wentingjie001-cmd/-/cad/README.md

# CAD：参数化模型与出图脚本

所有 3D 模型、工程图、专利附图都由 Python 脚本从同一个参数化模型生成。改参数后重新运行即可，各类图纸保持一致。

## 环境

```bash
pip install cadquery ezdxf matplotlib shapely scipy trimesh pillow
# 中文字体（Ubuntu）：sudo apt-get install fonts-noto-cjk
# 渲染图使用 VTK 离屏渲染（随 cadquery 安装），需要图形环境或 Xvfb
```

## 运行

```bash
cd cad
python3 build.py          # 3D 导出 + 渲染 + 外观视图 + 发明附图 + 工程图（约 2 分钟）
python3 build.py --fast   # 低分辨率渲染
python3 schematics.py     # 原理示意图（对标原理图、附图 6、附图 7）
python3 build_benchmark.py --photos <官网照片目录>  # 对标款 Aarn PM40 逆向近似模型（不带 --photos 则跳过照片对比图）
python3 build_aarn_detail.py                      # 对标款细节模型（含内部结构、五金件、剖切、爆炸图、BOM）
python3 build_patterns.py                         # A1 生产用裁片：DXF、1:1 PDF、排料图、清单（约 10 秒；校验不过会报错退出）
python3 preview_a1.py                             # A1 3D 预览：按裁片装配的渲染图、标注图、转台动画、GLB（约 40 秒）
python3 build_viewer.py                           # 交互网页的模型数据，写出 ../viewer/model.js（约 6 秒）
cd ../viewer-src && npm install && npm run build  # 打包 three.js，写出 ../viewer/app.js
```

## 文件

| 文件 | 内容 |
|---|---|
| `backpack_model.py` | 参数化几何模型。`Params` 中是主要尺寸：包体、背架、联动座、滚轮、织带、肩带、腰带 |
| `drawing.py` | 消隐线投影（OpenCascade HLR）、专利线条图、局部外观实线/虚线、VTK 渲染、尺寸标注工具 |
| `build.py` | 生成全部输出 |
| `schematics.py` | 2D 原理示意图 |
| `benchmark_aarn_pm40.py` | 对标款 Aarn PM40 的逆向近似模型（照片逐行测量，剪影 IoU 侧面 0.82 / 背面 0.92），仅供对标，见 docs/05 |
| `build_benchmark.py` | 生成对标模型的 STEP/STL、渲染、视图、照片对比图，输出到 `out/benchmark_aarn_pm40/` |
| `aarn_hardware.py` | 五金件库：插扣、梯扣、三档扣、胸带滑钩、弹簧绳扣、拉链、Lasso Loc、织带环、打枣 |
| `aarn_pm40_detail.py` | 对标款细节模型：63 种零件，空壳布料件、分层肩带腰带、内部件，每件标注"实测 / 照片可见 / 推断" |
| `build_aarn_detail.py` | 生成细节模型的总装 STEP、渲染、剖切图、爆炸图、五金图集和 BOM，输出到 `out/benchmark_aarn_pm40/detail/`（约 8 分钟） |
| `patterns.py` | A1 生产用裁片定义：装满后的截面、32 种裁片（净线、每条边的缝份和做法、刀口、纱向、定位点）、织带和五金清单、缝边对位校验。与 3D 模型相互独立，见 docs/08 |
| `build_patterns.py` | 生成裁片 DXF、1:1 PDF、排料图、裁片清单、缝边校验表、尺寸表、用料和重量估算，输出到 `out/production/` |
| `preview_a1.py` | A1 3D 预览：读 `patterns.py` 的截面、口袋位置、肩带和腰带外形、锚点，装配成网格模型并渲染；同时输出 3D 路径长度与裁片、织带下料长度的对照表。`build(sway, torso)` 可以按带长不变摆出联动和背长的姿态 |
| `build_viewer.py` | 把预览模型按静止、左右走带极限、背长最高和最低五种姿态导出成 `../viewer/model.js`，供交互网页使用 |

## 输出（`cad/out/`）

| 目录 | 内容 | 用途 |
|---|---|---|
| `step/` | 总装 STEP（带颜色）、联动座总成 STEP、各硬件 STEP | 给结构工程师在 SolidWorks / Creo / Fusion 360 中继续设计、开模 |
| `stl/` | 联动座前壳/后壳、滚轮、扳手、枢转板、背架 1:1；整包 1:4 缩比模型 | 3D 打印功能样件与展示模型（手办）。部分 STL 非严格封闭，切片软件可自动修复 |
| `render/` | 着色渲染图 | 内部评审、方案说明 |
| `design/01_backpack_whole/` | 整包六视图 + 立体图（PNG 300 dpi / PDF / SVG） | 外观设计专利 C |
| `design/02_backpack_partial_back_system/` | 局部外观：背负系统实线，其余虚线 | 外观设计专利 D |
| `design/03_linkage_hub/` | 联动座六视图 + 立体图 | 外观设计专利 E |
| `invention/fig1–fig5` | 带附图标记的说明书附图 | 发明 / 实用新型 A、B |
| `schematics/fig6, fig7` | 联动原理、锁止状态示意 | 发明 / 实用新型 A、B |
| `schematics/benchmark_*` | 对标款背部原理示意 | 调研报告 |
| `benchmark_aarn_pm40/` | 对标款近似模型：STEP、1:4 STL、渲染、七视图、照片与模型对比、与我们改版的对比 | 对标分析，不用于生产和专利申请 |
| `drawings/` | BP40-HUB-001 联动座 A3 工程图（PDF/PNG/SVG/DXF）、BP40-FRM-001 Y 型背架 A3 工程图 | 打样、开模询价 |
| `production/` | A1 裁片：`dxf/pieces/` 每片一个 DXF，`dxf/BP40-A1_marker_*.dxf` 排料图，`pdf/` 1:1 纸格，另有裁片清单、缝边校验、织带和五金清单、尺寸表、用料和重量估算 | 交给版师打首版样包。还没有经过打样验证 |
| `preview_a1/` | A1 预览：`a1_iso_front/rear.png`、`a1_three_views.png`、带标注的 `a1_callouts_*.png`、`a1_turntable.gif`、`BP40-A1_preview.glb`、`consistency.md` | 看整包的样子，检查裁片装配关系。不是布料仿真，也不是生产模型 |
| `../viewer/` | 交互网页：`index.html`、`app.js`、`model.js`。可旋转、点选、开关图层、拆解，并演示联动带走带、背长 5 档和锁止 | 手机或电脑上操作 3D 预览。不依赖网络；源码在 `viewer-src/`，用 esbuild 打包 |

## 建模假设

- 3D 模型里的软质部件（包体、肩带、腰带、网面）是简化曲面，只用于外观表达和缩比模型，不是裁片。裁片在 `patterns.py` 里单独定义。
- 3D 模型是 A0 尺寸（包体 280 × 200 × 640，主仓约 31 L）；裁片是 A1 尺寸（300 × 220 × 640，主仓 36.6 L，新增背板、肩轭和背长调节）。A1 的 3D 预览（`preview_a1.py`）按裁片装配；专利附图、外观视图和背架图纸仍由 A0 模型生成，还没有同步。生产以裁片和 docs/08 为准。
- 硬质部件（联动座、滚轮、凸轮扳手、枢转板、背架）按制造意图建模，尺寸为 A0 概念值，需打样验证后修正。
