wentingjie001-cmd/-/patent/E_design_linkage_hub/brief_description.md

# 外观设计简要说明（初稿）

1. **本外观设计产品的名称：** 背包用联动座。
2. **本外观设计产品的用途：** 安装于背包底部背侧，用于连接背包肩带下端的联动带、背架和腰带。
3. **本外观设计产品的设计要点：** 在于产品的形状，包括主视呈中部低、两端上翘的"微笑"弧形壳体，两端的滚轮槽与斜向出带口，顶部圆柱形插座，后侧窗口、锚柱与扳手，以及贴身侧带圆角的矩形背板与圆形枢转盘。
4. **最能表明设计要点的图片或照片：** 立体图。

视图文件（`cad/out/design/03_linkage_hub/`）：主视图 `front`、后视图 `rear`、左视图 `left`、右视图 `right`、俯视图 `top`、仰视图 `bottom`、立体图 `iso_front`。

> 此件为硬质注塑件，CAD 线条图可以直接作为申请视图。可以先用 P1 打印件拍照核对，再提交。
