wentingjie001-cmd/-/cad/out/production/hardware_list.md

| 编号 | 名称 | 规格 / 参考型号 | 数量 | 位置 |
|---|---|---|---|---|
| H01 | 卷口插扣 20 mm | 侧开插扣，YKK LB20R 或同级（Duraflex、Woojin） | 2 | 卷口两端 |
| H02 | 腰带中扣 25 mm 双调 | 双调侧开插扣，YKK LB25RD 或同级 | 1 | 腰带，前拉式 |
| H03 | 梯扣 20 mm | YKK LK20GV 或同级 | 4 | 肩带下调节 ×2、下区张紧 ×2 |
| H04 | 梯扣 15 mm | 同系列 15 mm | 6 | 上拉带 ×2、侧压缩 ×4 |
| H05 | 凸轮扣 20 mm | YKK LA20CB 或同级 | 2 | 上区张紧带，缝在后幅 z = 255 的锚点上 |
| H06 | 胸带滑轨扣 15 mm（带哨） | 滑轨式胸带扣一套 | 1 | 肩带滑轨 |
| H07 | G 钩 25 mm | 铝或不锈钢 G 钩 | 1 | 背长调节，挂入梯带 |
| H08 | 日字扣 25 mm | YKK LA25S 或同级 | 2 | 腰带收紧带回折 |
| H09 | 5 号尼龙拉链 + 拉头 | YKK 5CN 或同级，净长 150 mm | 2 | 腰带袋 |
| H10 | 绳扣 | 单孔弹簧绳扣 | 1 | V 形压缩绳 |
| H11 | 魔术贴 25 mm | 勾面 + 毛面各 200 mm | 1 | 背板套上口 |
| H12 | 杆端胶帽 | Ø6 硅胶或 TPU 帽 | 2 | Y 型背架上横梁两端，防异响 |
| H13 | 联动座总成 | 见 BP40-HUB-001（前/后壳、滚轮 ×2、凸轮扳手、枢转盘） | 1 | 后幅下部 |
| H14 | Y 型背架 | 见 BP40-FRM-001（7075-T6 Ø6，下立杆 Ø7） | 1 | 背负系统 |
| H15 | 联动座安装螺钉 | M4×12 不锈钢盘头 + 防松螺母 | 4 | 穿过 E01、后幅和 E04 内衬板 |
| H16 | 防雨罩（选配） | 40–50 L 通用防雨罩，外购 | 1 | 放前弹力袋 |
