wentingjie001-cmd/-/docs/06_brand_suspension_survey.md

# 06 主流户外背包品牌背负系统调研

> 这份调研回答两个问题：成熟品牌的 40 L 级徒步背包背负系统是怎么做的；哪些做法我们可以直接采用，哪些受专利或品牌识别保护要避开。
> 结论落实到设计上的部分见 [08 A1 量产资料包](08_production_package_A1.md) 第 2 节。专利方面的新发现已并入 [02 专利检索与规避](02_patent_landscape.md) 第 4 节。

- 调研日期：2026-11-12（桌面调研，资料来自厂商页面、说明书、Google Patents、评测/拆解站点）
- 目的：梳理成熟品牌的背负（suspension / carry）系统做法，判断哪些通用做法可直接采用，哪些可能受专利或品牌识别保护。

## 0. 阅读须知（重要）

1. **"未核实"（not verified）** 表示本次调研没有找到可靠来源或未能打开原始页面，没有用猜测补齐。凡未标注来源链接的数字均不应作为设计输入。
2. **专利状态** 全部取自 Google Patents 页面在 2026-11-12 显示的状态与法律事件（Active / Expired / Lapsed / 年费缴纳记录）。Google 自己声明这不是法律结论；正式结论须由专利代理人/律师在 CNIPA、USPTO、EPO Register 上复核。
3. **本报告不是 FTO（自由实施）检索**。针对我方概念（"左右肩带下端由一根织带经底部刚性枢纽内的滚轮相连 + 可切换锁止 + 腰带绕同一枢纽转动"）只做了有限的关键词/引证链检索；Google Patents 检索接口在调研中多次被限流，中文关键词全文检索不完整。
4. 厂商不同年份/不同地区页面的数据经常不一致（例如面料丹尼数、重量），文中已尽量标明代际。
5. 品牌名、技术名、专利号保留英文。

---

## 1. Mystery Ranch

**代表型号：Coulee 40**（另参考 Bridger 45、Scree 32）

| 项目 | 内容 | 来源 |
|---|---|---|
| 框架 | Coulee 40：两根竖向复合材料（评测称玻纤 fiberglass）支杆 + 上部一根横向复合材料杆，配 HDPE framesheet（上 2 片 + 下 1 片）。支杆不可拆、有弹性，下端插入缝在包体上的腰垫（lumbar pad）。Bridger 45:spring-steel 钢丝框。Scree 32：半长 HDPE framesheet，无支杆。支杆/钢丝的直径、截面尺寸：未核实 | [suburban.com.hk](https://suburban.com.hk/products/mystery-ranch-coulee-40)、[adventuregear.ca](https://www.adventuregear.ca/ProductTab/ProductFullDescriptionTab/6125)、[SectionHiker Coulee 40](https://sectionhiker.com/mystery-ranch-coulee-40-backpack-review/)、[Trailspace](https://www.trailspace.com/gear/mystery-ranch/coulee-40/)、[enwild Bridger 45](https://www.enwild.com/mystery-ranch-mens-bridger-45.html)、[North of Known Scree](https://www.northofknown.com/mystery-ranch-scree-review/) |
| 背板 | 贴背式：泡棉 + spacer mesh，无悬空网；Scree 为薄闭孔泡棉 | [SectionHiker Coulee 40](https://sectionhiker.com/mystery-ranch-coulee-40-backpack-review/)、[North of Known](https://www.northofknown.com/mystery-ranch-scree-review/) |
| 背长调节 | Futura Yoke：肩带轭（yoke）整体用魔术贴（hook-and-loop）贴在背板后方，可上下"伸缩"连续调节，轭内有一块弧形硬塑料片保持形状。Coulee 40（2023）背长：S/M 38–51 cm，L/XL 43–61 cm。Bridger 45:S/M 15–20 in（约 38–51 cm），L/XL 17–24 in（约 43–61 cm） | [MR load carriage 说明](https://www.mysteryranch.com/load-carriage-architecture-of-a-mystery-ranch-pack)、[wildholics（2023 款）](https://wildholics.com/products/mystery-ranch-coulee-40-backpack-2023-new-version)、[SectionHiker Scree 32](https://sectionhiker.com/mystery-ranch-scree-32-backpack-review/)、[enwild](https://www.enwild.com/mystery-ranch-mens-bridger-45.html) |
| 肩带 | S 形肩带，带 daisy chain；load lifter 锚点在支杆顶端以上（2023 款把下锚点降低约 10 cm）。Bridger 用 Endurance Yoke（跑步背心式，双胸带） | [SectionHiker](https://sectionhiker.com/mystery-ranch-coulee-40-backpack-review/)、[Lupo（繁中评测）](https://lupowanderwild.com/portfolio/mystery-ranch-coulee-40-2023/)、[MR Bridger 博文](https://www.mysteryranch.com/blog/post/9-reasons-why-the-bridger-series-should-be-your-next-backpacking-pack) |
| 腰带与传力 | "lumbar wrap" 腰垫缝在包体上，支杆直接落在腰垫里；腰带两翼不缝死在腰垫上、可拆，向前拉收紧（pull-forward）。2023 款腰带分 S/M/L/XL 四码。腰带袋：未核实 | [SectionHiker](https://sectionhiker.com/mystery-ranch-coulee-40-backpack-review/)、[Lupo](https://lupowanderwild.com/portfolio/mystery-ranch-coulee-40-2023/) |
| 面料/辅料 | 旧款 330D Robic；2023 款 100% 再生 210D Robic dobby，底部双层；YKK 拉链（带 DWR）。Bridger:100D Robic 再生 ripstop + 330D Robic，YKK 拉链 + Duraflex 扣具。Scree:YKK、Duraflex、Woojin 五金，越南制造，外 DWR 内 PU | [suburban.com.hk](https://suburban.com.hk/products/mystery-ranch-coulee-40)、[wildholics](https://wildholics.com/products/mystery-ranch-coulee-40-backpack-2023-new-version)、[Outdoor Gear Zine](https://outdoorgearzine.com/review-mystery-ranch-bridger-45-backpack)、[North of Known](https://www.northofknown.com/mystery-ranch-scree-review/) |
| 重量/容积/载重 | Coulee 40:40 L，约 1.7 kg（3.8 lb；评测实测 1628–1764 g）。官方推荐最大载重：未核实；评测意见"不适合 20 kg 以上" | [SectionHiker](https://sectionhiker.com/mystery-ranch-coulee-40-backpack-review/)、[Lupo](https://lupowanderwild.com/portfolio/mystery-ranch-coulee-40-2023/) |

**评测优缺点**

- 优点：背长无级可调且调节范围大；支杆直接落到腰垫，传力路径短（以上见 SectionHiker 评测）；3-ZIP 开口与用料耐用属于该品牌的普遍口碑，本次未逐条摘录出处。
- 缺点：同容积里偏重；拉链不防水；碳/玻纤杆与套管、轭硬片摩擦会吱吱响（[reddit](https://www.reddit.com/r/MysteryRanch/comments/1f1gb0z/fix_squeaky_pack/)）；魔术贴轭有轻微位移的用户反馈（[reddit](https://www.reddit.com/r/MysteryRanch/comments/ct7djg/)）。

**专利**

- 官方专利页列出：US 7,673,777 B2；8,381,956；8,561,866；8,950,644 B2（覆盖 Coulee 25/40、Scree 等）；US 6,626,342 B1；US 8,348,114 B2、8,579,171（Guide Light Frame / Overload）；9,173,473；9,271,559；10,952,523。[mysteryranch.com/patents](https://www.mysteryranch.com/patents)
- [US7673777B2](https://patents.google.com/patent/US7673777B2/en) "Backpack frame system"（优先权 2005-03-18）：Active，调整后到期日 2028-09-11；同族 US/CA/WO，**无 CN**。
- [US8950644B2](https://patents.google.com/patent/US8950644B2/en)（优先权 2005-03-18）：已到期（2025-05-08）。
- [US8579171B2](https://patents.google.com/patent/US8579171B2/en) "Backpack frame and bag system"（Overload 相关，优先权 2005-03-18）：Expired（未缴年费，2025-11-12 生效）；同族无 CN。
- 其余列出的专利号状态、3-ZIP 是否有专利：未核实。

---

## 2. Osprey

**代表型号：Exos 48（轻量）/ Talon 44（贴背）**；另参考 Atmos AG 50、Stratos 36、Kestrel 38

| 项目 | 内容 | 来源 |
|---|---|---|
| 框架 | Exos 48（S22）：4 mm 粉末涂层 LightWire 周边框（perimeter frame）；旧款说明书写 6065 铝合金周边框 + 内部悬空横撑。Atmos AG 50:4 mm 粉末涂层全周边框。Kestrel 38:3.5 mm LightWire 周边框 + Atilon framesheet。Talon 44（现款）：注塑再生 PP framesheet（S17 款为玻纤周边框 + Atilon framesheet）。Manta AG（2016）：3 mm LightWire | [Exos 48](https://www.osprey.com/exos-48-exos48s22-418)、[Exos 旧说明书](https://m.media-amazon.com/images/I/A1b2NFEoOcL.pdf)、[Atmos AG 50](https://www.osprey.com/atmos-ag-50-atmos50s22-369)、[Kestrel 38](https://www.osprey.com/kestrel-38-kestrel38s23-702)、[Talon](https://www.osprey.com/talontm-8)、[Talon S17 说明书](https://www.osprey.com/gb/media/user_manuals/OM_TalonTempest_S17_ENG.pdf)、[SNEWS](https://www.snewsnet.com/press-release/osprey-packs-introduces-award-winning-anti-gravity-technology-into-hydration-and-kids-carriers-for-spring-2016) |
| 背板 | AirSpeed（Exos、Stratos）：周边框张紧的悬空网（trampoline），网后有窄气隙。Anti-Gravity/AG（Atmos）：从背板到腰带连续的无缝悬空网。AirScape（Talon、Kestrel）：带沟槽的模切 EVA 泡棉贴背 + 网布，重心更贴身 | [Osprey suspension 技术页](https://www.osprey.com/pack-design-technology/suspension)、[Outdoorsmagic Exos 48](https://outdoorsmagic.com/article/osprey-exos-48/)、[Stratos](https://www.osprey.com/stratos-3) |
| 背长调节 | Exos 48（S22）：注塑"梯格"（ladder）+ 卡扣式调节，行程 4 in（约 10 cm）；背长 S/M 43–52 cm，L/XL 49–58.9 cm。Atmos AG 50:cam-lock 凸轮锁背长调节 + Fit-on-the-Fly（肩带、腰带长度可调） | [Exos 48](https://www.osprey.com/exos-48-exos48s22-418)、[Exos S22 说明书](https://www.osprey.com/gb/media/user_manuals/OM_Exos_Eja_S22_ENG.pdf)、[Atmos S22 说明书](https://www.osprey.com/gb/media/user_manuals/OM_Atmos_Aura_S22_ENG.pdf) |
| 肩带 | ExoForm：无缝叠层网 + EVA + spacer mesh；15 mm 滑轨式胸带。Talon:BioStretch 肩带 | [Exos 48](https://www.osprey.com/exos-48-exos48s22-418)、[Talon](https://www.osprey.com/talontm-8) |
| 腰带与传力 | Atmos AG：腰带骨架并入周边框，ErgoPull 交叉前拉收紧，Fit-on-the-Fly 用魔术贴延长腰垫。Talon：腰垫到腰带无缝包裹（seamless lumbar-to-hipbelt wrap）。腰带袋：各型号细节本次未逐项核实 | [Atmos AG 50](https://www.osprey.com/atmos-ag-50-atmos50s22-369)、[Talon](https://www.osprey.com/talontm-8) |
| 面料/辅料 | Exos 48：主料与底料为再生 100D 高强尼龙 ripstop，400D 辅料，PFAS-free DWR。Atmos AG 50:210D honeycomb 尼龙主料 + 500D 高强尼龙底。Talon 44:100D 高强尼龙 dobby ripstop + 420D 底。Stratos 36:100D×210D honeycomb ripstop + 420D 底。Kestrel 38:420D 尼龙 + 500D 底。拉链/扣具供应商：未核实 | 同上各产品页 |
| 重量/容积/载重 | Exos 48（S/M）：48 L，1.255 kg（官网）/1.29 kg（说明书），载重 25–30 lb / 11–14 kg。Talon 44（S/M）：1.57 kg，15–35 lb / 6.8–15.9 kg。Stratos 36:1.55 kg，10–30 lb / 4.5–13.6 kg。Atmos AG 50（S/M）：1.959 kg，25–35 lb / 11–16 kg（说明书 kg 换算有笔误，以官网为准）。Kestrel 38:S/M（36 L）4.07 lb（约 1.85 kg），20–35 lb | 同上各产品页 |

**评测优缺点**

- 优点：Exos 48 以约 1.26 kg 做到 11–14 kg 载重区间且背长可调 10 cm（官网数据）；AG/AirSpeed 的通风与包裹感属于普遍口碑，本次未逐条摘录出处。
- 缺点：AG 框架与包体摩擦吱吱响（Osprey 给框架喷涂层处理，[reddit](https://www.reddit.com/r/WildernessBackpacking/comments/60wy6b/)）；Fit-on-the-Fly 魔术贴腰带打滑/失效的用户报告（[Trailspace](https://trailspace.com/gear/osprey/atmos-ag-65/)）；悬空网约 500 km 后撕裂的个案（[Let's Go Play Outside](https://letsgoplayoutside.com/en/blog/equipement/tests/complete-osprey-atmos-ag-65-review)）；旧代腰带内卷产生压点（[Switchback Travel](https://www.switchbacktravel.com/backpacking/osprey-atmos-review)）。另见 [CleverHiker 的 Atmos AG 65 评测](https://www.cleverhiker.com/backpacking/osprey-atmos-ag-65-backpack-review/)（具体条目本次未摘录）。

**专利**

- [US12336619B2](https://patents.google.com/patent/US12336619B2/en)（3D 打印点阵腰垫，优先权 2020-01-31）：Active；**有 CN 同族 CN114980777B**。
- [US11751670B2](https://patents.google.com/patent/US11751670B2/en)（儿童背架/可变框架，优先权 2020-06-19）：Google Patents 显示 CN 同族为 active。
- AG / AirSpeed / LightWire 是否有专门专利及其号码：未核实。

---

## 3. Deuter

**代表型号：Futura Pro 40（悬空网）/ Aircontact Ultra 40+5（贴背轻量）**；另参考 Aircontact Lite 40+10、Trail Pro 36

| 项目 | 内容 | 来源 |
|---|---|---|
| 框架 | Futura Pro 40:Flexi 弹簧钢（spring steel）圆截面框，肩带锚在框上。Aircontact Ultra 40+5:"永久弹性"弹簧钢圆截面框（媒体称锯齿形钢丝）。Aircontact Lite:X 形铝支杆 + 顶部横杆（挂 load lifter）。Aircontact X:Y-frame。Alpine 背负（Guide）：PE 背板内缝弹簧钢框。Trail Pro 36：张紧的 Delrin U 形框（部分零售页写"弹簧钢圆截面框"，两种说法并存，未能定论）。钢丝直径：未核实 | [Futura Pro 40](https://www.deuter.com/int-en/futura-pro-40/4046051185484)、[Aircontact Ultra 40+5](https://www.deuter.com/int-en/aircontact-ultra-40-5/4046051172033)、[Outside first look](https://www.outsideonline.com/outdoor-gear/hiking-gear/first-look-deuter-aircontact-ultra-405-355-sl/)、[SectionHiker Aircontact Lite](https://sectionhiker.com/deuter-aircontact-lite-65-10-backpack-review/)、[Deuter alpine 页面](https://www.deuter.com/int-en/backpacks/alpine-backpacks/)、[shoreshots Trail Pro 36](https://shoreshots.ie/p/deuter-trail-pro-36-paprika-marine/)、[Globetrotter](https://www.globetrotter.de/deuter-tourenrucksack-trail-pro-36-black-shale-1280680/) |
| 背板 | Aircomfort（Futura）：弹簧钢框张紧的悬空网，二手资料称该系统始于 1984 年。Aircontact：开孔泡棉贴背垫 + 中央通风槽 / Air Spacer Mesh，重心贴身 | [Deuter back systems](https://www.deuter.com/us-en/advice/back-systems/)、[1xmatch](https://en.1xmatch.com/ryukzaki-deuter-obzor-modeley-blog-skalnik-blog-skal-nik/)、[packranker](https://packranker.com/backpacks/deuter-aircontact-lite-40-10) |
| 背长调节 | VariQuick：魔术贴穿过梯形织带环；VariSlide：织带 + 扣具无级滑动；VariClick（现款 Futura Pro）：5 档；Clip & Loop（Aircontact Ultra）。范围：Futura Pro 40 与 Aircontact Ultra 40+5 均为 42–62 cm；Aircontact Lite 40+10 为 42–62 cm；上一代 Futura Pro 40 与 Trail Pro 36 为固定背长 44–54 cm | [Deuter trekking advice](https://pimcore.deuter.com/deuter-master/en/advice/trekking-backpack-advice)、[Futura Pro 40](https://www.deuter.com/int-en/futura-pro-40/4046051185484)、[上一代 Futura Pro 40](https://www.deuter.com/ca-en/futura-pro-40/4046051112367) |
| 肩带 | ActiveFit：肩带上端可自由转动以适应肩宽/肩斜；Aircontact X 为 pivoting 肩带 | [Futura Pro 40](https://www.deuter.com/int-en/futura-pro-40/4046051185484)、[Deuter backpacking packs](https://www.deuter.com/us-en/backpacks/backpacking-packs/) |
| 腰带与传力 | VariFlex / VariFlex ECL：腰翼（hip fins）可随骨盆活动；pull-forward 前拉收紧；Aircontact Lite 腰翼为双密度泡棉。腰带袋：未逐项核实 | [上一代 Futura Pro 40](https://www.deuter.com/ca-en/futura-pro-40/4046051112367)、[SectionHiker](https://sectionhiker.com/deuter-aircontact-lite-65-10-backpack-review/) |
| 面料/辅料 | Futura Pro 40（现款）：210D 再生 PA X-Grid，附防雨罩，越南制造（零售商信息）；上一代：210D 再生 PA + 600D PES（厚 PU 涂层）。Aircontact Ultra:175D PA Ripstop Ultra HD（国际站）/ 235D 再生 PA + 500D PA（美国零售商）——两处说法不一致。Aircontact Lite:140D PA ripstop + 600D 再生 PES。Trail Pro:210D PA（双 PU 涂层，1500 mm 水柱）+ 600D PES。拉链/扣具供应商：未核实 | 同上；[eikenshop](https://eikenshop.com/products/deuter-futura-pro-40)、[sportsbasement](https://shop.sportsbasement.com/products/aircontact-ultra-40-5) |
| 重量/容积/载重 | Futura Pro 40:40 L，1620 g，70×32×24 cm，推荐载重 6–10 kg。Aircontact Ultra 40+5:1210 g，71×26×23 cm，推荐 6–10 kg（13–22 lb，美国零售商）；媒体称可到 35 lb（约 16 kg）。Aircontact Lite 40+10:1590 g，12–15 kg | [Futura Pro 40](https://www.deuter.com/int-en/futura-pro-40/4046051185484)、[sportsbasement](https://shop.sportsbasement.com/products/aircontact-ultra-40-5)、[packranker](https://packranker.com/backpacks/deuter-aircontact-lite-40-10) |

**评测优缺点**

- 优点：背长调节范围大（42–62 cm，共 20 cm）；Aircontact X 标称可到 30 kg（[Deuter](https://www.deuter.com/us-en/backpacks/backpacking-packs/)）。Aircomfort 通风好、Aircontact 贴背稳定属于普遍口碑，本次未逐条摘录出处。
- 缺点：同级偏重；VariQuick 没有刻度标记、背垫两侧有压感（[mountainsforeverybody](https://mountainsforeverybody.com/deuter-aircontact-lite-35-10-sl-pack-for-women/)）；Aircontact Lite 软泡棉在约 45 lb（20 kg）以上被压实（[OutdoorGearLab](https://www.outdoorgearlab.com/reviews/camping-and-hiking/backpacks-backpacking/deuter-aircontact-lite-65-plus10)）。

**专利**：Deuter 背负系统（Aircomfort、VariQuick、VariFlex、ActiveFit 等）的专利号与状态——未核实（按申请人检索时被 Google Patents 限流，未取得结果）。

---

## 4. Gregory

**代表型号：Zulu 40**（另参考 Paragon 48、Focal 48、Baltoro 65）

| 项目 | 内容 | 来源 |
|---|---|---|
| 框架 | Zulu 40：周边框，官网材质写 "alloy steel"；2019 代为周边弹簧钢框 + 防鼓包（anti-barreling）横撑。Paragon 48:wishbone 合金框 + 玻纤防鼓包横撑 + HDPE/闭孔泡棉 framesheet。Focal 48：周边铝框 + 玻纤横撑 + HDPE。Baltoro 65：周边合金（钢管）框 + 玻纤横撑。管/丝直径：未核实 | [Zulu 40（EU 官网）](https://eu.gregorypacks.com/uk-en/zulu-40-s-m--halo-blue/145668-0527.html)、[gaynors（2019 代）](https://www.gaynors.co.uk/equipment-c153/rucksacks-c155/mens-rucksacks-c235/gregory-zulu-40-p21654)、[hardloop Paragon 48](https://www.hardloop.co.uk/product/23800-gregory-paragon-48-hiking-backpack-mens)、[mountainsforeverybody Focal 48](https://mountainsforeverybody.com/gregory-focal-48-pack-for-men)、[Baltoro 65](https://eu.gregorypacks.com/uk-en/-baltoro-65-rc-m--terrain-green/157940-9304.html)、[LFTO](https://www.livefortheoutdoors.com/hiking/rucksacks/gregory-baltoro-65-review/) |
| 背板 | Zulu / Focal:FreeFloat 全长张紧悬空网。Paragon:FreeFloat hybrid，3D 打孔泡棉贴背。Baltoro:AirCushion 网 + ComfortGrip 腰垫 | 同上 |
| 背长调节 | Zulu 40：可调 3.5 in（约 8.9 cm）。Baltoro 65：背长可调 >7.6 cm，腰带每侧可调 8.8 cm。Focal 48：固定背长，分 S/M/L（16–18 / 18–20 / 20–22 in） | 同上 |
| 肩带 | Lifespan EVA 打孔肩带；Baltoro 的 FreeFloat A3 为 auto-rotating 自动转角肩带 | [Zulu 40](https://eu.gregorypacks.com/uk-en/zulu-40-s-m--halo-blue/145668-0527.html)、[Gregory JP FreeFloat A3](https://www.gregory.jp/tech/free-float-a3.html) |
| 腰带与传力 | FreeFloat：腰带通过一块可弯曲/位移的柔性面板（dynamic flex panel）连到框架，腰带可随骨盆 pivot 与 flex；3D 预成型腰带。腰带袋：未逐项核实 | [FreeFloat 技术页](https://eu.gregorypacks.com/uk-en/technologies/freefloat/)、[Gear Institute Paragon 48](https://gearinstitute.com/first-look-hitting-the-sweet-spot-with-the-gregory-paragon-48/) |
| 面料/辅料 | Zulu 40（2023–）：40% 再生 400D 涤纶 ripstop 主料，420D 尼龙底，135D 涤纶里布；2019 代：210D Honeycomb Cryptorip HD 尼龙 + 630D/420D 底。Paragon 48:100D + 210D HD 尼龙，底 210D（零售商）/ 420D（Gear Institute），说法不一。Focal 48:100D HD（40% 再生）+ 210D HD 尼龙。拉链/扣具供应商：未核实 | 同上 |
| 重量/容积/载重 | Zulu 40:40 L，S/M 1.52 kg、M/L 1.57 kg，最大载重 18 kg，带防雨罩与 U 形拉链开口。Paragon 48:1.6 kg，最大 18.1 kg。Focal 48（M）：1.18 kg，最大 14 kg / 30 lb。Baltoro 65：最大 27.2 kg | 同上 |

**评测优缺点**

- 优点：FreeFloat 腰带可随骨盆活动（厂商说法）；Baltoro 65 评测称重载舒适且不吱响（[LFTO](https://www.livefortheoutdoors.com/hiking/rucksacks/gregory-baltoro-65-review/)）；Zulu 40 标配防雨罩与 U 形开口。
- 缺点：Paragon 柔性框在 20–30 lb 甜区以上传力打折、腰部偏热（[Gear Institute](https://gearinstitute.com/first-look-hitting-the-sweet-spot-with-the-gregory-paragon-48/)）；Focal 框架有"吱/啾"异响（[reddit](https://www.reddit.com/r/Ultralight/comments/zaa8rw/gregory_focal/)）、胸带打滑（[UKC](https://www.ukclimbing.com/gear/rucksacks/large/gregory_focal_48-15794)）、框架像外架且位置偏高（[ULOG](https://ultralightoutdoorgear.co.uk/blog/gregory-focal-48-rucksack/)）。

**专利**

- [US10806238B2](https://patents.google.com/patent/US10806238B2/en) "Backpack with dynamic flexible hip belt"（Samsonite IP Holdings，优先权 2018-05-15）：Active（预计 2038-06-01 到期）；同族 EP3569100B1；Google Patents 国家列表只有 US、EP，**未见 CN**。
- [US8360289B2](https://patents.google.com/patent/US8360289B2/en)（腰带长度可调，优先权 2010-07-21）：2025-01-29 因未缴年费失效。
- [US20080035686A1](https://patents.google.com/patent/US20080035686A1/en) "Backpack pivot system"（Bianchi International，优先权 2006-04-14；腰带经单一枢轴连到框架支架）：Abandoned，仅 US。
- Response A3 / auto-rotating 肩带的专利号：未核实。

---

## 5. Kailas 凯乐石

**代表型号：Ridge（山脊）III 38+5**；另参考 Wind Tunnel（风洞）48+5、Windrider（风行）45、Foothill（山麓）45。Mystery（秘境）、Fuga 系列的背负细节：未核实（Fuga 主要是越野跑背心包线，非本次重点）。

| 项目 | 内容 | 来源 |
|---|---|---|
| 具名背负系统 | LIFT 分布式减负系统（铝合金支杆 + 宽腰带 + 弧形背板 + 3 档背长）；LIFT-CF（碳板，用于巅峰 Summit PRO III 50+5，约 2.48 kg）；SPACE 空气网/网架透气背负（风洞）；EASE 立体缓冲（远山/空境）。以上命名来自社区汇总（二手来源），官方技术白皮书：未核实 | [什么值得买 avvlrp99](https://post.smzdm.com/p/avvlrp99/)、[a3mx6l35](https://post.smzdm.com/p/a3mx6l35/)、[awwo9d74](https://post.smzdm.com/p/awwo9d74/)、[知乎](https://zhuanlan.zhihu.com/p/566633626) |
| 框架 | Ridge III：超轻铝合金内框杆；Wind Tunnel 48+5:7075 铝合金框；Windrider 45：铝框。早期 Core 65 拆解：两根铝支杆 + 一根铝管（"悍马背负"，被认为近似 Osprey Argon）。尺寸：未核实 | [utopio（Ridge III 38+5）](https://utopio.de/ean/6941459032096.htm)、[kailasgear.com Wind Tunnel](https://kailasgear.com/products/kailas-wind-tunnel-lightweight-trekking-backpack-48-5l)、[gearkr 拆解](http://gearkr.com/?p=796) |
| 背板 | Ridge/Windrider：贴背（LIFT）；Wind Tunnel:SPACE 悬空网 | 同上 |
| 背长调节 | LIFT 三档；Ridge III 38+5 为 41–57 cm；Ridge III 48+5 分码：S 背长 41–47 cm（腰围 69–79 cm），M 46–52 cm（腰围 76–92 cm）。早期 Core 65 为魔术贴调节 | [utopio](https://utopio.de/ean/6941459032096.htm)、[targetcamp](https://targetcamp.ir/product/kailas-ridge-lightweight-trekking-ka300221a/)、[pro-market.kz](https://pro-market.kz/-kailas-ridge-iii-lightweight-trekking-backpack-485l/) |
| 肩带 / 腰带 | 宽腰带；Ridge III 腰带袋在右侧。肩带泡棉、腰带与框架的连接方式：未核实 | [utopio](https://utopio.de/ean/6941459032096.htm) |
| 面料/辅料 | Ridge III 48+5：尼龙 200D + 420D。Wind Tunnel:330D Cordura（社区称分区 100D Cordura 前袋 / 330D 顶包 / 420D 底），防泼水长拉链，带防雨罩。Foothill:Cordura ripstop 尼龙。早期 Core 65:UTX / YKK 辅料、Kevlar 底。现款拉链/扣具供应商：未核实 | [pro-market.kz](https://pro-market.kz/-kailas-ridge-iii-lightweight-trekking-backpack-485l/)、[kailasgear.com](https://kailasgear.com/products/kailas-wind-tunnel-lightweight-trekking-backpack-48-5l)、[ascentstore Foothill](https://ascentstore.com.my/shop/kailas-foothill-trekking-backpack-45l-with-rain-cover/)、[gearkr](http://gearkr.com/?p=796) |
| 重量/容积/载重 | Ridge III 38+5:1.5 kg，67×26×24 cm；载重：未核实（48+5 款 2.0 kg、标称可到 20 kg）。Wind Tunnel 48+5:1.52 kg，68×28×18 cm，12–16 kg。Windrider 45:1.5 kg，最大 15 kg。Foothill 45：约 1.8 kg，12–16 kg | 同上；[cheapman Windrider](https://cheapman.ru/goods/ryukzak-kailas-windrider-lightweight-trekking-backpack-silent-black-102087374745.html)、[新闻稿](http://www.chaoliunews.com/shishang/xiangbao/22631.html) |

**评测优缺点（社区）**：SPACE 通风受好评；缺点是约 25 斤时肩带偏硬磨肩、有线头、承重上限 12–16 kg 偏低（[什么值得买](https://post.smzdm.com/p/a3mx6l35/)）。

**专利（Google Patents，申请人 广州凯乐石）**

- [CN222639968U](https://patents.google.com/patent/CN222639968U/en) "一种具有背包支架的背负系统及登山背包"（优先权 2024-05-29,2025-03-21 授权）：Active，预计 2034-05-29 到期。保护一种带贴背凹槽、上端弧形槽、下端向前弯曲的背包支架（板）。**在中国有效，做碳板/成型背板时需比对。**
- [CN211987001U](https://patents.google.com/patent/CN211987001U/en) "平衡收紧系统和背心式背包"（2020-03-18；旋钮 + 拉绳）：Active（越野跑背心包）。
- WO2023024715A1（背心包胸前调节）、CN122229264A（优先权 2026-03-26）：内容未细读，未核实。
- LIFT / SPACE 是否各有专利：未核实。

---

## 6. 动态 / 随动背负系统（与我方概念最接近的部分）

**我方概念（用于对照）**：左右肩带下端由同一根织带相连，织带绕过包底刚性枢纽（hub）内的滚轮；一侧肩膀抬起时另一侧放带；带可切换的锁止；腰带绕同一枢纽转动。

### 6.1 各品牌产品做法

| 品牌 / 技术 | 机构原理 | 代表产品与数据 | 评测结论 | 来源 |
|---|---|---|---|---|
| **Black Diamond SwingArm** | 左右肩带下端用一根低摩擦钢缆（cable）在包底相连，缆在套管内滑动，一肩上抬另一肩放出 | Infinity 60:3.75 lb（约 1.7 kg） | BPL 对实际收益持中性态度，指出负载会离开后背；SierraDescents 认为有左右晃动/振荡的顾虑；Blister 称负载有被"左右甩"的感觉 | [Splitter Choss](https://www.splitterchoss.com/2010/07/30/black-diamond-launches-new-climbing-packs/)、[Backpacking Light](https://backpackinglight.com/black_diamond_infinity_innova_50_backpack/)、[SierraDescents](https://www.sierradescents.com/reviews/black-diamond/mission.html) |
| **Black Diamond ergoACTIV / reACTIV** | ergoACTIV：腰带经球铰（ball joint）连接包体，三向受限转动；reACTIV：腰带织带穿过包体可左右滑动（pass-through） | 同上系列 | 同上 | [Splitter Choss](https://www.splitterchoss.com/2010/07/30/black-diamond-launches-new-climbing-packs/) |
| **Arc'teryx RotoGlide**（Bora AR） | 腰带装在背板上的竖向滑轨上，可上下滑动并转动 | Bora AR 50:2180 g；Tegris 背板；N420r-AC2 / N420p-HT 面料 | 评测细节未摘录 | [PlanetMountain](https://www.planetmountain.com/en/products/bora-ar-pack-trekking-backpack.html)、[Arc'teryx 专利页](https://arcteryx.com/us/en/patents) |
| **Aarn U-Flow** | 四组"联动"：（1） 肩带下端由低摩擦织带/绳相连并穿过包底的槽滑动（linked bottom tensioners）；（2） 顶部稳定带穿环联动；（3） 腰带两侧由绳穿过 U 形低摩擦管相连；（4） 腰带经弹性连接件向前转动。官网称 "patented U-Flow" | Aarn 各型号（配前置 balance pockets） | 未摘录独立评测 | [Aarn movement 页面](https://www.aarnpacks.com/pages/movement-table) |
| **Bergans SPINE / Spine2 + QuickAdjust PRO** | 双螺旋形弹簧钢框，仅在中心与包体连接，肩、髋可反向扭转；QuickAdjust 为背长快调 | Glittertind 55 L:2.1 kg，尼龙 420D/210D（2012 年 OutDoor Industry Award）。Trollhetta V5 95:2530 g，背长 43–60 cm，载重 30 kg | 未摘录独立评测 | [SNEWS](https://www.snewsnet.com/press-release/bergans-glittertind-backpack-wins-outdoor-industry-award)、[Carryology](https://www.carryology.com/liking/industry/biomechanics-and-backpacks-the-problem/)、[iloveoutdoor](https://iloveoutdoor.com/bergans-glittertind-komfort-och-funktionalitet/)、[Bergans Trollhetta](https://www.bergans.com/en/p/4702-trollhetta-v5-95/3834) |
| **Thule Guidepost TransHub** | 单根宽铝支杆 + 塑料 framesheet，通过转动关节和穿入腰带的弹簧钢丝与腰带相连，腰带可随髋部转动 | Guidepost 65 L：约 6 lb（约 2.7 kg）；背长可调 17–23 in（约 43–58 cm，行程 15 cm） | "overbuilt"（偏重）、通风差 | [Backpacker](https://www.backpacker.com/gear-item/thule-guidepost-65l/)、[GearJunkie](https://gearjunkie.com/packs/thule-backpacks)、[Thule 新闻稿](https://www.thulegroup.com/en/press/thule-improves-suspension-system-and-reduces-weight-thule-guidepost-collection-outdoor) |
| **Mammut Active Spine** | 肩带轭与腰带各有一个转动点，两者用一根张紧的玻纤杆耦合，使肩、髋反向转动 | Trion Spine 50：背长 46–51 cm。Ducan Spine 50–60（2025,Active Spine 3.0）：1680 g，背长 43.5/46/48.5 cm | 评测细节未摘录 | [Blister](https://blisterreview.com/gear-reviews/mammut-trion-spine-50-backpack)、[Peak Mountaineering](https://www.peakmountaineering.com/mammut-trion-spine-rucksack-review/)、[SNEWS](https://www.snewsnet.com/press-release/mammut-debuts-new-proprietary-technology-at-outdoor-retailer)、[Mammut 新闻稿](https://pr.mammut.com/mammut-hiking-collection-summer-2025-ready-for-new-adventures) |
| **Gregory FreeFloat** | 腰带经柔性面板连到框架（见第 4 节） | Zulu 40 | 见第 4 节 | [FreeFloat](https://eu.gregorypacks.com/uk-en/technologies/freefloat/) |
| **Lowe Alpine VT Flex**（Cerro Torre） | 双转动腰翼（pivoting hip fins）+ 稳定/传力杆；另有 AirZone 张紧网、Air Contour | Cerro Torre：标称可到 25 kg | 未摘录 | [Outdoors Magic](https://outdoorsmagic.com/article/lowe-alpines-cerro-torre-trekking-pack-in-depth/)、[bagalio](https://bagalio.eu/guides/lowe-alpine-back-systems) |
| **Exped Lightning / Thunder（T-Rex）** | 单根中央铝支杆 + 顶部横杆（约 22 cm × Ø1 cm），支杆下端锚在腰带上充当转动点；腰垫下方织带无级调背长 | 标称 24 kg；210D Dyneema ripstop 尼龙（PU 涂层）；Flash Pack Pocket 配件 75 g | 用户反映包体左右摆动 | [bbg-mountain](https://bbg-mountain.com/2018/07/28/exped-lightning45/)、[yamahack](https://yamahack.com/5934)、[smalandoutdoor](https://smalandoutdoor.wordpress.com/2018/01/18/exped-lightning-60-review/)、[reddit](https://www.reddit.com/r/CampingGear/comments/1otpm2a/) |
| **Zpacks Arc** | 碳杆被张紧带拉成弓形（建议弓高约 2.5 in / 6 cm），背面张网通风；肩带高度可调 | Arc Haul Ultra 50 L | 碳杆偶有折断 | [Zpacks](https://zpacks.com/products/arc-haul-ultra-50l-backpack)、[packstack](https://www.packstack.io/reviews/pack/zpacks-arc-haul-backpack) |
| **Seek Outside Revolution** | "Patented Articulating Frame"：框架左右两半经转动关节相对扭转；框高 24–28 in 可调，7075 横撑，标称 200+ lb | Revolution / Divide | 未摘录 | [Seek Outside](https://seekoutside.com/revolution-suspension-and-frame/)、[Seek Outside blog](https://seekoutside.com/blog/59/) |
| **Fjällräven Kajka** | 非动态背负：层压桦木框；Perfect Fit Adjustment System（拉带调背长，肩带宽度 3 档）；腰带两点固定、角度可调。品牌史上有 1975 年 Gyro Frame | Kajka 75 等 | 未摘录 | [Fjällräven 新闻稿](https://www.mynewsdesk.com/fjallraven/pressreleases/kajka-fjaellraeven-apply-unique-wooden-frame-to-decrease-carbon-footprint-of-award-winning-backpack-969115)、[Fjällräven AU](https://fjallraven.com.au/blogs/news/10-innovative-things-you-probably-don-t-know-about-kajka) |
| **Osprey** | 本次未找到 Osprey 有"肩带左右联动"类产品；其随动仅体现在 AG 悬空网与 BioStretch 腰带 | — | — | [Osprey suspension](https://www.osprey.com/pack-design-technology/suspension) |
| 其他（二手综述） | Kelty 平行转动腰带、Gregory Denali 独立髋部转轴、Deuter 单转轴 | — | — | [mountainsforeverybody](https://mountainsforeverybody.com/what-is-meant-by-backpack-harness-adjustability/) |

### 6.2 专利清单与状态（Google Patents，2026-11-12 所见）

**A. "左右肩带下端联动"类——与我方核心机构最接近**

| 专利号 | 权利人 / 名称 | 优先权 | 内容要点 | 状态 | CN 同族 |
|---|---|---|---|---|---|
| [US6070776A](https://patents.google.com/patent/US6070776A/en) | Furnary "Backpack load centering system" | 1997-08-08 | 一根连续带子在包底面板下方的低摩擦通道内滑动，连接两肩带 | 2008 年因未缴费失效 | 无（仅 US） |
| [FR2819700A1](https://patents.google.com/patent/FR2819700A1/en) | Salomon | 2001-01-24 | 两肩带下端由一个在包底装置内滑动的插件相连 | 已失效（未缴费） | 无（仅 FR） |
| [CN2659216Y](https://patents.google.com/patent/CN2659216Y/en) | 叶啟明 "一种可平衡重心的背包" | 2003-11-14 | 包底设通道，连接带穿过通道两端接左右肩带；说明书提到可用滑轮、齿轮、通槽实现 | 实用新型，已终止（未缴年费，终止日 2011-11-14） | 本身即 CN，已失效 |
| [US20060131355A1](https://patents.google.com/patent/US20060131355A1/en) / [DE102005055688A1](https://patents.google.com/patent/DE102005055688A1/en) / NZ536593 / AU2005234623B2 | Aarn Tate（Aarn）"Free shoulder movement harness" | 2004-11-17 | 柔性件穿过包底通道连接两肩带 | US 放弃，DE 撤回；AU、NZ 状态未核实 | 未发现 |
| [CN2800884Y](https://patents.google.com/patent/CN2800884Y/en) / [US7946460B2](https://patents.google.com/patent/US7946460B2/en) / EP1902646A1 / JP4783828B2 | 叶啓明（Kaiming Yip）"互动式平衡装置" | 2005-06-30 | 下组件：挡板夹层内装**至少一个滚轮 + 左右固定轮**，滑动带绕轮滑移并接两肩带；**滚轮之间设开关控制键，可锁紧或放开滑动带**；上组件：肩带绕旋转轮滑移 | CN 2012-06-30 因未缴年费终止；US 2015 年失效；EP 撤回；JP 状态未核实 | 本身即 CN，已失效 |
| [US9254030B2](https://patents.google.com/patent/US9254030B2/en) / EP2233036B1 / DE202010004195U1 | Black Diamond "Carrying device dual shoulder strap system"（SwingArm） | 2009-03-24 | 权利要求 1：两肩带下端经耦合件相连，耦合件滑动穿过包内的套管（sleeve），套管通道截面与耦合件相匹配；并含 frame sheet / frame pocket / frame support | **US 有效，调整后到期 2033-01-23**（第 4、8 年年费已缴）；EP 已不在有效状态（DE、FR 于 2025 年失效） | **无** |
| [US8172117B2](https://patents.google.com/patent/US8172117B2/en) | C&P Hiam Associates "Stable backpack"（2023 年转让给个人） | 2009-11-02 | 髋部悬挂：竖向支撑杆两端铰接腰带与框架；肩部悬挂：**滑轮 + 绳索**把肩带接到包上。权利要求 1 以横向弹簧髋杆、横向肩部转动杆和两根竖杆的连杆机构为主 | **US 有效**（2023 年缴第 12 年年费，预计 2030-11-02 到期）；WO/CA/EP 状态未核实 | 无 |
| [US10098440B2](https://patents.google.com/patent/US10098440B2/en) / CN108471864B / EP3397108A1 | The North Face "Load-bearing systems" | 2015-12-31 | 浮动块 + 蛇形（serpentine）张紧绳，用于肩带/腰垫均衡 | US 2022-10-16 失效；**CN108471864B 显示因未缴年费终止**（建议在 CNIPA 复核）；EP 撤回 | 有，已终止 |
| [US12089711B2](https://patents.google.com/patent/US12089711B2/en) | Frenchie Group SAS "Self adjusting strap system" | 2018-04-17 | 一根连续织带穿过两块聚合物板之间的通道连接两肩垫（"起滑轮作用"） | **US 有效**（预计 2039-03-05 到期）；同族 CO、SG、MX、EP、ES、CA、HR、WO，各国状态未核实 | Google Patents 未列出 CN |

**B. 腰带转动 / 框架随动类**

| 专利号 | 权利人 / 名称 | 优先权 | 状态 | CN 同族 |
|---|---|---|---|---|
| [US8714424B2](https://patents.google.com/patent/US8714424B2/en) / EP2233035A1 / DE202010004196U1 | Black Diamond "Carrying device waist belt system"（ergoACTIV 球铰，背侧铰接件三向受限自由度） | 2009-03-24 | US 有效，调整后到期 2032-08-09（第 12 年年费 2025-05-30 已缴） | 无 |
| [US10004320B2](https://patents.google.com/patent/US10004320B2/en) | Amer Sports Canada（Arc'teryx）"Hipbelt suspension system"（RotoGlide） | 2016-05-10 | US 有效，调整后到期 2036-08-08（第 8 年年费 2025-11-20 已缴） | 无（仅 US） |
| [US10806238B2](https://patents.google.com/patent/US10806238B2/en) / EP3569100B1 | Samsonite IP Holdings（Gregory FreeFloat） | 2018-05-15 | US 有效（预计 2038-06-01） | 未见 |
| [DE102017219211B4](https://patents.google.com/patent/DE102017219211B4/en) | Mammut Sports Group "Tragkonstruktion"（Active Spine：肩带与腰带各装在一个转动件上，两转动件反向耦合） | 2017-10-26 | DE 有效（2023-03-30 授权，预计 2037-10-27 到期）；有 US 申请 16/165,104，其公开号与状态未核实 | 无 |
| NO332793B1 / WO2012121604A1 / US20140061263A1 / JP2014511245A / DE112012001093T5 | Bergans（SPINE） | 2011-03-04 | US 2016 年放弃；JP、DE 在 Google Patents 上仍显示审查中（未核实）；NO 状态未核实 | 无 |
| [US10617195B2](https://patents.google.com/patent/US10617195B2/en) | Coleman / Timm（Seek Outside）"Articulating backpack frame" | 2013-07-19（临时申请） | US，2020-04-14 授权，预计 2034-07-07 到期，第 4 年年费 2023 年补缴 | 无（仅 US） |
| [US9060590B2](https://patents.google.com/patent/US9060590B2/en) / [US9848687B2](https://patents.google.com/patent/US9848687B2/en) | Valesko（Zpacks）弓形张紧框 / 肩带高度调节 | 2013-06-14 / 2015-12-31 | 均为 US 有效（调整后到期 2033-12-27 / 2036-03-20） | 无（仅 US） |
| [US9326586B2](https://patents.google.com/patent/US9326586B2/en) | Thule "Locking mechanism of a backpack"（肩带横向位置锁：转动卡件沿导杆滑动/卡入） | 2013（EP 优先权） | US 有效（预计 2034-12-19）；Thule 专利页将其列为 Guidepost 相关且 "In Force"（[thule.com/patents](https://www.thule.com/en-us/patents)） | **同族含 CN**，其号码与状态未核实 |
| [US9591910B2](https://patents.google.com/patent/US9591910B2/en) / CN205180690U | Thule 背长调节 | 2014-07-09 | US 2025-03-14 失效；CN 实用新型已不在有效状态 | 有，已失效 |
| [US10058163B2](https://patents.google.com/patent/US10058163B2/en) | Thule "Adjustable backpack"（拉绳张紧的间隔背板） | 2015-10-09 | US 有效 | 无（仅 US） |
| [US20080035686A1](https://patents.google.com/patent/US20080035686A1/en) | Bianchi International（Gregory）腰带单枢轴 | 2006-04-14 | 放弃 | 无 |
| Aarn:NZ506106A（2000）、NZ523148A（2002，髋部全活动框架）、US20090020580A1（2007）、NZ703775A（2014） | Aarn | — | US20090020580A1 不在有效状态；NZ703775A 显示 NZ 有效；其余未核实 | 未发现 |

- Thule TransHub 转动关节本身的专利号：未核实。Thule US20150173493A1（腰翼）的授权情况未核实，其 CN 同族在 Google Patents 上显示不在有效状态。
- Lowe Alpine（VT Flex / AirZone）专利：未核实。Fjällräven 背负专利：未核实。Osprey AG 专利：未核实。Deuter 专利：未核实。

**C. 在中国仍有效、与"随动/联动背带"沾边的专利（机构与我方不同，但要让代理人看一眼）**

| 专利号 | 权利人 | 内容 | CN 状态 |
|---|---|---|---|
| [CN106923401B](https://patents.google.com/patent/CN106923401B/en)（同族 EP2523570B1） | Coxa Carry | 四根背带在胸口（太阳神经丛位置）的连接体汇合 | 2019-05-28 授权，Active，预计 2031-01-11 到期 |
| [CN104640477B](https://patents.google.com/patent/CN104640477B/en)（同族 US9877570B2,US 已于 2026-01-30 失效） | Coxa Carry | 连接装置的部件可沿背带移动并带限位 | 2018-07-03 授权，Active，预计 2033-07-11 到期 |
| [CN106535705B](https://patents.google.com/patent/CN106535705B/en)（同族 GB2525662、US10849409B2、EP3136903B1） | Moncreiff "Free-flex harness" | 胸带环 + 连杆；腰带支撑杆（strut） | 2018-12-28 授权，Active，预计 2035-04-27 到期 |
| [CN222639968U](https://patents.google.com/patent/CN222639968U/en) | 凯乐石 | 带凹槽的背包支架（成型背板） | Active，预计 2034-05-29 到期 |
| CN114980777B（同族 US12336619B2） | Osprey | 3D 打印点阵腰垫 | Google Patents 显示有效，未在 CNIPA 复核 |

### 6.3 对我方概念的含义（非法律意见）

1. **"左右肩带下端联动、在包底滑动"的基本思路是 1997–2005 年就公开的现有技术**（Furnary、Salomon、叶啟明两件中国实用新型、Aarn），这些在本次查到的范围内都已失效或放弃。
2. **"滚轮 + 固定轮 + 可锁止开关"在已失效的 CN2800884Y（2005）中已有公开**。含义有两面：在中国实施这一基本机构时，本次没有查到仍有效的中国专利挡路；但我方若想就"滚轮 + 锁止"本身申请宽范围专利，新颖性/创造性会受这件现有技术限制。
3. **"腰带绕同一个枢纽转动"与肩带联动集成在一个刚性 hub 上**——本次没有找到直接公开这一组合的文献（最接近的是 Hiam US8172117B2 的"滑轮绳索肩部 + 铰接髋部"，但结构是连杆机构）。这可能是我方可申请保护的差异点，但**检索不完整，未核实**。
4. **本次查到的、与核心机构直接相关且仍有效的专利都在美国（及德国），均未查到 CN 同族**：Black Diamond US9254030B2（到 2033 年）、US8714424B2（到 2032 年）、Hiam US8172117B2（到 2030 年）、Frenchie US12089711B2（到 2039 年）、Arc'teryx US10004320B2（到 2036 年）、Gregory US10806238B2（到 2038 年）在美国有效。中国境内仍有效的是 C 表里机构不同的几件（Coxa Carry、Moncreiff 等）。产品如果销往美国，需要律师逐项比对权利要求（例如我方"滚轮"是否落入 BD 权利要求中"套管/通道"的解释范围，本报告不作判断）。欧洲方面 BD 的 EP 已失效，Frenchie、Hiam 的 EP 状态未核实。
5. **工程教训**：SwingArm 与 Exped T-Rex 的评测都提到负载左右摆动；因此"可锁止"和"限制行程/加阻尼"是有实际价值的设计点，而不只是卖点。

---

## 7. 综合

### （a） 品牌对比表

| 品牌 / 代表型号 | 容积 | 重量 | 标称载重 | 框架 | 背板 | 背长调节（范围） | 腰带与框架连接 | 主/底面料 |
|---|---|---|---|---|---|---|---|---|
| Mystery Ranch Coulee 40 | 40 L | 约 1.7 kg | 官方未核实（评测：不宜 >20 kg） | 2 根复合/玻纤竖杆 + 上横杆 + HDPE 片 | 贴背泡棉 + spacer mesh | Futura Yoke 魔术贴无级（S/M 38–51 cm；L/XL 43–61 cm） | 竖杆插入缝死的腰垫；腰翼可拆 | 210D Robic（2023）/ 双层底 |
| Osprey Exos 48 | 48 L | 1.255 kg | 11–14 kg | 4 mm LightWire 周边框 | AirSpeed 悬空网 | 注塑梯格，行程约 10 cm（S/M 43–52 cm） | 腰带接周边框下端（细节未核实） | 100D 高强尼龙 ripstop / 同 |
| Osprey Talon 44 | 44 L | 1.57 kg | 6.8–15.9 kg | 注塑 PP framesheet | AirScape 沟槽 EVA 贴背 | 未核实 | 腰垫到腰带无缝包裹 | 100D / 420D |
| Osprey Atmos AG 50 | 50 L | 1.959 kg | 11–16 kg | 4 mm 全周边框 | AG 连续悬空网 | cam-lock + Fit-on-the-Fly | 腰带骨架并入框架 | 210D / 500D |
| Deuter Futura Pro 40 | 40 L | 1.62 kg | 6–10 kg | 弹簧钢圆截面框 | Aircomfort 悬空网 | VariClick 5 档（42–62 cm） | VariFlex 活动腰翼，前拉 | 210D 再生 PA X-Grid |
| Deuter Aircontact Ultra 40+5 | 40+5 L | 1.21 kg | 6–10 kg（零售商）；媒体称至约 16 kg | 弹簧钢圆截面框 | Aircontact 贴背 + spacer mesh | Clip & Loop（42–62 cm） | 前拉腰翼 | 175D PA ripstop（国际站） |
| Gregory Zulu 40 | 40 L | 1.52 kg（S/M） | 最大 18 kg | 周边合金钢框（旧款带横撑） | FreeFloat 悬空网 | 可调约 8.9 cm | 柔性面板（FreeFloat）连接腰带与框 | 400D 再生涤纶 ripstop / 420D 尼龙 |
| Gregory Focal 48 | 48 L | 1.18 kg（M） | 最大 14 kg | 周边铝框 + 玻纤横撑 + HDPE | 悬空网 | 固定背长，3 码 | FreeFloat | 100D / 210D HD 尼龙 |
| Kailas Ridge III 38+5 | 38+5 L | 1.5 kg | 未核实（48+5 款至 20 kg） | 铝合金内框杆 | LIFT 贴背 | 3 档（41–57 cm） | 未核实 | 尼龙 200D + 420D（48+5 款） |
| Kailas Wind Tunnel 48+5 | 48+5 L | 1.52 kg | 12–16 kg | 7075 铝合金框 | SPACE 悬空网 | 3 档 | 未核实 | 330D Cordura |
| Arc'teryx Bora AR 50 | 50 L | 2.18 kg | 未核实 | Tegris 背板（其余未核实） | 未核实 | 未核实 | RotoGlide 滑轨 + 转动 | N420r-AC2 / N420p-HT |
| Thule Guidepost 65 | 65 L | 约 2.7 kg | 未核实 | 单宽铝支杆 + 塑料板 | 未核实（评测称通风差） | 约 15 cm（43–58 cm） | TransHub 转动关节 + 弹簧钢丝 | 未核实 |

（来源见第 1–6 节对应条目。）

### （b） 建议新 40 L 背包采用的通用（非专有）设计做法

1. **周边弹簧钢/合金丝框（约 3.5–4 mm）或"双支杆 + HDPE 片"，并加一根防鼓包横撑。** 理由：本次调研的 40 L 级（标称 10–18 kg）产品几乎都用这两种结构之一，横撑防止装满后包体鼓成桶形顶背。使用者：Osprey（LightWire 3–4 mm）、Deuter（弹簧钢）、Gregory（周边框 + 玻纤横撑）、Mystery Ranch（双杆 + 横杆）、Kailas（铝杆）。
2. **框架下端直接落在腰垫/腰带骨架上，中间不留软连接。** 理由：这是把重量送到髋部的关键路径。使用者：Mystery Ranch（杆插入腰垫）、Osprey Atmos（腰带并入框架）、Exped（支杆锚在腰带）。
3. **load lifter 锚在框架顶端或其上方，并有刚性件支撑。** 理由：否则上提带只会把包布拉变形。使用者：Mystery Ranch、Deuter Aircontact Lite（顶部横杆）。
4. **背长可调，行程至少约 9–10 cm（或分两码），并印刻度。** 理由：一个 SKU 覆盖更多身高；无刻度是被评测点名的缺点。使用者：Osprey（约 10 cm）、Gregory（约 8.9 cm）、Deuter（20 cm）、Mystery Ranch（13–18 cm）、Kailas（3 档）。
5. **调节机构选"有机械限位"的方案（梯格卡扣、多档卡位、织带 + 扣具），纯魔术贴要留足剪切面积或加二次锁。** 理由：魔术贴轭/腰带有滑移与失效的用户报告。使用者：Osprey Exos 梯格、Deuter VariClick / VariSlide；反例：Osprey Fit-on-the-Fly、Mystery Ranch 轭轻微位移。
6. **按目标载重选背板：≤14–16 kg 且重通风用悬空网；更重或强调稳定用带通风槽的贴背泡棉。** 理由：悬空网通风好但重心外移、上限较低；贴背更稳。使用者：悬空网——Osprey AirSpeed/AG、Deuter Aircomfort、Gregory FreeFloat、Kailas SPACE；贴背——Osprey AirScape、Deuter Aircontact、Mystery Ranch、Kailas LIFT。
7. **预成型（3D）、双密度泡棉腰带，前拉式（pull-forward）收紧。** 理由：前拉省力、易收紧；双密度兼顾贴合与支撑；太软的泡棉重载会被压实。使用者：Osprey ErgoPull、Deuter、Mystery Ranch、Gregory。
8. **腰翼与框架之间留受控的活动自由度（织物/弹性铰接），而不是整体硬连接。** 理由：骨盆行走时摆动，允许腰带随动可减少摩擦。使用者：Deuter VariFlex、Gregory FreeFloat、Lowe Alpine、Thule。注意只采用"柔性连接"这一通用思路，具体结构避开下文 （c） 所列专利。
9. **S 形肩带，EVA（可打孔）+ spacer mesh，肩带上端允许小角度自转；胸带用滑轨式可上下调。** 理由：适配不同肩宽/肩斜，减少磨颈。使用者：Mystery Ranch、Osprey ExoForm（15 mm 滑轨胸带）、Deuter ActiveFit、Gregory。
10. **面料分区：主体 100–210D 高强尼龙 ripstop，底部 400–500D，PU 内涂 + 无 PFAS 的 DWR。** 理由：重量与耐磨的行业平衡点，且符合欧美 PFAS 趋势。使用者：Osprey、Gregory、Deuter、Mystery Ranch、Kailas。
11. **辅料用通用一线供应商（YKK 拉链；Duraflex / Woojin / UTX 扣具）。** 理由：可靠、易采购、无品牌专有问题。使用者：Mystery Ranch（YKK、Duraflex、Woojin）、Kailas 早期款（UTX、YKK）。
12. **在设计阶段就做防异响：框丝涂层、杆端加套、框与套管之间隔离。** 理由：吱响是多个品牌共同的差评点。出现问题的：Osprey AG、Mystery Ranch、Gregory Focal。
13. **标配：防雨罩、水袋仓、腰带袋、前置弹力袋、侧面或 U 形拉链开口。** 理由：这一价位/容积的事实标准配置。使用者：Gregory Zulu（防雨罩 + U 形开口）、Deuter、Kailas。
14. **公布诚实的载重区间，并按它设计框架刚度。** 理由：成熟品牌在 40 L 级普遍标 10–16 kg（上限 18 kg）；超标称后的抱怨集中在传力不足。使用者：Osprey、Deuter、Gregory、Kailas。
15. **任何随动机构都要"可锁止 / 限行程 / 可维修更换"。** 理由：随动背负的评测共性问题是左右晃动；锁止后应退化成一只普通的好背包。相关：Black Diamond SwingArm、Exped T-Rex 的评测反馈。

### （c） 可能受专利保护或品牌识别度很高、应回避或交中国专利代理人核查的特征

| 特征 | 相关权利 | 本次所见状态 | 建议 |
|---|---|---|---|
| 肩带下端经缆/带在包内套管中滑动联动（SwingArm 式） | Black Diamond US9254030B2 | US 有效至 2033；未查到 CN 同族；EP 失效 | 出口美国前必须比对权利要求；中国部分请代理人确认确无同族 |
| 球铰式腰带连接 | Black Diamond US8714424B2 | US 有效至 2032；无 CN | 我方腰带枢纽避免做成球铰，或请律师比对 |
| 腰带在背板滑轨上滑动 + 转动（RotoGlide 式） | Arc'teryx US10004320B2 | US 有效至 2036；无 CN | 回避滑轨式结构 |
| 腰带经柔性面板"浮动"连接框架（FreeFloat 式） | Samsonite/Gregory US10806238B2、EP3569100B1 | US 有效至 2038；未见 CN | 出口欧美前比对；不要使用 FreeFloat 名称 |
| 肩、髋两个转动件反向耦合（Active Spine 式） | Mammut DE102017219211B4 + US 申请 | DE 有效；US 未核实；无 CN | 回避"肩髋机械反向耦合" |
| 滑轮 + 绳索肩部悬挂配合铰接髋杆 | Hiam US8172117B2 | US 有效至 2030；无 CN | 与我方概念相近，出口美国前比对 |
| 连续织带穿过双板通道连接两肩带 | Frenchie Group US12089711B2 及 EP 同族 | US 有效至 2039；EP 未核实；未见 CN | 出口欧美前比对 |
| 胸前汇合式四带连接体；可沿背带移动的连接件 | Coxa Carry CN106923401B、CN104640477B | **CN 有效** | 在中国必须回避或取得意见 |
| 胸带环 + 连杆、腰带支撑杆 | Moncreiff CN106535705B | **CN 有效** | 同上 |
| 带凹槽的成型背板/背包支架 | 凯乐石 CN222639968U | **CN 有效** | 做成型背板或碳板时比对 |
| 3D 打印点阵腰垫 | Osprey US12336619B2 / CN114980777B | US 有效；CN 显示有效 | 回避 |
| 肩带横向位置的转动卡锁 | Thule US9326586B2（同族含 CN） | US 有效；CN 未核实 | 若做肩宽可调，需核查 CN 同族 |
| 多支杆柔性关节 + 膜片的框架系统（Mystery Ranch 专利页称覆盖 Coulee、Scree 等）；Futura Yoke 被零售商称为 "patented"，其对应专利号未核实 | Mystery Ranch US7673777B2 等 | US7673777B2 有效至 2028；无 CN | "魔术贴调背长"这一通用做法多家在用，但不要照搬其框架结构和名称 |
| 弓形张紧碳杆框；左右分体扭转框 | Zpacks US9060590B2；Seek Outside US10617195B2 | 均仅 US 有效 | 出口美国前比对 |
| 外观与名称：Osprey AG 的连续无缝网外观、Mystery Ranch 3-ZIP 的 Y 形三拉链外观、各家技术名称（AirSpeed、Anti-Gravity、AirScape、Aircomfort、Aircontact、VariQuick、FreeFloat、LIFT、SPACE、SwingArm、RotoGlide、TransHub、Active Spine 等） | 商标 / 外观设计 / 反不正当竞争层面；对应的外观专利本次未检索 | 未核实 | 不使用这些名称；整体外观保持可区分；请代理人补做外观设计与商标检索 |

**需要代理人补做的检索**：（1） CNIPA 中文全文检索"肩带联动 / 滑轮 / 平衡 / 锁止 / 腰带枢轴"类实用新型与发明（本次不完整）；（2） 上表中所有"未核实"的同族状态（Thule CN 同族、Frenchie 与 Hiam 的 EP、Mammut US、Aarn AU/NZ、叶啓明 JP）；（3） Deuter、Lowe Alpine、Fjällräven、Osprey AG 的专利（本次未能取得）。

---

## 8. 未能核实事项汇总

- 各品牌拉链/扣具供应商：只核实了 Mystery Ranch（YKK、Duraflex、Woojin）和 Kailas 早期款（UTX、YKK）；Osprey、Deuter、Gregory 以及 Kailas 现款未核实。
- 框架丝/杆的直径与截面：只有 Osprey（3 / 3.5 / 4 mm）和 Exped 横杆（约 22 cm × Ø1 cm）有来源，其余未核实。
- 各型号腰带袋细节：大多未逐项核实。
- Mystery Ranch Coulee 40 与 Kailas Ridge III 38+5 的官方推荐最大载重：未核实。mysteryranch.com 产品页抓取失败，数据来自零售商与评测。
- Deuter Trail Pro 36 的框架材质（Delrin U 形框 vs 弹簧钢）、Aircontact Ultra 的面料丹尼数、Gregory Paragon 48 的底料丹尼数：来源互相矛盾。
- Kailas 的 LIFT / SPACE / EASE 命名与参数主要来自社区文章和海外零售商，非官方技术文件；Mystery（秘境）、Fuga 系列未核实。
- 专利：Deuter、Lowe Alpine、Fjällräven、Osprey AG、Thule TransHub 关节、Gregory Response A3、Mystery Ranch 3-ZIP 与其专利页上其余专利号的状态均未核实；表中标注"未核实"的同族状态同样如此。
- 本报告的专利部分不构成 FTO 结论。
