wentingjie001-cmd/-/docs/04_filing_strategy_and_checklist.md

# 04 中国专利申请策略与材料清单

## 1. 先澄清：申请中国专利需要什么

| 你以为需要的 | 实际情况 |
|---|---|
| 3D CAD 工程图 | **不是法定要求**。发明/实用新型要的是"说明书附图"（黑白线条图，可以从 3D 模型投影生成）；外观设计要的是"图片或照片"（六面视图 + 立体图）。3D 模型的作用是方便快速、准确地出这些图，并作为后续打样和量产的依据。 |
| 手办 / 实物样品 | **不需要提交**。中国专利申请不收实物模型。实物的作用：① 验证方案可行（发明/实用新型要求"能够实现"）；② 外观设计可以直接拍照片代替画图；③ 以后维权时作为证据。 |
| 工程图纸（带尺寸、公差） | **不需要提交**。专利附图里不能标尺寸线和文字说明，只能用附图标记数字。带尺寸的工程图是给打样厂/模具厂用的。 |

**真正要交的是：**

| 类型 | 必交文件 |
|---|---|
| 发明专利 | 请求书、说明书、权利要求书、说明书附图、说明书摘要（+ 摘要附图）；同时或 3 年内提交实质审查请求 |
| 实用新型 | 请求书、说明书、权利要求书、说明书附图（必须有）、说明书摘要（+ 摘要附图） |
| 外观设计 | 请求书、外观设计图片或照片（各视图）、简要说明 |

本仓库已经准备好了以上除"请求书"之外的全部 **初稿**（请求书是官方表格，由代理机构在 CPC 客户端 / 专利业务办理系统中填写）。

## 2. 建议申请的一套专利（"组合拳"）

| # | 类型 | 名称（暂定） | 保护什么 | 文件位置 |
|---|---|---|---|---|
| A | **发明** | 一种背包随动背负系统及背包 | 滚轮联动 + 可切换锁止 + 回中 + 限位 + Y 型背架 + 双区张紧 + 同轴枢转（多层权利要求） | `patent/A_invention_linkage_harness/` |
| B | **实用新型**（与 A **同日** 申请，"一案两请"） | 同 A | 同 A 的结构权利要求 | 同 A（同一套文本，类型改为实用新型） |
| C | 外观设计 | 背包 | 整体外观 | `patent/C_design_backpack/` + `cad/out/design/01_backpack_whole/` |
| D | 外观设计（局部） | 背包的背负系统 | 背部背负系统部分的外观（实线部分） | `patent/D_design_partial_back_system/` + `cad/out/design/02_backpack_partial_back_system/` |
| E | 外观设计 | 背包用联动座 | 联动座这个配件的外观 | `patent/E_design_linkage_hub/` + `cad/out/design/03_linkage_hub/` |

为什么这样组合：

- **一案两请（A + B）**：同一申请人同日对同样的发明创造既申请发明又申请实用新型，并在请求书中分别声明。实用新型不做实质审查，一般几个月就能授权，先拿到保护；发明授权时放弃实用新型，换成保护期 20 年的发明专利。如果发明最终没授权，实用新型（10 年）还在。
- **外观三件**：整体外观防整包被仿；局部外观（2021 年 6 月 1 日起施行的新专利法允许）专门保护背部造型，即使别人改了包体样式，背部照抄也能管住；联动座是一个独立注塑件，单独申请外观最稳。
- 如果预算有限，优先级：**A+B > E > C > D**。

## 3. 时间线（按依赖顺序，不是日历时间）

1. **冻结方案**：拿到 P1 联动座打印件和 P2 改装验证机，确认机构可行，再对权利要求做最后修改（实用新型/发明申请后不能加入新内容）。
2. **代理师检索**：新颖性 + FTO（见 02 文档检索式）。
3. **定稿外观**：外观以样包或 1:4 手办确认后再出最终视图（外观申请后不能改设计）。
4. **同日递交 A + B**，外观 C/D/E 可同日或之后递交，但都要 **在任何公开之前**。
5. 如需海外保护：自中国申请日起 12 个月内（发明/实用新型）或 6 个月内（外观）以优先权提交 PCT 或海牙申请。
6. 递交后再开始展会、众筹、电商预售、社交媒体宣传。

## 4. 官方费用参考（以 CNIPA 最新收费标准为准）

| 项目 | 官费（元，未减缴） |
|---|---|
| 发明申请费 | 900 |
| 发明实质审查费 | 2500 |
| 实用新型申请费 | 500 |
| 外观设计申请费 | 500 |

- 个人或符合条件的小微企业可以申请 **费用减缴**（减缴后通常只付一小部分官费，具体比例以官方规定为准）。
- 授权后需要按年缴年费。
- 代理费各机构差别大，以报价为准。

## 5. 交给代理机构的材料包（本仓库对应位置）

- [ ] 申请人信息（个人身份证 / 企业营业执照）、发明人名单
- [ ] 发明/实用新型：`patent/A_invention_linkage_harness/` 中的权利要求书、说明书、摘要
- [ ] 说明书附图：`cad/out/invention/fig1–fig5`（PDF 矢量）+ `cad/out/schematics/fig6, fig7`
- [ ] 外观设计视图：`cad/out/design/01–03/`（PNG 300 dpi 或 PDF），以及三份简要说明
- [ ] 竞品与现有技术资料：`docs/01`、`docs/02`（供代理师写背景技术、做检索）
- [ ] 3D 模型（不提交给 CNIPA，供代理师理解结构）：`cad/out/step/*.step`

## 6. 附图格式注意事项（代理师会把关，这里列出我们已经遵守的）

- 发明/实用新型附图：黑色线条、白底、不着色，除必要的附图标记数字外不写文字；同一零件在各图中的标记一致；`fig5` 用虚线表示内部隐藏结构。
- 外观设计视图：各视图比例一致，不画阴影、中心线、尺寸线，不写文字说明（视图名称写在图下方）；局部外观用 **实线 + 虚线** 区分保护和不保护的部分，并在简要说明中写明。
- 软质产品（背包）外观若用 CAD 线条图与实物差别较大，建议改用 **定稿样包的照片**（白色或灰色单色背景，不带其他物品），视图与本仓库视图一致。
