wentingjie001-cmd/-/cad/out/production/webbing_cut_list.md

| 编号 | 名称 | 规格 | 单根长 (mm) | 数量 | 用途 |
|---|---|---|---|---|---|
| W01 | 联动带 | 20 mm UHMWPE 扁织带，表面压光 | 900 | 1 | 穿过联动座，两端接 W02 |
| W02 | 肩带下调节带 | 20 mm 尼龙织带 | 420 | 2 | 联动带端头 → 肩带下端梯扣 |
| W03 | 上拉带（load lifter） | 15 mm 尼龙织带 | 330 | 2 | 肩带顶 → 后幅上拉带锚点 |
| W04 | 胸带 | 15 mm 尼龙织带（含 60 mm 弹力段） | 380 | 1 | 分 260 + 120 两段，配滑轨扣 |
| W05 | 腰带收紧带 | 25 mm 尼龙织带 | 650 | 2 | 前拉式：从中扣回折到腰带翼 |
| W06 | 卷口加强带 | 20 mm 硬挺尼龙织带 | 398 | 2 | 夹在前、后幅卷口折边内 |
| W07 | 卷口侧扣带 | 20 mm 尼龙织带 | 200 | 2 | 侧幅上部，接卷口插扣 |
| W08 | 侧压缩带 | 15 mm 尼龙织带 | 420 | 4 | 每侧两条，侧幅 z = 330 和 480 处 |
| W09 | 上区张紧带 | 20 mm 尼龙织带 | 260 | 2 | 悬浮网下角 → 后幅上的凸轮扣（z = 255） |
| W10 | 下区张紧带 | 20 mm 尼龙织带 | 300 | 2 | 腰垫 → 后幅下锚点 |
| W11 | 背长调节梯带 | 25 mm 尼龙织带 | 330 | 1 | 后幅中线，5 档，档距 25 mm |
| W12 | 提手 | 20 mm 尼龙织带（中段包管） | 260 | 1 | 后幅顶部 |
| W13 | V 形压缩绳 | 3 mm 弹力绳 | 340 | 2 | 前幅 |
| W14 | 回中弹性绳 | 3 mm 弹力绳 | 120 | 2 | 联动座内 |
| W15 | 内缝包边带 | 20 mm 涤纶罗纹包边带 | 4527 | 1 | 包住全部包体内缝 |
| W16 | 外露包边带 | 20 mm 弹力包边带 | 4372 | 1 | 肩带、腰带翼、悬浮网、前袋口 |
| W17 | 侧袋口松紧带 | 10 mm 松紧带 | 159 | 2 | 侧袋口卷边内 |
