wentingjie001-cmd/-/cad/out/production/volume.md

| 部位 | 容积 (L) | 来源 |
|---|---|---|
| 主仓（包底到卷口线，按装满后的圆角截面积分） | 36.6 | 计算 |
| 前弹力袋 | 2.4 | 估算：定位面积 × 平均鼓起 30 mm |
| 侧袋 ×2 | 2.6 | 估算 |
| 腰带袋 ×2 | 0.8 | 估算 |
| 合计（标称容积） | 42.4 |  |
| 卷口少卷时的扩展容积 | +6.8 | 卷口线以上 150 mm |
