wentingjie001-cmd/-/cad/out/production/pdf/BP40-A1_patterns_1to1.pdf

校准条 100 mm（中间刻线 50 mm），打印后先量这一条

A01 后幅（贴背片）

主面料：210D 高强尼龙格子布（Robic 或同级），PU 内涂，无氟防泼水

数量 1，比例 1:1，单位 mm

面朝人体一侧为正面。联动座用 4 颗螺钉穿过 E01 加强片、后幅和 E04 内衬板固定。

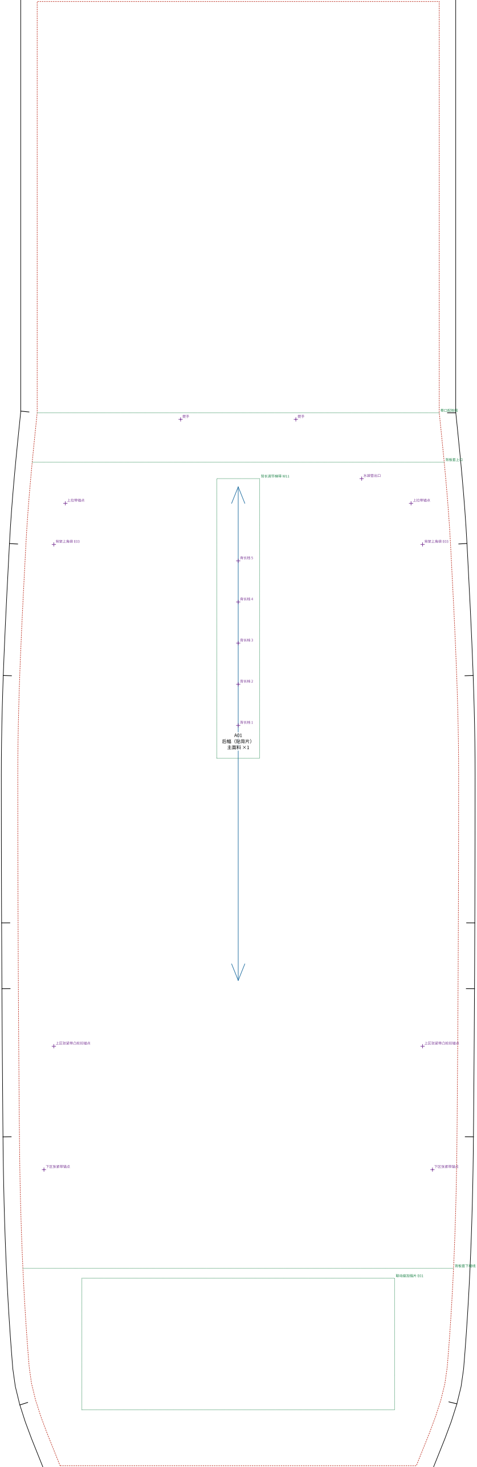
[picture p18: figure]
背长档 1; 背长档 2; 背长档 3; 背长档 4; 背长档 5; 上拉带锚点; 背架上角袋 E03; 下区张紧带锚点; 上区张紧带凸轮扣锚点; 水袋管出口; 卷口起始线; 背板套下缝线; 背板套上口; 联动座加强片 E01; 背长调节梯带 W11; A01 后幅（贴背片） 主面料 ×1
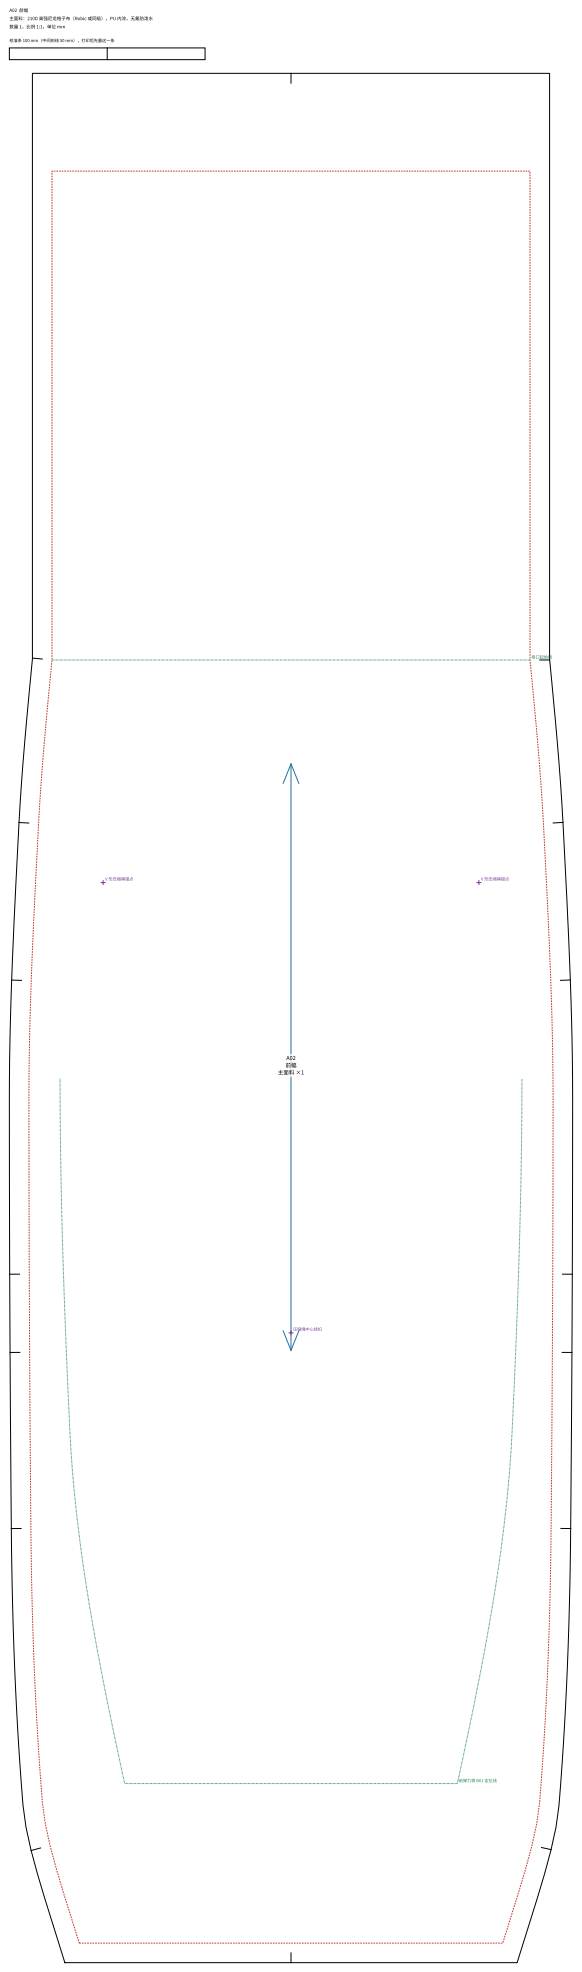
[picture p19: page 2]
V 形压缩绳锚点; 压缩绳中心挂扣; 卷口起始线; 前弹力袋 B01 定位线; A02 前幅 主面料 ×1

主面料：210D 高强尼龙格子布（Robic 或同级），PU 内涂，无氟防泼水

A03-L 侧幅（左右各一，镜像）

主面料：210D 高强尼龙格子布（Robic 或同级），PU 内涂，无氟防泼水

数量 2，比例 1:1，单位 mm

后边与后幅缝合，前边与前幅缝合。侧压缩带在 z = 330 和 480 的刀口处夹入前、后两条缝。

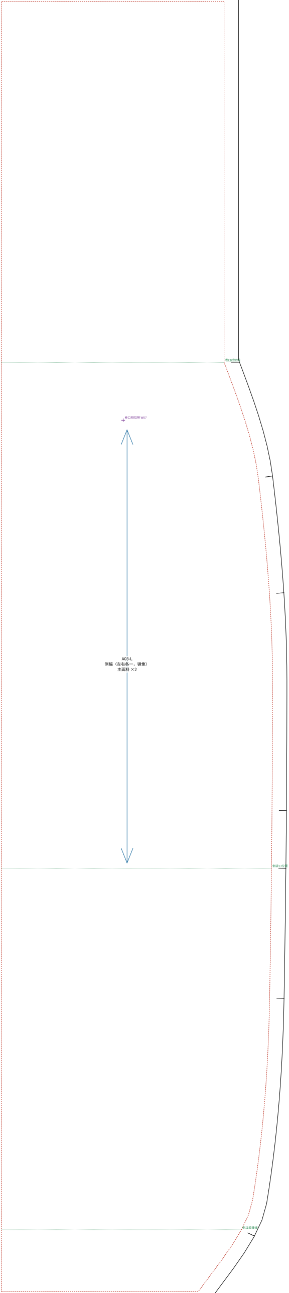
[picture p20: figure]
卷口侧扣带 W07; 卷口起始线; 侧袋口位置; 侧袋底缝线; A03-L 侧幅（左右各一，镜像） 主面料 ×2

A03-R 侧幅（左右各一，镜像）

主面料：210D 高强尼龙格子布（Robic 或同级），PU 内涂，无氟防泼水

数量 2，比例 1:1，单位 mm

后边与后幅缝合，前边与前幅缝合。侧压缩带在 z = 330 和 480 的刀口处夹入前、后两条缝。

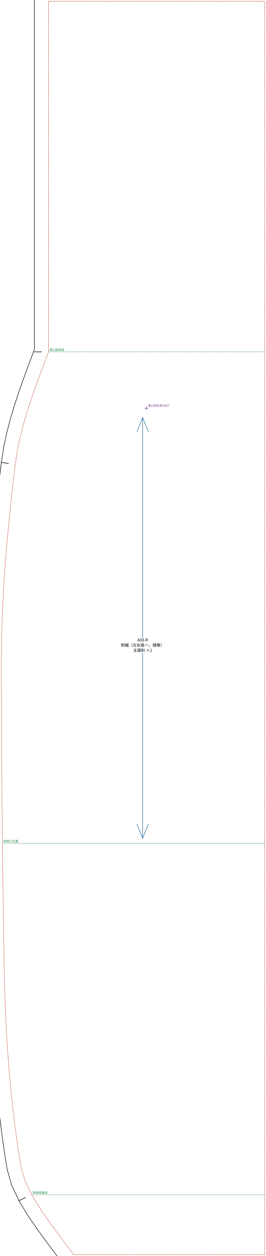
[picture p21: figure]
卷口侧扣带 W07; 卷口起始线; 侧袋口位置; 侧袋底缝线; A03-R 侧幅（左右各一，镜像） 主面料 ×2

A04
包底
底料 ×1

校准条 100 mm（中间刻线 50 mm），打印后先量这一条

A04 包底

底料：420D 高强尼龙，PU 内涂

数量 1，比例 1:1，单位 mm

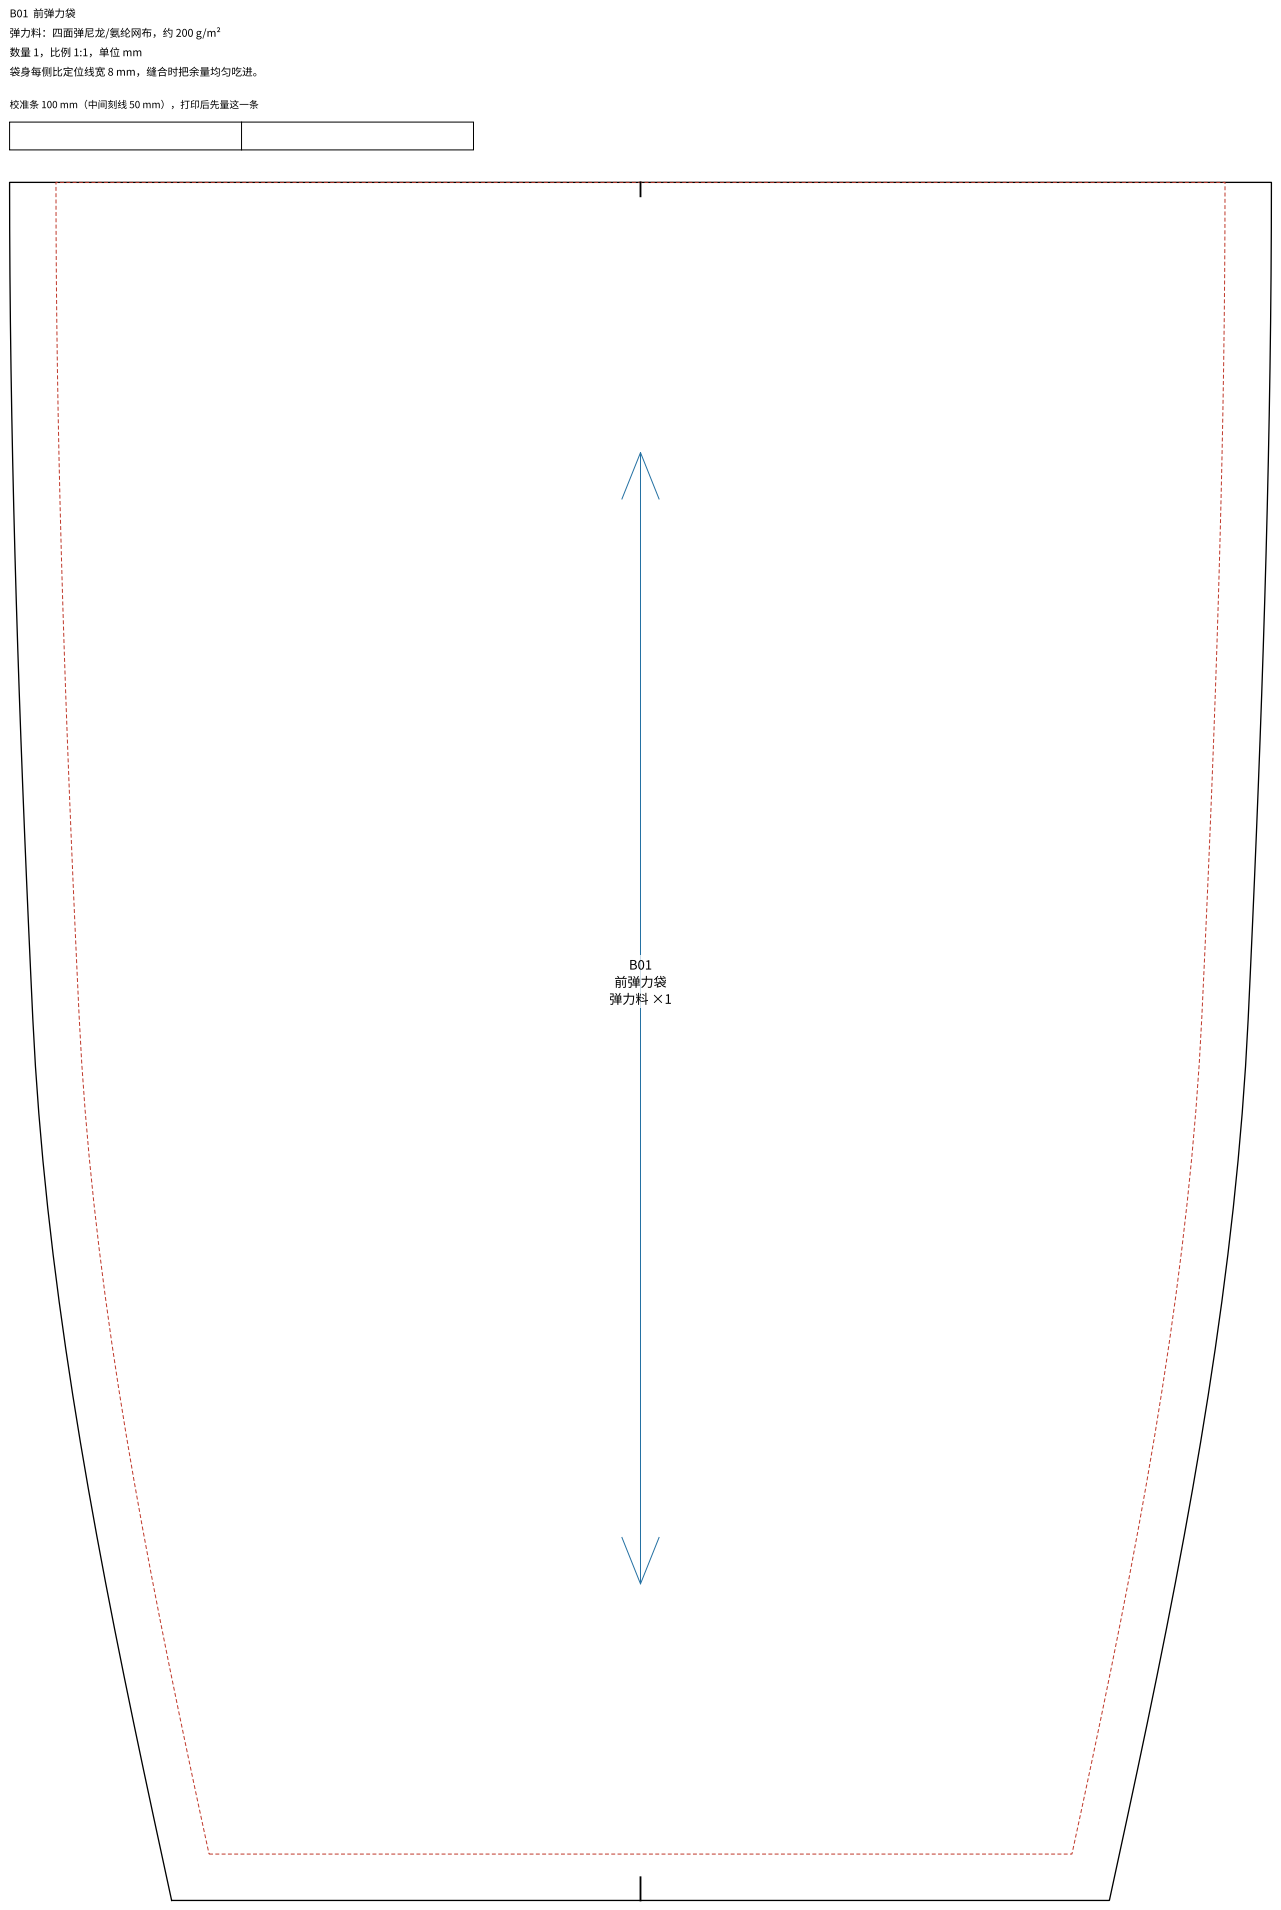
[picture p22: page 6]
B01 前弹力袋 弹力料 ×1; B01 前弹力袋

弹力料：四面弹尼龙/氨纶网布，约 200 g/m²

袋身每侧比定位线宽 8 mm，缝合时把余量均匀吃进。

B02-L 侧袋（左右各一，镜像）

弹力料：四面弹尼龙/氨纶网布，约 200 g/m²

数量 2，比例 1:1，单位 mm

袋口松紧带净长取侧幅该处宽度的 85%。

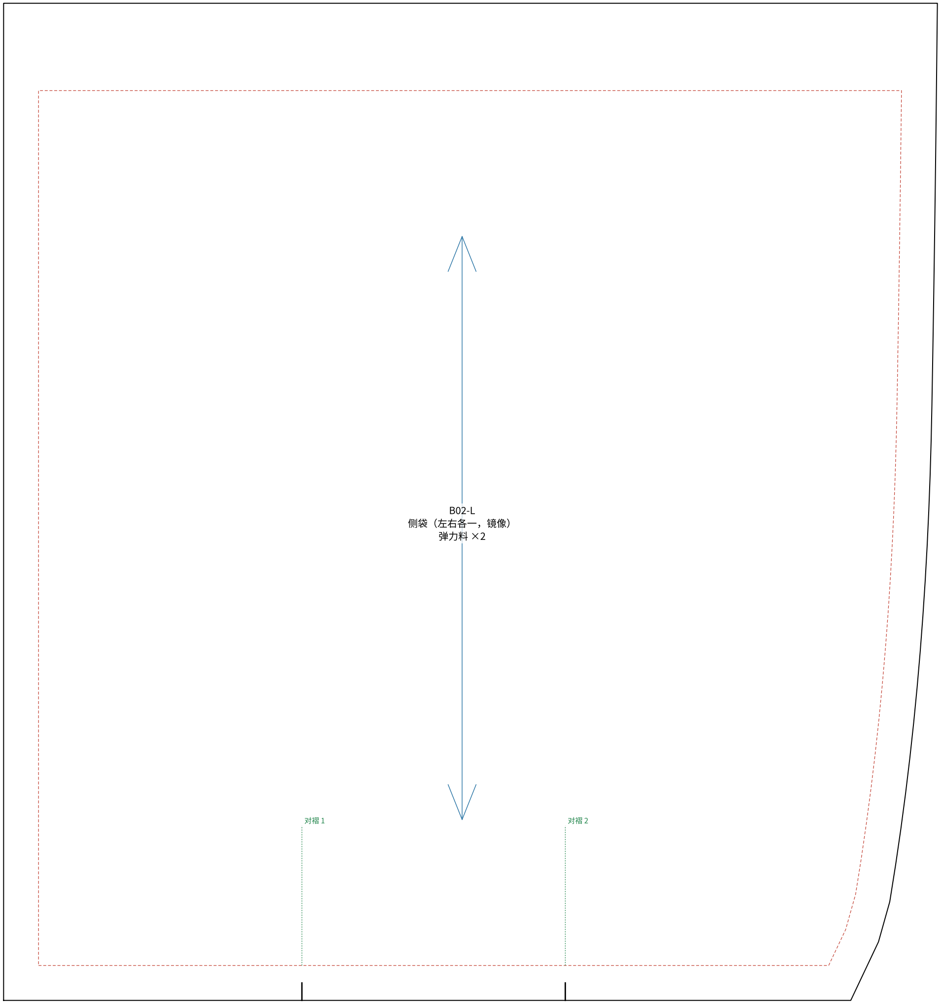
[picture p23: figure]
B02-L 侧袋（左右各一，镜像） 弹力料 ×2

B02-R 侧袋（左右各一，镜像）

弹力料：四面弹尼龙/氨纶网布，约 200 g/m²

数量 2，比例 1:1，单位 mm

袋口松紧带净长取侧幅该处宽度的 85%。

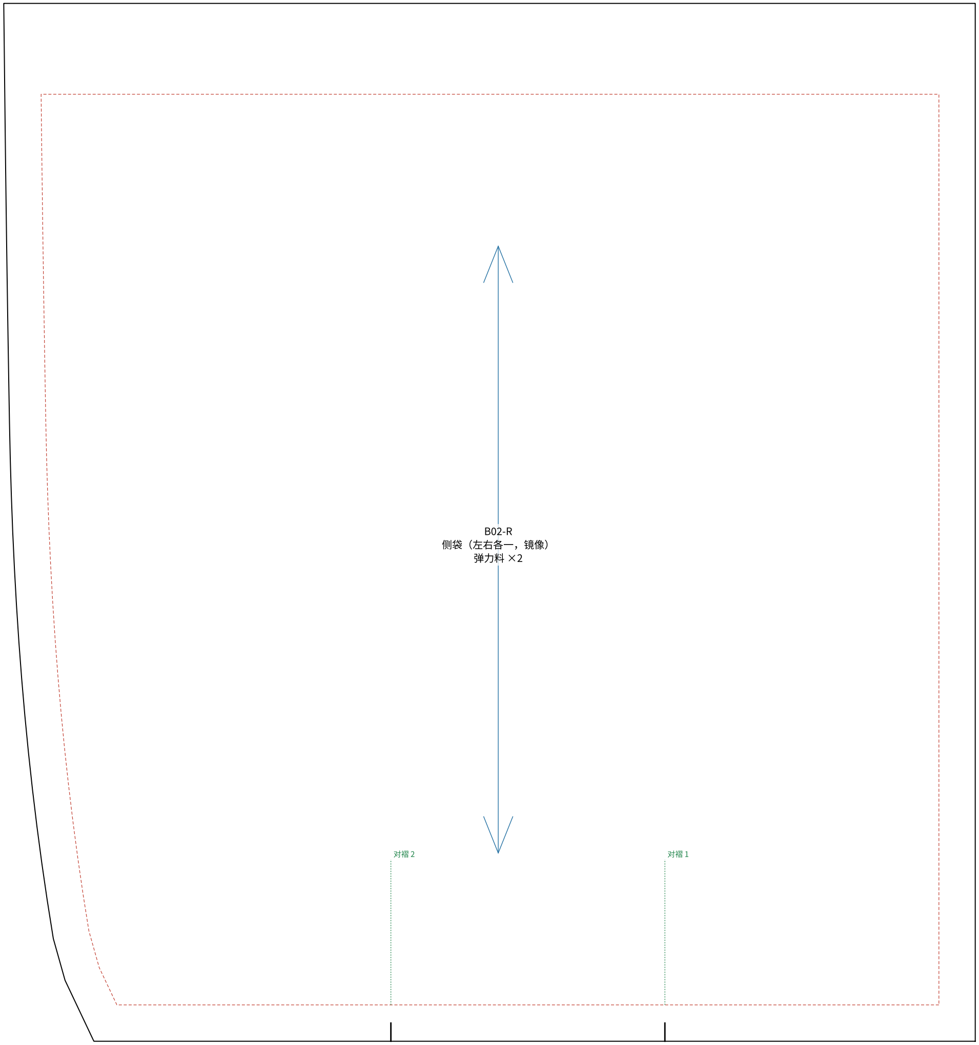
[picture p24: figure]
B02-R 侧袋（左右各一，镜像） 弹力料 ×2

校准条 100 mm（中间刻线 50 mm），打印后先量这一条

B03 腰带袋面片

主面料：210D 高强尼龙格子布（Robic 或同级），PU 内涂，无氟防泼水

数量 2，比例 1:1，单位 mm

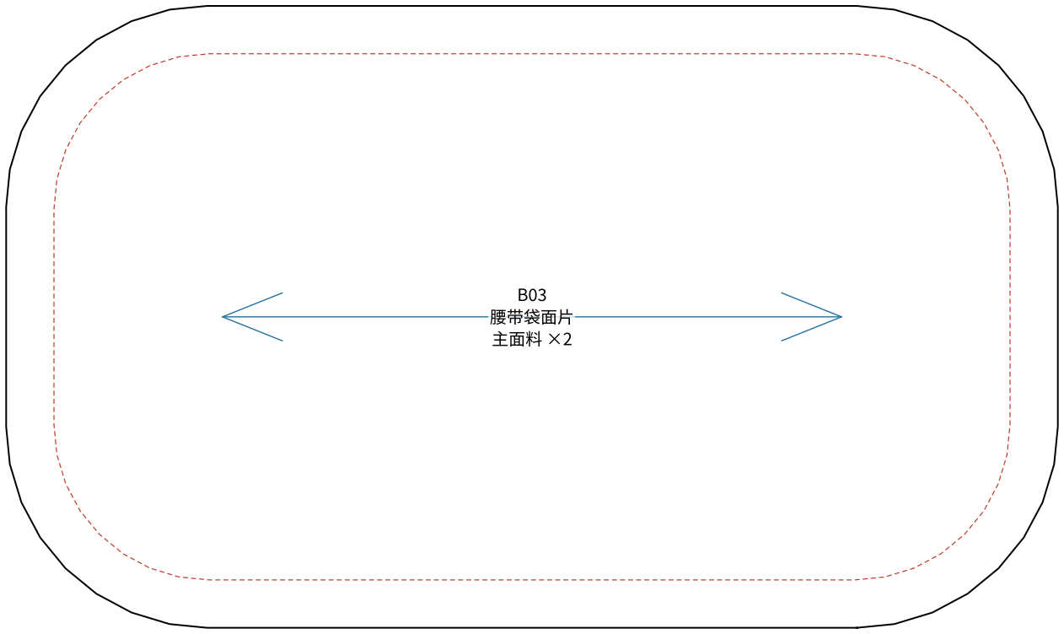
[picture p25: figure]
B03 腰带袋面片 主面料 ×2

B04

### 腰带袋围条 主面料 ×2

校准条 100 mm（中间刻线 50 mm），打印后先量这一条

B04 腰带袋围条

主面料：210D 高强尼龙格子布（Robic 或同级），PU 内涂，无氟防泼水

数量 2，比例 1:1，单位 mm

B05

### 腰带袋拉链贴条 主面料 ×4

校准条 100 mm（中间刻线 50 mm），打印后先量这一条

B05 腰带袋拉链贴条

主面料：210D 高强尼龙格子布（Robic 或同级），PU 内涂，无氟防泼水

数量 4，比例 1:1，单位 mm

两条夹 5 号尼龙拉链，合计净宽 35。

B06

### 水袋仓

里料 ×1

B06 水袋仓

里料：70D 尼龙塔夫，PU 内涂

数量 1，比例 1:1，单位 mm

C01 背板（防鼓包）

背板：HDPE 板 1.5 mm

数量 1，比例 1:1，单位 mm

插入背板套，可抽出。

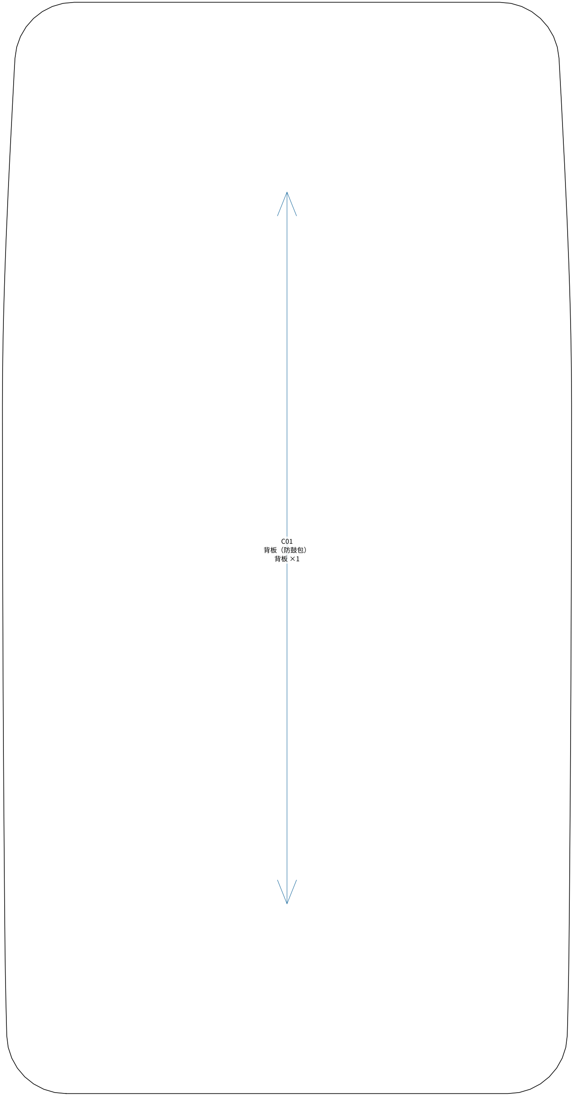
[picture p26: figure]
C01 背板（防鼓包） 背板 ×1

C02 背板套

里料：70D 尼龙塔夫，PU 内涂

数量 1，比例 1:1，单位 mm

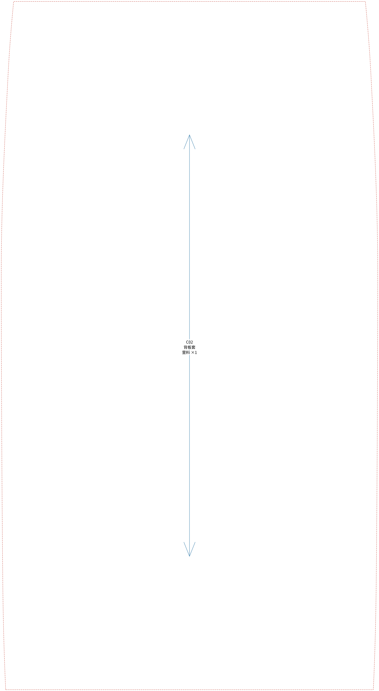
[picture p27: figure]
C02 背板套 里料 ×1

C03 上区悬浮网

间隔网布：3 mm 三明治网布（3D spacer mesh）

数量 1，比例 1:1，单位 mm

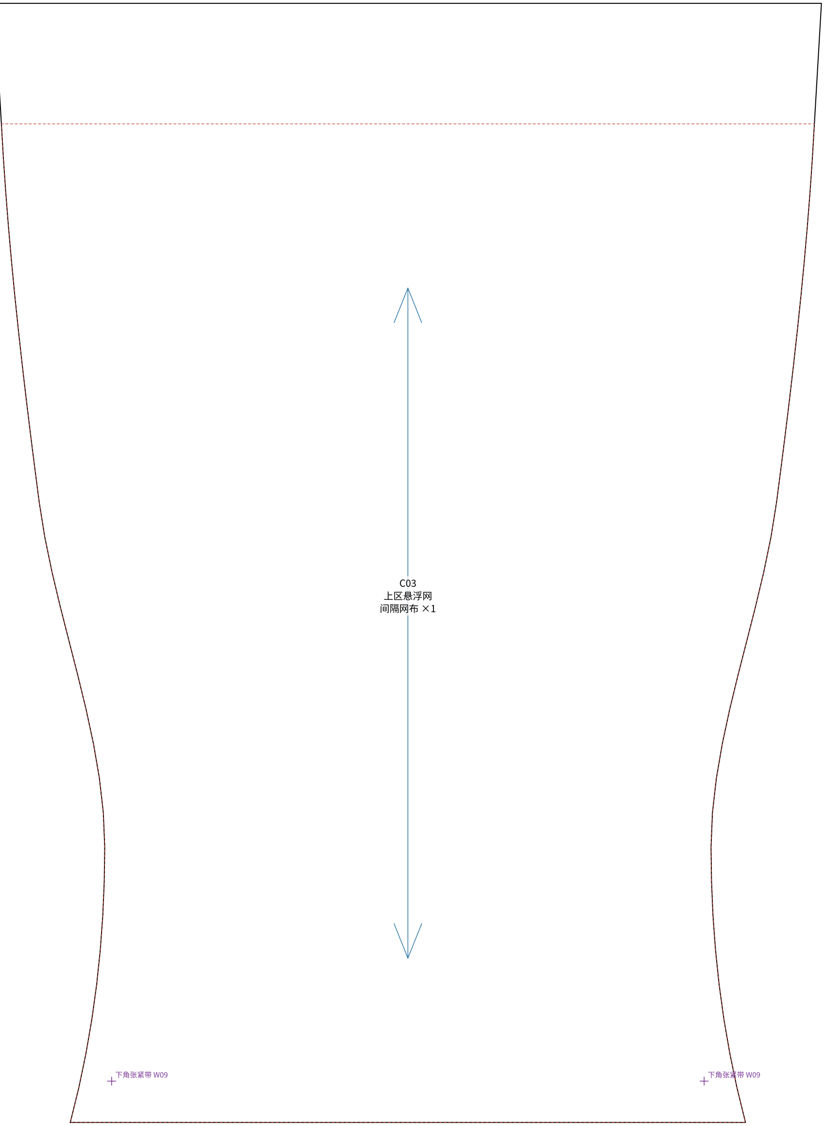
[picture p28: figure]
下角张紧带 W09; C03 上区悬浮网 间隔网布 ×1

校准条 100 mm（中间刻线 50 mm），打印后先量这一条

C04 腰垫面片

间隔网布：3 mm 三明治网布（3D spacer mesh）

数量 2，比例 1:1，单位 mm

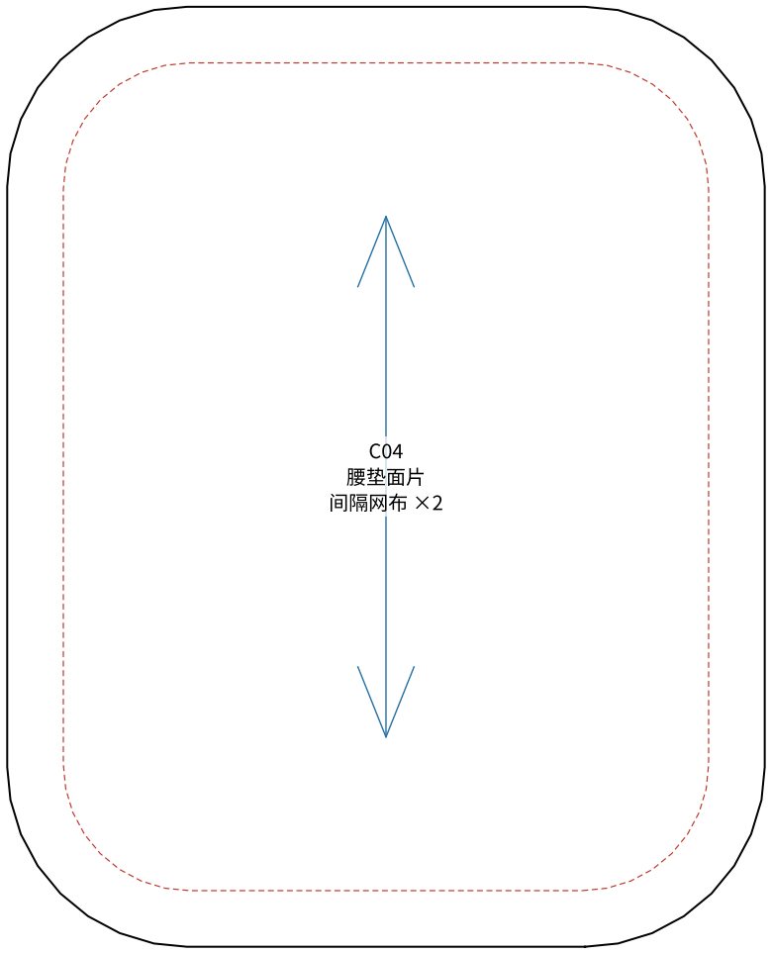
[picture p29: figure]
C04 腰垫面片 间隔网布 ×2

C05

### 腰垫围条 间隔网布 ×2

校准条 100 mm（中间刻线 50 mm），打印后先量这一条

C05 腰垫围条

间隔网布：3 mm 三明治网布（3D spacer mesh）

数量 2，比例 1:1，单位 mm

校准条 100 mm（中间刻线 50 mm），打印后先量这一条

C06 腰垫底片

主面料：210D 高强尼龙格子布（Robic 或同级），PU 内涂，无氟防泼水

数量 2，比例 1:1，单位 mm

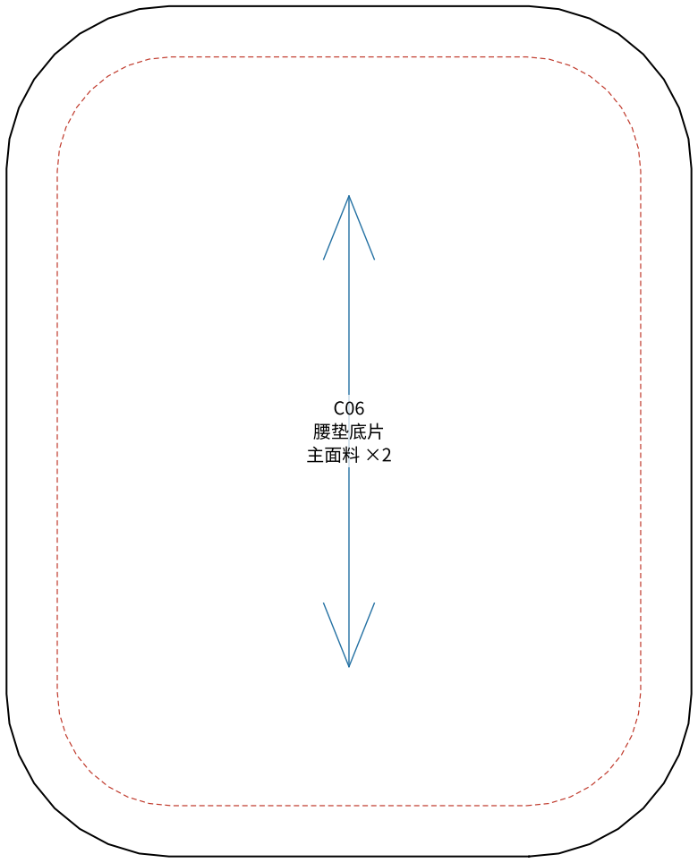
[picture p30: figure]
C06 腰垫底片 主面料 ×2

校准条 100 mm（中间刻线 50 mm），打印后先量这一条

C07 腰垫泡棉芯

腰垫泡棉：EVA 22 mm（10 + 12 贴合）

数量 2，比例 1:1，单位 mm

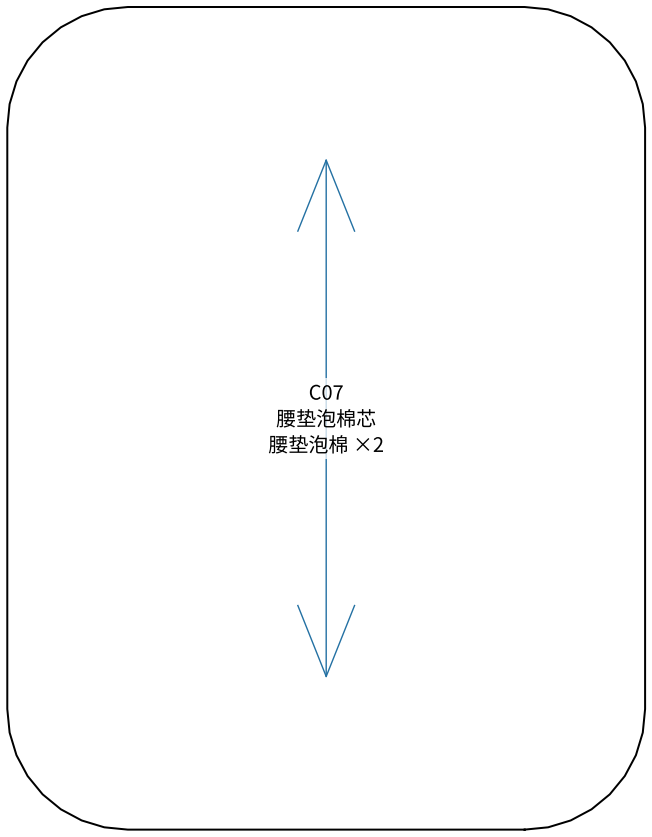
[picture p31: figure]
C07 腰垫泡棉芯 腰垫泡棉 ×2

校准条 100 mm（中间刻线 50 mm），打印后先量这一条

C08 肩轭（内外两层）

主面料：210D 高强尼龙格子布（Robic 或同级），PU 内涂，无氟防泼水

数量 2，比例 1:1，单位 mm

两层夹 C09 加强板。背面中线缝一条带 G 钩的 25 mm 织带，挂入后幅梯带调背长。

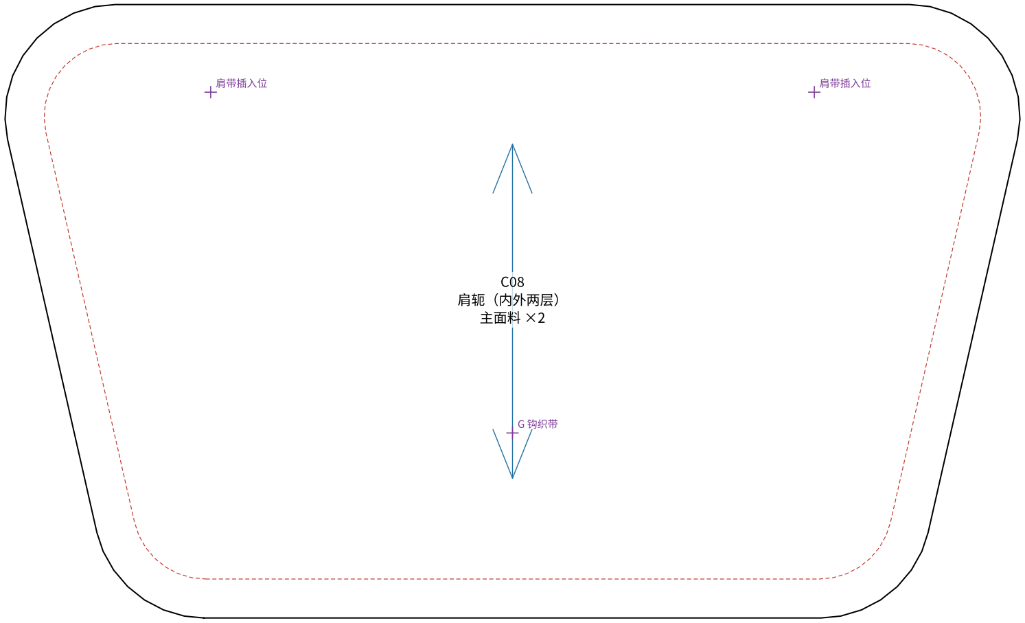
[picture p32: figure]
G 钩织带; 肩带插入位; C08 肩轭（内外两层） 主面料 ×2

校准条 100 mm（中间刻线 50 mm），打印后先量这一条

C09 肩轭加强板

加强板：HDPE 板 1.0 mm

数量 1，比例 1:1，单位 mm

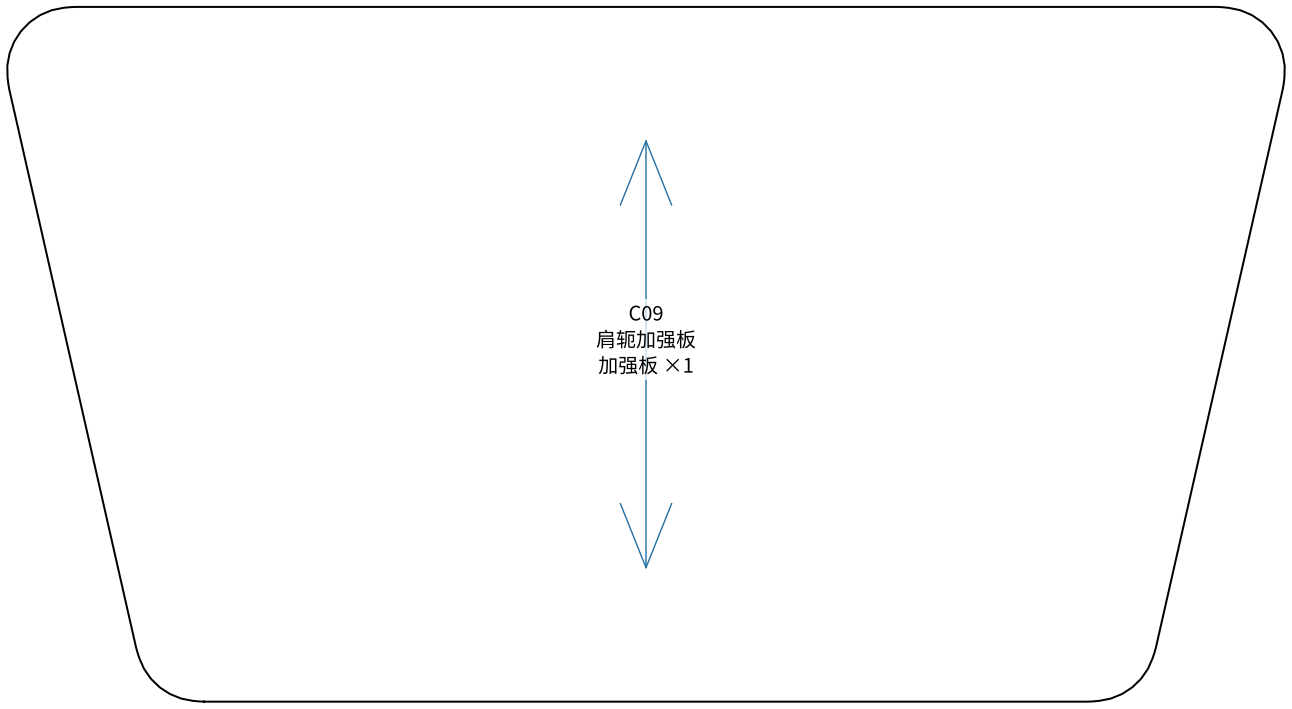
[picture p33: figure]
C09 肩轭加强板 加强板 ×1
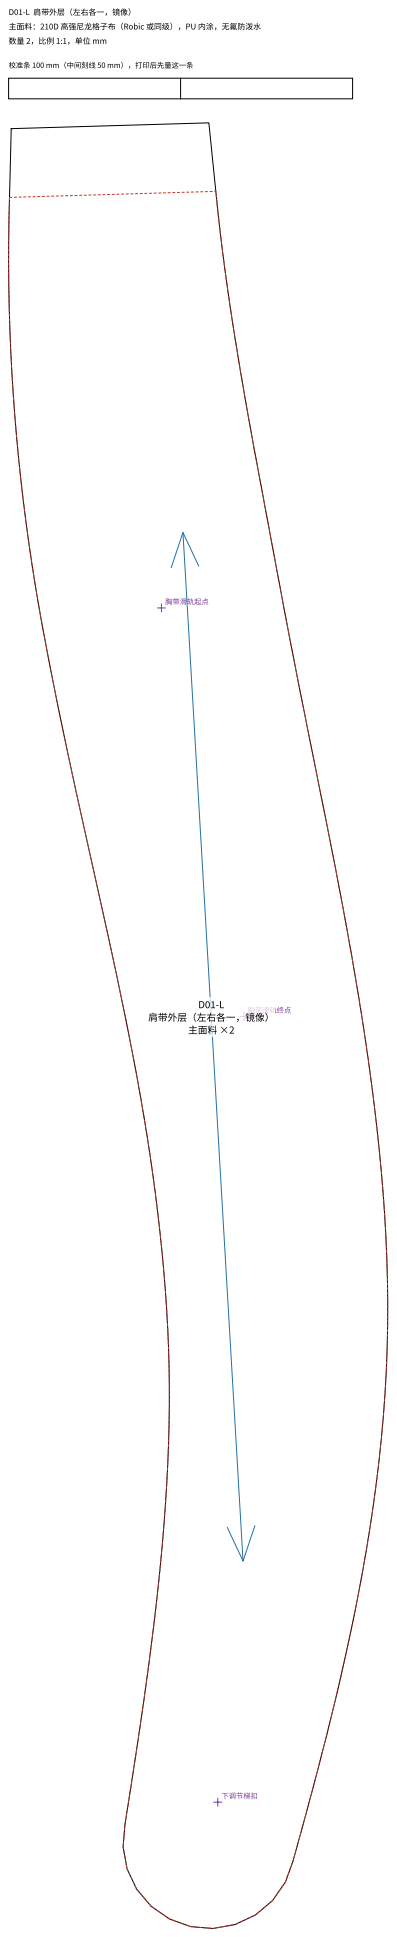
[picture p34: page 22]
胸带滑轨起点; 胸带滑轨终点; 下调节梯扣; 主面料 ×2

D01-L 肩带外层（左右各一，镜像）

主面料：210D 高强尼龙格子布（Robic 或同级），PU 内涂，无氟防泼水

肩带外层（左右各一，镜像）

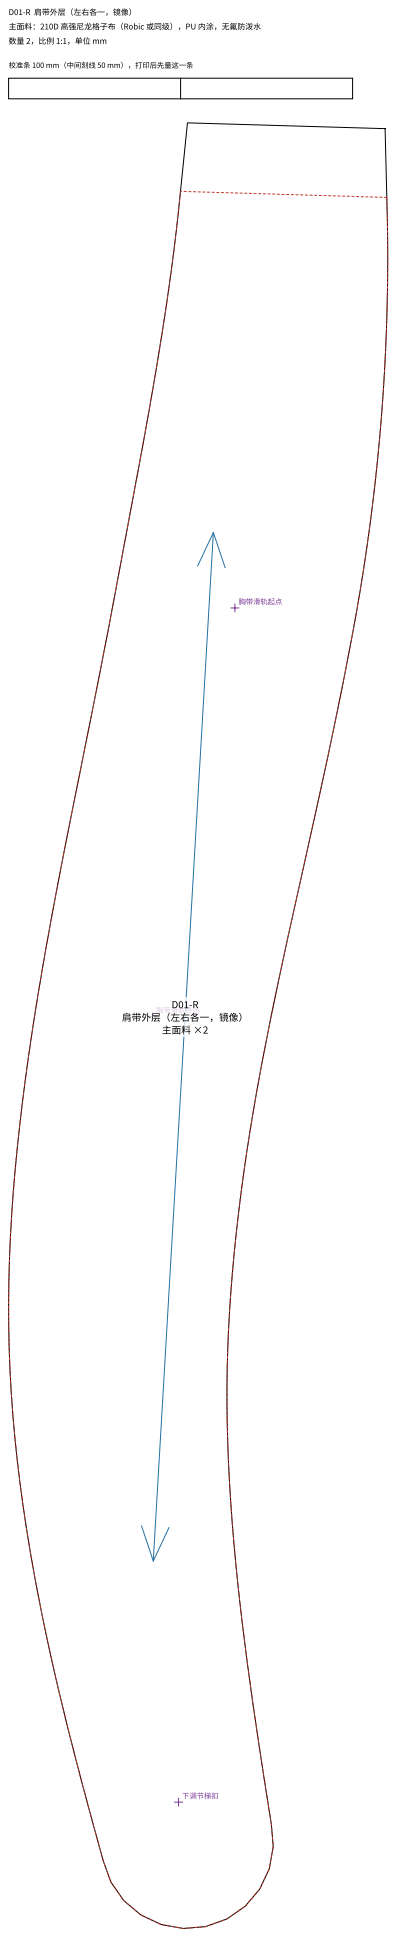
[picture p35: page 23]
胸带滑轨起点; 胸带滑轨终点; 下调节梯扣; 主面料 ×2

D01-R 肩带外层（左右各一，镜像）

主面料：210D 高强尼龙格子布（Robic 或同级），PU 内涂，无氟防泼水

肩带外层（左右各一，镜像）

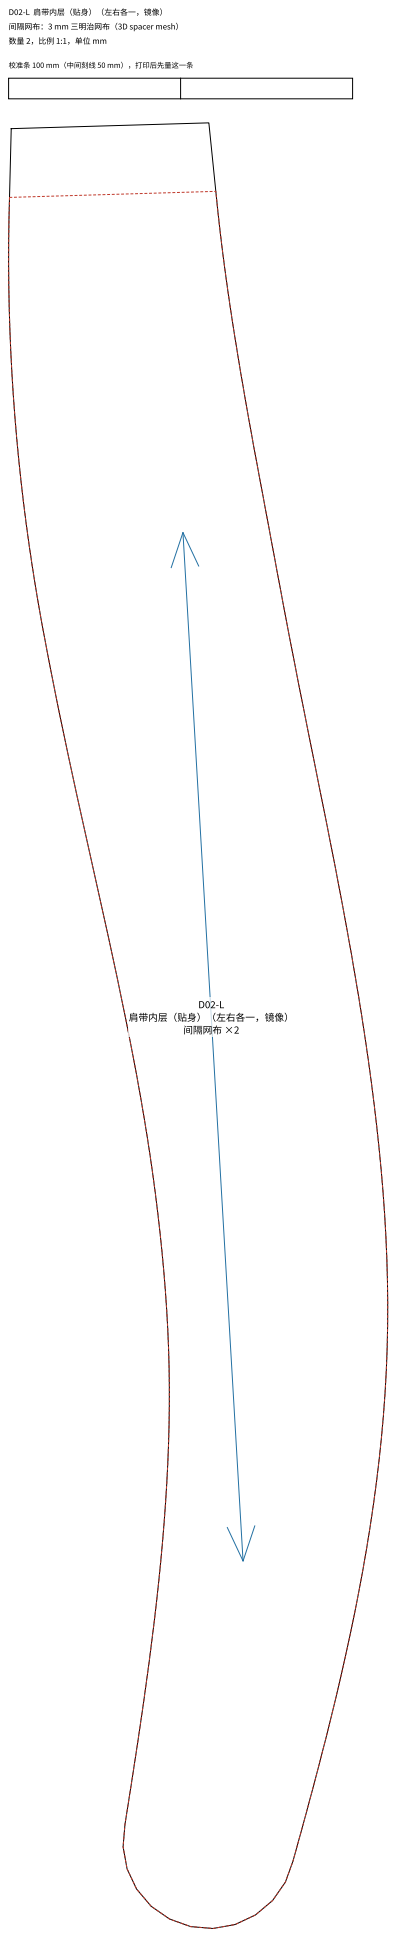
[picture p36: page 24]
间隔网布 ×2

D02-L 肩带内层（贴身）（左右各一，镜像）
间隔网布：3 mm 三明治网布（3D spacer mesh）

肩带内层（贴身）（左右各一，镜像）

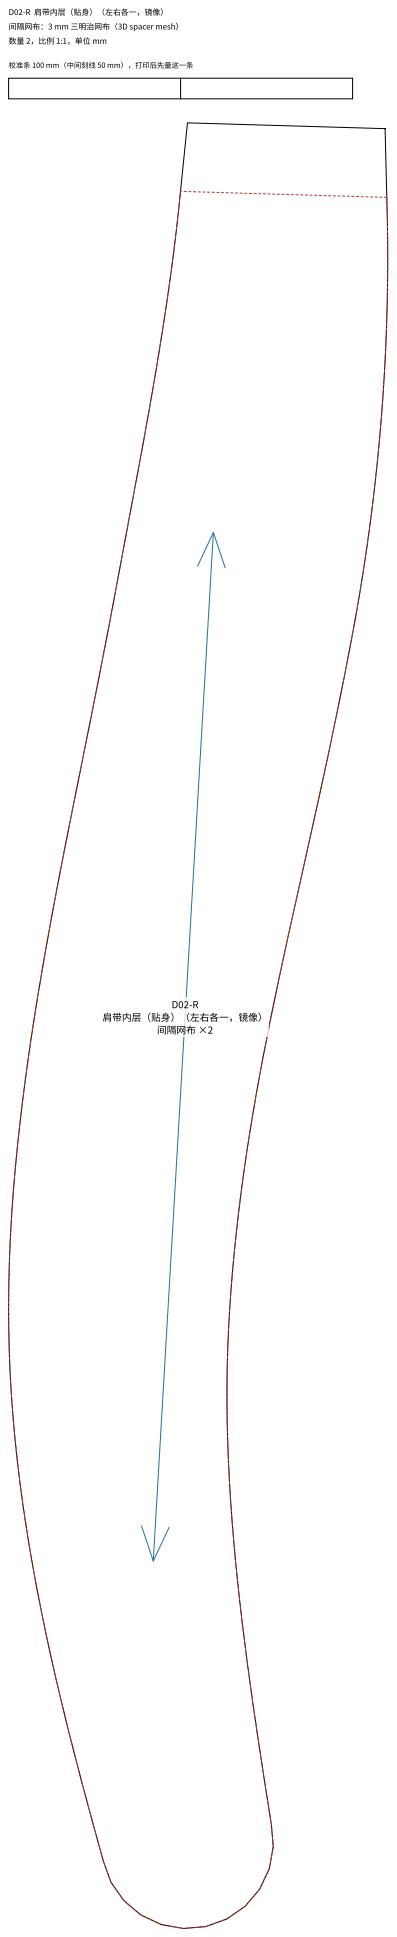
[picture p37: page 25]
间隔网布 ×2

D02-R 肩带内层（贴身）（左右各一，镜像）
间隔网布：3 mm 三明治网布（3D spacer mesh）

肩带内层（贴身）（左右各一，镜像）

D03-L 肩带泡棉（左右各一，镜像）

肩带泡棉：EVA 8 mm，约 60 kg/m³（密度打样时确认）

数量 2，比例 1:1，单位 mm

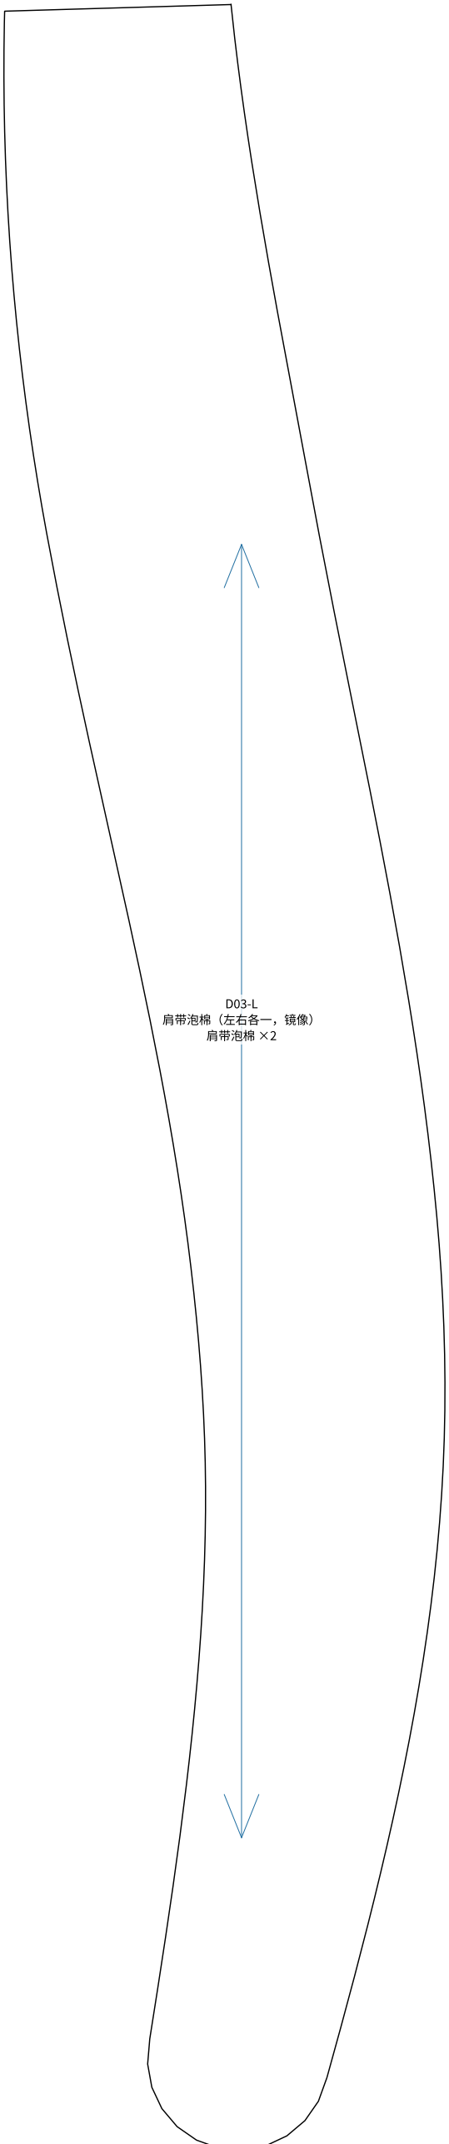
[picture p38: figure]
D03-L 肩带泡棉（左右各一，镜像） 肩带泡棉 ×2

D03-R 肩带泡棉（左右各一，镜像）

肩带泡棉：EVA 8 mm，约 60 kg/m³（密度打样时确认）

数量 2，比例 1:1，单位 mm

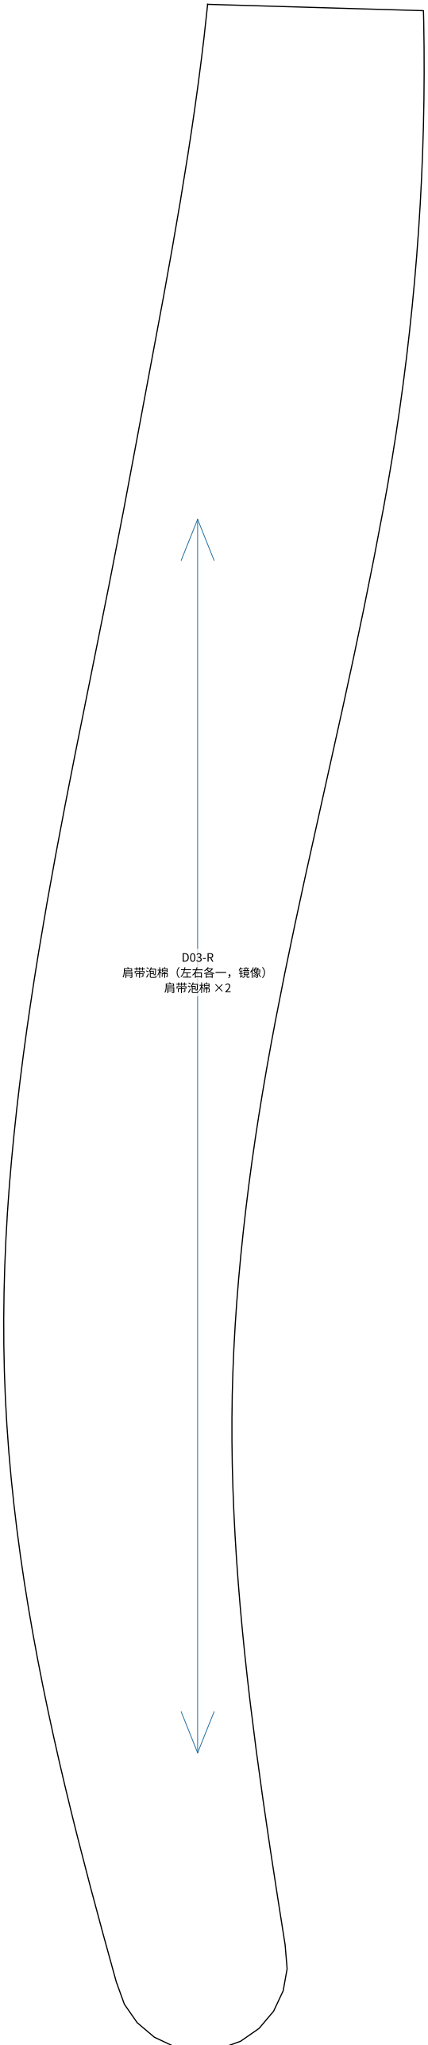
[picture p39: figure]
D03-R 肩带泡棉（左右各一，镜像） 肩带泡棉 ×2
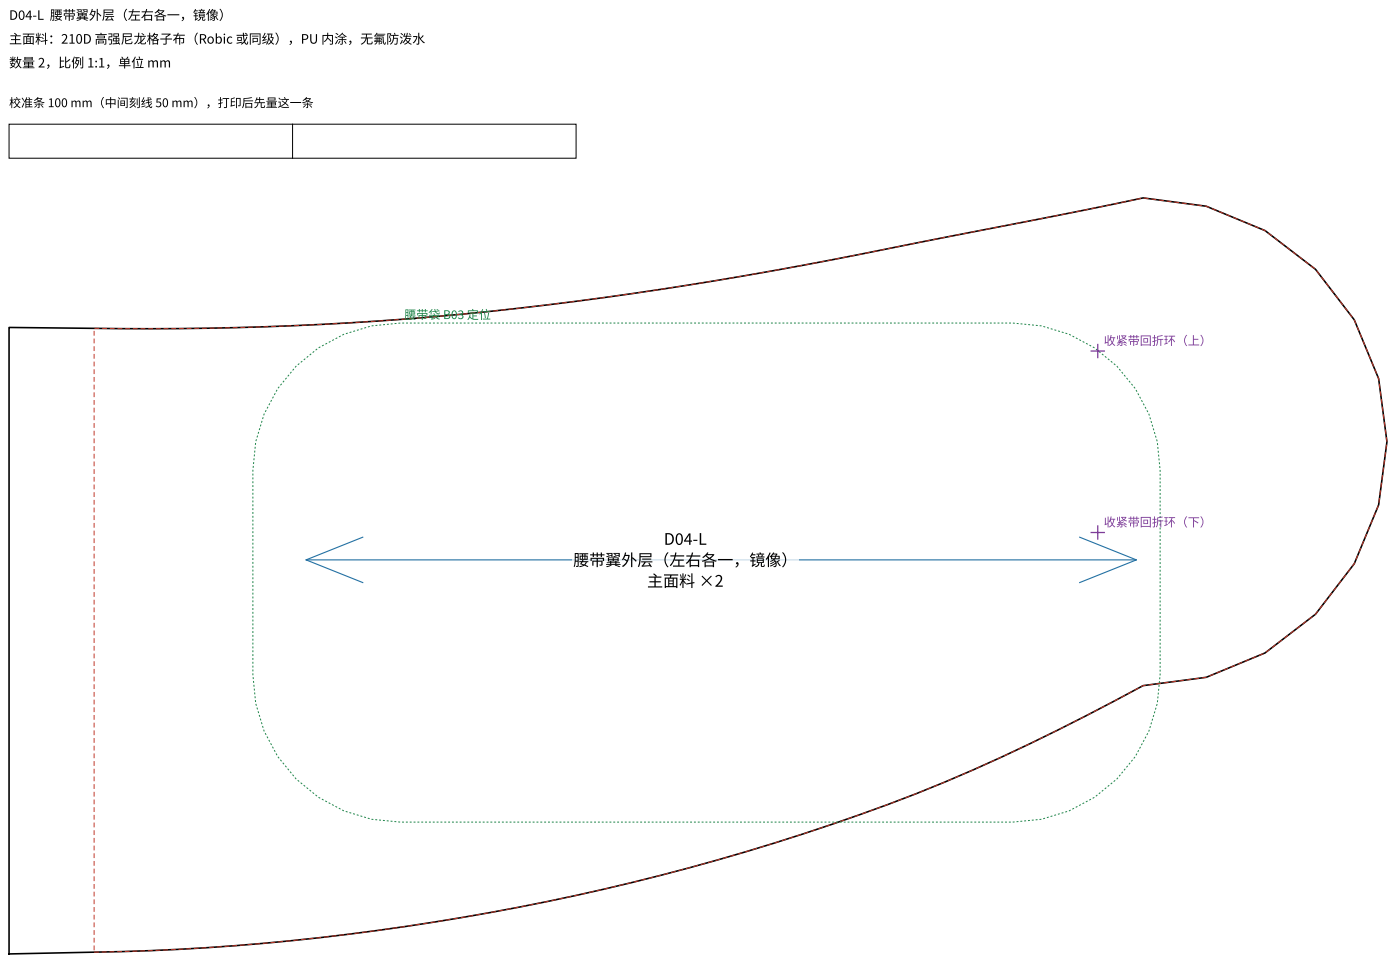
[picture p40: page 28]
收紧带回折环（上）; 收紧带回折环（下）; 腰带袋 B03 定位; 主面料 ×2

D04-L 腰带翼外层（左右各一，镜像）

主面料：210D 高强尼龙格子布（Robic 或同级），PU 内涂，无氟防泼水

校准条 100 mm（中间刻线 50 mm），打印后先量这一条

腰带翼外层（左右各一，镜像）

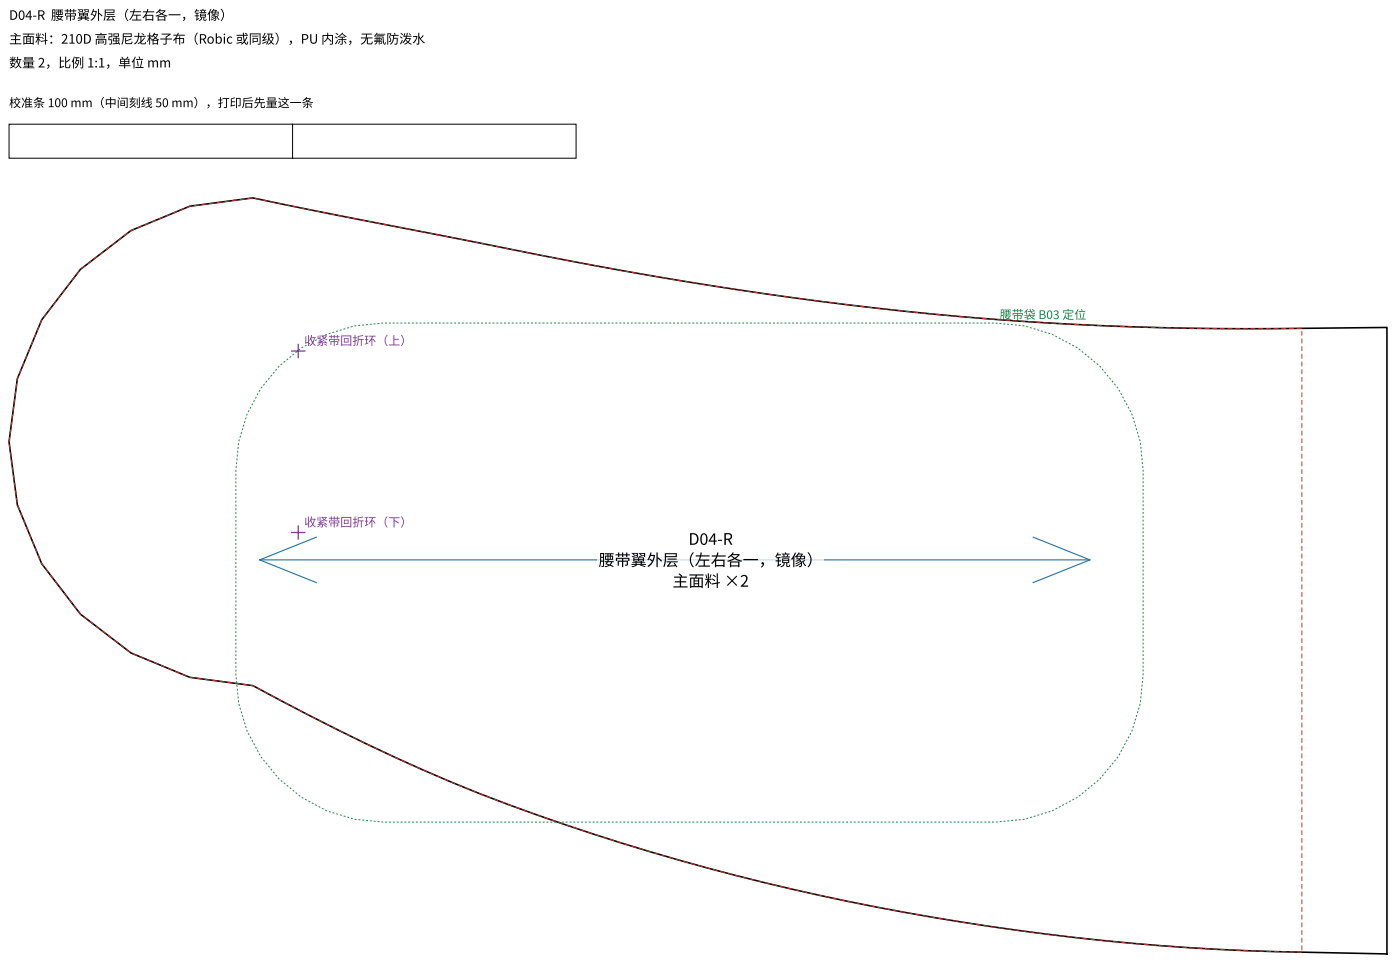
[picture p41: page 29]
收紧带回折环（上）; 收紧带回折环（下）; 腰带袋 B03 定位; 主面料 ×2

D04-R 腰带翼外层（左右各一，镜像）

主面料：210D 高强尼龙格子布（Robic 或同级），PU 内涂，无氟防泼水

校准条 100 mm（中间刻线 50 mm），打印后先量这一条

腰带翼外层（左右各一，镜像）

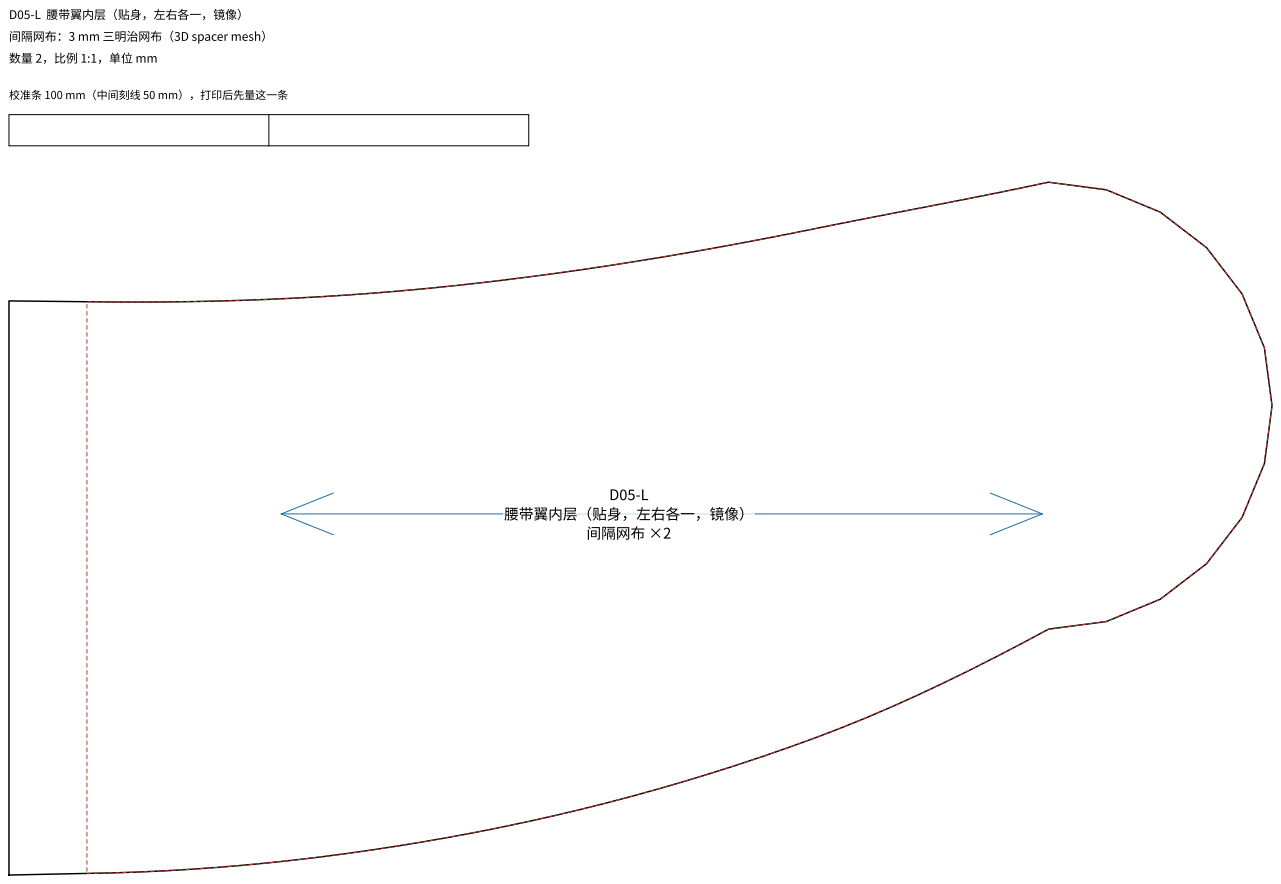
[picture p42: page 30]
间隔网布 ×2

D05-L 腰带翼内层（贴身，左右各一，镜像）
间隔网布：3 mm 三明治网布（3D spacer mesh）

校准条 100 mm（中间刻线 50 mm），打印后先量这一条

腰带翼内层（贴身，左右各一，镜像）

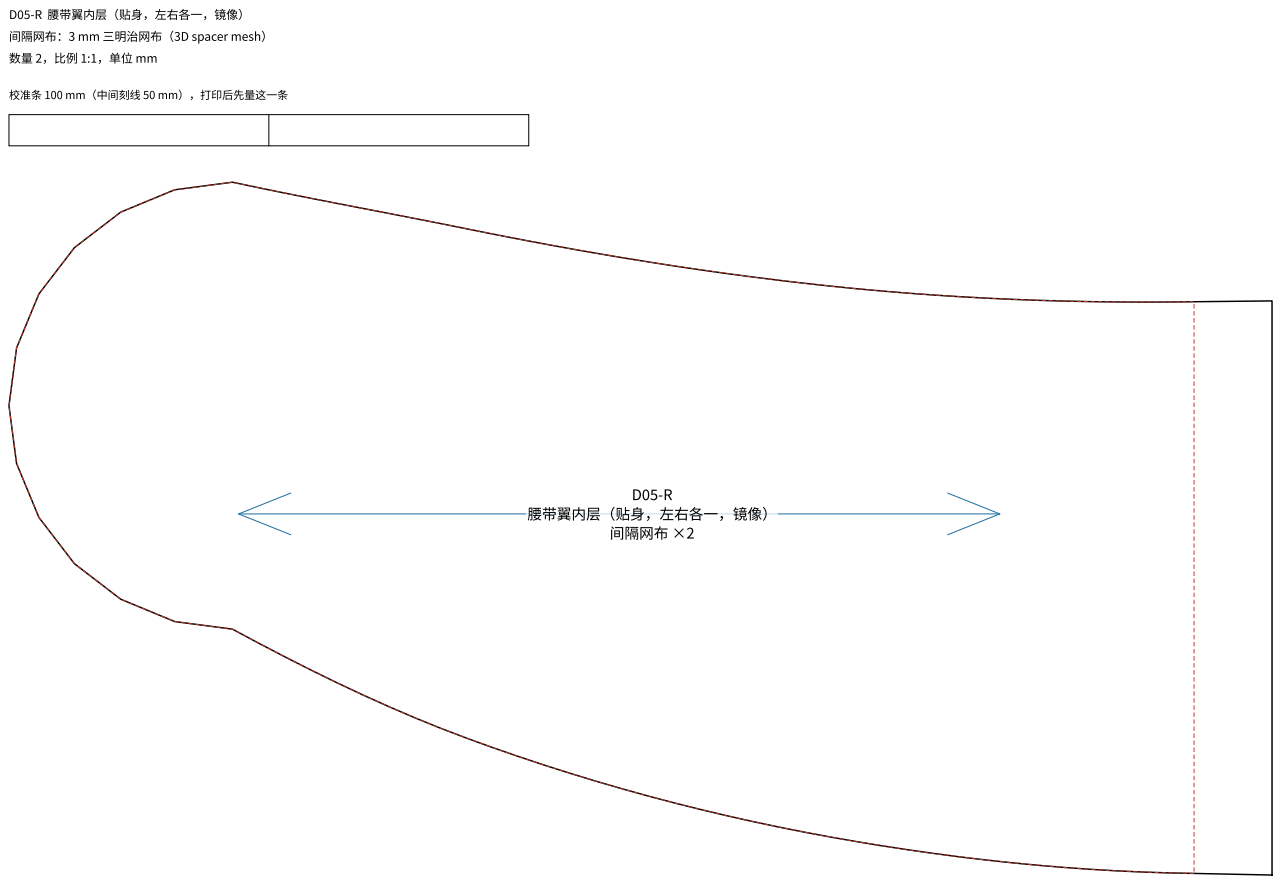
[picture p43: page 31]
间隔网布 ×2

D05-R 腰带翼内层（贴身，左右各一，镜像）
间隔网布：3 mm 三明治网布（3D spacer mesh）

校准条 100 mm（中间刻线 50 mm），打印后先量这一条

腰带翼内层（贴身，左右各一，镜像）

校准条 100 mm（中间刻线 50 mm），打印后先量这一条

D06-L 腰带翼泡棉（左右各一，镜像）

腰带泡棉：EVA 10 mm，约 90 kg/m³（密度打样时确认）

数量 2，比例 1:1，单位 mm

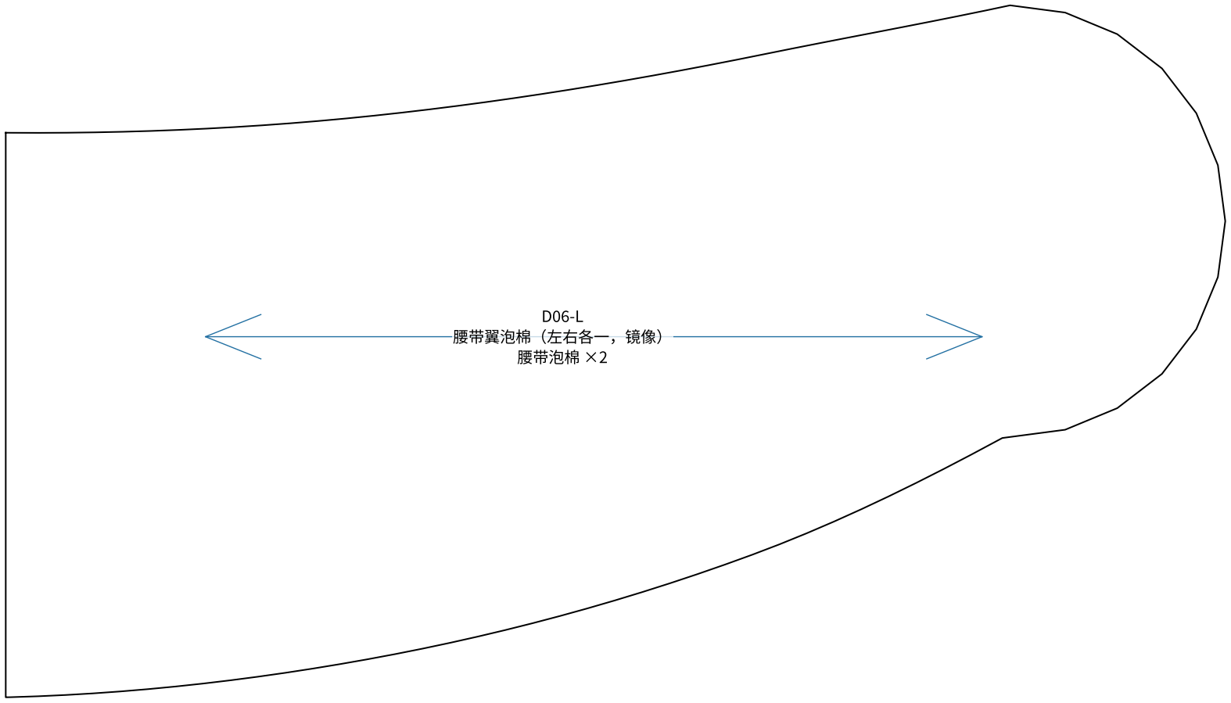
[picture p44: figure]
D06-L 腰带翼泡棉（左右各一，镜像） 腰带泡棉 ×2

校准条 100 mm（中间刻线 50 mm），打印后先量这一条

D06-R 腰带翼泡棉（左右各一，镜像）

腰带泡棉：EVA 10 mm，约 90 kg/m³（密度打样时确认）

数量 2，比例 1:1，单位 mm

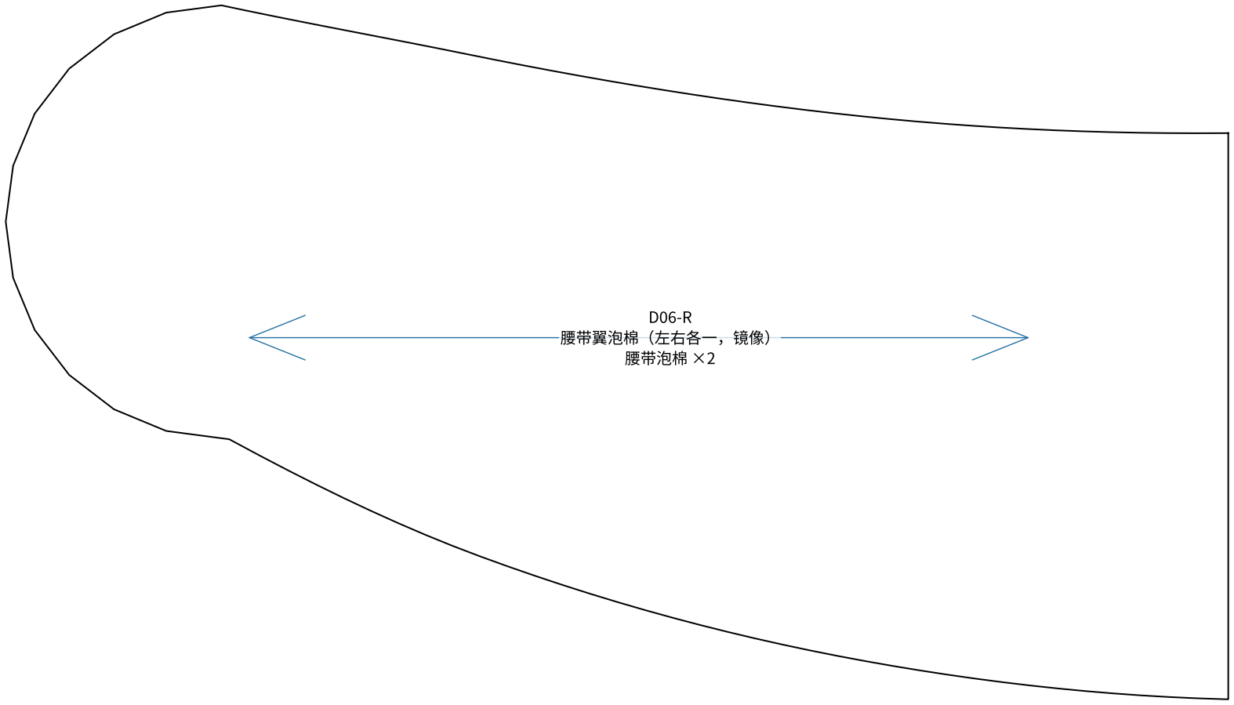
[picture p45: figure]
D06-R 腰带翼泡棉（左右各一，镜像） 腰带泡棉 ×2

校准条 100 mm（中间刻线 50 mm），打印后先量这一条

D07-L 腰带翼加强板（左右各一，镜像）

加强板：HDPE 板 1.0 mm

数量 2，比例 1:1，单位 mm

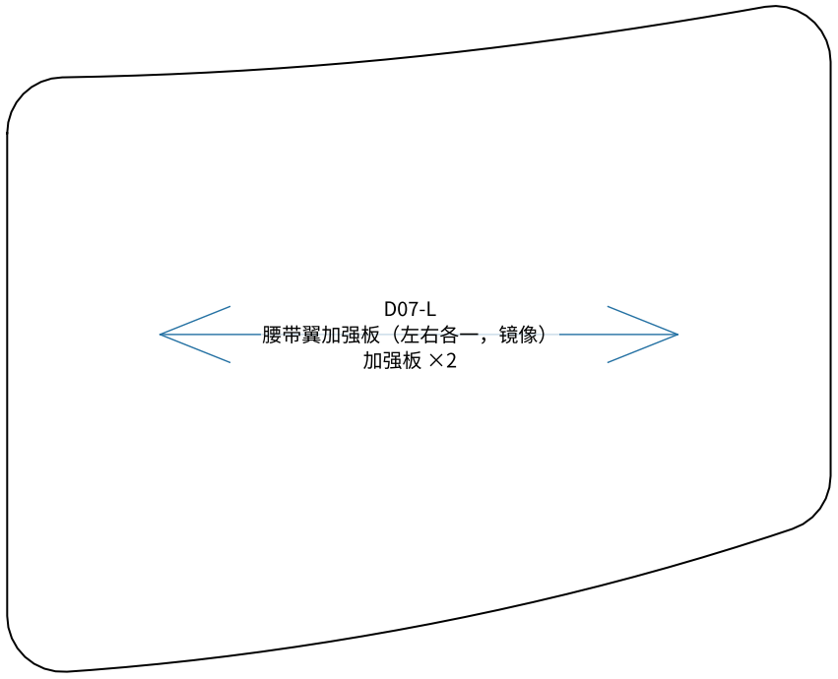
[picture p46: figure]
D07-L 腰带翼加强板（左右各一，镜像） 加强板 ×2

校准条 100 mm（中间刻线 50 mm），打印后先量这一条

D07-R 腰带翼加强板（左右各一，镜像）

加强板：HDPE 板 1.0 mm

数量 2，比例 1:1，单位 mm

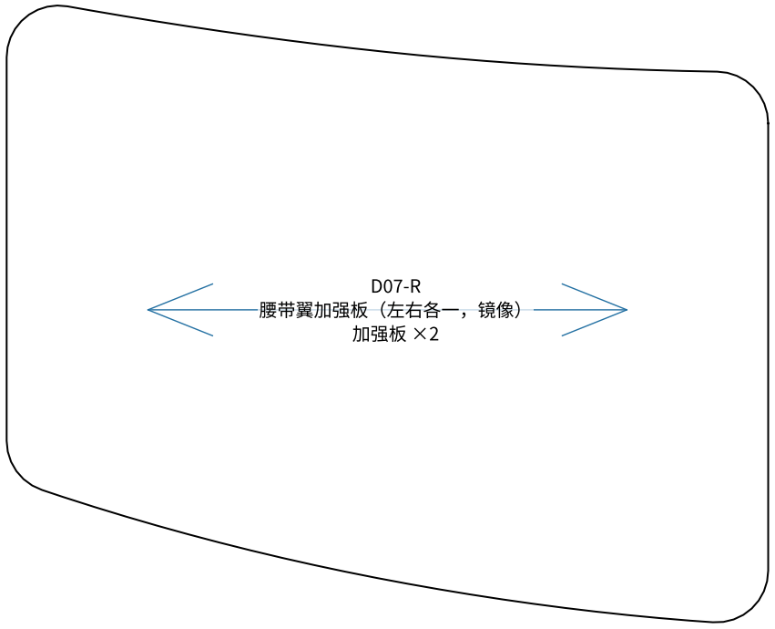
[picture p47: figure]
D07-R 腰带翼加强板（左右各一，镜像） 加强板 ×2

校准条 100 mm（中间刻线 50 mm），打印后先量这一条

D08 腰带中段套片（前后两层）

主面料：210D 高强尼龙格子布（Robic 或同级），PU 内涂，无氟防泼水

数量 2，比例 1:1，单位 mm

两层夹 D09 腰带背板。左右两端开口，插入腰带翼根部后车缝。

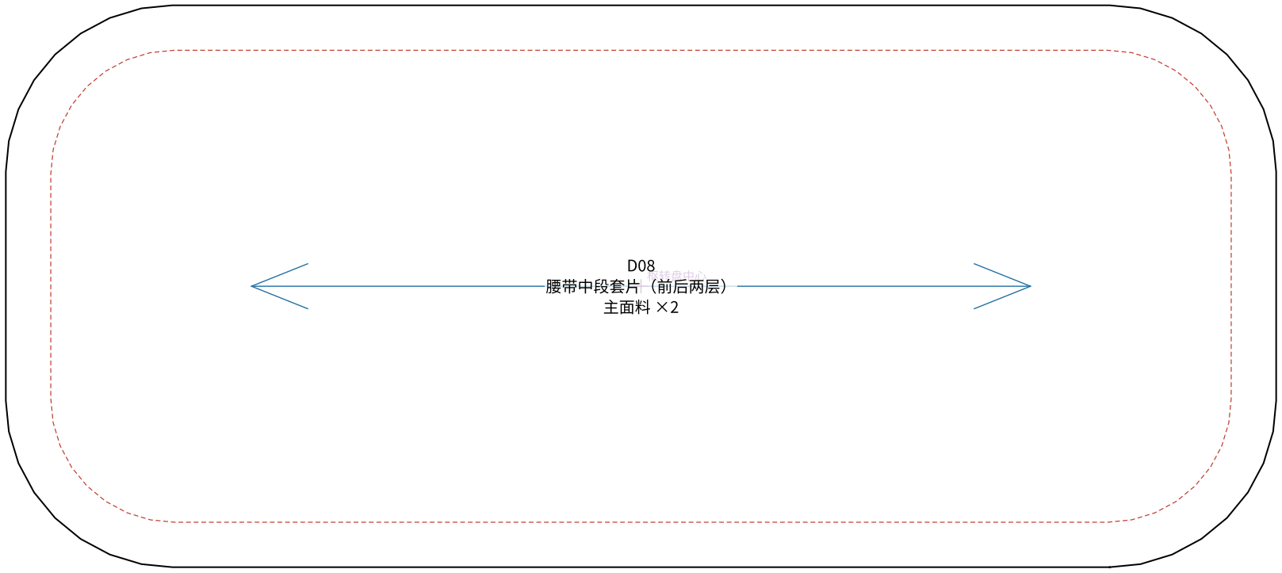
[picture p48: figure]
枢转盘中心 D08 腰带中段套片（前后两层） 主面料 ×2

校准条 100 mm（中间刻线 50 mm），打印后先量这一条

D09 腰带背板

加强板：HDPE 板 1.0 mm

数量 1，比例 1:1，单位 mm

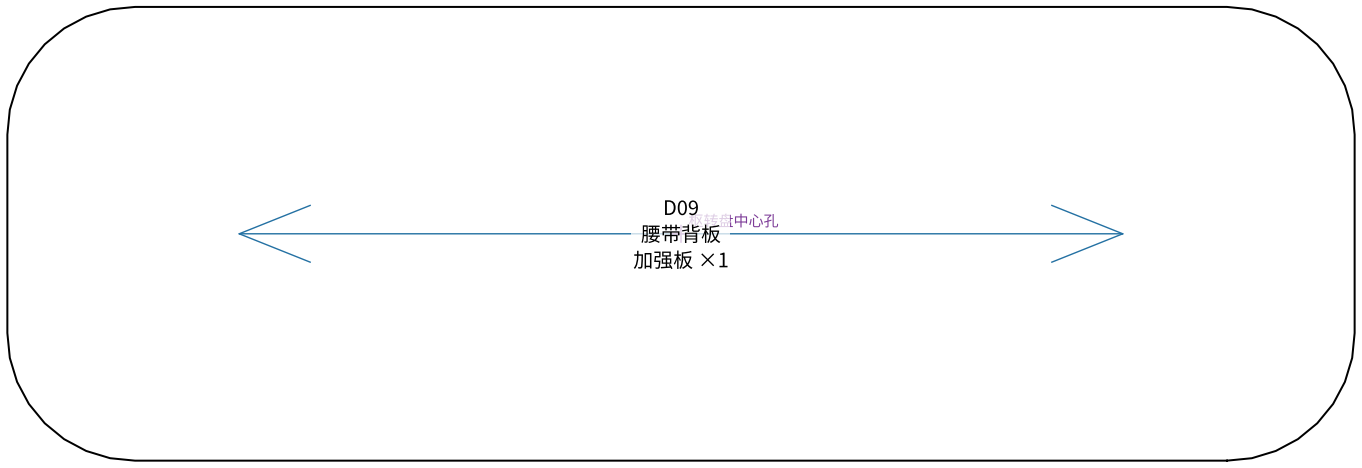
[picture p49: figure]
枢转盘中心孔 D09 腰带背板 加强板 ×1

校准条 100 mm（中间刻线 50 mm），打印后先量这一条

E01 联动座安装加强片

底料：420D 高强尼龙，PU 内涂

数量 1，比例 1:1，单位 mm

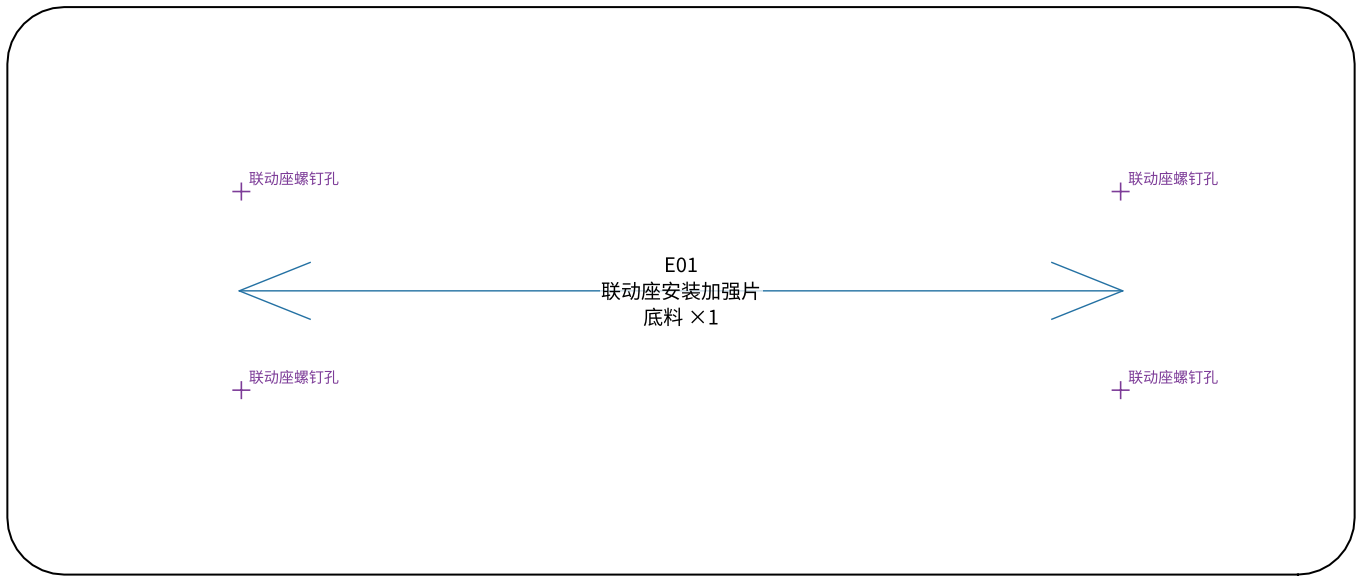
[picture p50: figure]
联动座螺钉孔; E01 联动座安装加强片 底料 ×1

校准条 100 mm（中间刻线 50 mm），打印后先量这一条

E04 联动座内衬板

背板：HDPE 板 1.5 mm

数量 1，比例 1:1，单位 mm

放在后幅内侧、背板套下方，与 E01 一起夹住后幅。孔位为占位，以联动座定稿图为准。

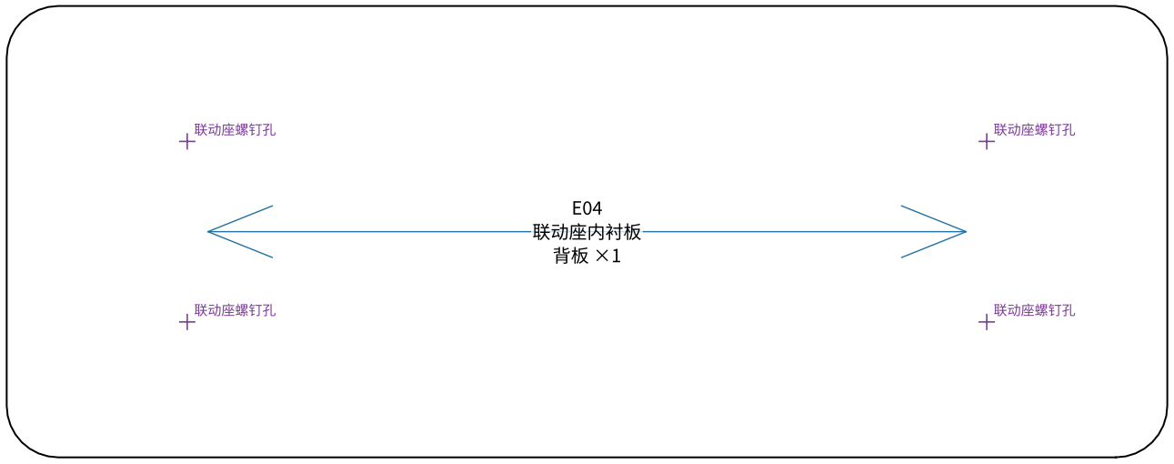
[picture p51: figure]
联动座螺钉孔; E04 联动座内衬板 背板 ×1

校准条 100 mm（中间刻线 50 mm），打印后先量这一条

E02 织带锚点加强片

耐磨加强料：TPU 复合加强料 0.8 mm（Hypalon 类）

数量 6，比例 1:1，单位 mm

上拉带锚点 ×2、上区张紧带锚点 ×2、下区张紧带锚点 ×2。

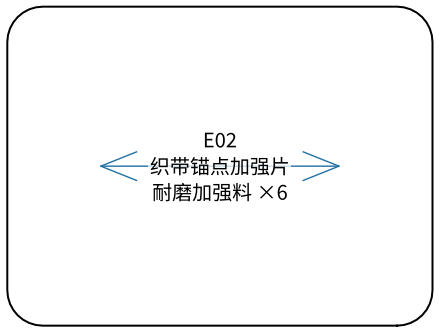
[picture p52: figure]
E02 织带锚点加强片 耐磨加强料 ×6

校准条 100 mm（中间刻线 50 mm），打印后先量这一条

E03 背架上角袋

耐磨加强料：TPU 复合加强料 0.8 mm（Hypalon 类）

数量 2，比例 1:1，单位 mm

套住 Y 型背架上横梁两端，杆端先套胶帽防异响。

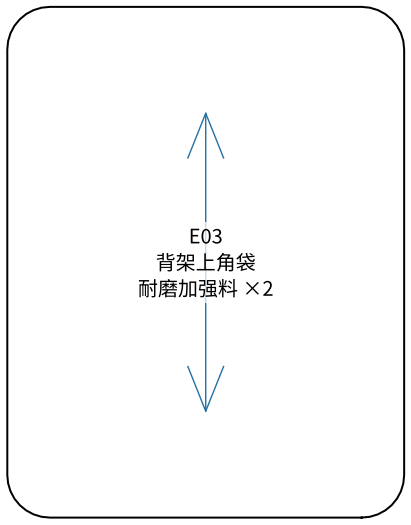
[picture p53: figure]
E03 背架上角袋 耐磨加强料 ×2
