wentingjie001-cmd/-/patent/A_invention_linkage_harness/claims.md

# 权利要求书（初稿）

> 发明名称：一种背包随动背负系统及背包
> 本文本同时用于发明专利与实用新型专利（同日申请，一案两请）。定稿前须由专利代理师根据检索结果调整独立权利要求的范围。
>
> **2026-11-12 提示：权利要求 1 需要重写后才能提交。** 补充检索发现已终止的 CN2800884Y（2005，"互动式平衡装置"）公开了"滚轮 + 固定轮 + 滑动带接两肩带 + 可锁紧或放开的开关"，与现在的权利要求 1 基本重合。建议把权利要求 13（腰带经枢转盘与联动座转动连接）和权利要求 9 中"下立杆插入联动座"的特征并入独立权利要求，详见 `docs/02_patent_landscape.md` 第 4 节。下面的条文暂未修改，等代理师检索后一并调整。

1. 一种背包随动背负系统，包括背架（2）、左肩带和右肩带（10）以及腰带（12），其特征在于，还包括联动座（6）、联动带（7）和锁止组件（8）；

所述联动座（6）固定于所述背架（2）的下部，位于背包底部朝向使用者一侧的中央；所述联动座（6）内设有沿左右方向间隔布置的第一滚轮和第二滚轮（63），以及连通所述第一滚轮与所述第二滚轮的导向通道（65）；所述联动座（6）的左右两端分别开设有出带口（66）；

所述联动带（7）穿过所述导向通道（65），并分别绕过所述第一滚轮和所述第二滚轮后从两个所述出带口（66）伸出，两个伸出端分别与所述左肩带和所述右肩带的下端连接；

所述锁止组件（8）设置于所述联动座（6）上，可在释放位置与锁止位置之间切换：在所述释放位置，所述联动带（7）可相对于所述联动座（6）往复移动，使所述左肩带与所述右肩带的下端此升彼降地联动；在所述锁止位置，所述锁止组件（8）将所述联动带（7）压紧于所述联动座（6）上，使所述联动带（7）相对于所述联动座（6）固定。

2. 根据权利要求1所述的背包随动背负系统，其特征在于，所述锁止组件（8）包括偏心凸轮（81）和与所述偏心凸轮（81）固定连接的扳手（82），所述偏心凸轮（81）通过轴耳（83）铰接于所述联动座（6）上；转动所述扳手（82）时，所述偏心凸轮（81）的凸轮面靠近或远离所述联动带（7），以将所述联动带（7）压紧于所述联动座（6）的壁面上或使所述联动带（7）释放。

3. 根据权利要求2所述的背包随动背负系统，其特征在于，所述扳手（82）连接有拉索，所述拉索的另一端引至所述腰带（12）上并连接拉手，通过拉动所述拉手可使所述锁止组件（8）在所述释放位置与所述锁止位置之间切换。

4. 根据权利要求1所述的背包随动背负系统，其特征在于，还包括回中组件，所述回中组件包括固定于所述联动带（7）中段的中位件（72）和两根弹性件（69）；所述联动座（6）上设有分别位于所述中位件（72）左右两侧的两个锚柱（68），两根所述弹性件（69）的一端分别连接于所述中位件（72），另一端分别连接于两个所述锚柱（68）；当所述联动带（7）偏离中位时，所述弹性件（69）对所述联动带（7）施加指向中位的回复力。

5. 根据权利要求1所述的背包随动背负系统，其特征在于，所述联动带（7）位于两个所述出带口（66）外侧的部分上分别设有限位块（71），所述限位块（71）的外形尺寸大于所述出带口（66）的开口尺寸，以限定所述联动带（7）向任一侧移动的最大行程。

6. 根据权利要求5所述的背包随动背负系统，其特征在于，所述限位块（71）可沿所述联动带（7）调节位置并锁定，所述最大行程为20 mm～50 mm。

7. 根据权利要求1所述的背包随动背负系统，其特征在于，所述联动座（6）包括相互扣合的前壳（61）和后壳（62），所述第一滚轮和所述第二滚轮（63）分别通过滚轮轴（64）支承于所述前壳（61）与所述后壳（62）之间，所述导向通道（65）形成于所述前壳（61）与所述后壳（62）的结合面处。

8. 根据权利要求1所述的背包随动背负系统，其特征在于，所述联动座（6）在主视方向上的外轮廓呈中部低、两端向上翘起的弧形；所述第一滚轮和所述第二滚轮（63）分别位于两个上翘端内，所述出带口（66）朝向斜上方且朝向外侧开设。

9. 根据权利要求1至8任一项所述的背包随动背负系统，其特征在于，所述背架（2）为Y型背架，包括上横梁（21）、两根侧臂（22）和下立杆（24）；两根所述侧臂（22）的上端分别与所述上横梁（21）的两端连接，两根所述侧臂（22）的下端汇合于汇合节点（23）；所述下立杆（24）的上端连接于所述汇合节点（23），下端插接于所述联动座（6）上的插座（67）内。

10. 根据权利要求9所述的背包随动背负系统，其特征在于，所述上横梁（21）在水平面内呈朝向使用者内凹的弧形，所述侧臂（22）在竖直面内呈S形，所述侧臂（22）位于腰部高度的部分朝向使用者凸出。

11. 根据权利要求1至8任一项所述的背包随动背负系统，其特征在于，还包括悬浮网面（3）、腰垫（4）和张紧调节组件（5）；所述悬浮网面（3）张设于所述背架（2）的上部朝向使用者的一侧，并与包体之间形成通风间隙；所述腰垫（4）独立于所述悬浮网面（3）设置于所述悬浮网面（3）的下方；所述张紧调节组件（5）包括连接所述悬浮网面（3）上缘与所述背架（2）上部的上区张紧带（51）及上区扣具（52），以及连接所述腰垫（4）与包体两侧的下区张紧带（53）及下区扣具（54）；所述悬浮网面（3）的张力与所述腰垫（4）的贴合压力相互独立地调节。

12. 根据权利要求11所述的背包随动背负系统，其特征在于，所述腰垫（4）由左右间隔设置的两块组成，两块之间形成竖向通风槽（41）。

13. 根据权利要求1至8任一项所述的背包随动背负系统，其特征在于，所述联动座（6）朝向使用者的一侧设有枢转盘（91），所述腰带（12）的腰带背板（92）通过所述枢转盘（91）与所述联动座（6）转动连接，转动轴线沿前后方向延伸，使所述腰带（12）可相对于所述背架（2）在使用者的冠状面内摆动。

14. 根据权利要求13所述的背包随动背负系统，其特征在于，所述枢转盘（91）与所述联动座（6）之间设有摆动限位结构，所述腰带（12）的摆动角度为±5°～±12°。

15. 根据权利要求1所述的背包随动背负系统，其特征在于，所述滚轮（63）为聚甲醛材料，所述联动带（7）为表面光滑的超高分子量聚乙烯扁平织带。

16. 一种背包，包括包体（1），其特征在于，还包括权利要求1至15任一项所述的背包随动背负系统。
