wentingjie001-cmd/-/patent/A_invention_linkage_harness/description.md

# 说明书（初稿）

## 一种背包随动背负系统及背包

### 技术领域

[0001] 本发明涉及户外用品技术领域，具体涉及一种可使肩带随使用者肩部运动而联动、并可在联动与固定两种状态之间切换的背包背负系统，以及具有该背负系统的背包。

### 背景技术

[0002] 徒步、轻装快速穿越等户外活动中，使用者行走时左右肩部交替上下起伏、肩部与髋部之间存在相对扭转。传统背包的左右肩带下端分别固定在包体两侧，肩带相对包体不能移动，行走时肩部的起伏被肩带约束，背包随之左右晃动，或肩颈肌肉需要持续用力对抗，长时间负重容易造成疲劳。

[0003] 现有技术中已有将左右肩带下端相互连接的方案，例如公开号为US2006/0131355A1的专利申请公开了一种背包，其包底由内层面板与外层面板之间形成通道，与两肩带连接的柔性件穿过该通道并可在通道内滑动，使两侧肩带可以此升彼降。但这类方案存在以下不足：（1）柔性件在面料通道或管体内为滑动摩擦，摩擦阻力随负重、潮湿、进入泥沙而明显增大，且面料通道容易磨损；（2）柔性件始终处于可滑动状态，在攀爬、下坡奔跑、通过狭窄地形等需要背包与躯干相对固定的场合，无法将背包切换为固定状态，背包易发生摆动；（3）柔性件没有回复中位的趋势，使用中容易偏向一侧，取下背包后两侧肩带长度不对称，需要重新调整；（4）柔性件伸出通道的角度随使用者背长变化，不同背长下的联动顺畅性不同。

[0004] 此外，现有悬浮网面背板通常只有一组张紧调节，背部通风间隙与腰部支撑贴合程度相互牵制；现有腰带通常与背架刚性连接或仅依靠面料弹性变形实现有限的活动，髋部侧摆受限。

### 发明内容

[0005] 本发明要解决的技术问题是：提供一种背包随动背负系统，使肩带能够以低阻力随肩部运动联动，并可在联动状态与固定状态之间快速切换；进一步地，使联动带具有回中趋势与限定的行程，并使背部通风与腰部支撑可分别调节、腰带可随髋部侧摆。

[0006] 为解决上述技术问题，本发明采用的技术方案是：一种背包随动背负系统，包括背架、左肩带、右肩带和腰带，还包括联动座、联动带和锁止组件。联动座固定于背架的下部，位于背包底部朝向使用者一侧的中央；联动座内设有沿左右方向间隔布置的第一滚轮和第二滚轮以及连通二者的导向通道，联动座左右两端分别开设出带口。联动带穿过导向通道，分别绕过两个滚轮后从两个出带口伸出，两伸出端分别与左肩带、右肩带的下端连接。锁止组件设置于联动座上，可在释放位置与锁止位置之间切换：在释放位置，联动带可相对联动座往复移动，左右肩带下端此升彼降地联动；在锁止位置，锁止组件将联动带压紧于联动座上，使其相对联动座固定。

[0007] 优选地，锁止组件包括偏心凸轮及与其固定连接的扳手，偏心凸轮通过轴耳铰接于联动座；转动扳手时，凸轮面靠近或远离联动带，以压紧或释放联动带。进一步地，扳手可连接拉索，拉索引至腰带上的拉手，使用者无需取下背包即可切换状态。

[0008] 优选地，还包括回中组件：联动带中段固定中位件，联动座上在中位件两侧设有锚柱，两根弹性件分别连接中位件与两锚柱；联动带偏离中位时，弹性件施加指向中位的回复力。

[0009] 优选地，联动带位于出带口外侧的部分设有限位块，限位块外形尺寸大于出带口开口尺寸，以限定联动带向任一侧移动的最大行程；限位块可沿联动带调节并锁定，最大行程优选20 mm～50 mm。

[0010] 优选地，联动座由相互扣合的前壳和后壳构成，滚轮通过滚轮轴支承于前后壳之间，导向通道形成于前后壳的结合面处。联动座的主视外轮廓呈中部低、两端上翘的弧形，两滚轮分别位于两上翘端内，出带口朝斜上方、朝外侧开设。

[0011] 优选地，背架为Y型背架，包括上横梁、两根侧臂和下立杆；两侧臂上端分别连接上横梁两端，下端汇合于汇合节点；下立杆上端连接汇合节点，下端插接于联动座上的插座内。上横梁在水平面内朝使用者内凹，侧臂在竖直面内呈S形且在腰部高度处朝使用者凸出。

[0012] 优选地，还包括悬浮网面、腰垫和张紧调节组件。悬浮网面张设于背架上部朝向使用者一侧，与包体之间形成通风间隙；腰垫独立设置于悬浮网面下方，由左右两块组成并在两块之间形成竖向通风槽；上区张紧带及上区扣具调节悬浮网面张力，下区张紧带及下区扣具调节腰垫贴合压力，两者相互独立。

[0013] 优选地，联动座朝向使用者一侧设有枢转盘，腰带的腰带背板通过枢转盘与联动座转动连接，转动轴线沿前后方向，使腰带可相对背架在使用者冠状面内摆动，摆动角度优选±5°～±12°。

[0014] 本发明还提供一种背包，包括包体及上述背包随动背负系统。

[0015] 与现有技术相比，本发明的有益效果是：

（1）联动带在刚性联动座内绕滚轮运动，以滚动摩擦代替面料通道内的滑动摩擦，联动阻力小且稳定，不受面料磨损、潮湿和泥沙影响；

（2）通过锁止组件，使用者可在"随动"与"固定"两种背负状态之间一键切换，平路长距离行走时肩部自由，攀爬、下坡奔跑时背包与躯干相对固定，兼顾舒适与稳定；

（3）回中组件使联动带保持在中位附近，背包不易偏向一侧，取下背包后两侧肩带自动恢复对称；限位块防止大幅度侧倾时一侧肩带完全放松；

（4）出带口方向由联动座上翘端确定，联动带的出带角度基本不随使用者背长变化，不同背长使用者均能获得顺畅的联动；

（5）Y型背架的上部两侧臂提供横向稳定，下部单根下立杆可作小幅扭转，允许肩部与髋部相对转动，并把载荷集中传递至联动座及腰带中心；

（6）上下两区独立张紧，背部通风间隙与腰部支撑互不牵制；

（7）肩部联动、锁止、腰带侧摆及背架插接集中于同一联动座组件，零件少，便于注塑量产和装配。

### 附图说明

[0016] 图1为本发明实施例背包的背面立体图；

[0017] 图2为本发明实施例背包的侧视图；

[0018] 图3为本发明实施例背负系统去除包体后，从包体一侧观察的视图；

[0019] 图4为本发明实施例联动座组件的立体分解图；

[0020] 图5为本发明实施例联动座的主视图，以虚线示出内部滚轮、导向通道及联动带的走向；

[0021] 图6为本发明实施例联动带联动原理示意图，其中（a）为中位状态，（b）为左肩带上提、右肩带下放状态；

[0022] 图7为本发明实施例锁止组件的状态示意图，其中（a）为释放位置，（b）为锁止位置。

[0023] 附图标记：

| 标记 | 名称 | 标记 | 名称 |
|---|---|---|---|
| 1 | 包体 | 62 | 后壳 |
| 2 | 背架 | 63 | 滚轮 |
| 21 | 上横梁 | 64 | 滚轮轴 |
| 22 | 侧臂 | 65 | 导向通道 |
| 23 | 汇合节点 | 66 | 出带口 |
| 24 | 下立杆 | 67 | 插座 |
| 3 | 悬浮网面 | 68 | 锚柱 |
| 4 | 腰垫 | 69 | 弹性件 |
| 41 | 通风槽 | 7 | 联动带 |
| 5 | 张紧调节组件 | 71 | 限位块 |
| 51 | 上区张紧带 | 72 | 中位件 |
| 52 | 上区扣具 | 8 | 锁止组件 |
| 53 | 下区张紧带 | 81 | 偏心凸轮 |
| 54 | 下区扣具 | 82 | 扳手 |
| 6 | 联动座 | 83 | 轴耳 |
| 61 | 前壳 | 9 | 腰带枢转组件 |
| 91 | 枢转盘 | 92 | 腰带背板 |
| 10 | 肩带 | 101 | 水壶袋 |
| 102 | 负重调节带 | 11 | 胸带 |
| 12 | 腰带 | 121 | 腰带袋 |
| 122 | 腰带扣 | 13 | 前弹力袋 |
| 14 | 压缩绳 | 15 | 侧袋 |
| 16 | 卷口 | | |

### 具体实施方式

[0024] 下面结合附图和实施例对本发明作进一步说明。为便于描述，以使用者正常背负背包时为参照：靠近使用者背部的一侧为"前侧（贴身侧）"，远离使用者背部、朝向包体的一侧为"后侧（包体侧）"，使用者的左右方向为"左右方向"。

[0025] 如图1和图2所示，本实施例的背包包括包体1和背包随动背负系统。包体1容积约40 L，顶部为卷口16，正面设有前弹力袋13及呈V形布置的两根压缩绳14，两侧设有侧袋15。

[0026] 如图3所示，背架2为Y型背架，由直径约6 mm的铝合金杆制成。上横梁21位于背部上方，在水平面内呈朝向使用者内凹的弧形；两根侧臂22的上端分别与上横梁21的两端连接，侧臂22在竖直面内呈S形，在腰部高度处朝使用者凸出约10 mm，以贴合腰椎前凸；两侧臂22的下端汇合于汇合节点23；汇合节点23下方连接直径约7 mm的下立杆24，下立杆24的下端插入联动座6顶部的插座67内，并以过盈配合或横销固定。

[0027] 悬浮网面3为三维间隔网布，外轮廓呈上宽、中窄、下部略宽的沙漏形，张设在背架2上部朝向使用者的一侧，与包体1之间形成约30 mm的通风间隙。悬浮网面3上缘经上区张紧带51连接至背架2上部两端，通过上区扣具52调节张紧带长度从而调节网面张力：张力增大，网面更绷，通风间隙增大。

[0028] 腰垫4位于悬浮网面3下方，由左右间隔设置的两块组成，两块之间形成竖向通风槽41，下立杆24位于通风槽41的后侧。腰垫4两侧经下区张紧带53连接至包体1两侧，通过下区扣具54调节，以调节腰垫4与使用者腰部的贴合压力。上区与下区张紧相互独立，使用者可在保持背部较大通风间隙的同时使腰部获得较紧的支撑。

[0029] 如图4和图5所示，联动座6位于背包底部贴身侧中央，宽约156 mm、高约46 mm、厚约28 mm，由前壳61和后壳62扣合而成，二者可采用超声波焊接或螺钉连接，材料可为玻纤增强尼龙。联动座6在主视方向上的外轮廓呈中部低、两端向上翘起的弧形（"微笑"形）。两个上翘端内各设置一个直径约14 mm的滚轮63，滚轮63由聚甲醛制成，通过直径4 mm的不锈钢滚轮轴64支承于前壳61与后壳62之间。前壳61与后壳62的结合面处形成连通两滚轮63下侧的导向通道65。联动座6左右两端各开设朝斜上方、朝外侧的出带口66。后壳62中部开设窗口，使导向通道65中段的联动带7从包体侧外露，以便设置下述中位件72及锁止组件8。

[0030] 联动带7为宽约20 mm、表面光滑的超高分子量聚乙烯扁平织带。联动带7穿过导向通道65，在两端分别从下方绕过滚轮63，再从出带口66斜向上伸出，两个伸出端分别经梯扣与左、右肩带10的下端连接。由于出带口66的方向由联动座6的上翘端确定，联动带7离开联动座6的角度基本不随使用者背长改变。

[0031] 如图6所示，联动带7中段固定有中位件72，联动座6后侧在中位件72的左右两侧设有锚柱68，两根弹性件69（如弹力绳）分别连接中位件72与两侧锚柱68。图6（a）为中位状态，两弹性件69张力相等；如图6（b）所示，当使用者左肩上提距离Δ时，联动带7沿滚轮63滚动移动，右肩带下端同步下放距离Δ，中位件72偏离中位，一侧弹性件69被拉长，对联动带7施加指向中位的回复力。弹性件69的刚度可为0.1 N/mm～0.3 N/mm。

[0032] 联动带7位于两个出带口66外侧的部分上分别设有限位块71，限位块71的外形尺寸大于出带口66的开口尺寸；当联动带7向一侧移动到最大行程时，限位块71抵靠出带口66，阻止其继续移动。限位块71可沿联动带7调节位置，最大行程可设定为20 mm～50 mm，本实施例约为35 mm。

[0033] 如图4和图7所示，锁止组件8包括偏心凸轮81及与之固定连接的扳手82，偏心凸轮81通过后壳62上的两个轴耳83铰接于联动座6的后侧（包体侧），其凸轮面经后壳62的窗口朝向导向通道65内的联动带7。如图7（a）所示，扳手82处于释放位置时，偏心凸轮81的小半径部分朝向联动带7，二者之间留有间隙，联动带7可自由移动；如图7（b）所示，将扳手82转动至锁止位置，偏心凸轮81的大半径部分将联动带7压紧在后壳62的壁面上，联动带7被固定，左右肩带不再联动，背包相当于传统固定式背负。偏心凸轮81的凸轮面可包覆热塑性弹性体以增大摩擦。作为可选方案，扳手82末端连接拉索，拉索沿包体侧面引至腰带12上的拉手，使用者无需取下背包即可单手切换。

[0034] 联动座6朝向使用者的一侧设有直径约40 mm的枢转盘91，腰带12的腰带背板92通过枢转盘91与联动座6转动连接，转动轴线沿前后方向。行走时一侧髋部上提，腰带12可相对背架2在使用者冠状面内左右摆动；枢转盘91与联动座6之间设有限位凸台和限位槽，将摆动角度限制在约±8°。腰带12两侧设有腰带袋121，前部由腰带扣122连接。

[0035] 使用方法：背上背包并扣好腰带12与胸带11后，平路行走时将扳手82置于释放位置，左右肩带10随肩部起伏联动，背包相对躯干保持稳定；进入攀爬或下坡奔跑等地形时，将扳手82置于锁止位置。可分别调节上区扣具52与下区扣具54，以获得合适的背部通风间隙与腰部支撑。

[0036] 以上所述仅为本发明的较佳实施例，并非对本发明的限制。在不脱离本发明构思的前提下，本领域技术人员所作的等同替换或变化，例如以导向块代替滚轮、以插销或卡齿结构代替偏心凸轮、背架采用其他杆件形状、将锁止组件设置于联动座的侧面等，均应落入本发明的保护范围。
