wentingjie001-cmd/-/cad/out/preview_a1/consistency.md

| 项目 | 3D 模型里的长度 (mm) | 裁片或下料长度 (mm) | 说明 |
|---|---|---|---|
| 主仓容积：四角等圆的理想截面（裁片的设计依据） | 36.6 L | — |  |
| 主仓容积：背板把后幅撑平后的截面（本模型，裁片宽度不变） | 34.4 L | — | 两个数都是几何估算，实际容积以样包灌装实测为准 |
| 肩带：3D 路径长（肩轭缝线到下端） | 511 | 511 | 裁片沿中线量 |
| 腰带翼：3D 路径长（含插入中段 15） | 245 | 243 |  |
| 卷口展平宽度：3D 卷口中线长 | 397 | 398 |  |
| W01 + W02 联动带和下调节带（半边：联动座出口到肩带下端） | 375 | 790 | 余量 415，够。W01 的一半扣掉座内约 80，再加一根 W02 |
| W03 上拉带 | 108 | 330 | 余量 222，够。 |
| W05 腰带收紧带（腰带翼尖到中扣，前拉式要回折一次） | 289 | 650 | 余量 361，够。路径长按两倍算 |
| W08 侧压缩带 | 206 | 420 | 余量 214，够。 |
| W09 上区张紧带 | 55 | 260 | 余量 205，够。 |
| W10 下区张紧带 | 43 | 300 | 余量 257，够。 |
| W13 V 形压缩绳（单根） | 252 | 340 | 余量 88，够。弹力绳，装配时略拉伸 |
