wentingjie001-cmd/-/cad/out/production/cut_list.md

| 编号 | 名称 | 材料 | 数量 | 裁片外形 宽×高 (mm) | 单片面积 (cm²) | 缝份 (mm) | 备注 |
|---|---|---|---|---|---|---|---|
| A01 | 后幅（贴背片） | M1 主面料 | 1 | 288 × 950 | 2613 | 10 / 50 | 面朝人体一侧为正面。联动座用 4 颗螺钉穿过 E01 加强片、后幅和 E04 内衬板固定。 |
| A02 | 前幅 | M1 主面料 | 1 | 288 × 966 | 2655 | 10 / 50 |  |
| A03 | 侧幅（左右各一，镜像） | M1 主面料 | 2 | 208 × 954 | 1827 | 10 / 50 | 后边与后幅缝合，前边与前幅缝合。侧压缩带在 z = 330 和 480 的刀口处夹入前、后两条缝。 |
| A04 | 包底 | M2 底料 | 1 | 236 × 156 | 370 | 10 |  |
| B01 | 前弹力袋 | M3 弹力料 | 1 | 272 × 371 | 936 | 0 / 10 | 袋身每侧比定位线宽 8 mm，缝合时把余量均匀吃进。 |
| B02 | 侧袋（左右各一，镜像） | M3 弹力料 | 2 | 267 × 286 | 749 | 10 / 25 | 袋口松紧带净长取侧幅该处宽度的 85%。 |
| B03 | 腰带袋面片 | M1 主面料 | 2 | 176 × 104 | 173 | 8 |  |
| B04 | 腰带袋围条 | M1 主面料 | 2 | 317 × 51 | 162 | 8 |  |
| B05 | 腰带袋拉链贴条 | M1 主面料 | 4 | 166 × 28 | 46 | 8 | 两条夹 5 号尼龙拉链，合计净宽 35。 |
| B06 | 水袋仓 | M10 里料 | 1 | 260 × 410 | 1066 | 10 / 20 |  |
| C01 | 背板（防鼓包） | M8 背板 | 1 | 240 × 460 | 1086 | 0 | 插入背板套，可抽出。 |
| C02 | 背板套 | M10 里料 | 1 | 288 × 520 | 1476 | 10 / 20 |  |
| C03 | 上区悬浮网 | M4 间隔网布 | 1 | 240 × 325 | 671 | 0 / 35 |  |
| C04 | 腰垫面片 | M4 间隔网布 | 2 | 108 × 134 | 139 | 8 |  |
| C05 | 腰垫围条 | M4 间隔网布 | 2 | 405 × 38 | 154 | 8 |  |
| C06 | 腰垫底片 | M1 主面料 | 2 | 108 × 134 | 139 | 8 |  |
| C07 | 腰垫泡棉芯 | M7 腰垫泡棉 | 2 | 90 × 116 | 102 | 0 |  |
| C08 | 肩轭（内外两层） | M1 主面料 | 2 | 208 × 126 | 236 | 8 | 两层夹 C09 加强板。背面中线缝一条带 G 钩的 25 mm 织带，挂入后幅梯带调背长。 |
| C09 | 肩轭加强板 | M9 加强板 | 1 | 180 × 98 | 159 | 0 |  |
| D01 | 肩带外层（左右各一，镜像） | M1 主面料 | 2 | 110 × 526 | 333 | 0 / 20 |  |
| D02 | 肩带内层（贴身）（左右各一，镜像） | M4 间隔网布 | 2 | 110 × 526 | 333 | 0 / 20 |  |
| D03 | 肩带泡棉（左右各一，镜像） | M5 肩带泡棉 | 2 | 102 × 498 | 278 | 0 |  |
| D04 | 腰带翼外层（左右各一，镜像） | M1 主面料 | 2 | 243 × 133 | 234 | 0 / 15 |  |
| D05 | 腰带翼内层（贴身，左右各一，镜像） | M4 间隔网布 | 2 | 243 × 133 | 234 | 0 / 15 |  |
| D06 | 腰带翼泡棉（左右各一，镜像） | M6 腰带泡棉 | 2 | 220 × 125 | 194 | 0 |  |
| D07 | 腰带翼加强板（左右各一，镜像） | M9 加强板 | 2 | 118 × 95 | 95 | 0 |  |
| D08 | 腰带中段套片（前后两层） | M1 主面料 | 2 | 226 × 100 | 218 | 8 | 两层夹 D09 腰带背板。左右两端开口，插入腰带翼根部后车缝。 |
| D09 | 腰带背板 | M9 加强板 | 1 | 190 × 64 | 119 | 0 |  |
| E01 | 联动座安装加强片 | M2 底料 | 1 | 190 × 80 | 151 | 0 |  |
| E04 | 联动座内衬板 | M8 背板 | 1 | 180 × 70 | 125 | 0 | 放在后幅内侧、背板套下方，与 E01 一起夹住后幅。孔位为占位，以联动座定稿图为准。 |
| E02 | 织带锚点加强片 | M11 耐磨加强料 | 6 | 60 × 45 | 27 | 0 | 上拉带锚点 ×2、上区张紧带锚点 ×2、下区张紧带锚点 ×2。 |
| E03 | 背架上角袋 | M11 耐磨加强料 | 2 | 56 × 72 | 40 | 0 | 套住 Y 型背架上横梁两端，杆端先套胶帽防异响。 |
