wentingjie001-cmd/-/cad/out/production/edge_table.md

| 裁片 | 边 | 净线长 (mm) | 缝份 (mm) | 做法 | 刀口数 |
|---|---|---|---|---|---|
| A01 | bottom | 216.4 | 10 | 缝合 + 包边 | 1 |
| A01 | right | 893.7 | 10 | 缝合 + 包边 | 7 |
| A01 | top | 244.2 | 50 | 卷口折边 25 + 25，内夹加强带 | 1 |
| A01 | left | 893.7 | 10 | 缝合 + 包边 | 7 |
| A02 | bottom | 216.4 | 10 | 缝合 + 包边 | 1 |
| A02 | right | 909.3 | 10 | 缝合 + 包边 | 7 |
| A02 | top | 244.2 | 50 | 卷口折边 25 + 25，内夹加强带 | 1 |
| A02 | left | 909.3 | 10 | 缝合 + 包边 | 7 |
| A03 | bottom | 136.4 | 10 | 缝合 + 包边 | 0 |
| A03 | front | 909.3 | 10 | 缝合 + 包边 | 7 |
| A03 | top | 154.2 | 50 | 卷口折边 25 + 25 | 0 |
| A03 | back | 893.7 | 10 | 缝合 + 包边 | 7 |
| A04 | back | 216.4 | 10 | 缝合 + 包边 | 1 |
| A04 | right | 136.4 | 10 | 缝合 + 包边 | 0 |
| A04 | front | 216.4 | 10 | 缝合 + 包边 | 1 |
| A04 | left | 136.4 | 10 | 缝合 + 包边 | 0 |
| B01 | bottom | 186.0 | 10 | 折入 10 车明线 | 1 |
| B01 | right | 363.0 | 10 | 折入 10 车明线 | 0 |
| B01 | top | 252.0 | 0 | 弹力包边带（预拉伸约 10%） | 1 |
| B01 | left | 363.0 | 10 | 折入 10 车明线 | 0 |
| B02 | bottom | 226.2 | 10 | 打两个 15 mm 对褶后缝合 | 2 |
| B02 | front | 252.7 | 10 | 夹入前侧缝 | 0 |
| B02 | top | 247.1 | 25 | 卷边 25，内穿 10 mm 松紧带 | 0 |
| B02 | back | 250.6 | 10 | 夹入后侧缝 | 0 |
| B03 | outline | 451.1 | 8 | 缝合 | 0 |
| B04 | outline | 672.2 | 8 | 缝合 | 0 |
| B05 | outline | 324.0 | 8 | 缝合 | 0 |
| B06 | bottom | 240.0 | 10 | 缝在背板套上 | 0 |
| B06 | right | 380.0 | 10 | 缝在背板套上 | 0 |
| B06 | top | 240.0 | 20 | 卷边 10 + 10 | 0 |
| B06 | left | 380.0 | 10 | 缝在背板套上 | 0 |
| C01 | outline | 1342.5 | 0 | 净裁，边缘去毛刺 | 0 |
| C02 | bottom | 261.6 | 10 | 缝在后幅 z = 120 | 0 |
| C02 | right | 490.3 | 10 | 夹入后侧缝 | 0 |
| C02 | top | 250.3 | 20 | 卷边 10 + 10，中间缝 25 mm 魔术贴 | 0 |
| C02 | left | 490.3 | 10 | 夹入后侧缝 | 0 |
| C03 | bottom | 196.0 | 0 | 包边 | 0 |
| C03 | right | 293.4 | 0 | 包边 | 0 |
| C03 | top | 236.0 | 35 | 折 35 做横梁套管 | 0 |
| C03 | left | 293.4 | 0 | 包边 | 0 |
| C04 | outline | 388.9 | 8 | 缝合 | 0 |
| C05 | outline | 821.8 | 8 | 缝合 | 0 |
| C06 | outline | 388.9 | 8 | 缝合 | 0 |
| C07 | outline | 382.6 | 0 | 净裁 | 0 |
| C08 | outline | 546.6 | 8 | 缝合 | 0 |
| C09 | outline | 508.6 | 0 | 净裁 | 0 |
| D01 | outline | 1050.3 | 0 | 三层合缝后包边 | 0 |
| D01 | top | 60.0 | 20 | 插入肩轭 20 车缝 | 0 |
| D02 | outline | 1050.3 | 0 | 三层合缝后包边 | 0 |
| D02 | top | 60.0 | 20 | 插入肩轭 20 车缝 | 0 |
| D03 | outline | 1082.1 | 0 | 净裁 | 0 |
| D04 | outline | 514.3 | 0 | 三层合缝后包边 | 0 |
| D04 | root | 110.0 | 15 | 插入腰带中段 15 车缝 | 0 |
| D05 | outline | 514.3 | 0 | 三层合缝后包边 | 0 |
| D05 | root | 110.0 | 15 | 插入腰带中段 15 车缝 | 0 |
| D06 | outline | 595.6 | 0 | 净裁 | 0 |
| D07 | outline | 385.5 | 0 | 净裁 | 0 |
| D08 | outline | 550.0 | 8 | 缝合 | 0 |
| D09 | outline | 476.9 | 0 | 净裁 | 0 |
| E01 | outline | 526.2 | 0 | 热切净裁 | 0 |
| E04 | outline | 486.2 | 0 | 净裁 | 0 |
| E02 | outline | 201.4 | 0 | 净裁 | 0 |
| E03 | outline | 245.6 | 0 | 净裁，三边车缝 | 0 |
