wentingjie001-cmd/-/cad/out/production/pom.md

| 代号 | 测量部位 | 尺寸 (mm) | 公差 (mm) |
|---|---|---|---|
| P01 | 包体高度：包底缝到卷口线 | 640 | ±8 |
| P02 | 裁片总高：包底缝到卷口顶边 | 890 | ±8 |
| P03 | 后幅最大净宽 | 268 | ±5 |
| P04 | 侧幅最大净宽（包体厚度方向） | 188 | ±5 |
| P05 | 包底净尺寸 宽 × 深 | 216 × 136 | ±4 |
| P06 | 装满后外形 宽 × 厚（最大截面） | 300 × 220 | ±10 |
| P07 | 卷口展平宽度 | 398 | ±5 |
| P08 | 肩带垫长（肩轭缝线到下端） | 486 | ±5 |
| P09 | 肩带最宽处 | 70 | ±3 |
| P10 | 腰带翼垫长（单侧，根部缝线到尖端） | 228 | ±5 |
| P11 | 腰带翼根部高度 | 110 | ±3 |
| P12 | 腰带垫总长（中段 210 + 两翼） | 666 | ±10 |
| P13 | 背长调节行程（5 档，档距 25） | 100 | ±3 |
| P14 | 前弹力袋 口宽 × 高 | 252 × 363 | ±5 |
| P15 | 侧袋高度 | 250 | ±5 |
| P16 | 腰带袋 长 × 高 × 厚 | 160 × 88 × 35 | ±3 |
| P17 | 悬浮网 上宽 / 腰宽 / 高 | 236 / 176 / 290 | ±4 |
| P18 | 背板 宽 × 高 | 240 × 460 | ±2 |
