wentingjie001-cmd/-/cad/out/production/seam_check.md

| 缝 | 边 A | 长 A (mm) | 边 B | 长 B (mm) | 设计吃量 (mm) | 误差 (mm) | 结果 |
|---|---|---|---|---|---|---|---|
| 后幅侧边 ↔ 侧幅后边（左右各一条） | A01.right | 893.7 | A03.back | 893.7 | 0 | -0.00 | 合格 |
| 前幅侧边 ↔ 侧幅前边（左右各一条） | A02.right | 909.3 | A03.front | 909.3 | 0 | -0.00 | 合格 |
| 后幅下边 ↔ 包底后边 | A01.bottom | 216.4 | A04.back | 216.4 | 0 | +0.00 | 合格 |
| 前幅下边 ↔ 包底前边 | A02.bottom | 216.4 | A04.front | 216.4 | 0 | +0.00 | 合格 |
| 侧幅下边 ↔ 包底侧边 | A03.bottom | 136.4 | A04.right | 136.4 | 0 | +0.00 | 合格 |
| 卷口：后幅上边 ↔ 前幅上边（卷口两半等宽） | A01.top | 244.2 | A02.top | 244.2 | 0 | +0.00 | 合格 |
| 前袋侧边 ↔ 前幅定位线 | B01.right | 363.0 | A02 定位线 | 363.0 | 0 | +0.00 | 合格 |
| 前袋下边 ↔ 前幅定位线下边（两侧各吃 8） | B01.bottom | 186.0 | A02 定位线 | 170.0 | 16 | +0.00 | 合格 |
| 侧袋后边 ↔ 侧幅后边 z40–290 | B02.back | 250.6 | A03.back 段 | 250.6 | 0 | +0.00 | 合格 |
| 侧袋前边 ↔ 侧幅前边 z40–290 | B02.front | 252.7 | A03.front 段 | 252.7 | 0 | +0.00 | 合格 |
| 侧袋下边 ↔ 侧幅 z40 横线（两个对褶共收 60） | B02.bottom | 226.2 | A03 z40 横线 | 166.2 | 60 | +0.00 | 合格 |
| 腰带袋面片周长 ↔ 围条 + 拉链段 | B03 周长 | 451.1 | B04 + 拉链 | 451.1 | 0 | +0.00 | 合格 |
| 背板套侧边 ↔ 后幅侧边 z120–610 | C02.right | 490.3 | A01.right 段 | 490.3 | 0 | -0.00 | 合格 |
| 腰垫面片周长 ↔ 围条长 | C04 周长 | 388.9 | C05 长 | 388.9 | 0 | +0.00 | 合格 |
| 肩带外层周长 ↔ 内层周长 | D01 | 1110.3 | D02 | 1110.3 | 0 | +0.00 | 合格 |
| 腰带翼外层周长 ↔ 内层周长 | D04 | 624.3 | D05 | 624.3 | 0 | +0.00 | 合格 |
