wentingjie001-cmd/-/cad/out/production/weight_estimate.md

| 项目 | 计算 | 重量 (g) |
|---|---|---|
| M1 主面料 | 1.210 m² × 120 g/m² | 145 |
| M2 底料 | 0.052 m² × 220 g/m² | 11 |
| M3 弹力料 | 0.243 m² × 200 g/m² | 49 |
| M4 间隔网布 | 0.239 m² × 260 g/m² | 62 |
| M5 肩带泡棉 | 0.056 m² × 480 g/m² | 27 |
| M6 腰带泡棉 | 0.039 m² × 900 g/m² | 35 |
| M7 腰垫泡棉 | 0.020 m² × 1320 g/m² | 27 |
| M8 背板 | 0.121 m² × 1425 g/m² | 173 |
| M9 加强板 | 0.047 m² × 950 g/m² | 44 |
| M10 里料 | 0.254 m² × 70 g/m² | 18 |
| M11 耐磨加强料 | 0.024 m² × 900 g/m² | 22 |
| W01 联动带 | 0.90 m × 11 g/m | 10 |
| W02 肩带下调节带 | 0.84 m × 11 g/m | 9 |
| W03 上拉带（load lifter） | 0.66 m × 8 g/m | 5 |
| W04 胸带 | 0.38 m × 8 g/m | 3 |
| W05 腰带收紧带 | 1.30 m × 14 g/m | 18 |
| W06 卷口加强带 | 0.80 m × 11 g/m | 9 |
| W07 卷口侧扣带 | 0.40 m × 11 g/m | 4 |
| W08 侧压缩带 | 1.68 m × 8 g/m | 13 |
| W09 上区张紧带 | 0.52 m × 11 g/m | 6 |
| W10 下区张紧带 | 0.60 m × 11 g/m | 7 |
| W11 背长调节梯带 | 0.33 m × 14 g/m | 5 |
| W12 提手 | 0.26 m × 11 g/m | 3 |
| W13 V 形压缩绳 | 0.68 m × 6 g/m | 4 |
| W14 回中弹性绳 | 0.24 m × 6 g/m | 1 |
| W15 内缝包边带 | 4.53 m × 4 g/m | 18 |
| W16 外露包边带 | 4.37 m × 4 g/m | 17 |
| W17 侧袋口松紧带 | 0.32 m × 5 g/m | 2 |
| 塑料扣具、拉链、G 钩、螺钉 | 假定值 | 90 |
| 联动座总成（概念值，见 docs/03） | 假定值 | 70 |
| Y 型背架（概念值，见 docs/03） | 假定值 | 120 |
| 缝线、标签、胶帽等 | 假定值 | 20 |
| 合计 |  | 1047 |
