wentingjie001-cmd/-/cad/out/schematics/fig7_lock_states.pdf

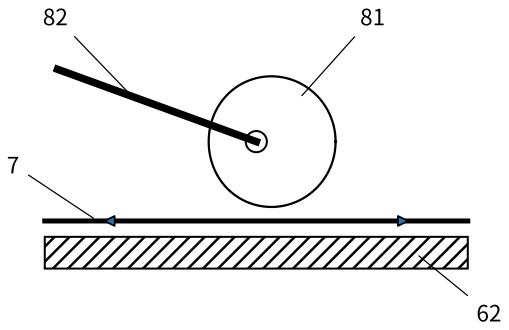
[picture p54: figure]

(a)

62

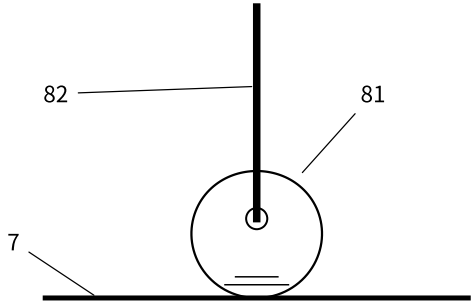
[picture p55: figure]

(b)
