wentingjie001-cmd/-/cad/out/design/03_linkage_hub/front.pdf

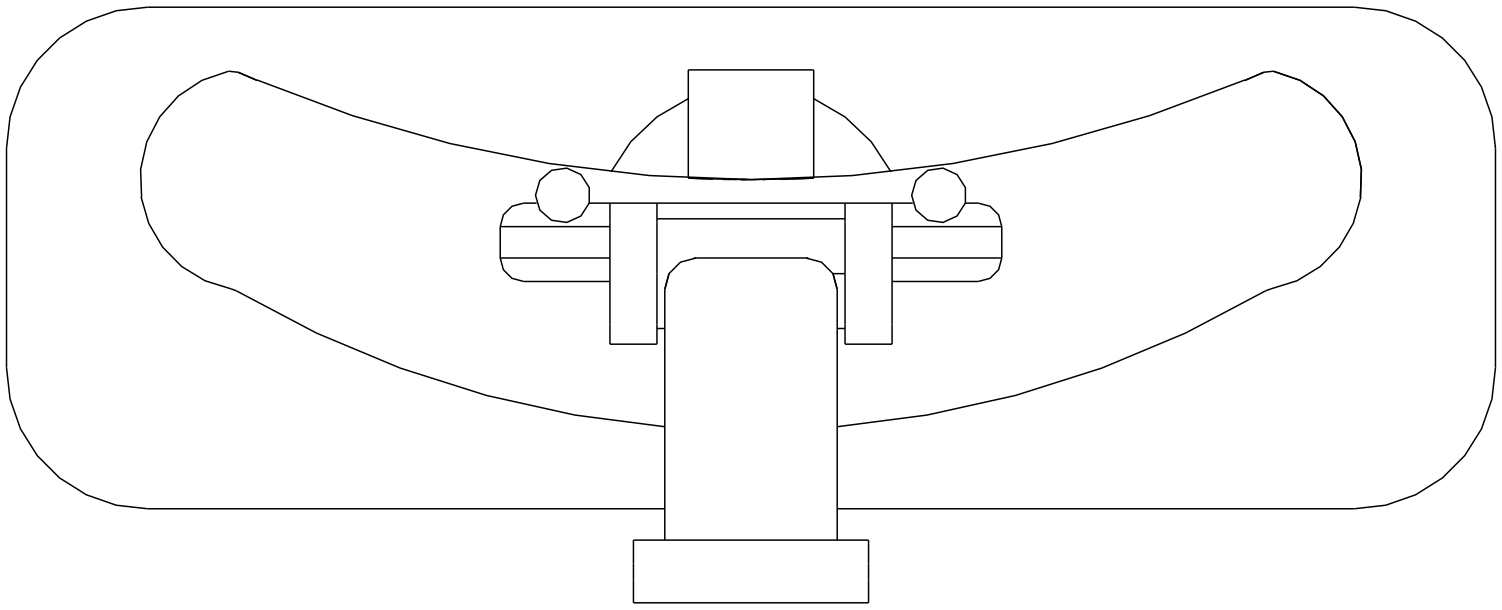
[picture p56: figure]

主视图
