wentingjie001-cmd/-/cad/out/design/03_linkage_hub/left.pdf

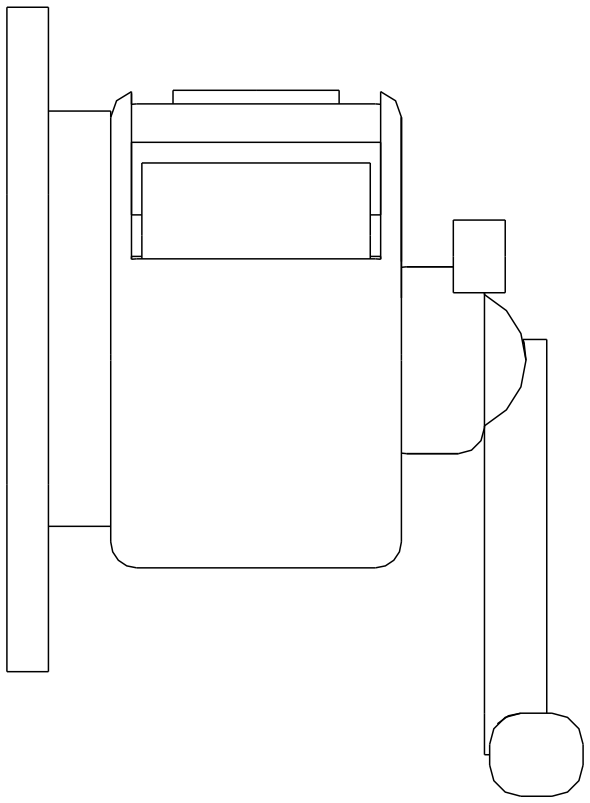
[picture p57: figure]

左视图
