wentingjie001-cmd/-/cad/out/design/03_linkage_hub/rear.pdf

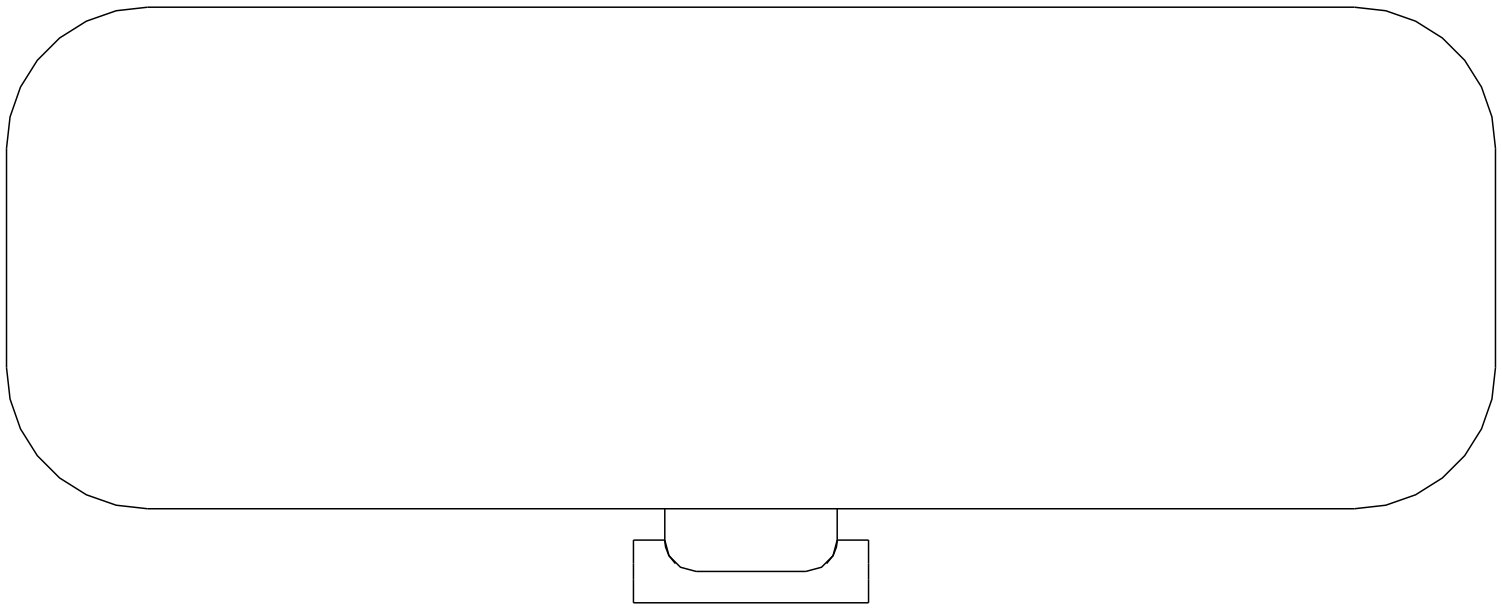
[picture p58: figure]

后视图
