wentingjie001-cmd/-/cad/out/design/03_linkage_hub/right.pdf

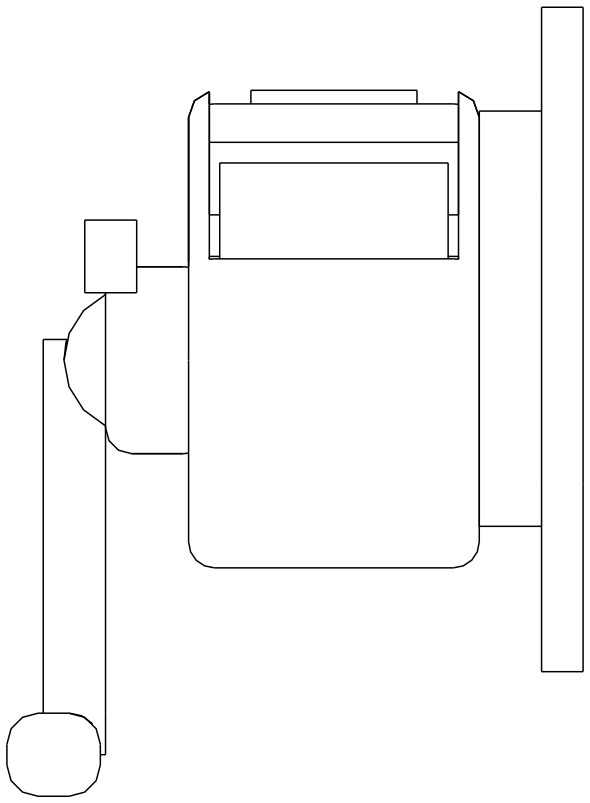
[picture p59: figure]

右视图
