wentingjie001-cmd/-/cad/out/design/03_linkage_hub/top.pdf

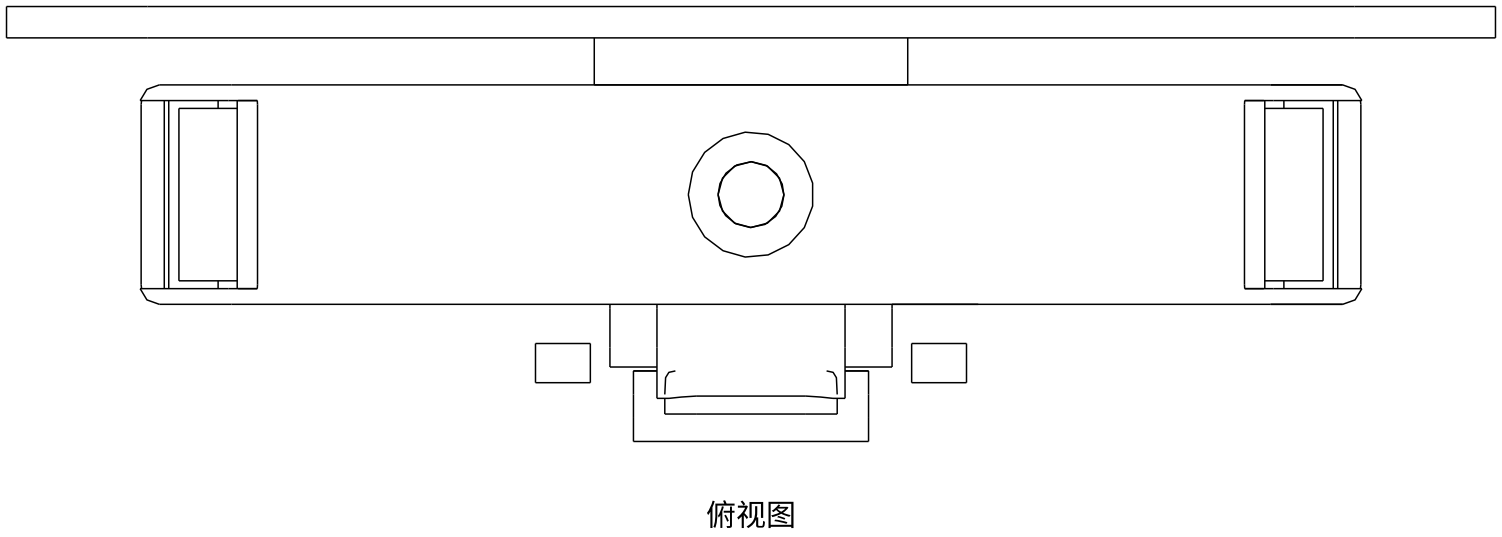
[picture p60: figure]
俯视图
