wentingjie001-cmd/-/cad/out/benchmark_aarn_pm40/detail/hardware/hardware_sheet.png

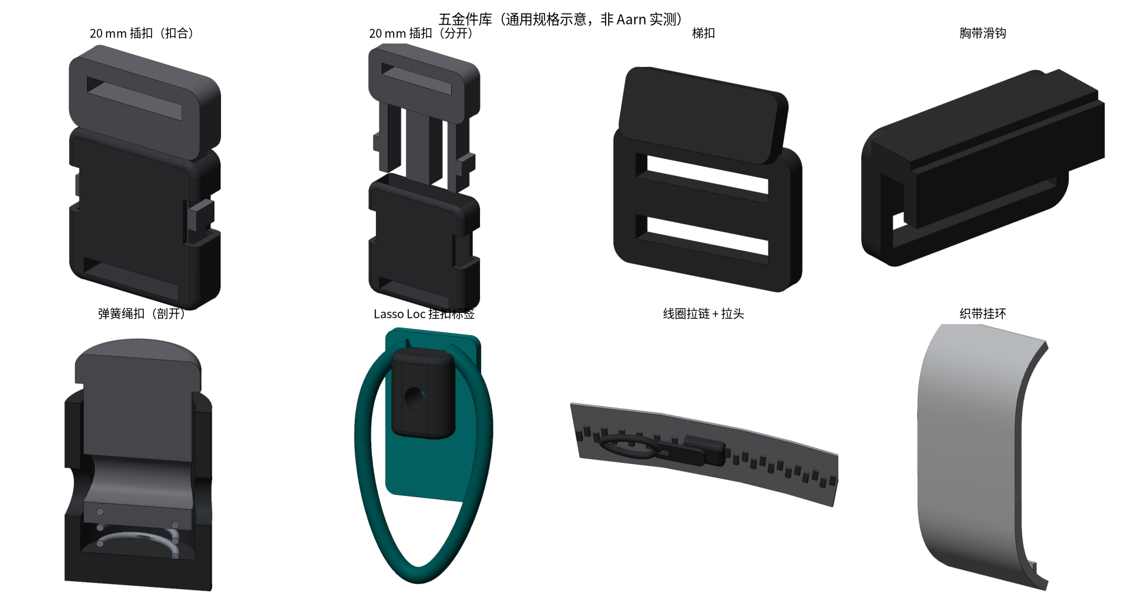
cad/out/benchmark_aarn_pm40/detail/hardware/hardware_sheet.png
