wentingjie001-cmd/-/cad/out/design/02_backpack_partial_back_system/iso_rear.png

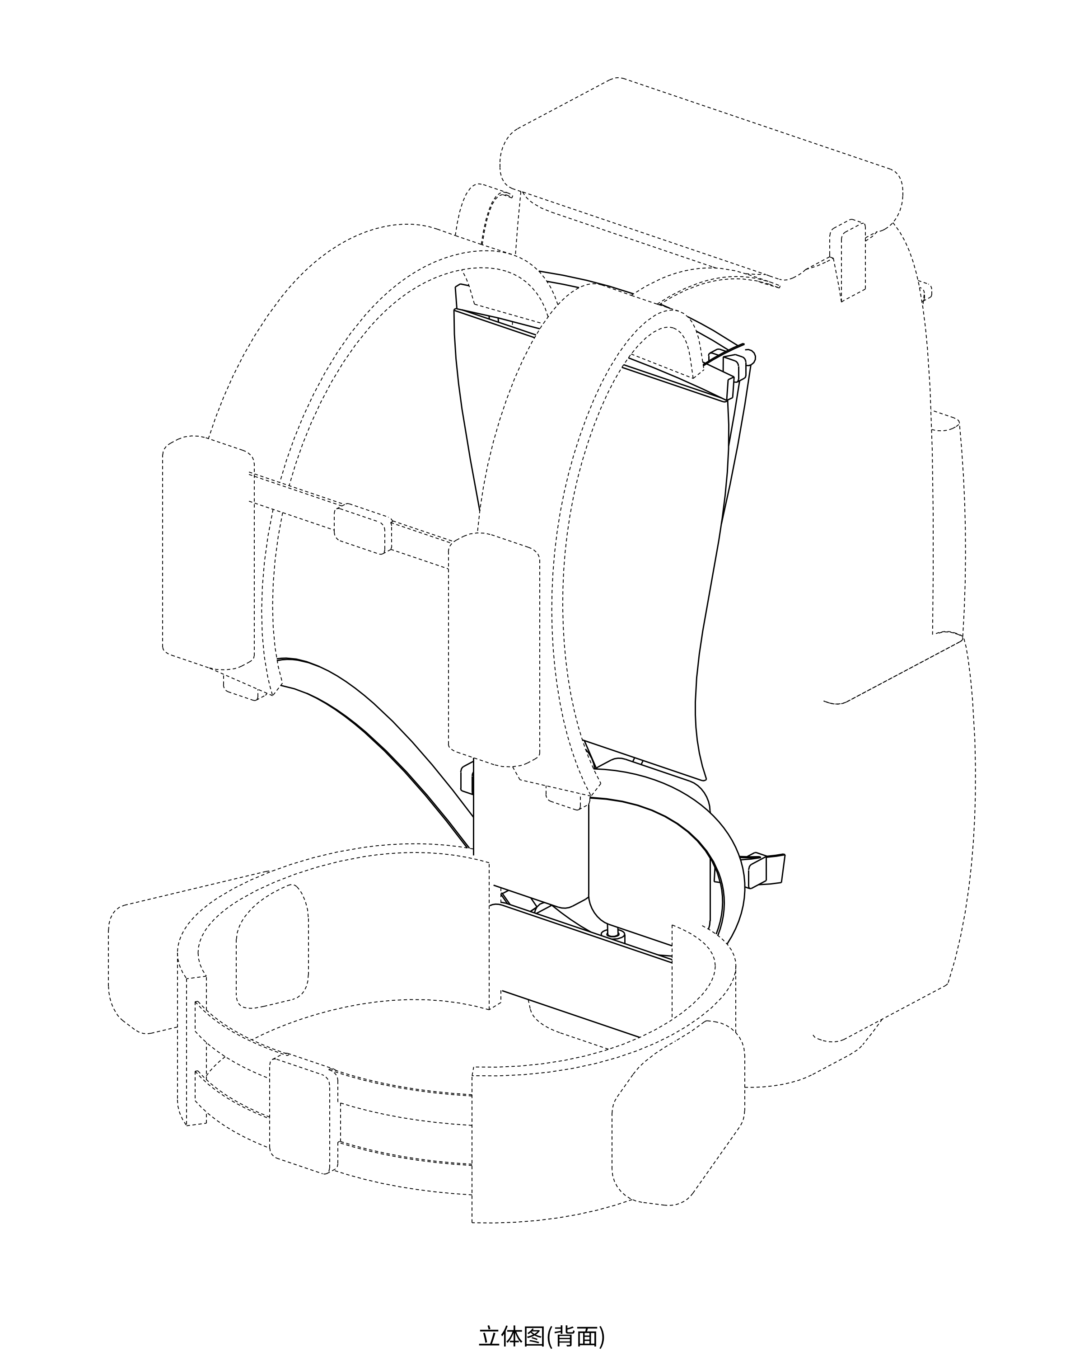
cad/out/design/02_backpack_partial_back_system/iso_rear.png
