wentingjie001-cmd/-/cad/out/drawings/BP40-FRM-001_y_frame.png

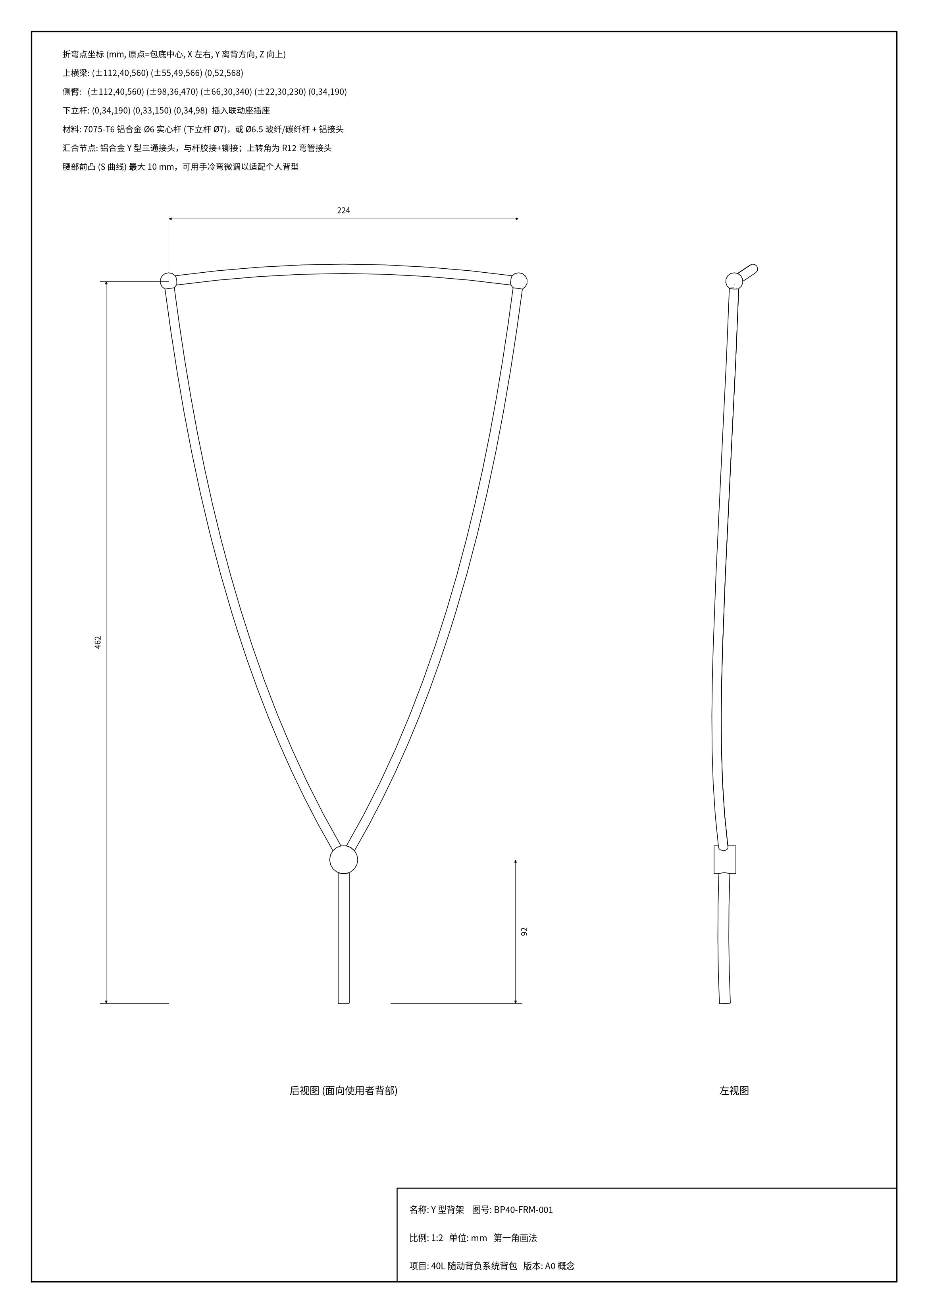
cad/out/drawings/BP40-FRM-001_y_frame.png
