wentingjie001-cmd/-/cad/out/drawings/BP40-HUB-001_linkage_hub.png

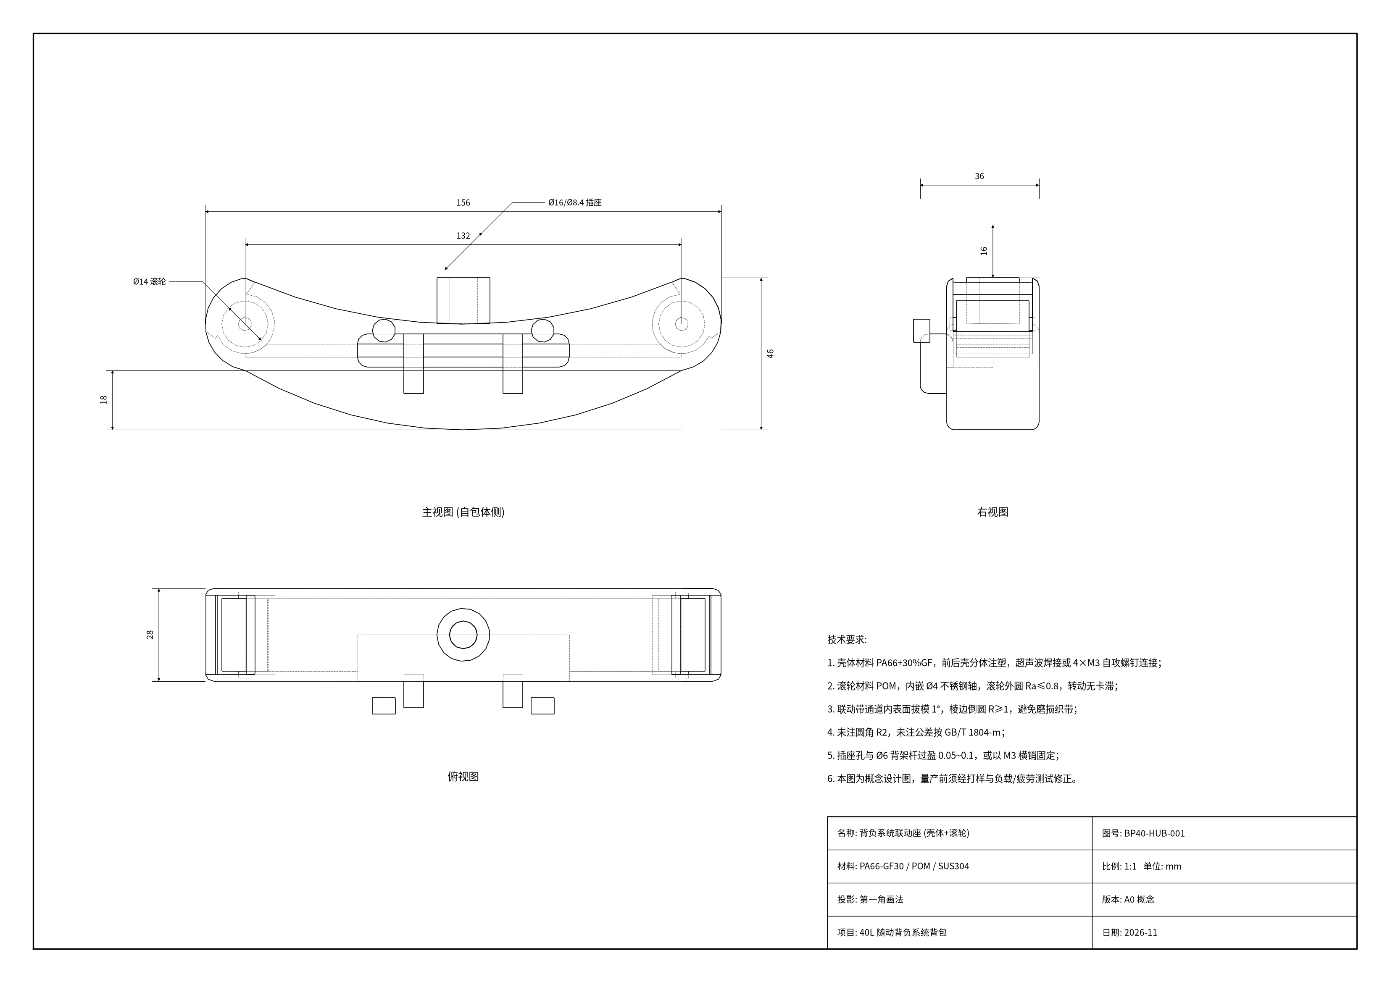
cad/out/drawings/BP40-HUB-001_linkage_hub.png
