wentingjie001-cmd/-/cad/out/invention/fig1_rear_iso.png

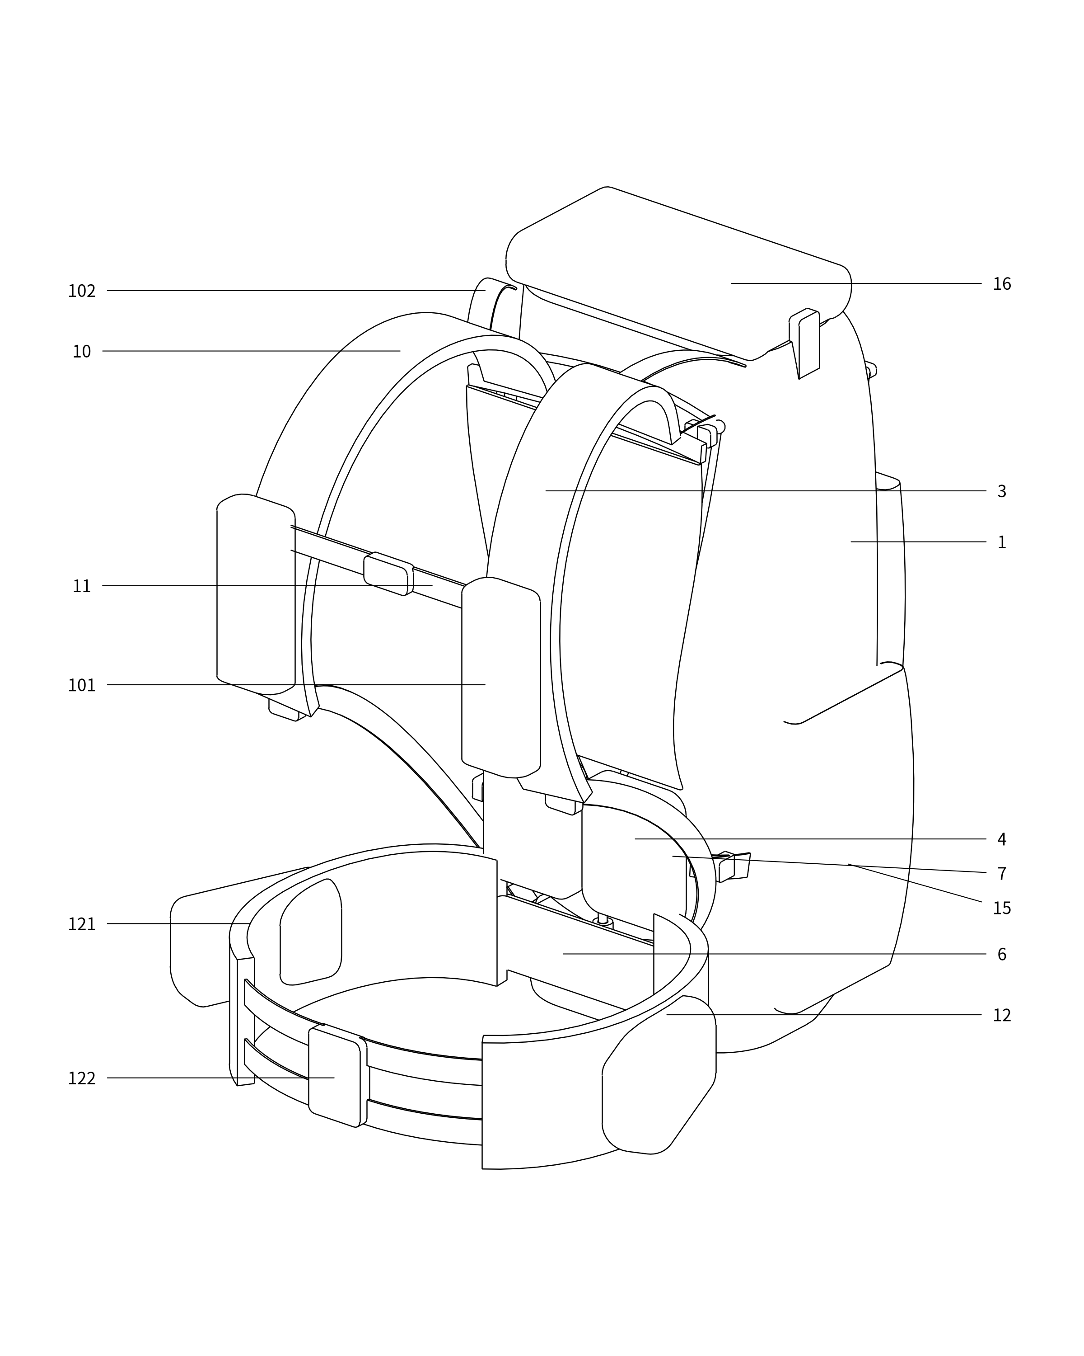
cad/out/invention/fig1_rear_iso.png
