wentingjie001-cmd/-/cad/out/invention/fig2_side.png

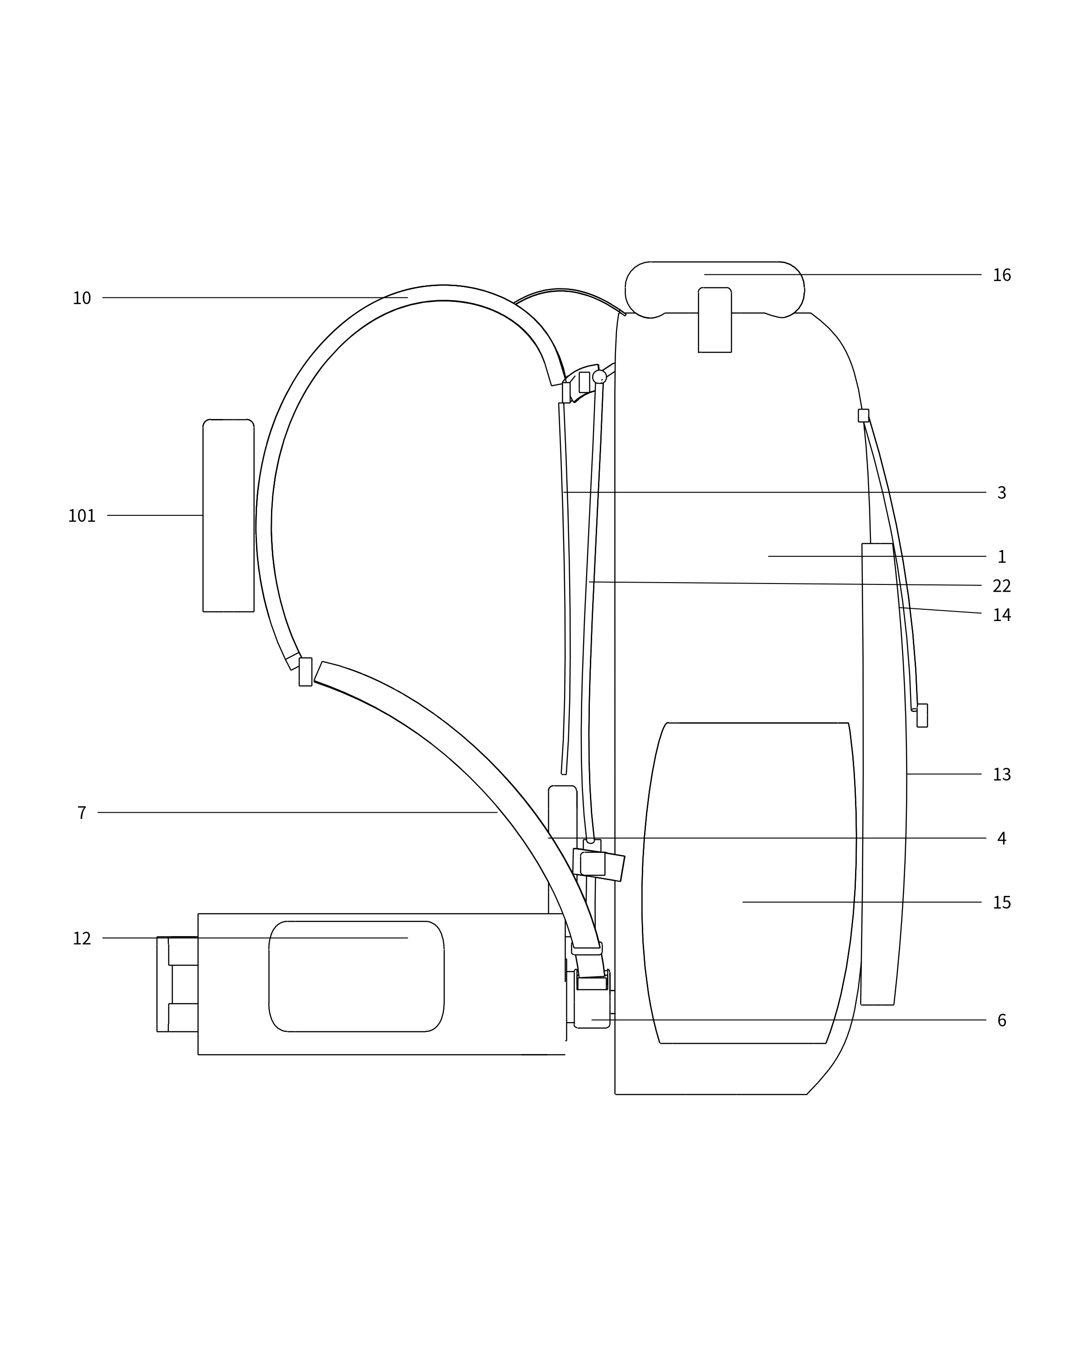
cad/out/invention/fig2_side.png
