wentingjie001-cmd/-/cad/out/invention/fig4_hub_exploded.png

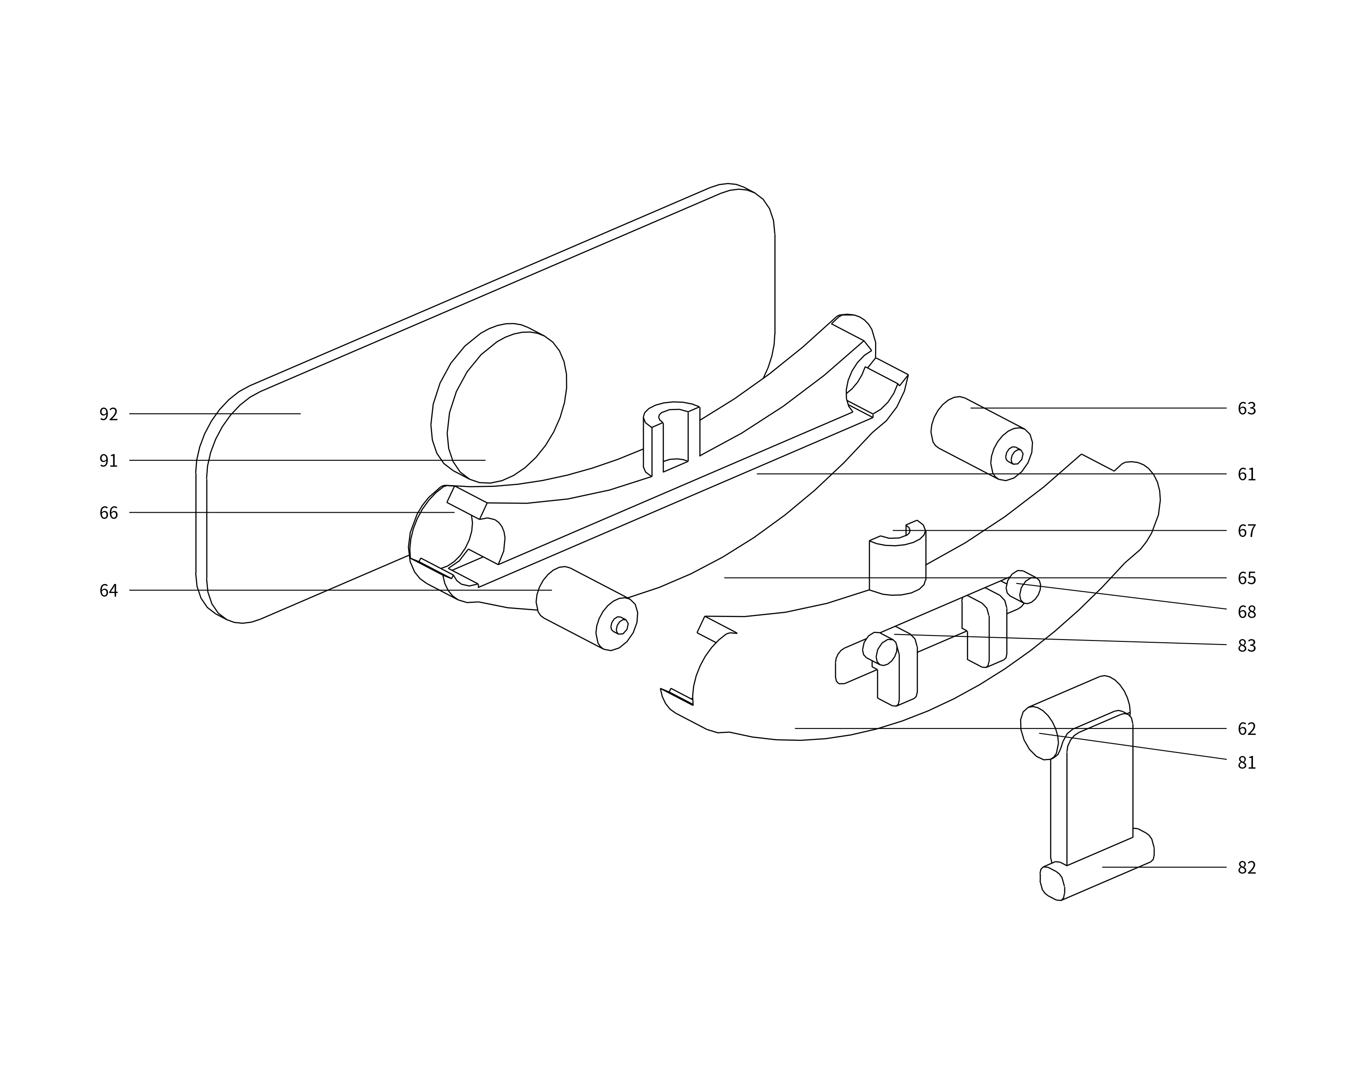
cad/out/invention/fig4_hub_exploded.png
