wentingjie001-cmd/-/cad/out/invention/fig5_hub_front_hidden.png

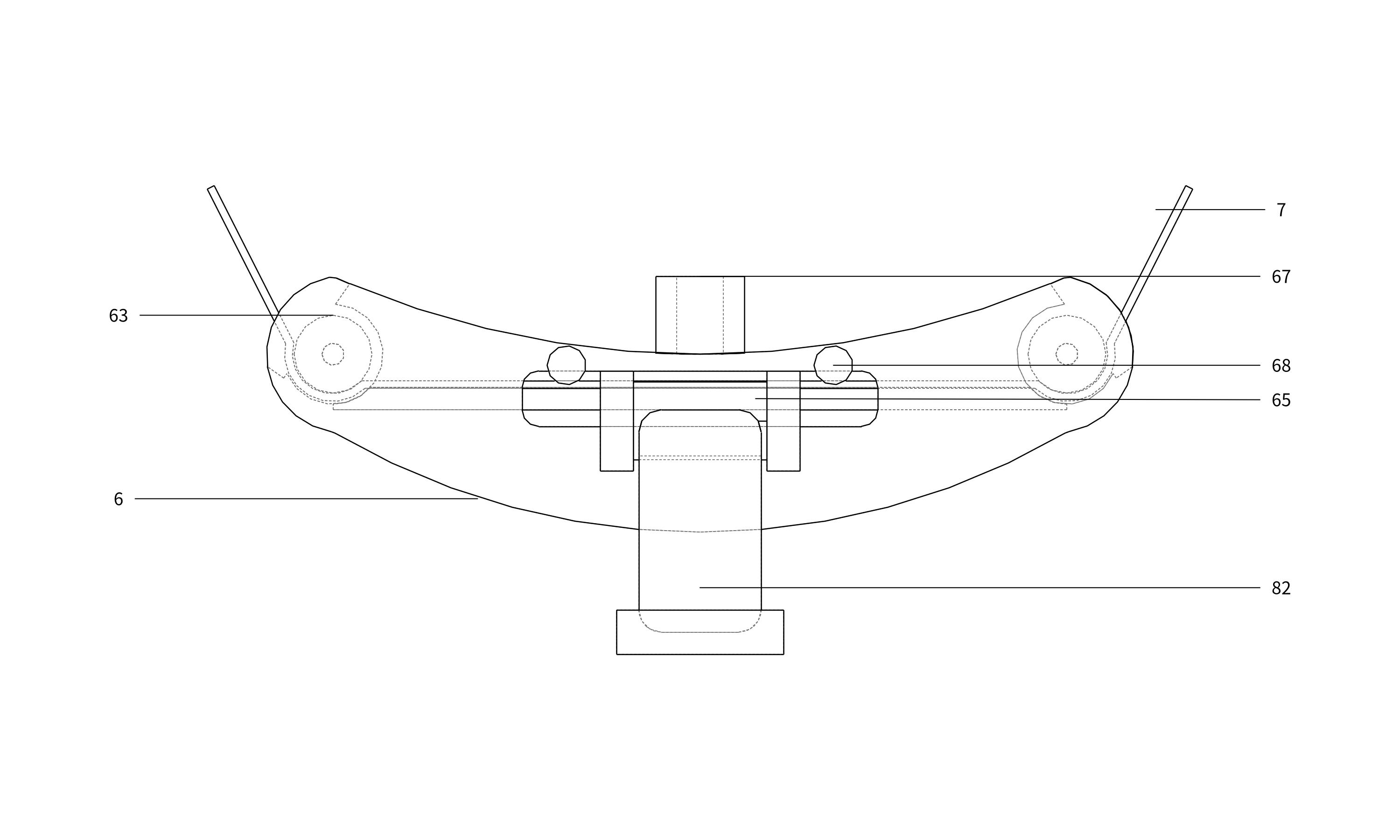
cad/out/invention/fig5_hub_front_hidden.png
