wentingjie001-cmd/-/cad/out/preview_a1/a1_back_system.png

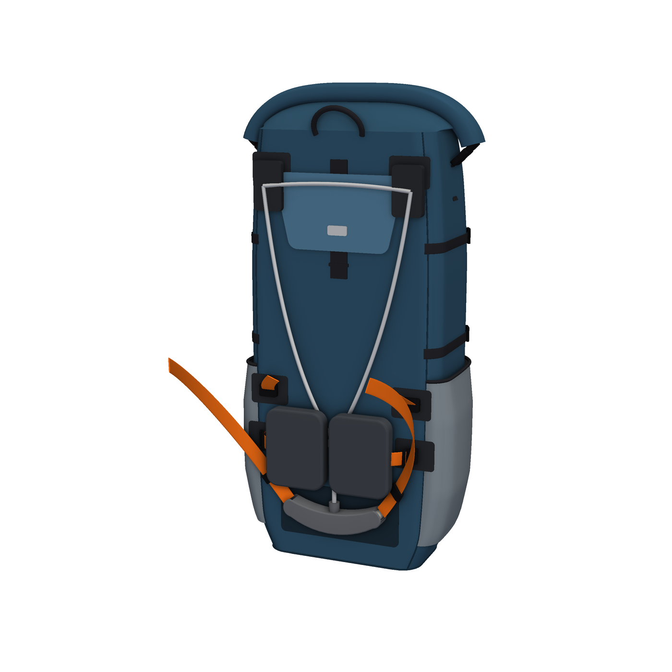
cad/out/preview_a1/a1_back_system.png
