wentingjie001-cmd/-/cad/out/preview_a1/a1_callouts_front.png

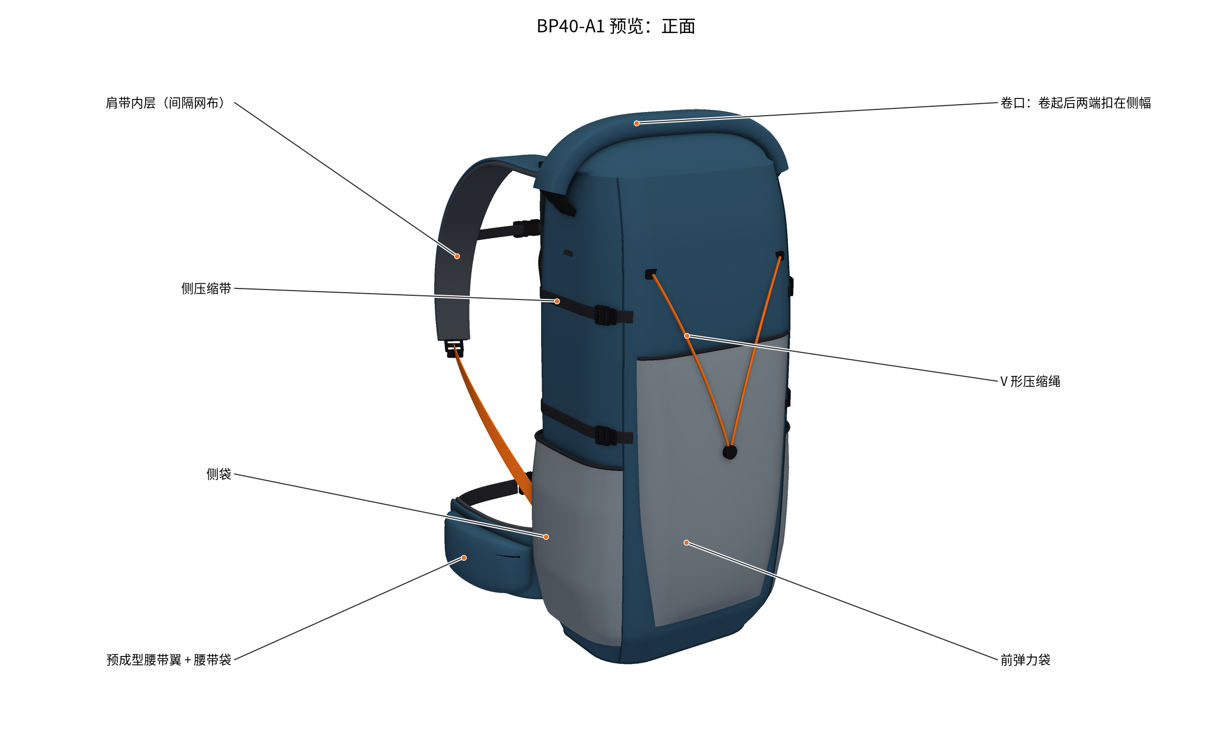
cad/out/preview_a1/a1_callouts_front.png
