wentingjie001-cmd/-/cad/out/production/markers/marker_M1.png

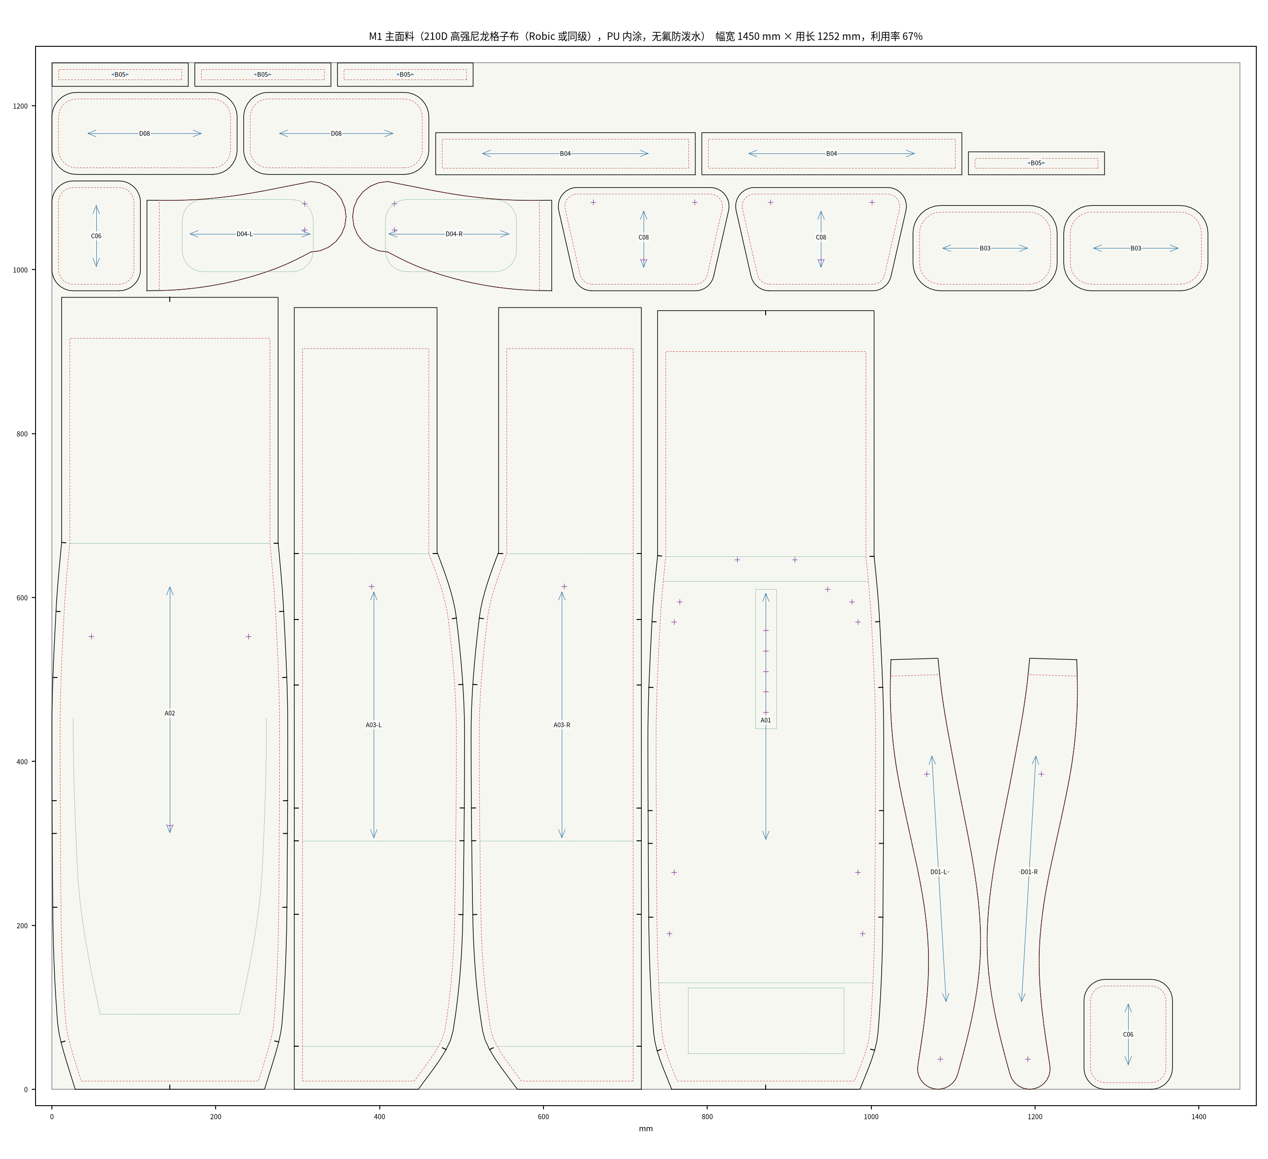
cad/out/production/markers/marker_M1.png
