wentingjie001-cmd/-/cad/out/production/markers/marker_M2.png

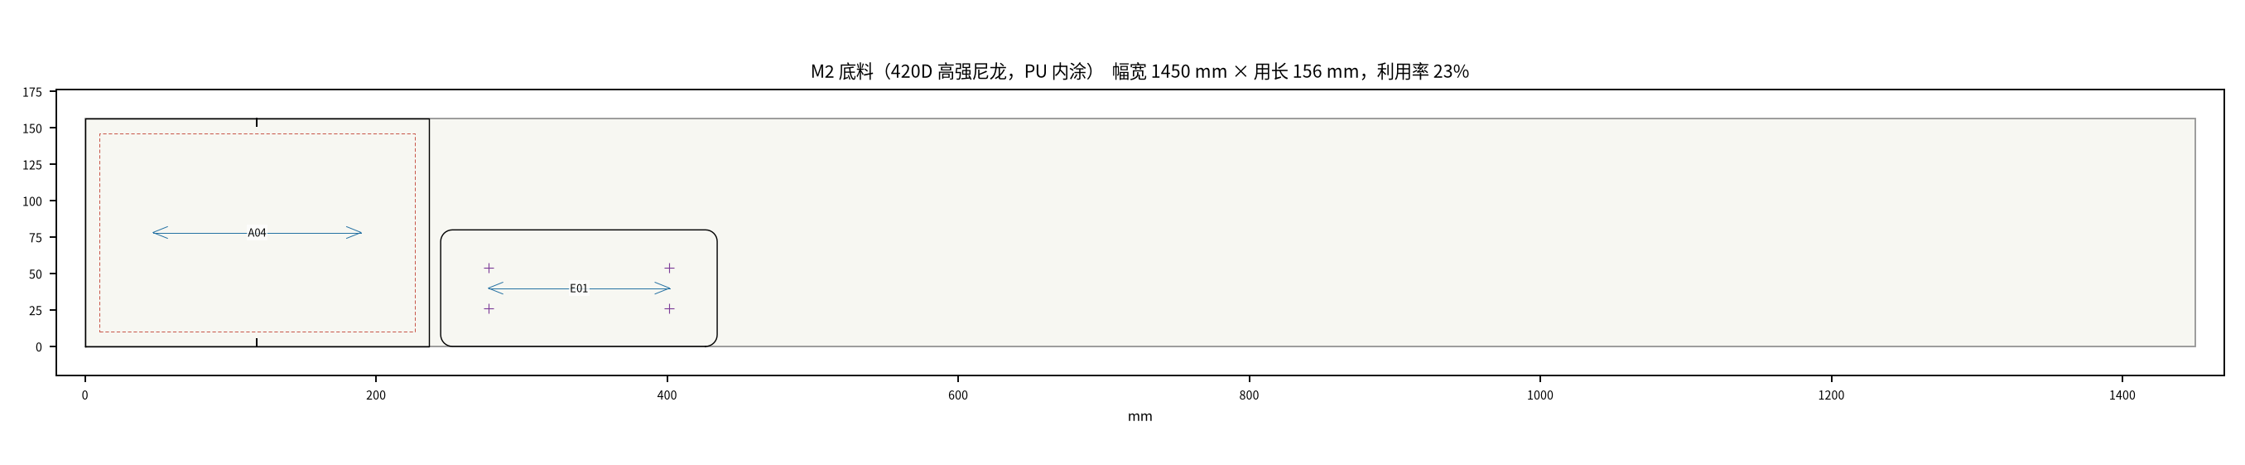
cad/out/production/markers/marker_M2.png
