wentingjie001-cmd/-/cad/out/production/markers/marker_M3.png

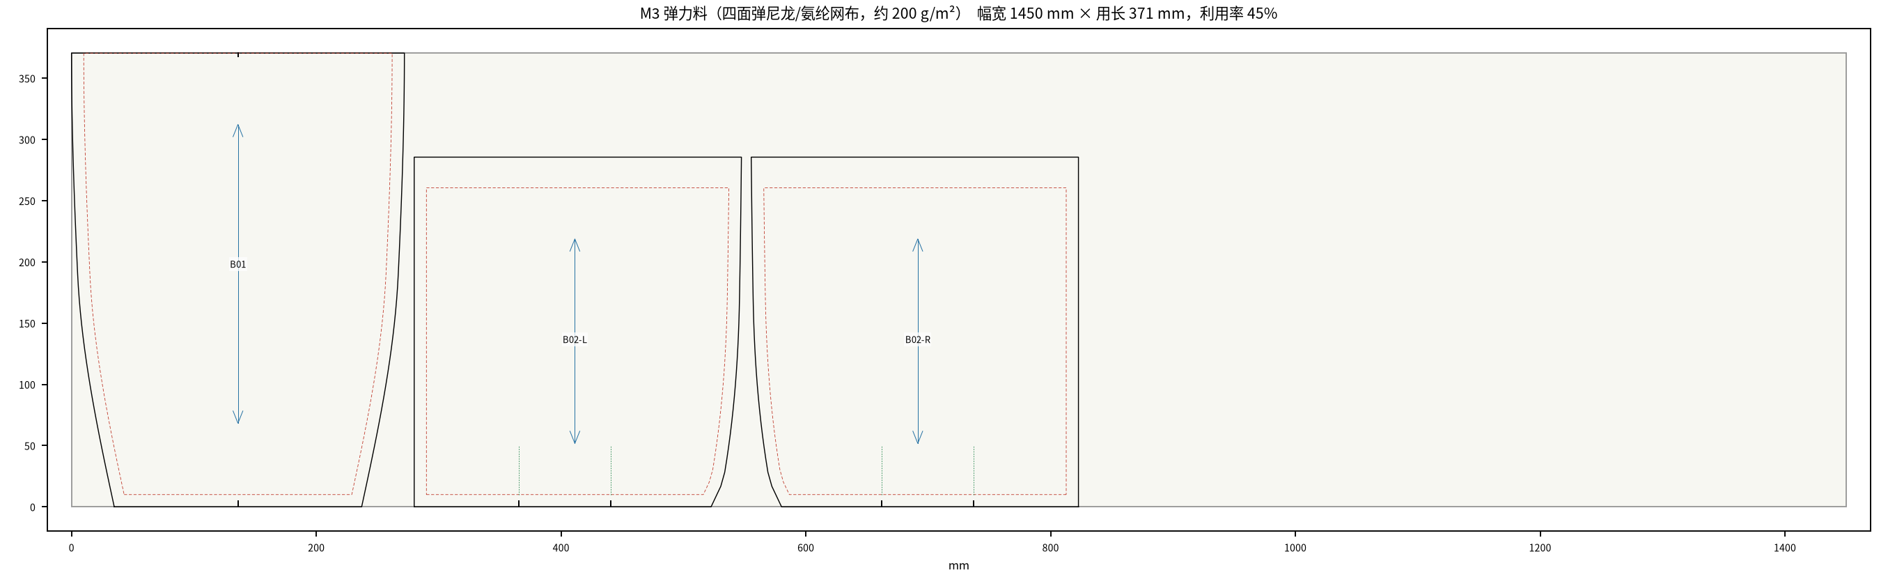
cad/out/production/markers/marker_M3.png
