wentingjie001-cmd/-/cad/out/production/markers/marker_M4.png

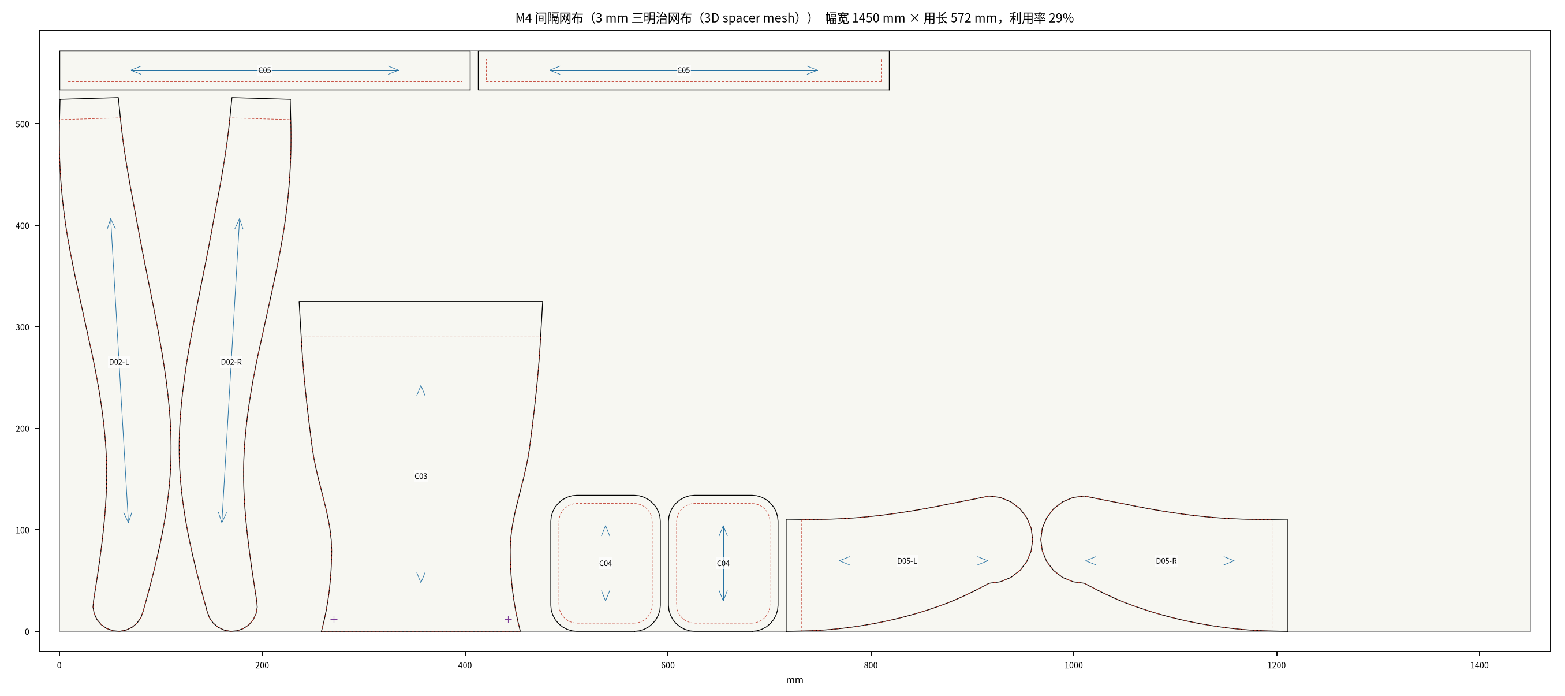
cad/out/production/markers/marker_M4.png
