wentingjie001-cmd/-/cad/out/production/markers/marker_M5.png

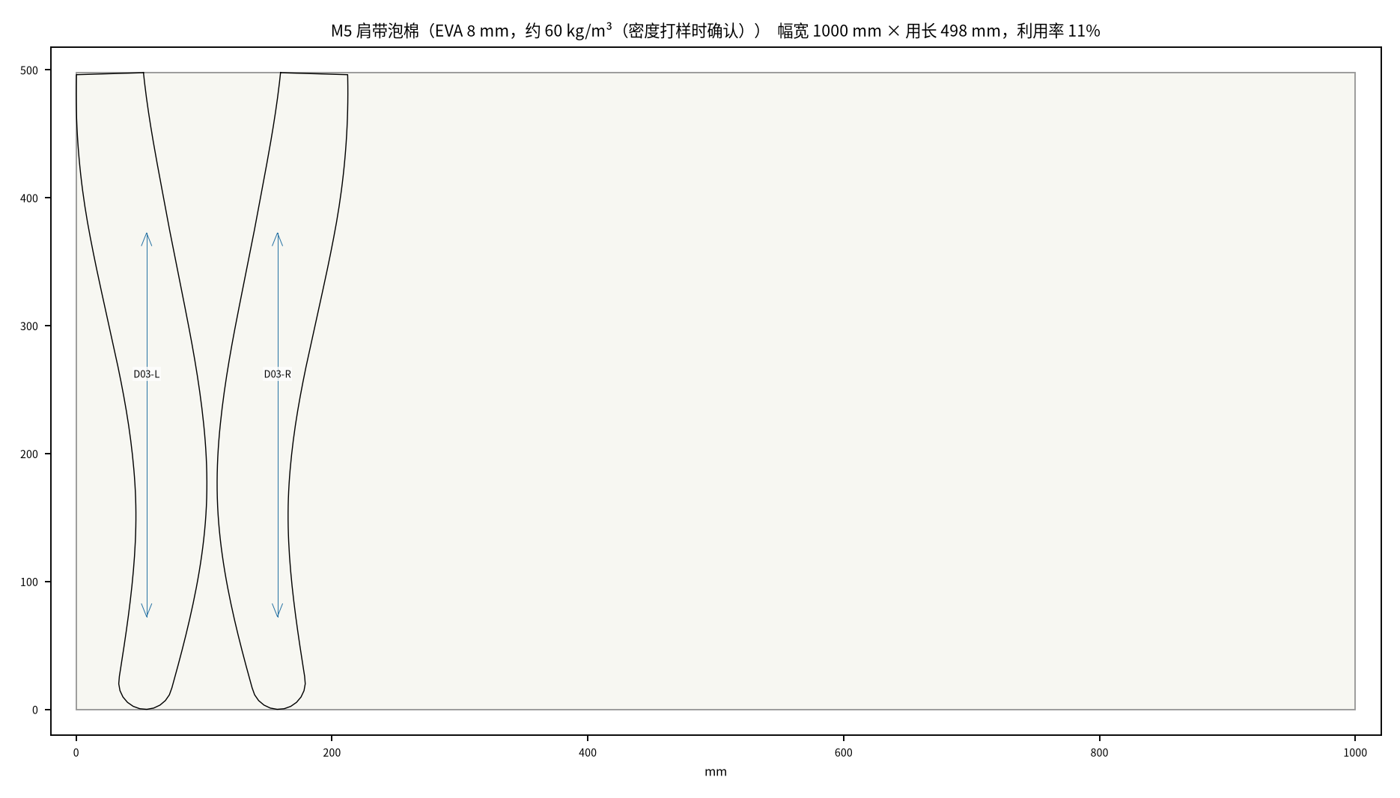
cad/out/production/markers/marker_M5.png
