wentingjie001-cmd/-/cad/out/production/markers/marker_M6.png

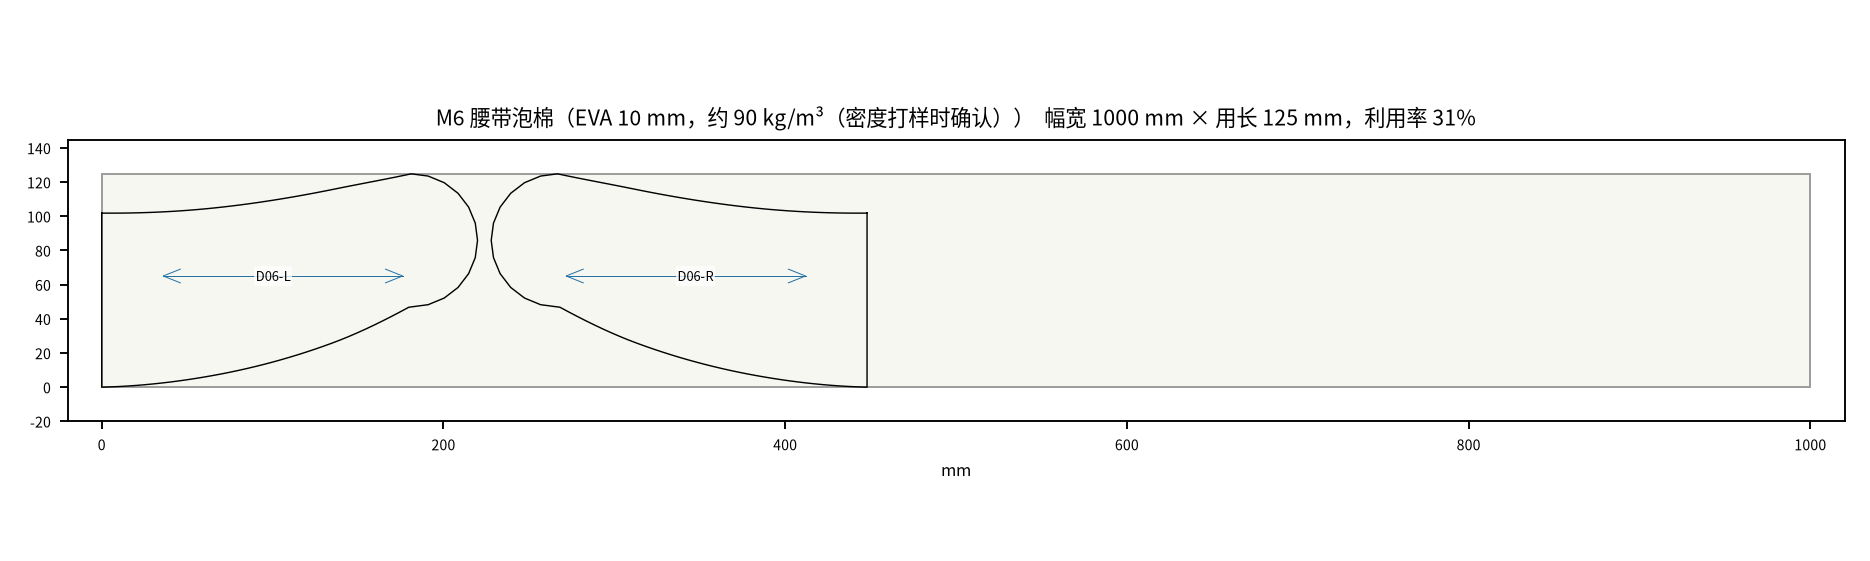
cad/out/production/markers/marker_M6.png
