wentingjie001-cmd/-/cad/out/production/markers/marker_M7.png

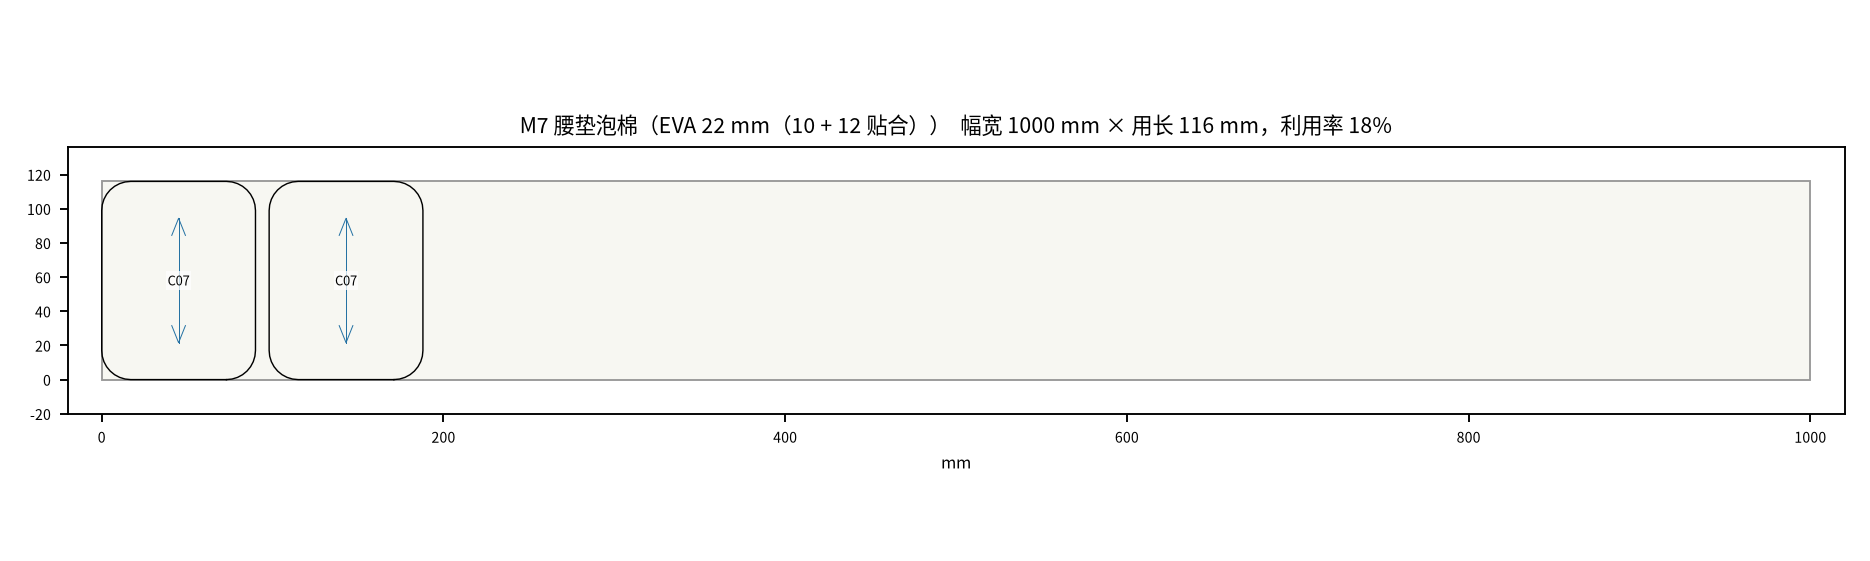
cad/out/production/markers/marker_M7.png
