wentingjie001-cmd/-/cad/out/production/markers/marker_M8.png

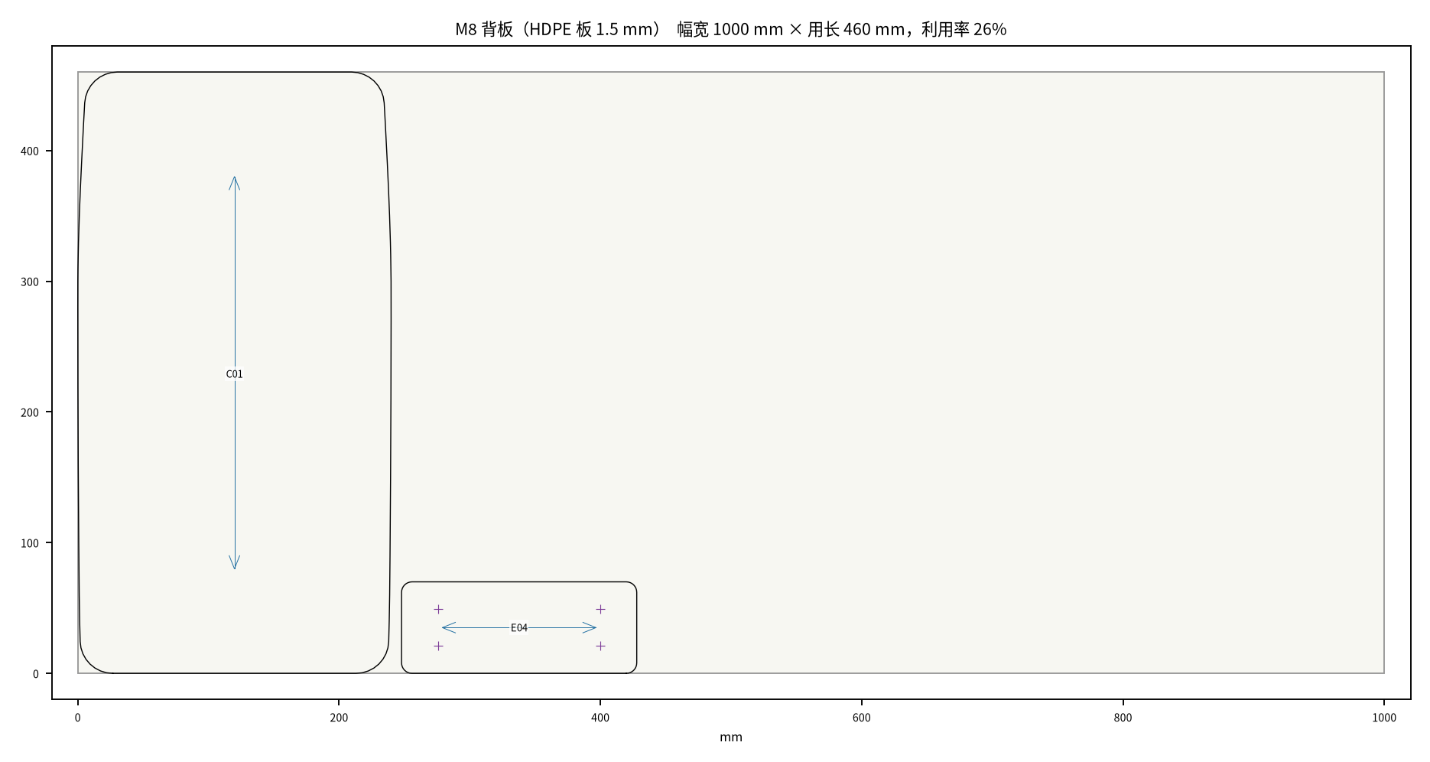
cad/out/production/markers/marker_M8.png
