wentingjie001-cmd/-/cad/out/production/markers/marker_M9.png

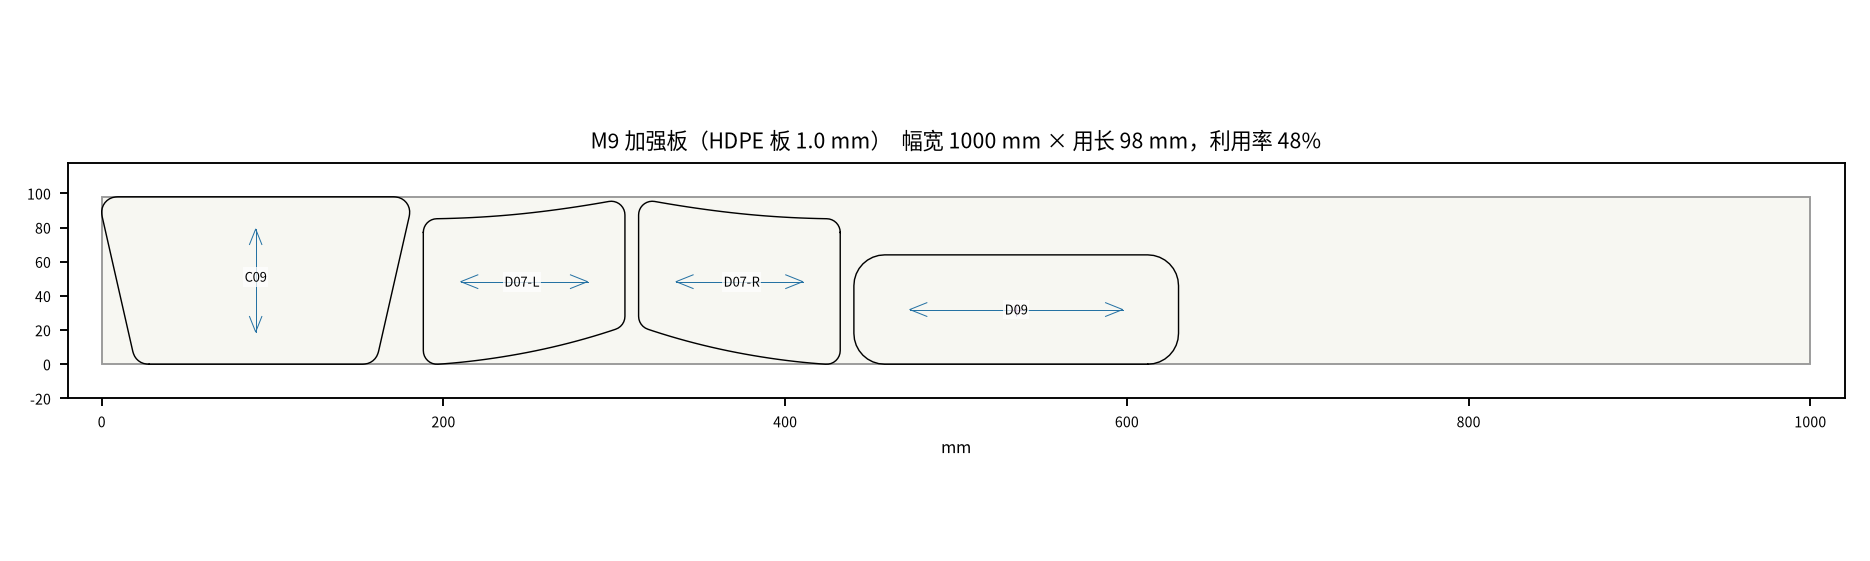
cad/out/production/markers/marker_M9.png
