wentingjie001-cmd/-/cad/out/production/markers/marker_M10.png

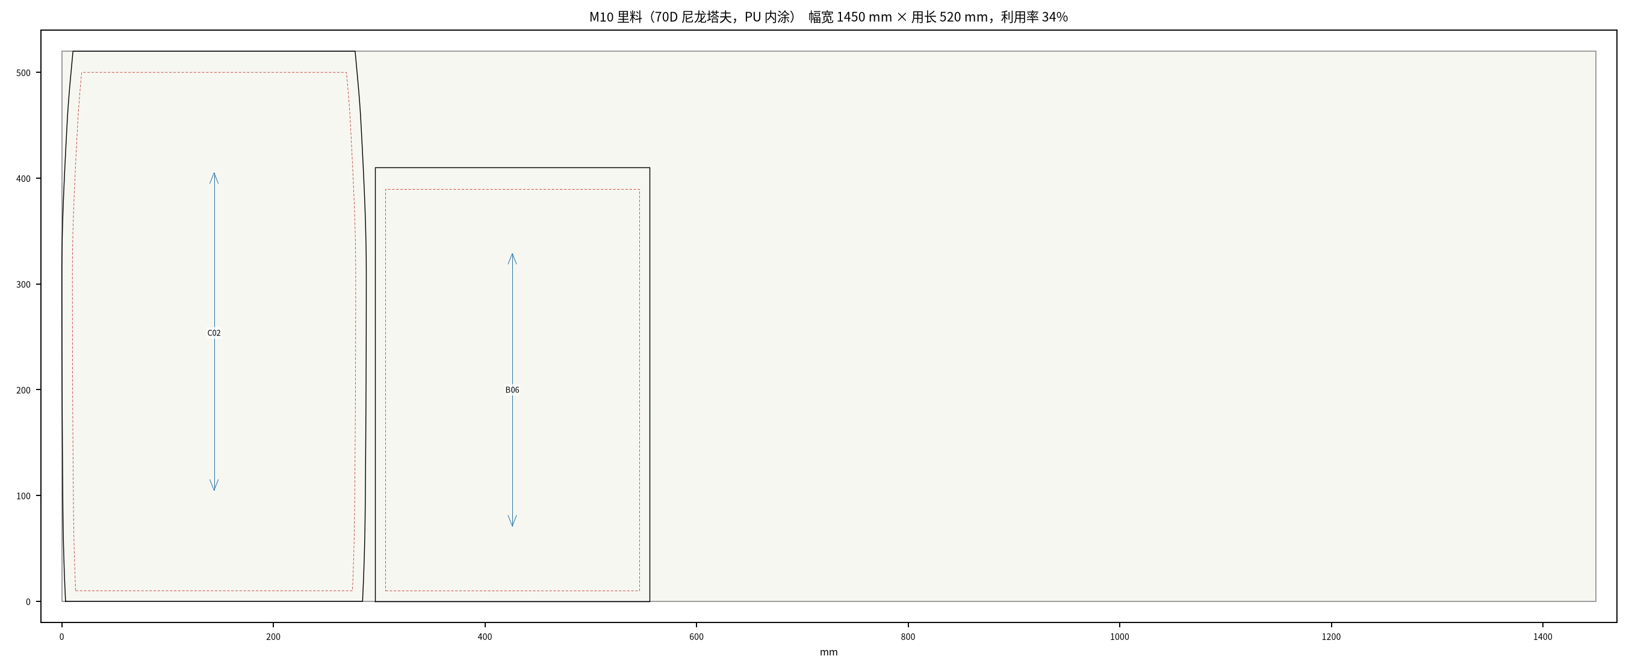
cad/out/production/markers/marker_M10.png
