wentingjie001-cmd/-/cad/out/production/markers/marker_M11.png

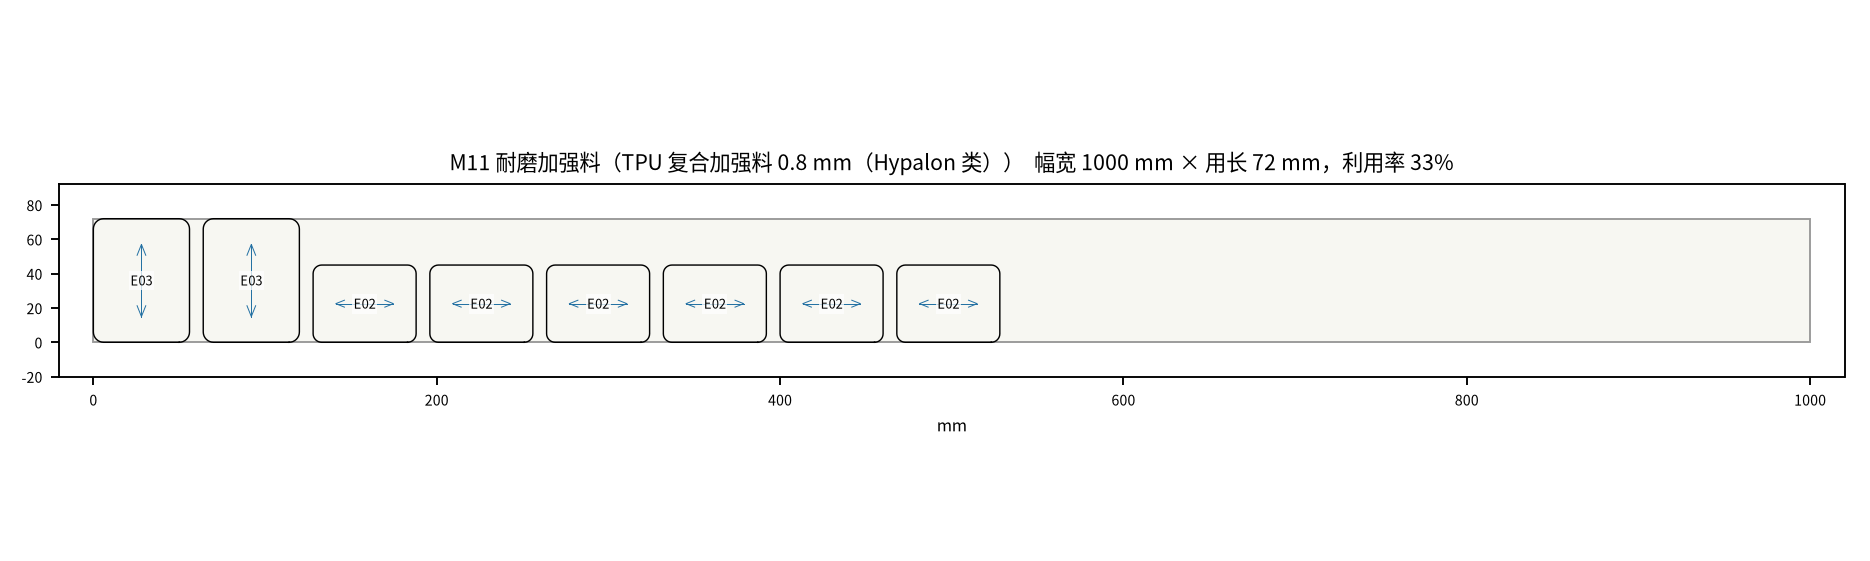
cad/out/production/markers/marker_M11.png
