wentingjie001-cmd/-/cad/out/render/backpack_front.png

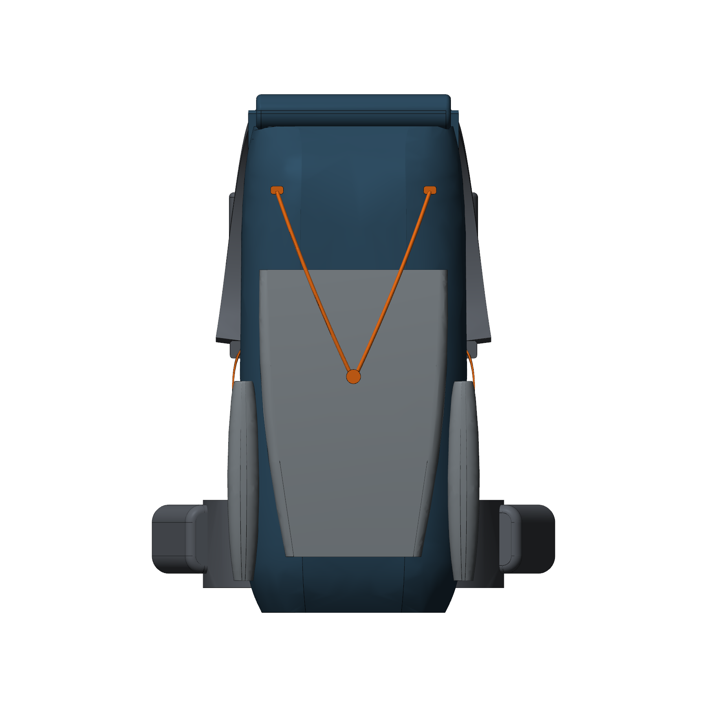
cad/out/render/backpack_front.png
