wentingjie001-cmd/-/cad/out/render/backpack_rear.png

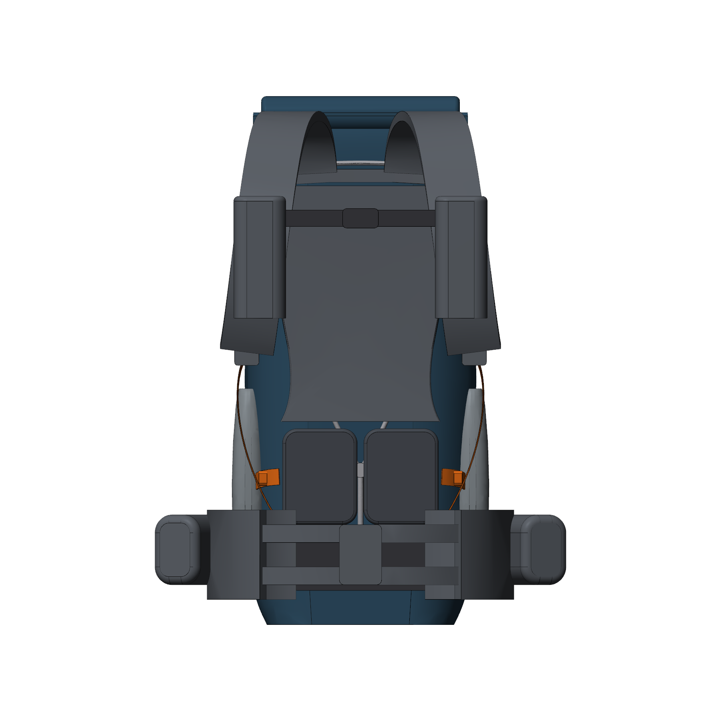
cad/out/render/backpack_rear.png
