wentingjie001-cmd/-/cad/out/render/hub_iso_body_side.png

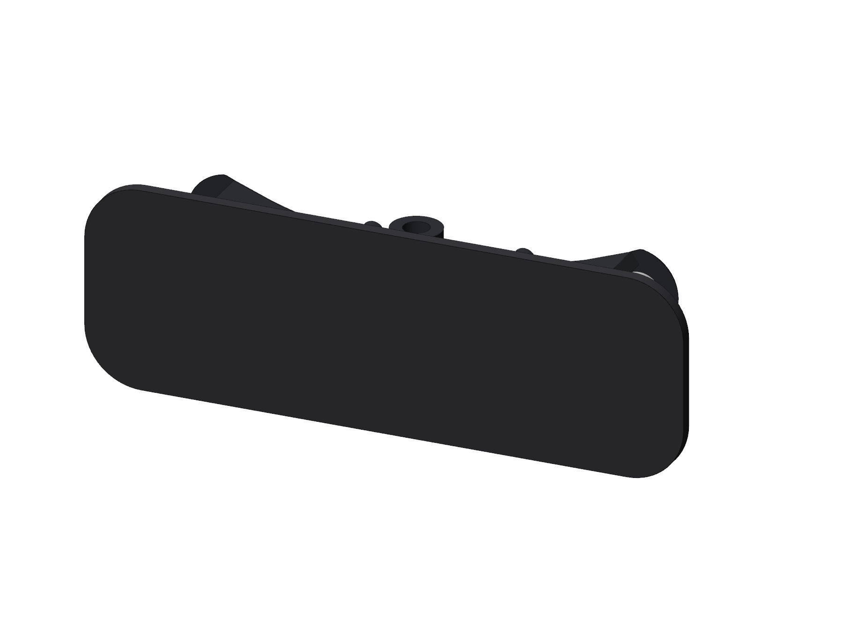
cad/out/render/hub_iso_body_side.png
