wentingjie001-cmd/-/cad/out/render/hub_iso_pack_side.png

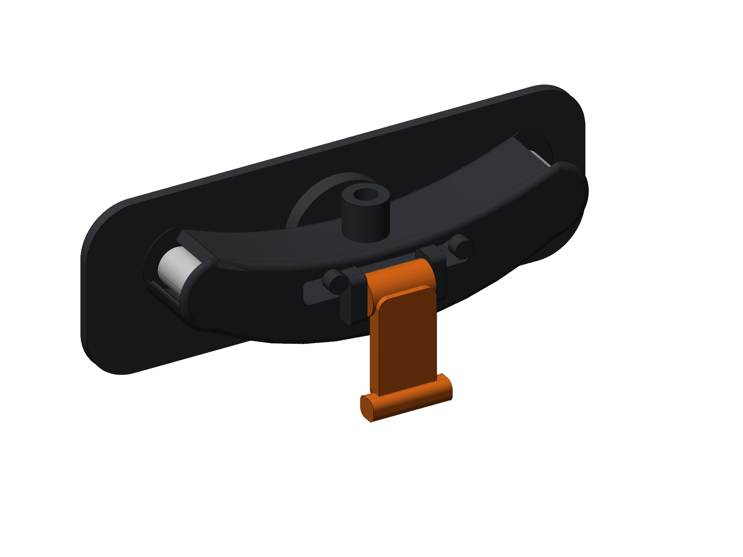
cad/out/render/hub_iso_pack_side.png
