wentingjie001-cmd/-/cad/out/benchmark_aarn_pm40/detail/bom_detail.md

| 编号 | 名称 | 分组 | 材料 | 数量 | 依据 | 包络尺寸 X×Y×Z (mm) |
|---|---|---|---|---|---|---|
| A01 | 主仓筒身（40 L，上口敞开） | 主包体 | 100D Robic 尼龙（含 UHMWPE） | 1 | 实测 | 269×251×541 |
| A02 | 包底（双层加强） | 主包体 | 210D Duramax | 1 | 实测外形 / 推断层数 | 224×109×42 |
| A03 | 卷口收口（已卷合状态，按 3 层等效 4 mm） | 主包体 | 100D Robic | 1 | 实测外形 / 推断卷数 | 268×225×75 |
| A04 | 顶部挂环 | 主包体 | TPU 包胶 | 1 | 照片可见 | 24×4×24 |
| A05 | 卷口压缩带 | 主包体 | 20 mm 尼龙织带 | 1 | 照片可见 | 20×208×104 |
| H01 | 卷口压缩带插扣（20 mm） | 五金 | POM | 1 | 照片可见 | 29×9×44 |
| Z01 | 顶部安全袋拉链（⑨，约 150 mm） | 拉链 | #3 尼龙线圈拉链 | 1 | 照片可见 | 155×62×22 |
| Z02 | 顶部安全袋拉头 + 拉绳 | 拉链 | 锌合金拉头 / 尼龙绳 | 1 | 照片可见 | 20×34×10 |
| I01 | 顶部安全袋内袋（吊在拉链下方） | 内部 | 20D 尼龙 | 1 | 推断 | 110×52×113 |
| Z03 | 侧面竖向拉链（约 180 mm） | 拉链 | #5 尼龙线圈拉链 | 2 | 照片可见 | 240×20×182 |
| Z04 | 侧面拉链拉头 + 拉绳 | 拉链 | 锌合金拉头 / 尼龙绳 | 2 | 照片可见 | 243×8×38 |
| P01 | 前部弹力网袋（上口敞开） | 外袋 | Darlington 弹力网布 240 g | 1 | 实测 | 226×112×380 |
| P02 | 前网袋袋口包边松紧带 | 外袋 | 10 mm 松紧带 | 1 | 照片可见 | 204×10×4 |
| P03 | 前网袋拉手 | 外袋 | 16 mm 织带 | 1 | 照片可见 | 16×7×31 |
| P04 | 侧袋（左右各 1，上口敞开） | 外袋 | 100D Robic + 弹力包边 | 2 | 实测 | 316×174×350 |
| P05 | 侧袋袋口松紧包边（内衬为点缀色） | 外袋 | 松紧带 / 点缀色内衬 | 2 | 照片可见 | 315×142×4 |
| F01 | 压缩绳穿绳环 / 上部登山杖挂点 | 前部 | 10 mm 织带 | 4 | 照片可见 | 237×12×93 |
| F02 | 前部压缩弹力绳（⑩） | 前部 | Ø3.5 mm 弹力绳 | 1 | 照片可见 | 227×48×175 |
| H02 | 压缩绳绳扣（弹簧式） | 五金 | POM / 不锈钢弹簧 | 1 | 照片可见 | 14×14×23 |
| H03 | 绳扣弹簧 | 五金 | 不锈钢 | 1 | 推断 | 8×8×5 |
| H04 | 压缩绳尾端拉扣 | 五金 | POM | 1 | 照片可见 | 10×7×16 |
| F03 | 冰镐挂环 ×1 + 登山杖挂环 ×2（⑪） | 前部 | 25 / 16 mm 织带 | 3 | 照片可见 | 192×39×37 |
| F04 | Lasso Loc 挂扣标签（⑭） | 前部 | 织带标签 | 12 | 照片可见（位置估计） | 311×153×554 |
| F05 | Lasso Loc 弹力绳圈 | 前部 | Ø2.4 mm 弹力绳 | 12 | 照片可见 | 324×162×564 |
| H05 | Lasso Loc 绳夹 | 五金 | POM | 12 | 推断 | 323×154×542 |
| B01 | 悬浮透气网背板（⑦，外圈浅色） | 背负系统 | 3D 间隔网布 3 mm | 1 | 实测 | 224×3×347 |
| B02 | 网背板包边 | 背负系统 | 20 mm 包边带 | 1 | 照片可见 | 227×3×352 |
| B03 | 中部深色 Y 形网 | 背负系统 | 六角网布 | 1 | 实测 | 168×2×303 |
| B04 | 腰垫外套（网布） | 背负系统 | 3D 间隔网布 | 1 | 实测外形 | 136×22×148 |
| B05 | 腰垫泡棉芯（16 mm） | 内部 | EVA 泡棉 | 1 | 推断 | 132×16×144 |
| B06 | 背板张紧带（⑧，顶部横带 + 两端调节尾带） | 背负系统 | 20 mm 织带 | 1 | 实测 | 263×34×30 |
| H06 | 背板张紧梯扣 | 五金 | POM | 2 | 照片可见 | 264×8×28 |
| B07 | 网背板侧边弹性拉片 | 背负系统 | 12 mm 松紧带 | 4 | 推断 | 251×52×162 |
| B08 | X 形支撑杆 ×2（Ø5 mm，预弯） | 背负系统 | 铝合金 / 弹簧钢（推断） | 2 | 照片可见（交叉段）/ 推断（端点、截面） | 204×13×385 |
| B09 | 支撑杆端头保护套 + 杆袋 | 内部 | 加厚尼龙 + TPU 端套 | 4 | 推断 | 217×11×404 |
| B10 | 支撑杆交叉卡座 | 背负系统 | 尼龙 PA6 | 1 | 推断 | 20×8×20 |
| S01 | 肩带内层 3D 网布（贴身面） | 肩带 | 3D 间隔网布 2.5 mm | 2 | 照片可见 | 159×174×343 |
| S02 | 肩带泡棉芯（8 mm） | 内部 | EVA / PE 泡棉 | 2 | 推断 | 153×168×341 |
| S03 | 肩带外层面布 | 肩带 | 100D Robic | 2 | 照片可见 | 156×159×334 |
| S04 | 肩带包边 | 肩带 | 20 mm 包边带 | 4 | 照片可见 | 159×168×341 |
| S05 | 胸带滑轨织带 + 打结（套结） | 肩带 | 15 mm 织带 | 2 | 照片可见（pm40_10） | 101×65×134 |
| S06 | 负重调节带（②） | 肩带 | 20 mm 织带 | 2 | 实测 | 235×80×45 |
| H07 | 肩带梯扣（下端 U-Flow 调节 ×2，负重调节带 ×2） | 五金 | POM | 4 | 照片可见 | 191×41×362 |
| S07 | 肩带 750 ml 弹力网袋（⑬，上口敞开） | 肩带 | 弹力网布 | 2 | 实测 | 254×89×185 |
| S08 | 网袋口抽绳 | 肩带 | Ø3 mm 弹力绳 | 2 | 照片可见 | 245×80×4 |
| H08 | 网袋口绳扣 | 五金 | POM | 2 | 照片可见 | 186×14×23 |
| S09 | 弹力稳定绳（③，网袋 → 腰包） | 肩带 | Ø3 mm 弹力绳 | 2 | 照片可见 | 179×20×39 |
| S10 | 胸带织带 ×2（①，高度可调） | 肩带 | 16 mm 织带 | 2 | 实测 | 72×51×126 |
| H09 | 胸带插扣（16 mm） | 五金 | POM | 2 | 照片可见 | 44×55×135 |
| H10 | 胸带滑钩 | 五金 | POM | 4 | 照片可见 | 100×61×124 |
| U01 | U-Flow 联动带（⑥，左右肩带下端经包底连成一根） | U-Flow | 20 mm 低摩擦织带 | 1 | 照片可见（外露段）/ 推断（包内段） | 273×170×169 |
| U02 | 包底低摩擦扁管（U 形通道） | 内部 | HDPE / PTFE 涂层扁管 | 1 | 推断（Aarn 专利 US2006/0131355 所述“低摩擦 U 形管”） | 196×33×20 |
| U03 | 侧面织带出口加强片 | U-Flow | TPU 加强片 | 2 | 推断 | 235×30×24 |
| W01 | 腰带翼内层网布（贴身面） | 腰带 | 3D 间隔网布 2 mm | 2 | 照片可见 | 210×262×127 |
| W02 | 腰带翼泡棉芯（8 mm） | 内部 | EVA 泡棉 | 2 | 推断 | 206×259×121 |
| W03 | 腰带翼外层面布 | 腰带 | 100D Robic | 2 | 照片可见 | 190×248×126 |
| W04 | 腰带翼包边 | 腰带 | 20 mm 包边带 | 4 | 照片可见 | 202×257×130 |
| W05 | Auto-Form 上下双织带（④） | 腰带 | 20 mm 织带 | 4 | 照片可见 | 210×214×103 |
| H11 | 腰带梯扣 | 五金 | POM | 4 | 照片可见 | 186×30×86 |
| H12 | 腰带前插扣（上下各 1，20 mm） | 五金 | POM | 2 | 照片可见 | 44×9×85 |
| W06 | 1.5 L 腰包（⑫，闭合状态） | 腰带 | 100D Robic | 2 | 实测 | 293×178×193 |
| Z05 | 腰包拉链 | 拉链 | #5 尼龙线圈拉链 | 2 | 照片可见 | 272×128×22 |
| Z06 | 腰包拉头 + 拉绳 | 拉链 | 锌合金拉头 / 尼龙绳 | 2 | 照片可见 | 255×36×11 |
