wentingjie001-cmd/-/cad/out/benchmark_aarn_pm40/detail/step/aarn_pm40_detail_assembly.step

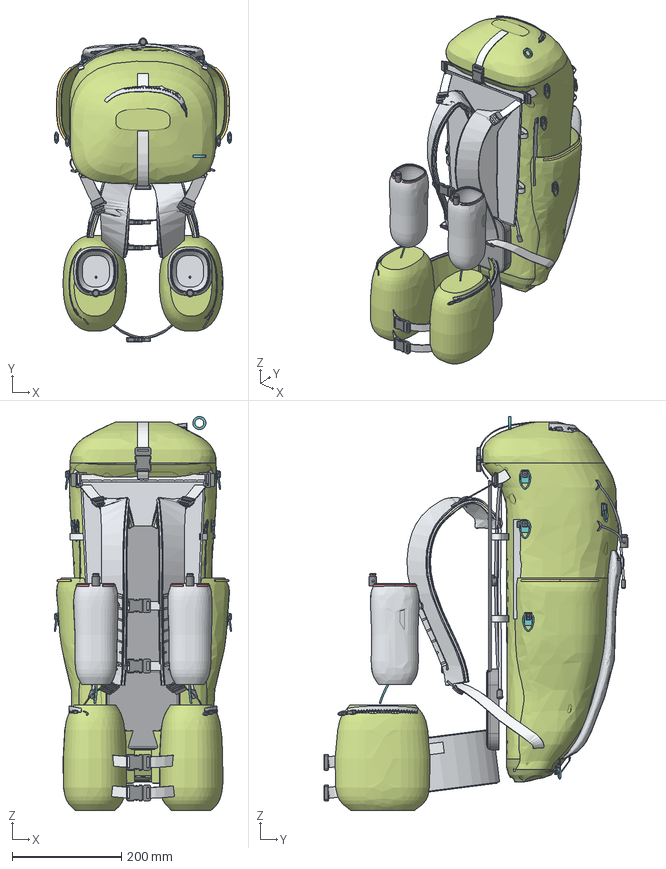
[picture p90: CAD file, 2026-11-09]
cad/out/benchmark_aarn_pm40/detail/step/aarn_pm40_detail_assembly.step
324.1 x 555.3 x 719.9 mm
A01
A02
A03
A04
A05
H01
Z01
Z02
I01
Z03
Z04
P01
P02
P03
P04
P05
F01
F02
H02
H03
H04
F03
F04
F05
H05
B01
B02
B03
B04
B05
B06
H06
B07
B08
B09
B10
S01
S02
S03
S04
S05
S06
H07
S07
S08
H08
S09
S10
H09
H10
U01
U02
U03
W01
W02
W03
W04
W05
H11
H12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
