wentingjie001-cmd/-/cad/out/benchmark_aarn_pm40/step/aarn_pm40_benchmark_assembly.step

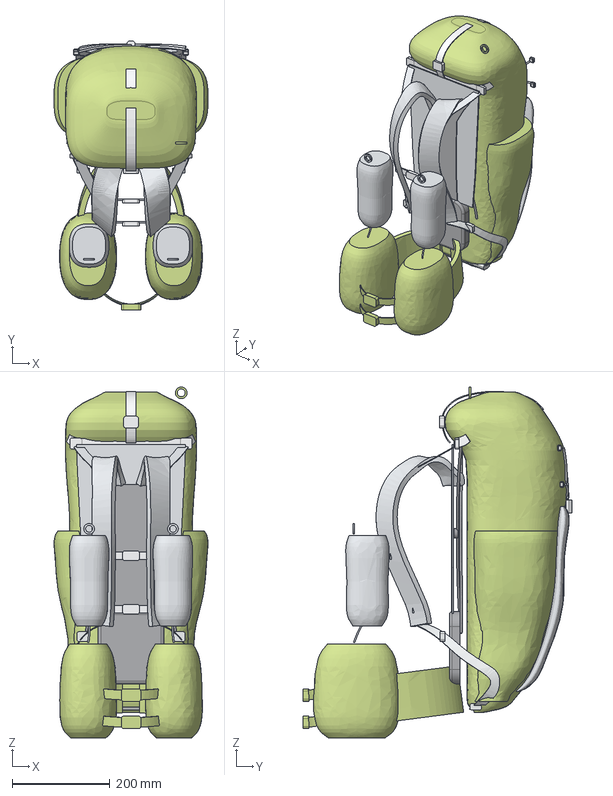
[picture p91: CAD file, 2026-11-09]
cad/out/benchmark_aarn_pm40/step/aarn_pm40_benchmark_assembly.step
315.7 x 551.5 x 720.0 mm
aarn_body
aarn_top_strap
aarn_front_mesh
aarn_drawcord
aarn_side_pockets
aarn_x_stays
aarn_mesh_back
aarn_mesh_dark
aarn_lumbar
aarn_tensioners
aarn_strap_l
aarn_strap_r
aarn_sternum
aarn_uflow
aarn_hipbelt_l
aarn_hipbelt_r
