wentingjie001-cmd/-/cad/out/step/linkage_hub_assembly.step

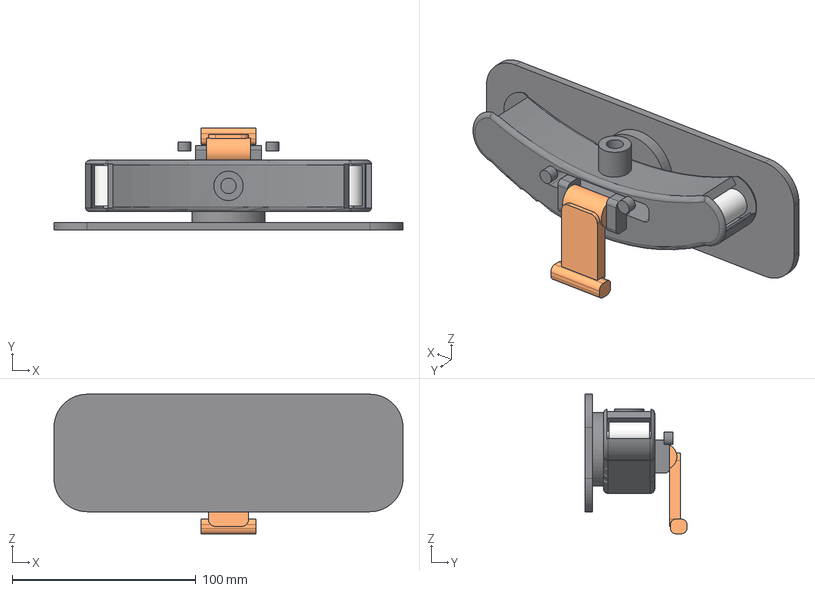
[picture p92: CAD file, 2026-11-09]
cad/out/step/linkage_hub_assembly.step
190.0 x 55.5 x 76.0 mm
hub_housing
rollers
cam_lever
pivot_plate
