wentingjie001-cmd/-/cad/out/step/backpack_40L_assembly.step

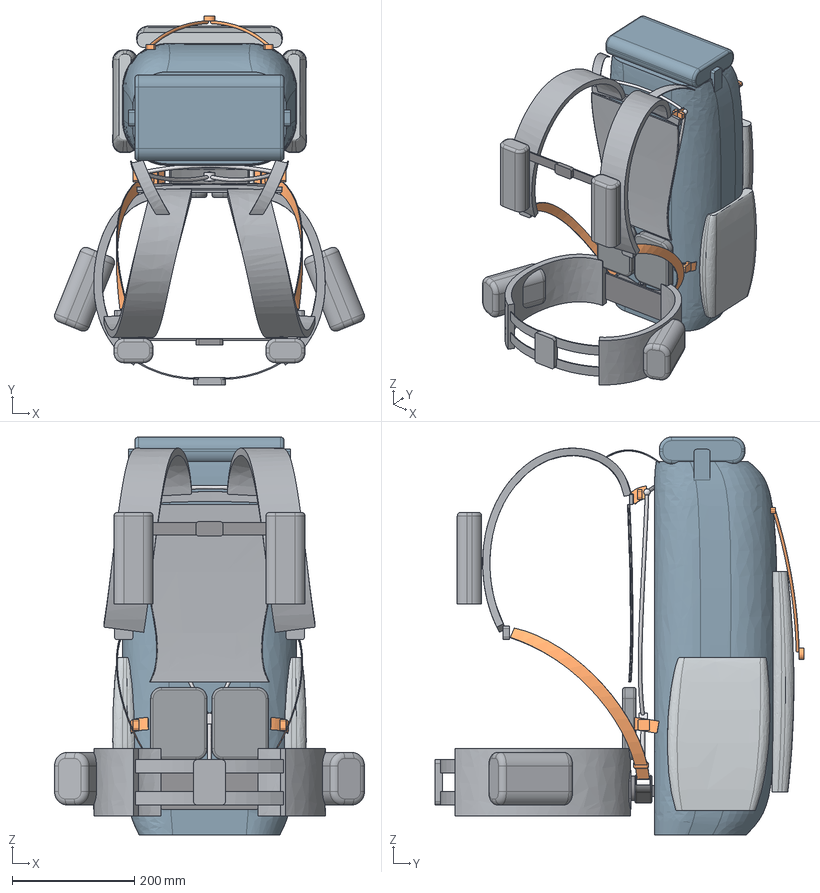
[picture p93: CAD file, 2026-11-09]
cad/out/step/backpack_40L_assembly.step
506.3 x 602.0 x 650.0 mm
pack_body
front_pocket
compression_bands
side_pockets
y_frame
mesh_panel
lumbar_pad
tension_straps
hub_housing
rollers
cam_lever
pivot_plate
webbing
shoulder_strap_l
shoulder_strap_r
sternum_strap
hip_belt_l
hip_belt_r
