wentingjie001-cmd/-/cad/out/benchmark_aarn_pm40/detail/hardware/sternum_slider.step

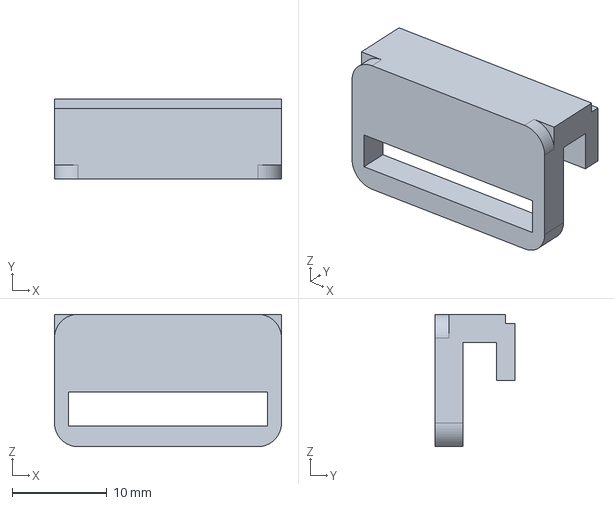
[picture p94: CAD file, 2026-11-09]
cad/out/benchmark_aarn_pm40/detail/hardware/sternum_slider.step
24.0 x 8.50 x 14.0 mm
