wentingjie001-cmd/-/cad/out/benchmark_aarn_pm40/detail/step/aarn_pm40_hardware_in_place.step

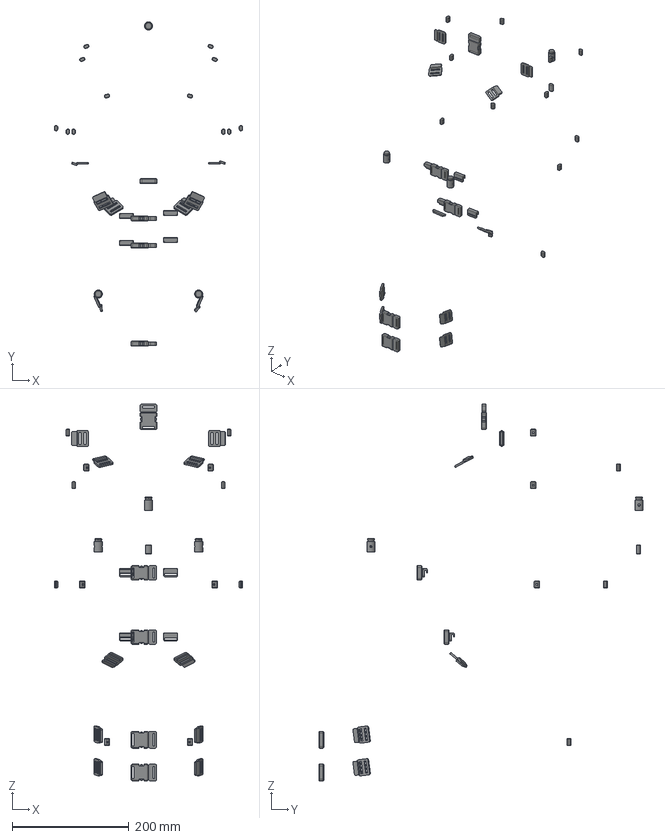
[picture p95: CAD file, 2026-11-09]
cad/out/benchmark_aarn_pm40/detail/step/aarn_pm40_hardware_in_place.step
322.7 x 555.4 x 645.6 mm
H01
H02
H03
H04
H05
H06
H07
H08
H09
H10
H11
H12
