wentingjie001-cmd/-/cad/out/benchmark_aarn_pm40/step/aarn_x_stays.step

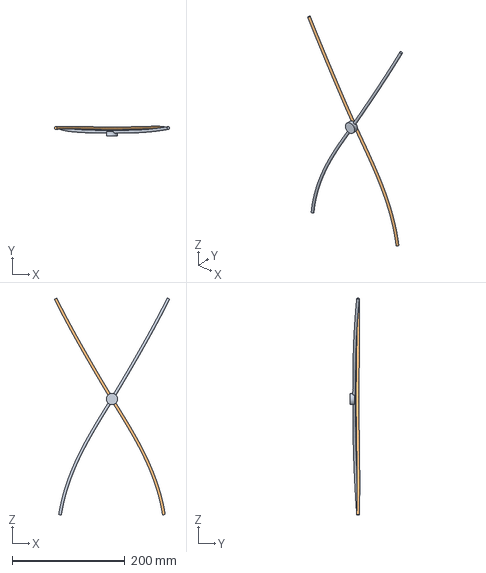
[picture p96: CAD file, 2026-11-09]
cad/out/benchmark_aarn_pm40/step/aarn_x_stays.step
204.5 x 17.0 x 384.6 mm
