wentingjie001-cmd/-/cad/out/benchmark_aarn_pm40/stl/aarn_pm40_scale_1to4.stl

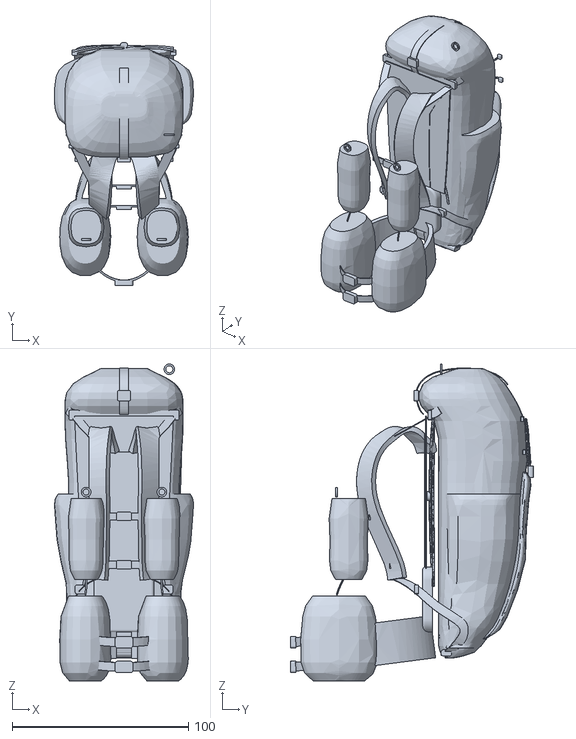
[picture p97: CAD file, 2026-11-09]
cad/out/benchmark_aarn_pm40/stl/aarn_pm40_scale_1to4.stl
79.0 x 137.9 x 180.0
