wentingjie001-cmd/-/cad/out/drawings/BP40-HUB-001_linkage_hub.dxf

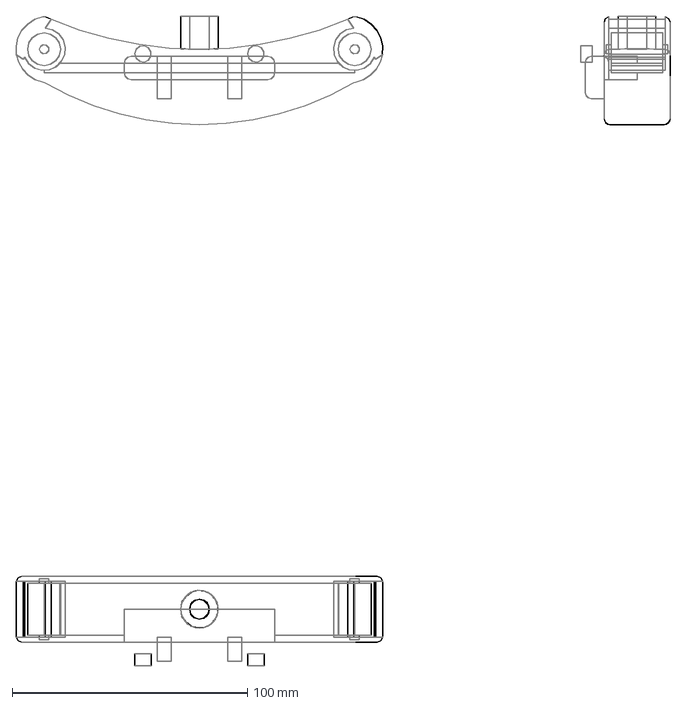
[picture p98: CAD file, 2026-11-09]
cad/out/drawings/BP40-HUB-001_linkage_hub.dxf
277.9 x 276.0 mm
