wentingjie001-cmd/-/cad/out/production/dxf/BP40-A1_marker_M10.dxf

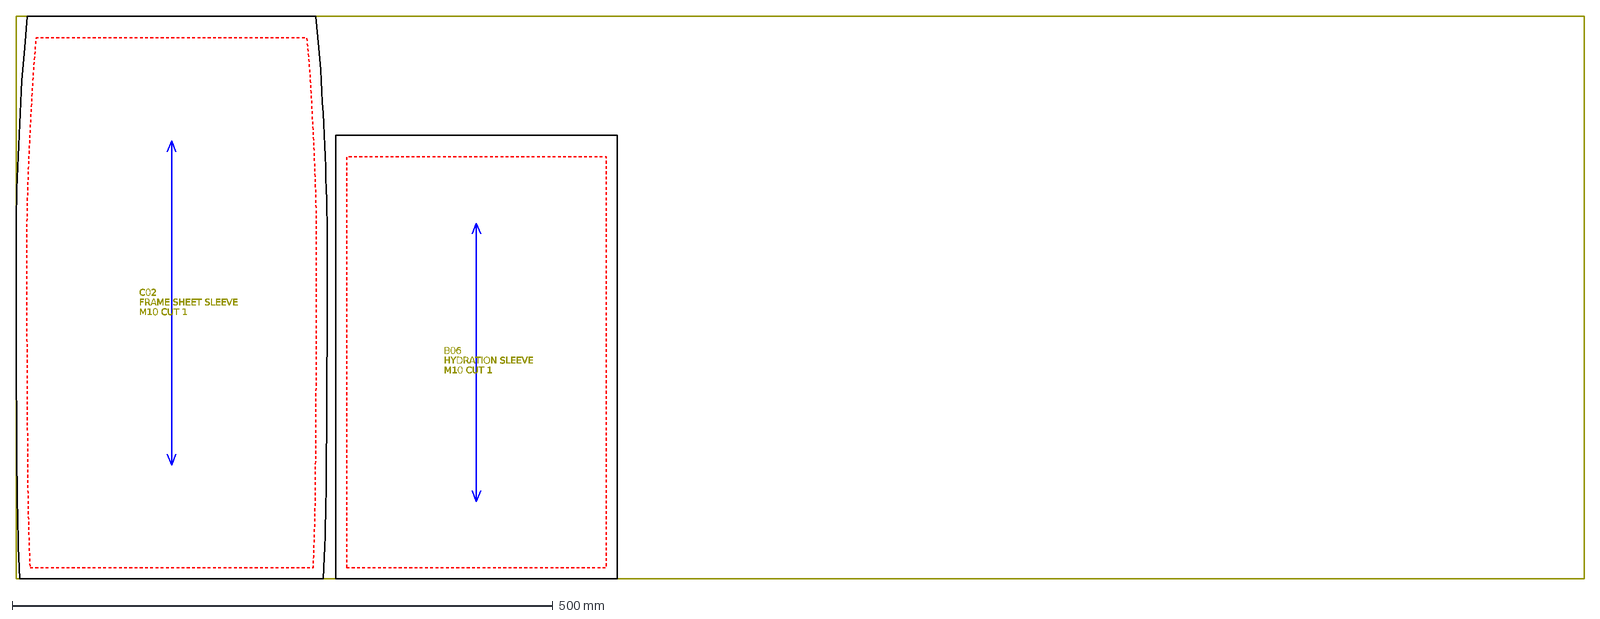
[picture p99: CAD file, 2026-11-12]
cad/out/production/dxf/BP40-A1_marker_M10.dxf
C02
FRAME SHEET SLEEVE
M10 CUT 1
B06
HYDRATION SLEEVE
