wentingjie001-cmd/-/cad/out/production/dxf/pieces/BP40-A1_C06.dxf

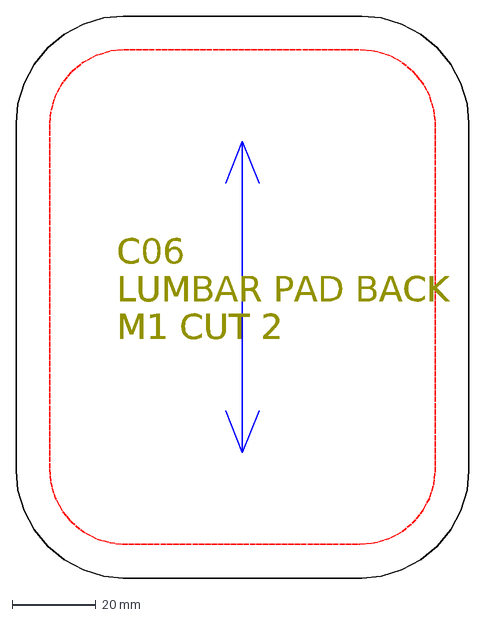
[picture p100: CAD file, 2026-11-12]
cad/out/production/dxf/pieces/BP40-A1_C06.dxf
C06
LUMBAR PAD BACK
M1 CUT 2
