wentingjie001-cmd/-/cad/out/step/pivot_plate.step

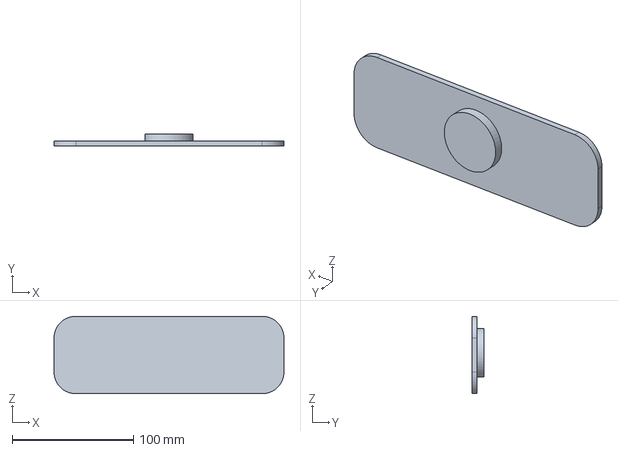
[picture p101: CAD file, 2026-11-09]
cad/out/step/pivot_plate.step
190.0 x 10.0 x 64.0 mm
