wentingjie001-cmd/-/cad/out/benchmark_aarn_pm40/detail/hardware/side_release_buckle_20mm_female.step

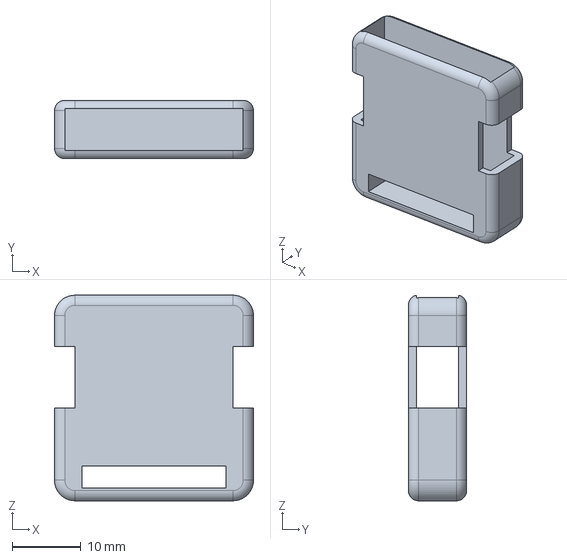
[picture p102: CAD file, 2026-11-09]
cad/out/benchmark_aarn_pm40/detail/hardware/side_release_buckle_20mm_female.step
29.0 x 8.50 x 30.0 mm
