wentingjie001-cmd/-/cad/out/production/dxf/BP40-A1_marker_M9.dxf

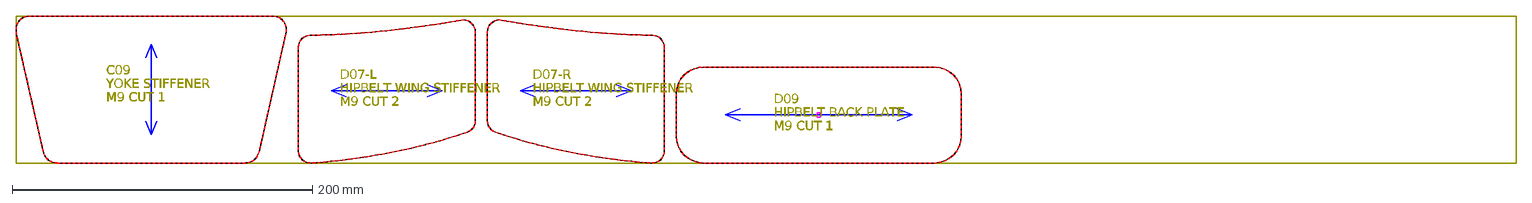
[picture p103: CAD file, 2026-11-12]
cad/out/production/dxf/BP40-A1_marker_M9.dxf
C09
YOKE STIFFENER
M9 CUT 1
D07-L
HIPBELT WING STIFFENER
M9 CUT 2
D07-R
D09
HIPBELT BACK PLATE
