wentingjie001-cmd/-/cad/out/production/dxf/pieces/BP40-A1_D03.dxf

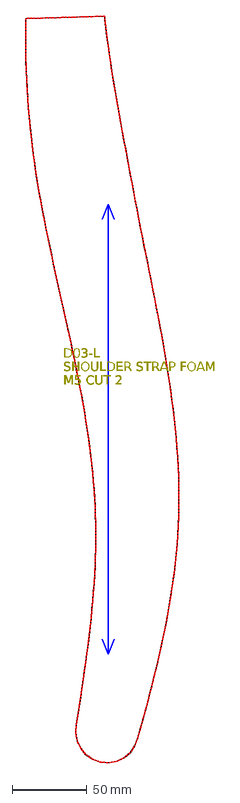
[picture p104: CAD file, 2026-11-12]
cad/out/production/dxf/pieces/BP40-A1_D03.dxf
D03-L
SHOULDER STRAP FOAM
M5 CUT 2
