wentingjie001-cmd/-/cad/out/step/hub_housing.step

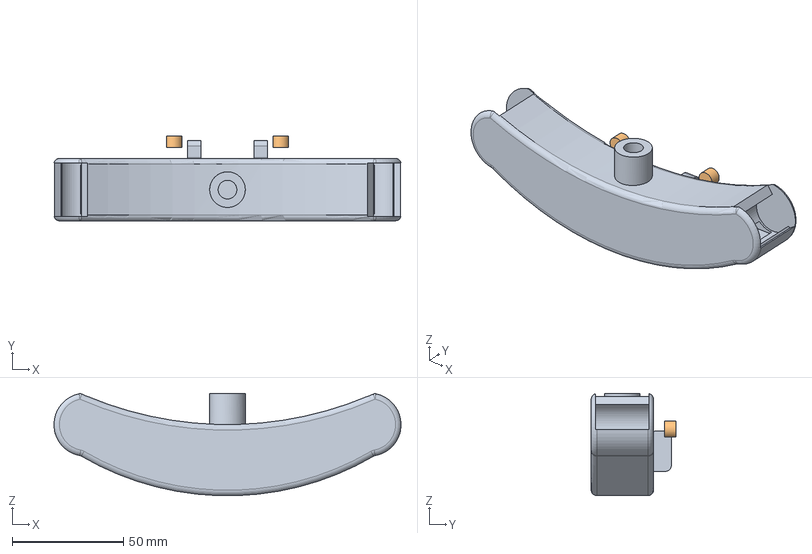
[picture p105: CAD file, 2026-11-09]
cad/out/step/hub_housing.step
155.9 x 38.0 x 45.9 mm
