wentingjie001-cmd/-/cad/out/stl/cam_lever_1to1.stl

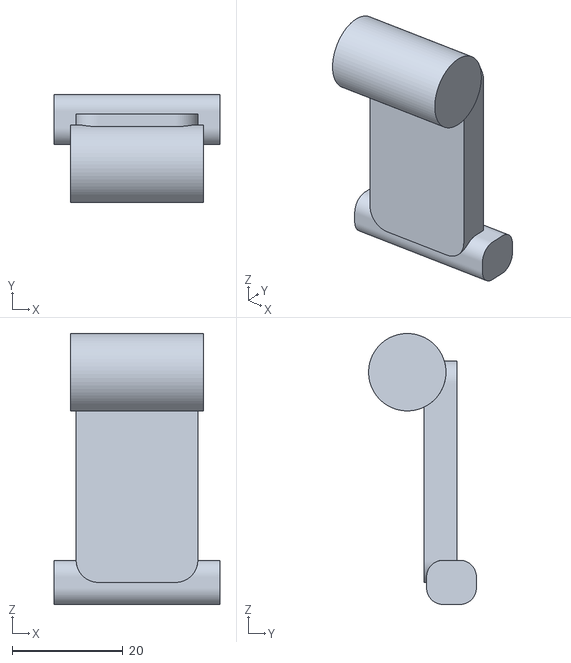
[picture p106: CAD file, 2026-11-09]
cad/out/stl/cam_lever_1to1.stl
30.0 x 19.5 x 49.0
