wentingjie001-cmd/-/cad/out/benchmark_aarn_pm40/detail/hardware/ladder_lock_20mm.step

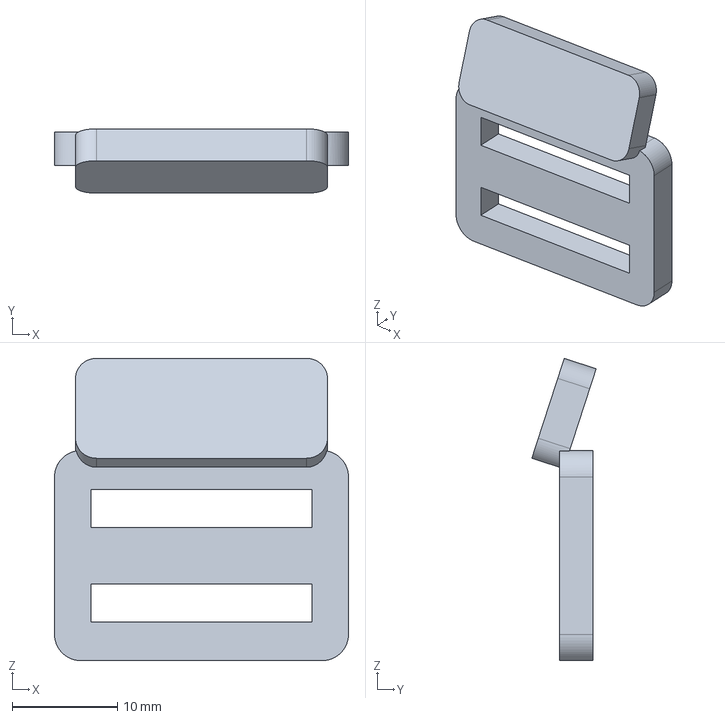
[picture p107: CAD file, 2026-11-09]
cad/out/benchmark_aarn_pm40/detail/hardware/ladder_lock_20mm.step
28.0 x 6.13 x 28.8 mm
