wentingjie001-cmd/-/cad/out/production/dxf/BP40-A1_marker_M11.dxf

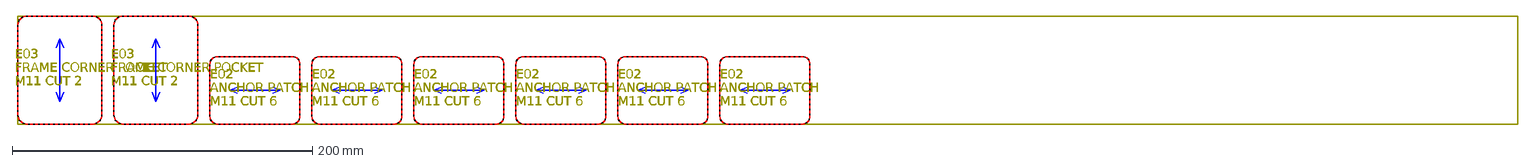
[picture p108: CAD file, 2026-11-12]
cad/out/production/dxf/BP40-A1_marker_M11.dxf
E03
FRAME CORNER POCKET
M11 CUT 2
E02
ANCHOR PATCH
M11 CUT 6
