wentingjie001-cmd/-/cad/out/production/dxf/pieces/BP40-A1_D06.dxf

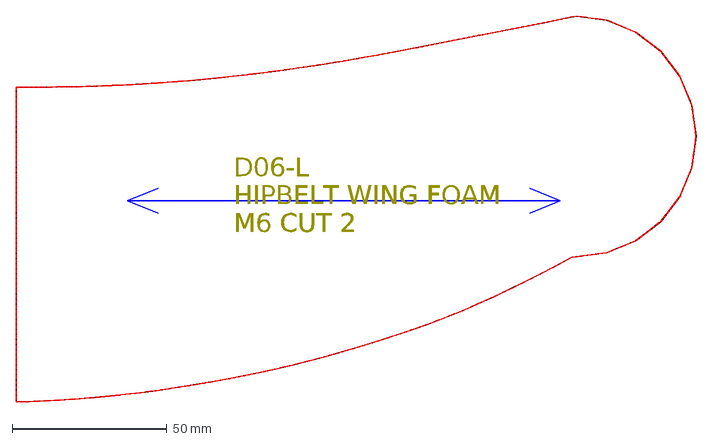
[picture p109: CAD file, 2026-11-12]
cad/out/production/dxf/pieces/BP40-A1_D06.dxf
D06-L
HIPBELT WING FOAM
M6 CUT 2
