wentingjie001-cmd/-/cad/out/benchmark_aarn_pm40/detail/hardware/side_release_buckle_20mm_male.step

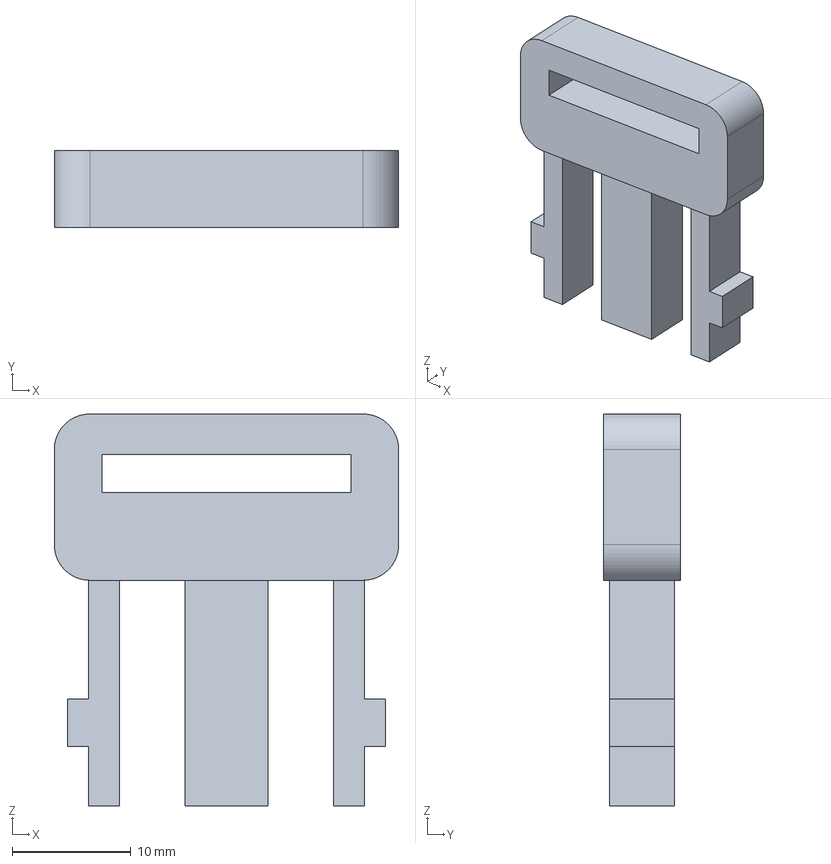
[picture p111: CAD file, 2026-11-09]
cad/out/benchmark_aarn_pm40/detail/hardware/side_release_buckle_20mm_male.step
29.0 x 6.50 x 33.0 mm
