wentingjie001-cmd/-/cad/out/production/dxf/BP40-A1_marker_M7.dxf

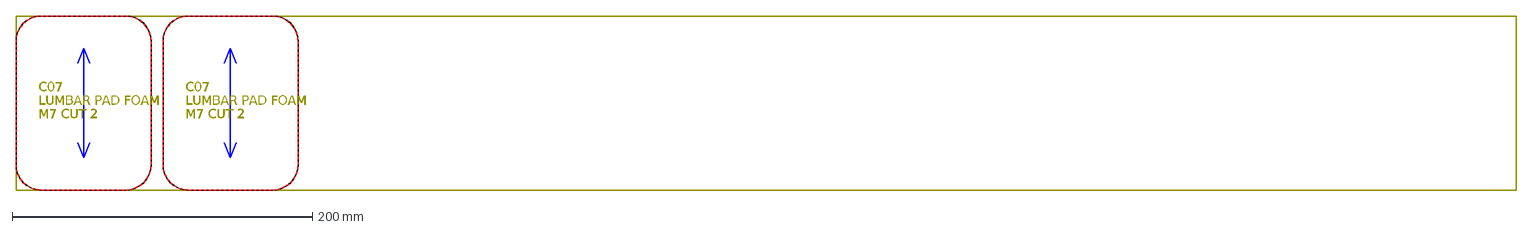
[picture p112: CAD file, 2026-11-12]
cad/out/production/dxf/BP40-A1_marker_M7.dxf
C07
LUMBAR PAD FOAM
M7 CUT 2
