wentingjie001-cmd/-/cad/out/production/dxf/pieces/BP40-A1_D02.dxf

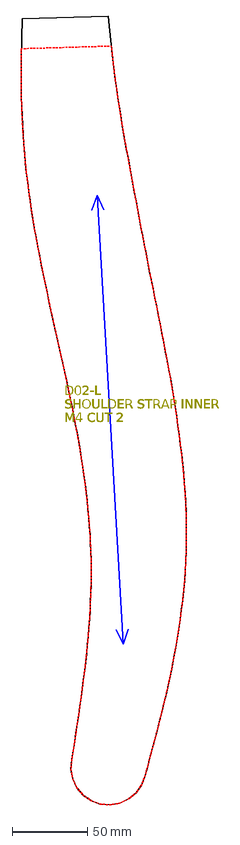
[picture p113: CAD file, 2026-11-12]
cad/out/production/dxf/pieces/BP40-A1_D02.dxf
D02-L
SHOULDER STRAP INNER
M4 CUT 2
