wentingjie001-cmd/-/cad/out/production/dxf/BP40-A1_marker_M2.dxf

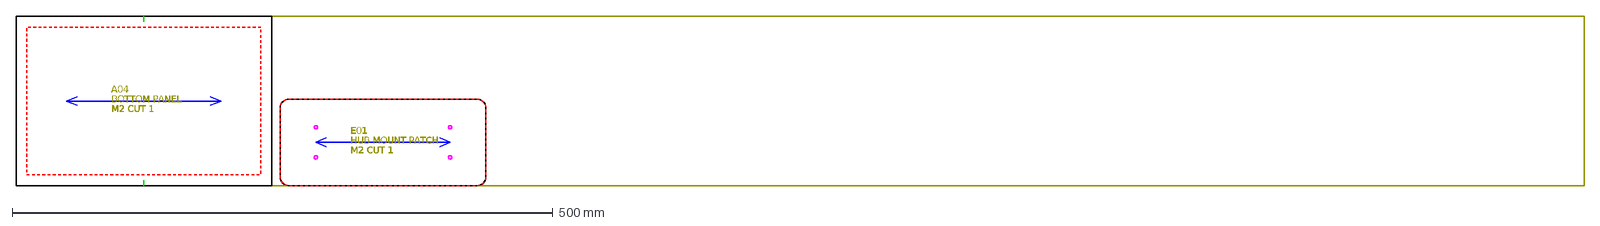
[picture p114: CAD file, 2026-11-12]
cad/out/production/dxf/BP40-A1_marker_M2.dxf
A04
BOTTOM PANEL
M2 CUT 1
E01
HUB MOUNT PATCH
