wentingjie001-cmd/-/cad/out/production/dxf/pieces/BP40-A1_C03.dxf

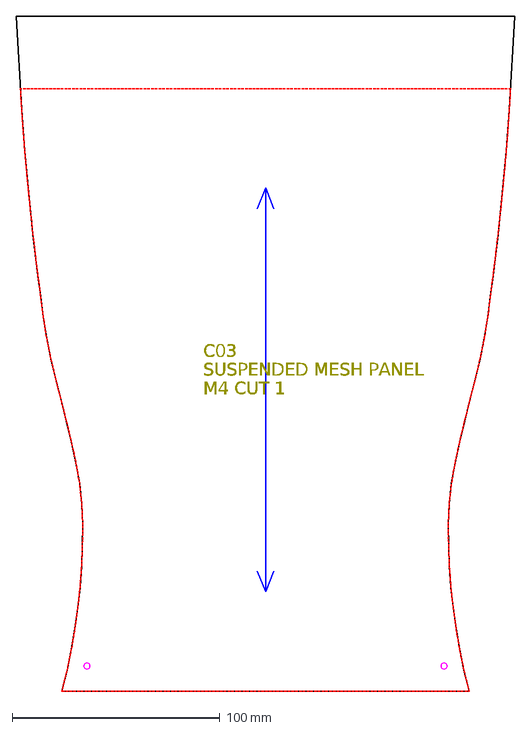
[picture p115: CAD file, 2026-11-12]
cad/out/production/dxf/pieces/BP40-A1_C03.dxf
C03
SUSPENDED MESH PANEL
M4 CUT 1
