wentingjie001-cmd/-/cad/out/step/rollers.step

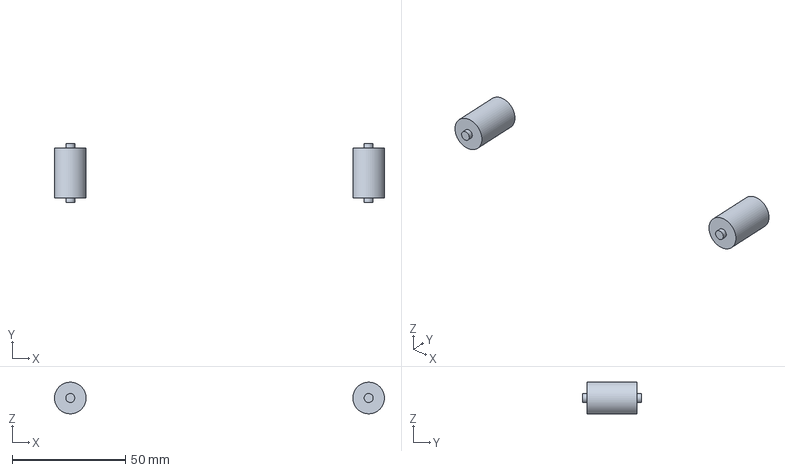
[picture p116: CAD file, 2026-11-09]
cad/out/step/rollers.step
146.0 x 26.0 x 14.0 mm
