wentingjie001-cmd/-/cad/out/production/dxf/BP40-A1_marker_M8.dxf

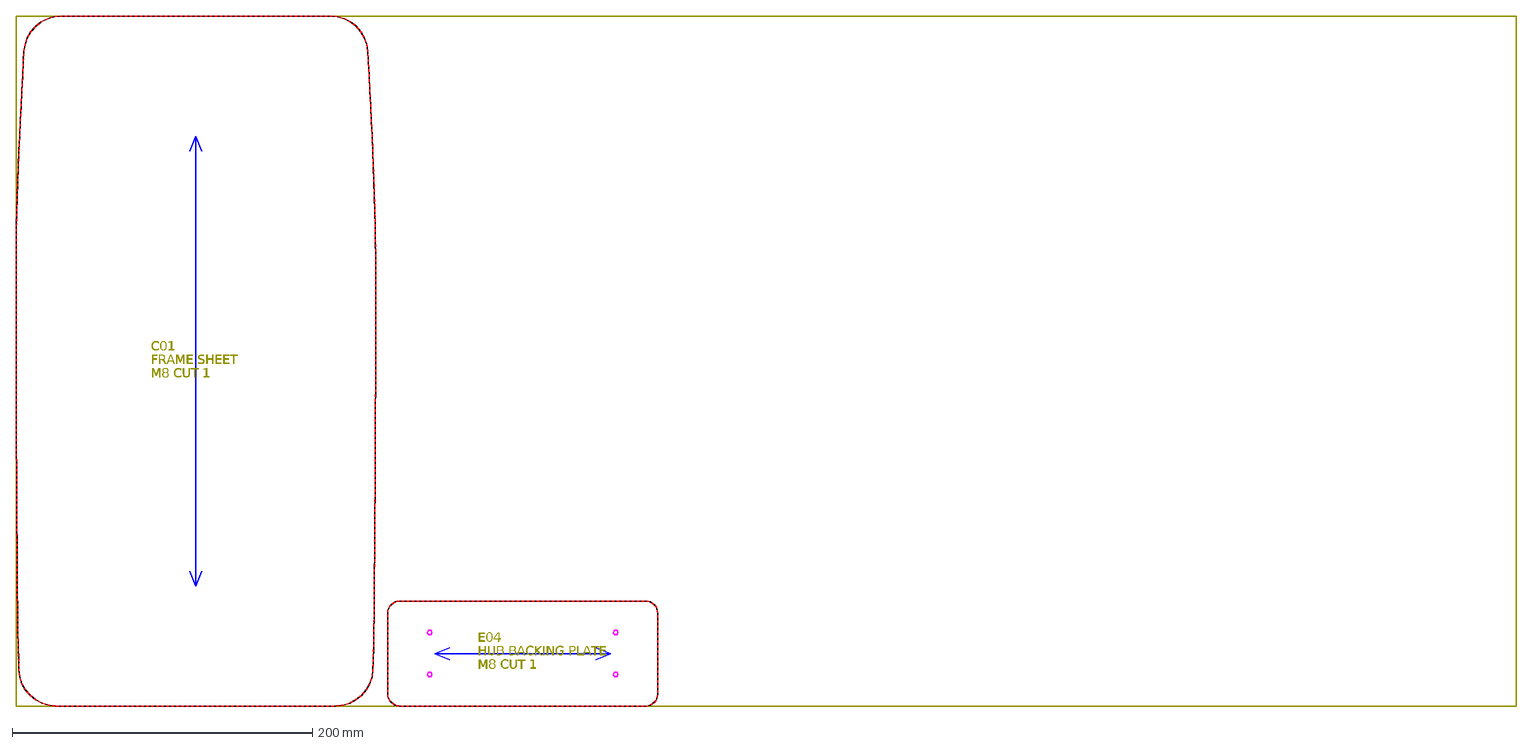
[picture p117: CAD file, 2026-11-12]
cad/out/production/dxf/BP40-A1_marker_M8.dxf
C01
FRAME SHEET
M8 CUT 1
E04
HUB BACKING PLATE
