wentingjie001-cmd/-/cad/out/production/dxf/pieces/BP40-A1_A01.dxf

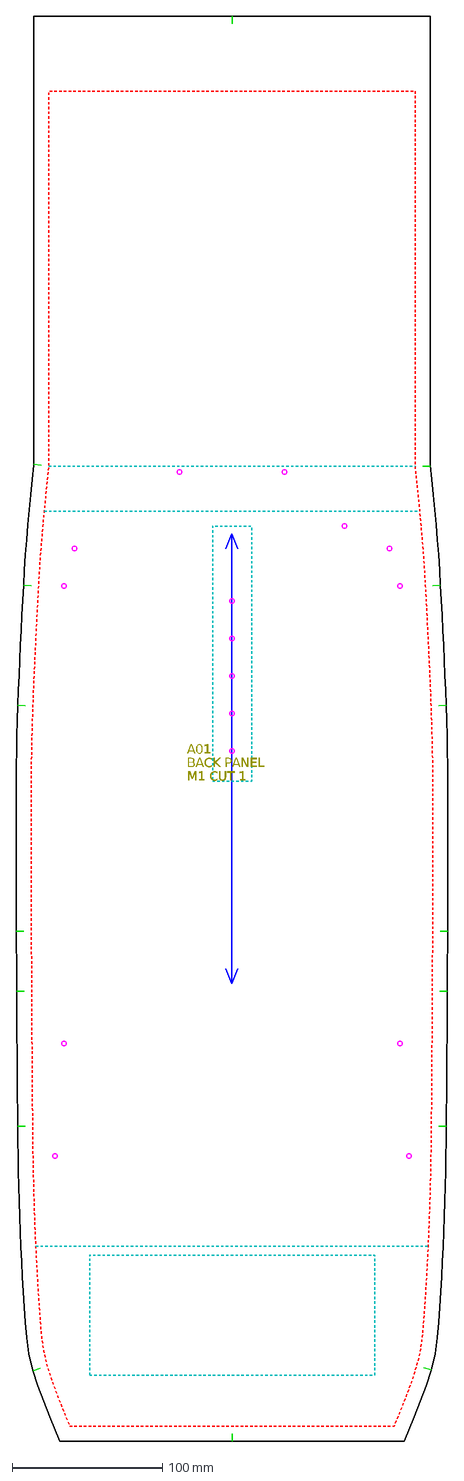
[picture p118: CAD file, 2026-11-12]
cad/out/production/dxf/pieces/BP40-A1_A01.dxf
A01
BACK PANEL
M1 CUT 1
