wentingjie001-cmd/-/cad/out/stl/backpack_scale_1to4.stl

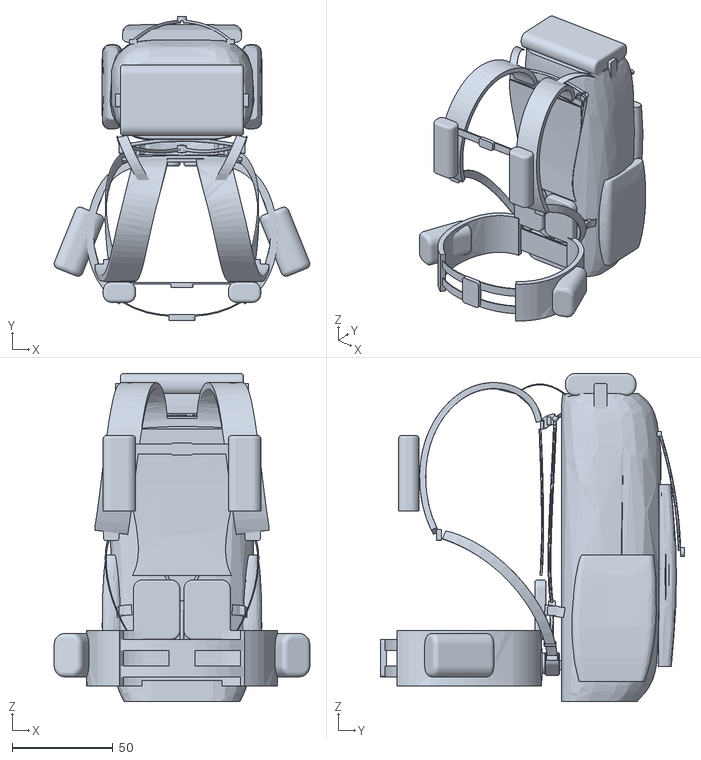
[picture p119: CAD file, 2026-11-09]
cad/out/stl/backpack_scale_1to4.stl
126.6 x 150.5 x 162.5
