wentingjie001-cmd/-/cad/out/production/dxf/BP40-A1_marker_M4.dxf

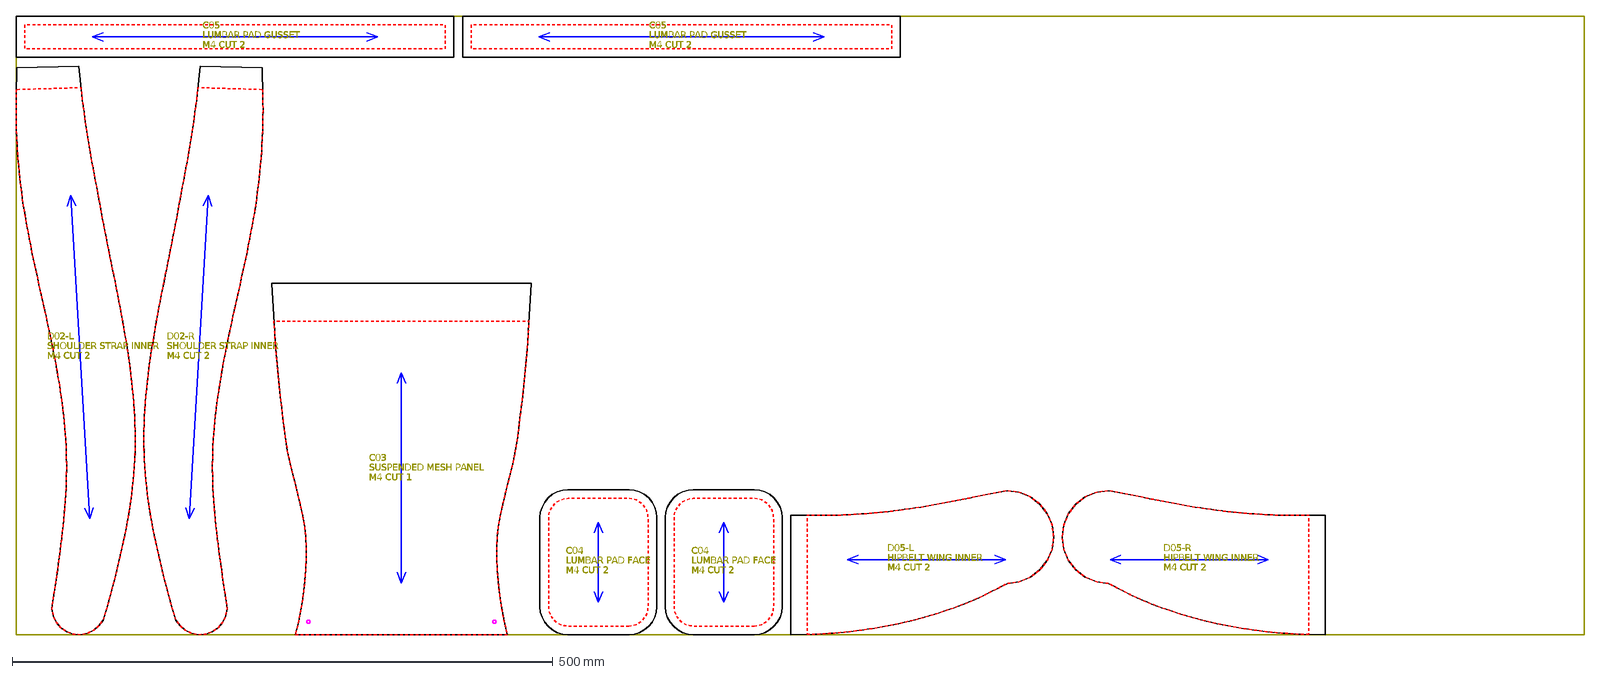
[picture p120: CAD file, 2026-11-12]
cad/out/production/dxf/BP40-A1_marker_M4.dxf
D02-L
SHOULDER STRAP INNER
M4 CUT 2
D02-R
C03
SUSPENDED MESH PANEL
M4 CUT 1
C04
LUMBAR PAD FACE
D05-L
HIPBELT WING INNER
D05-R
C05
LUMBAR PAD GUSSET
