wentingjie001-cmd/-/cad/out/production/dxf/pieces/BP40-A1_B04.dxf

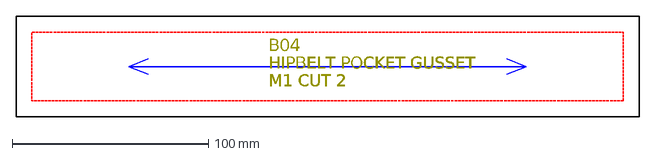
[picture p121: CAD file, 2026-11-12]
cad/out/production/dxf/pieces/BP40-A1_B04.dxf
B04
HIPBELT POCKET GUSSET
M1 CUT 2
