wentingjie001-cmd/-/cad/out/step/y_frame.step

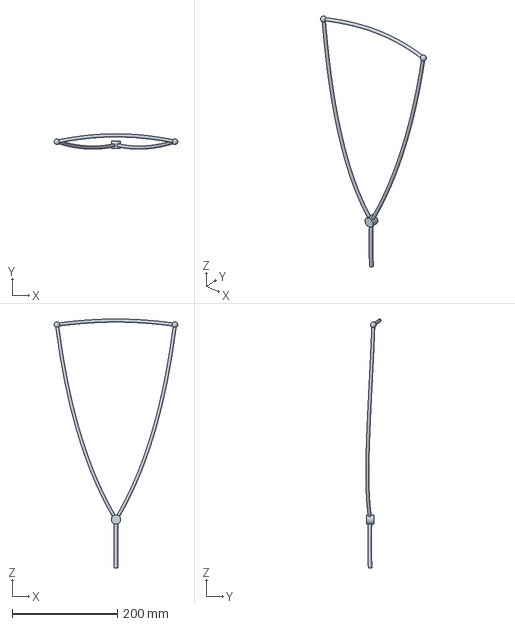
[picture p122: CAD file, 2026-11-09]
cad/out/step/y_frame.step
235.0 x 29.4 x 473.2 mm
