wentingjie001-cmd/-/cad/out/stl/hub_rear_shell_1to1.stl

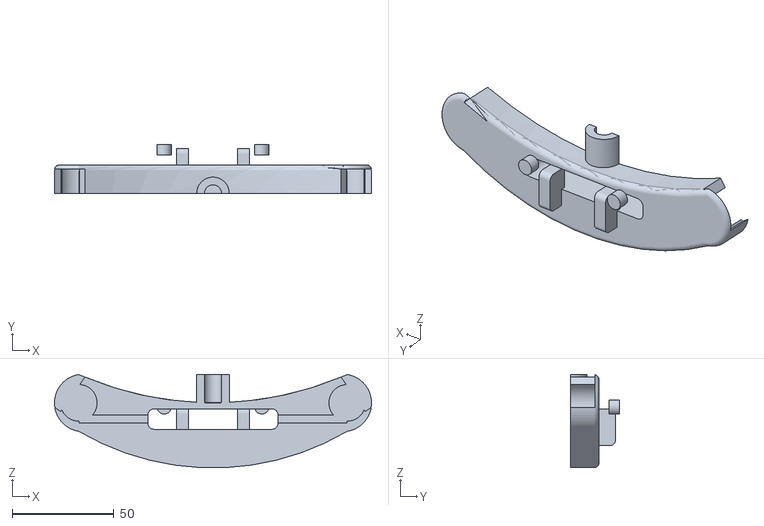
[picture p123: CAD file, 2026-11-09]
cad/out/stl/hub_rear_shell_1to1.stl
155.9 x 24.0 x 45.8
