wentingjie001-cmd/-/cad/out/production/dxf/BP40-A1_marker_M1.dxf

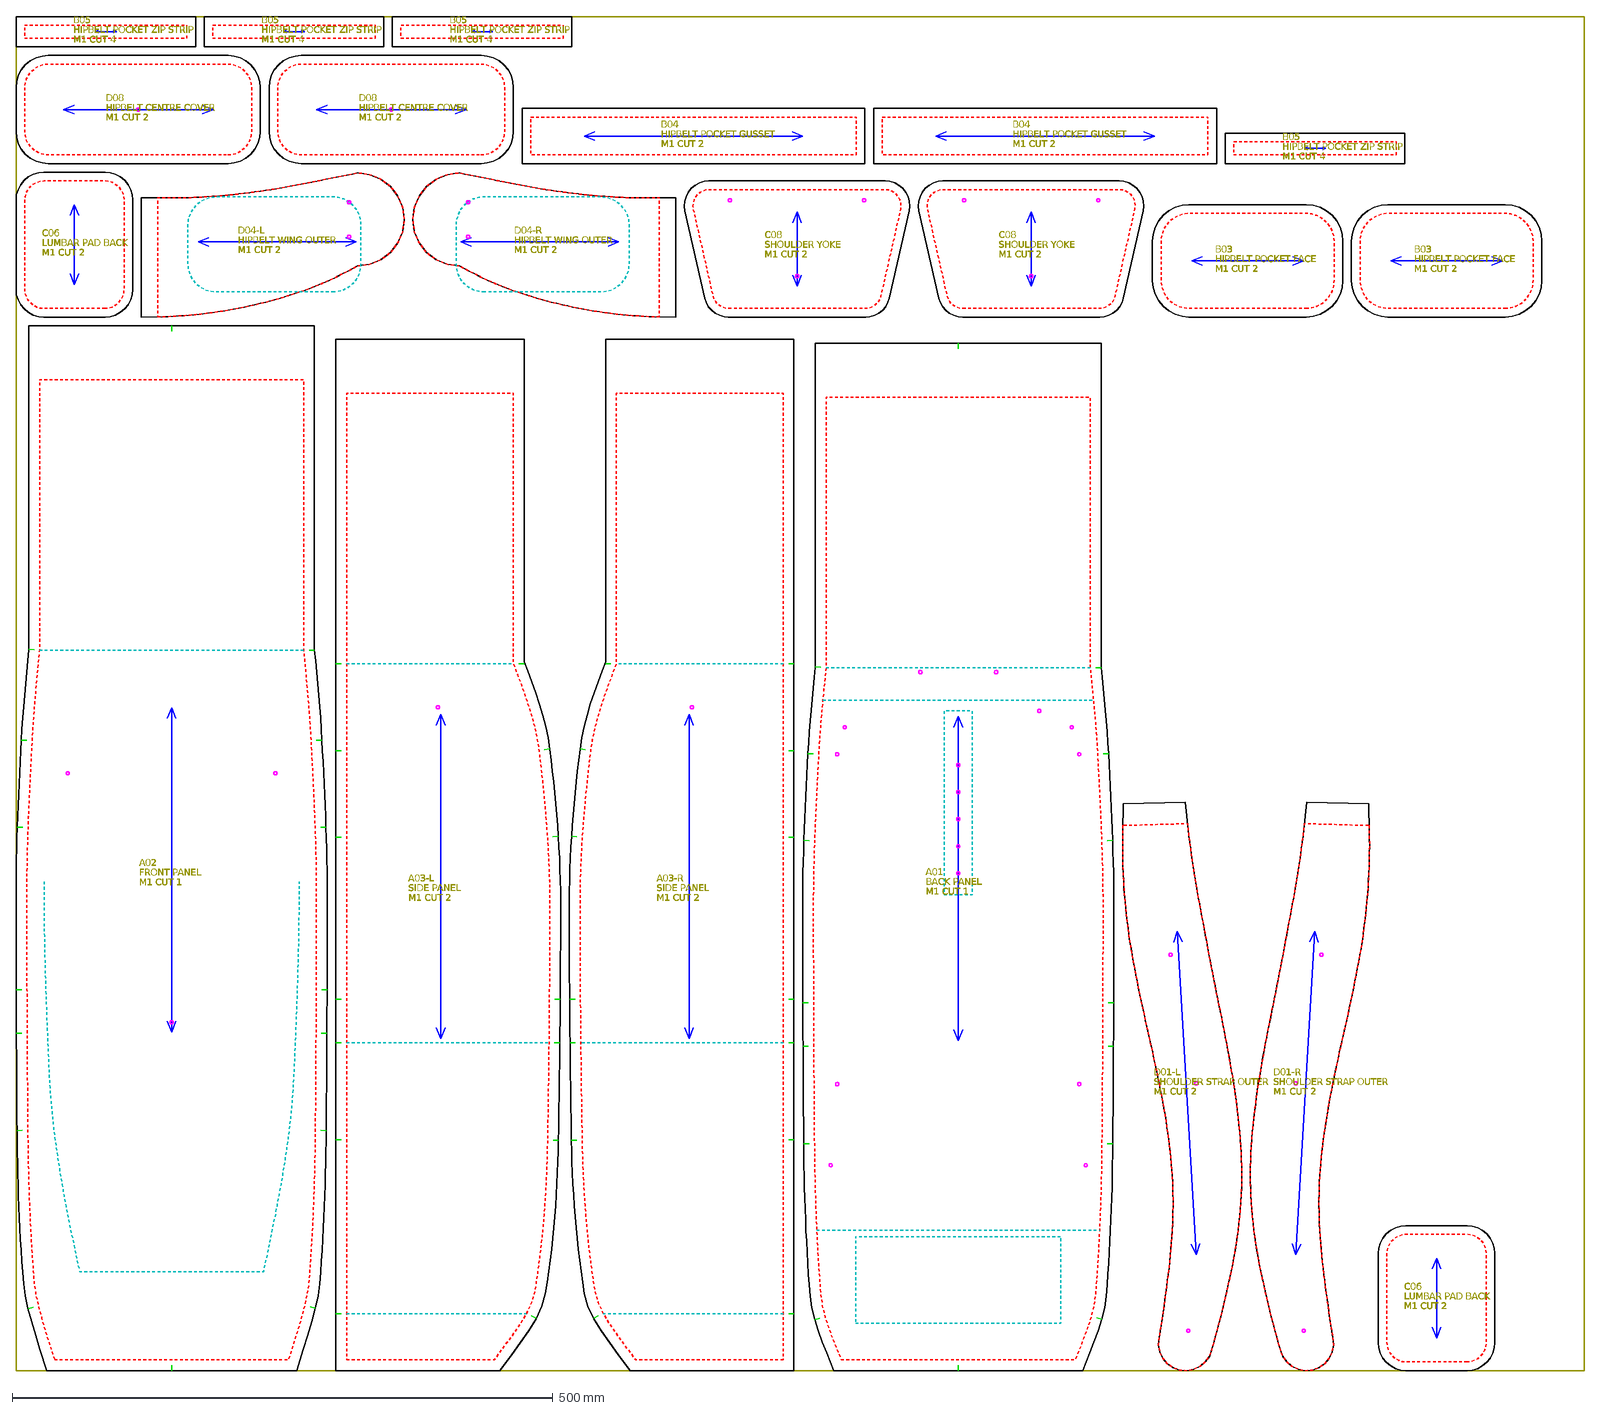
[picture p124: CAD file, 2026-11-12]
cad/out/production/dxf/BP40-A1_marker_M1.dxf
A02
FRONT PANEL
M1 CUT 1
A03-L
SIDE PANEL
M1 CUT 2
A03-R
A01
BACK PANEL
D01-L
SHOULDER STRAP OUTER
D01-R
C06
LUMBAR PAD BACK
D04-L
HIPBELT WING OUTER
D04-R
C08
SHOULDER YOKE
B03
HIPBELT POCKET FACE
D08
HIPBELT CENTRE COVER
B04
HIPBELT POCKET GUSSET
B05
HIPBELT POCKET ZIP STRIP
M1 CUT 4
