wentingjie001-cmd/-/cad/out/production/dxf/pieces/BP40-A1_C09.dxf

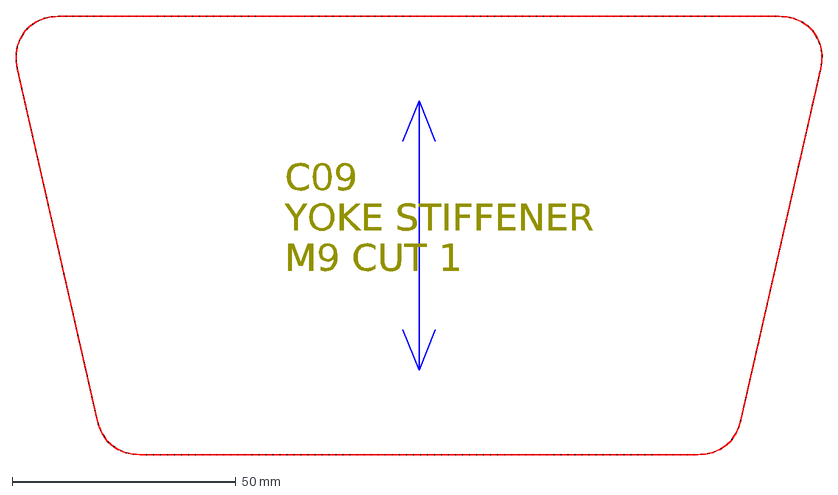
[picture p125: CAD file, 2026-11-12]
cad/out/production/dxf/pieces/BP40-A1_C09.dxf
C09
YOKE STIFFENER
M9 CUT 1
