wentingjie001-cmd/-/cad/out/production/dxf/BP40-A1_marker_M5.dxf

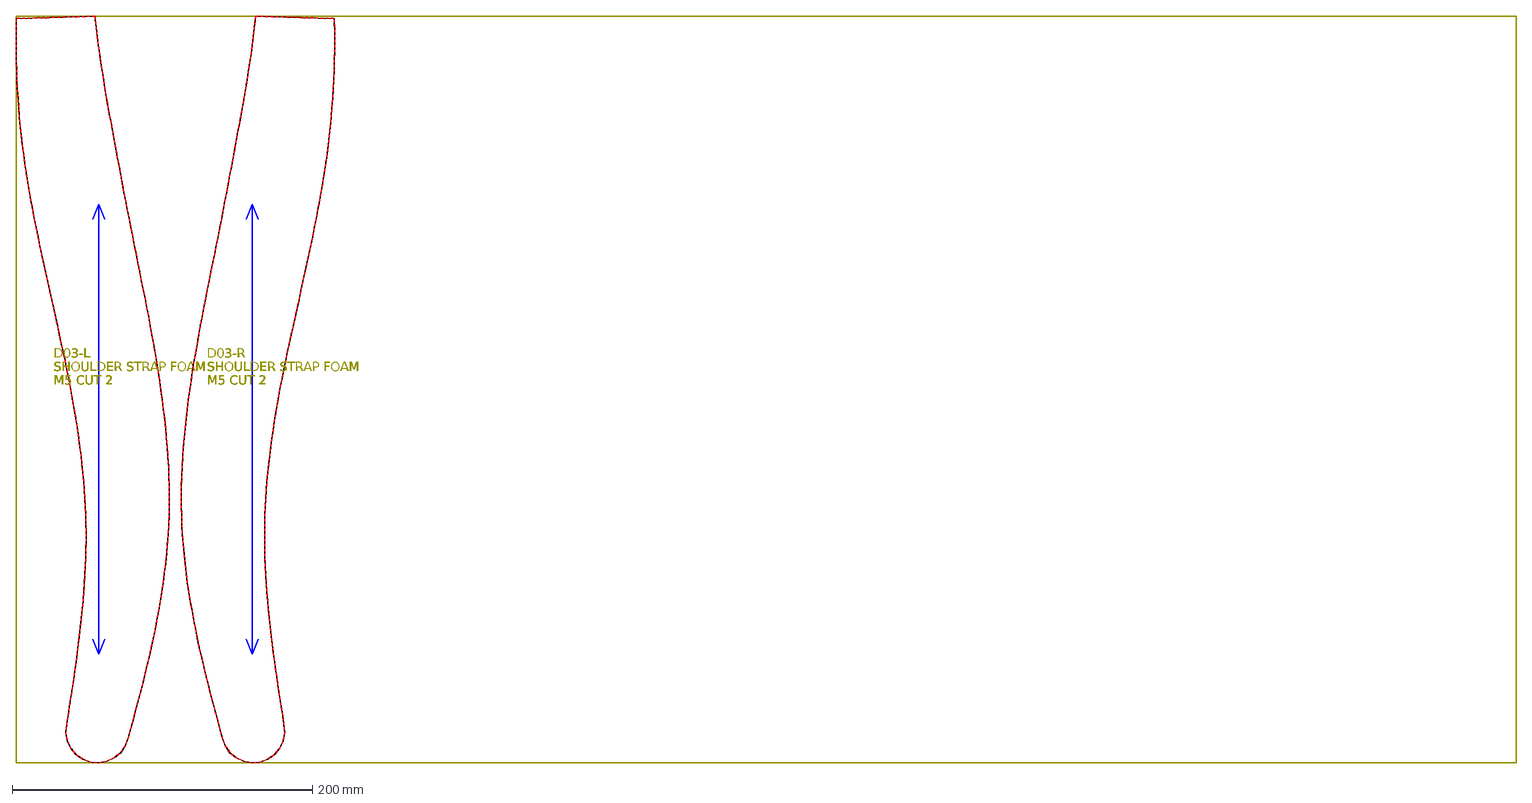
[picture p126: CAD file, 2026-11-12]
cad/out/production/dxf/BP40-A1_marker_M5.dxf
D03-L
SHOULDER STRAP FOAM
M5 CUT 2
D03-R
