wentingjie001-cmd/-/cad/out/production/dxf/pieces/BP40-A1_C02.dxf

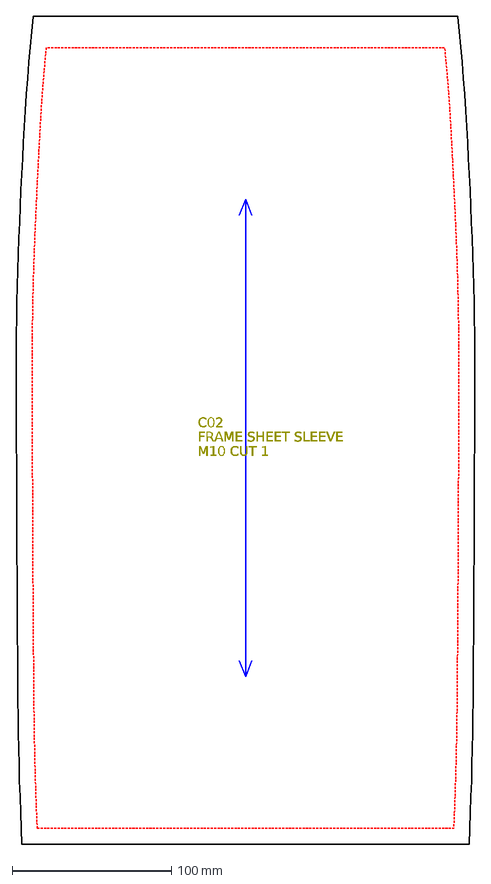
[picture p127: CAD file, 2026-11-12]
cad/out/production/dxf/pieces/BP40-A1_C02.dxf
C02
FRAME SHEET SLEEVE
M10 CUT 1
