wentingjie001-cmd/-/cad/out/production/dxf/BP40-A1_marker_M6.dxf

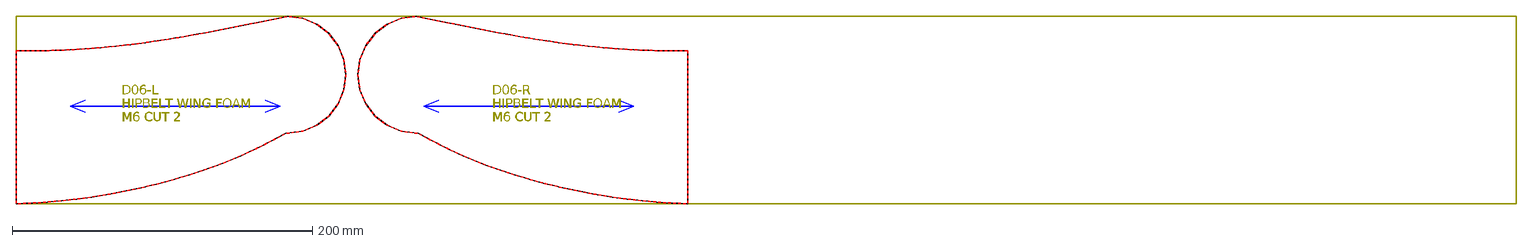
[picture p128: CAD file, 2026-11-12]
cad/out/production/dxf/BP40-A1_marker_M6.dxf
D06-L
HIPBELT WING FOAM
M6 CUT 2
D06-R
