wentingjie001-cmd/-/cad/out/production/dxf/pieces/BP40-A1_B01.dxf

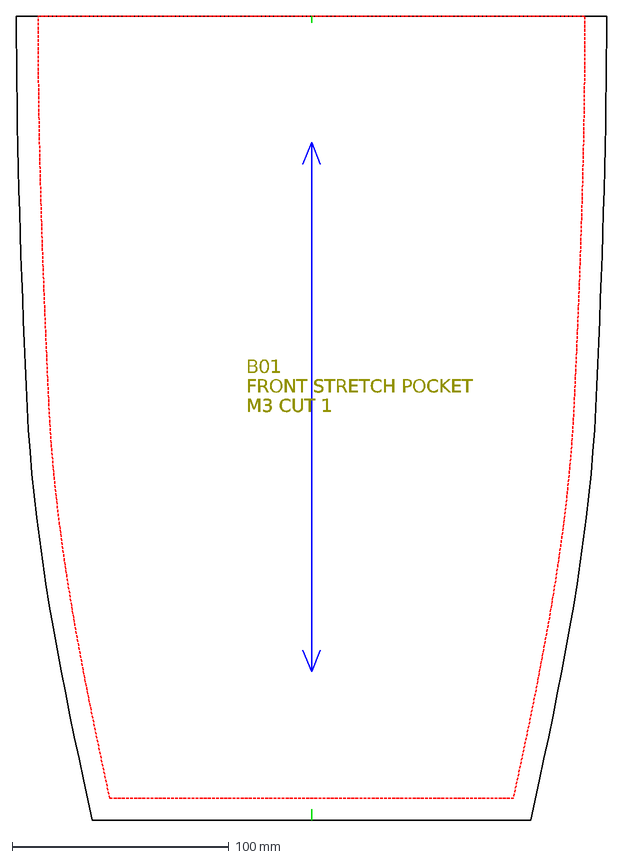
[picture p129: CAD file, 2026-11-12]
cad/out/production/dxf/pieces/BP40-A1_B01.dxf
B01
FRONT STRETCH POCKET
M3 CUT 1
