wentingjie001-cmd/-/cad/out/production/dxf/BP40-A1_marker_M3.dxf

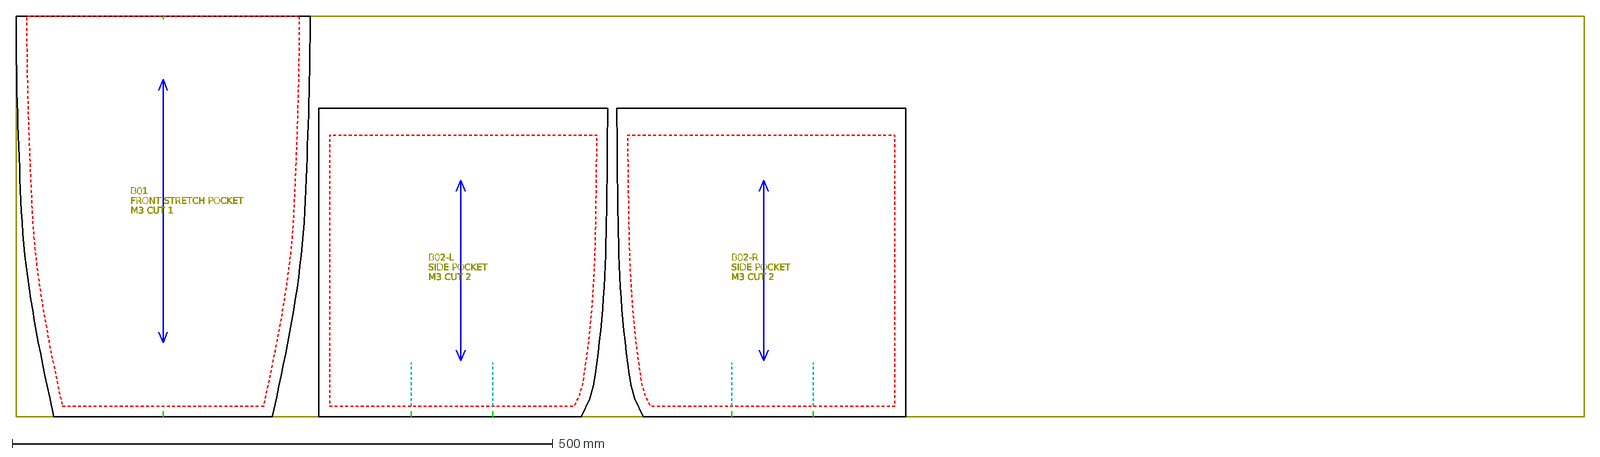
[picture p130: CAD file, 2026-11-12]
cad/out/production/dxf/BP40-A1_marker_M3.dxf
B01
FRONT STRETCH POCKET
M3 CUT 1
B02-L
SIDE POCKET
M3 CUT 2
B02-R
