wentingjie001-cmd/-/cad/out/production/dxf/pieces/BP40-A1_B02.dxf

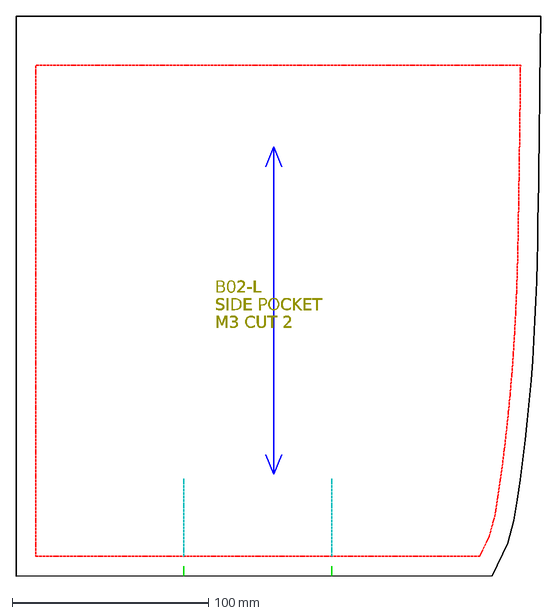
[picture p131: CAD file, 2026-11-12]
cad/out/production/dxf/pieces/BP40-A1_B02.dxf
B02-L
SIDE POCKET
M3 CUT 2
