wentingjie001-cmd/-/cad/out/production/dxf/pieces/BP40-A1_D07.dxf

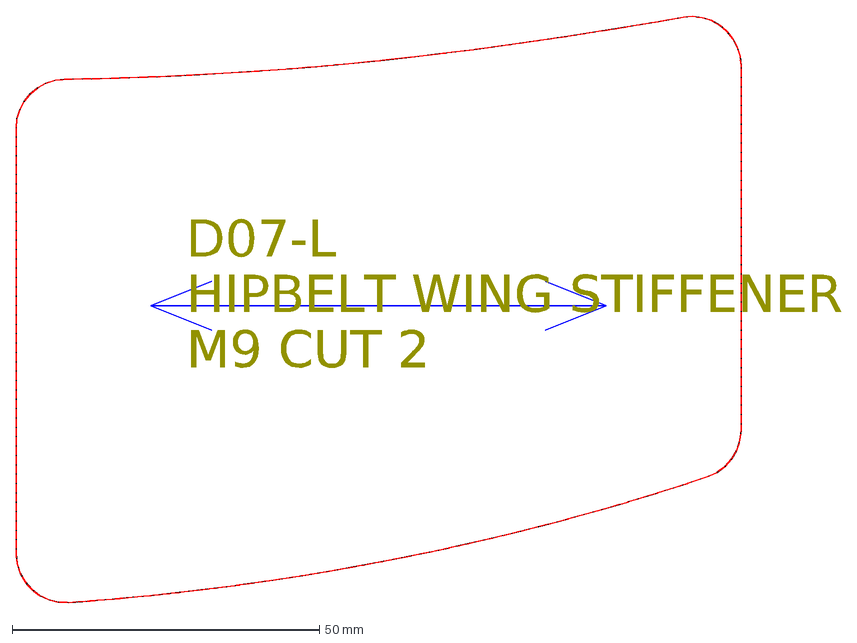
[picture p132: CAD file, 2026-11-12]
cad/out/production/dxf/pieces/BP40-A1_D07.dxf
D07-L
HIPBELT WING STIFFENER
M9 CUT 2
