wentingjie001-cmd/-/cad/out/production/dxf/pieces/BP40-A1_B06.dxf

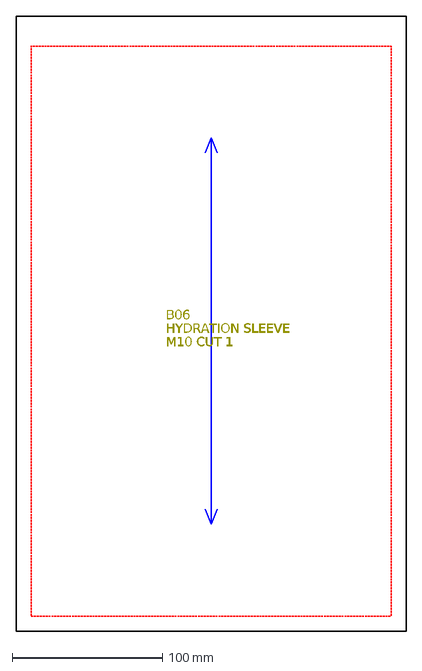
[picture p133: CAD file, 2026-11-12]
cad/out/production/dxf/pieces/BP40-A1_B06.dxf
B06
HYDRATION SLEEVE
M10 CUT 1
