wentingjie001-cmd/-/cad/out/production/dxf/pieces/BP40-A1_E02.dxf

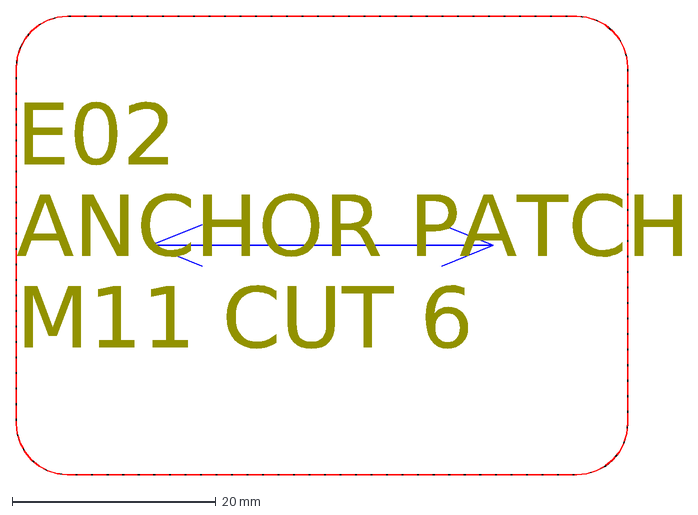
[picture p134: CAD file, 2026-11-12]
cad/out/production/dxf/pieces/BP40-A1_E02.dxf
E02
ANCHOR PATCH
M11 CUT 6
