wentingjie001-cmd/-/cad/out/production/dxf/pieces/BP40-A1_A04.dxf

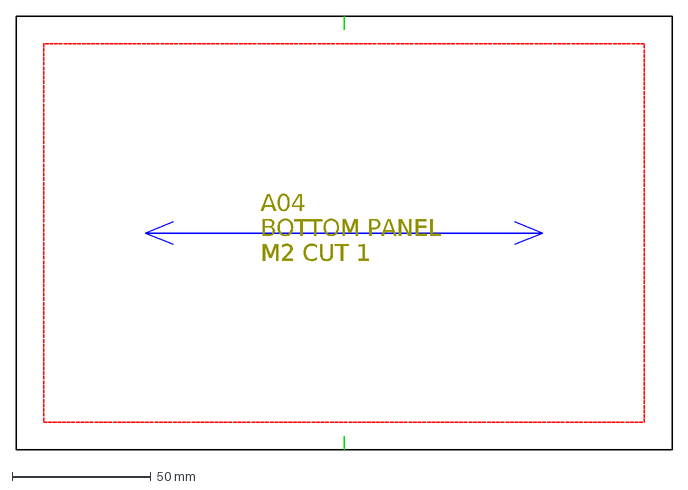
[picture p135: CAD file, 2026-11-12]
cad/out/production/dxf/pieces/BP40-A1_A04.dxf
A04
BOTTOM PANEL
M2 CUT 1
