wentingjie001-cmd/-/cad/out/production/dxf/pieces/BP40-A1_B03.dxf

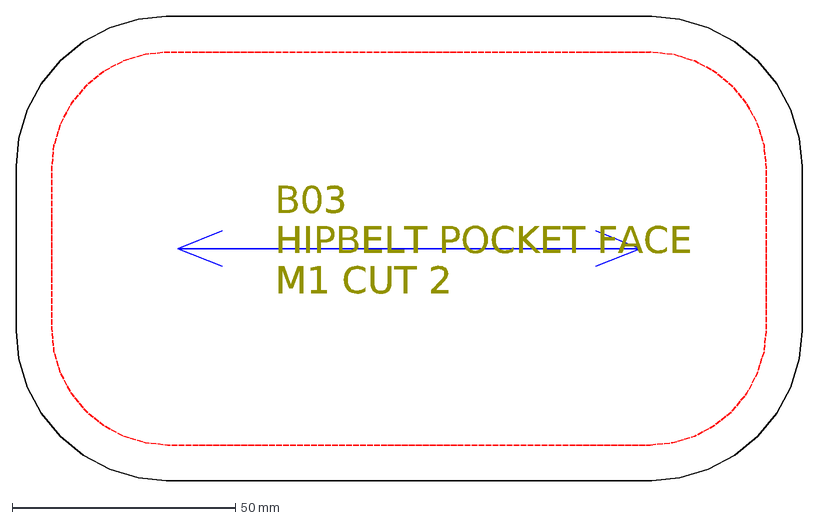
[picture p136: CAD file, 2026-11-12]
cad/out/production/dxf/pieces/BP40-A1_B03.dxf
B03
HIPBELT POCKET FACE
M1 CUT 2
