wentingjie001-cmd/-/cad/out/production/dxf/pieces/BP40-A1_D09.dxf

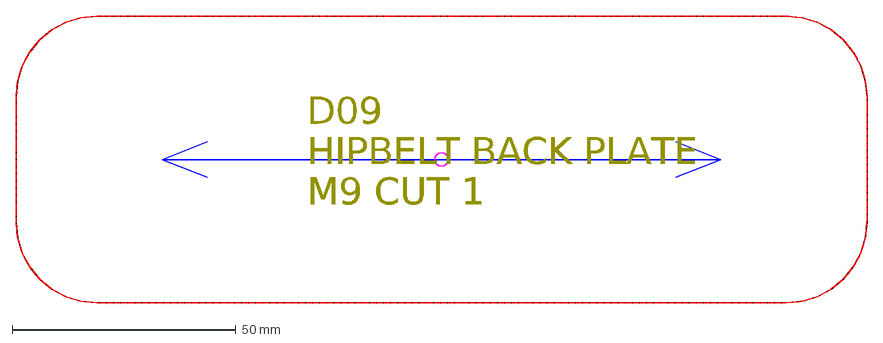
[picture p137: CAD file, 2026-11-12]
cad/out/production/dxf/pieces/BP40-A1_D09.dxf
D09
HIPBELT BACK PLATE
M9 CUT 1
