wentingjie001-cmd/-/cad/out/production/dxf/pieces/BP40-A1_E01.dxf

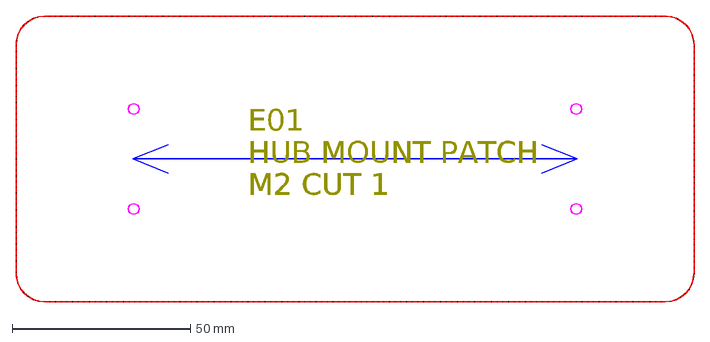
[picture p138: CAD file, 2026-11-12]
cad/out/production/dxf/pieces/BP40-A1_E01.dxf
E01
HUB MOUNT PATCH
M2 CUT 1
