wentingjie001-cmd/-/cad/out/production/dxf/pieces/BP40-A1_E03.dxf

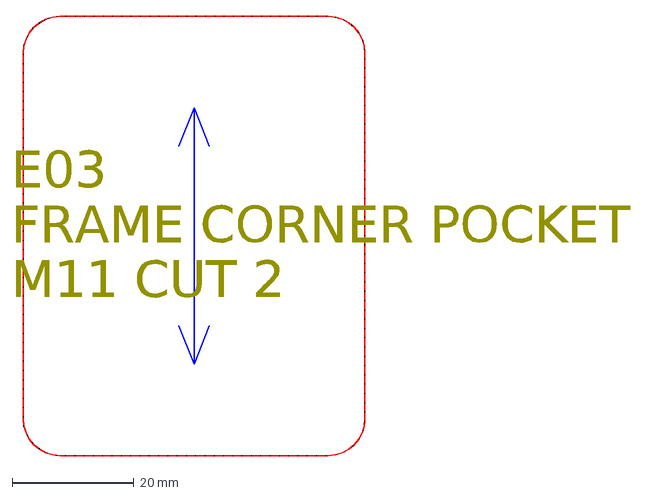
[picture p139: CAD file, 2026-11-12]
cad/out/production/dxf/pieces/BP40-A1_E03.dxf
E03
FRAME CORNER POCKET
M11 CUT 2
