wentingjie001-cmd/-/cad/out/production/dxf/pieces/BP40-A1_E04.dxf

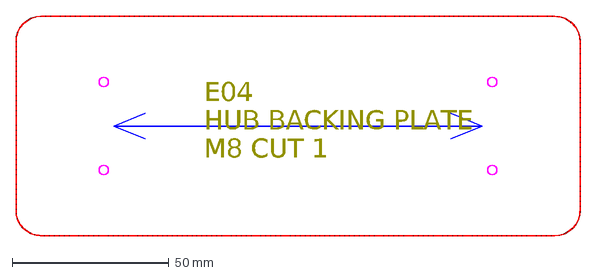
[picture p140: CAD file, 2026-11-12]
cad/out/production/dxf/pieces/BP40-A1_E04.dxf
E04
HUB BACKING PLATE
M8 CUT 1
