wentingjie001-cmd/-/cad/out/production/dxf/pieces/BP40-A1_C01.dxf

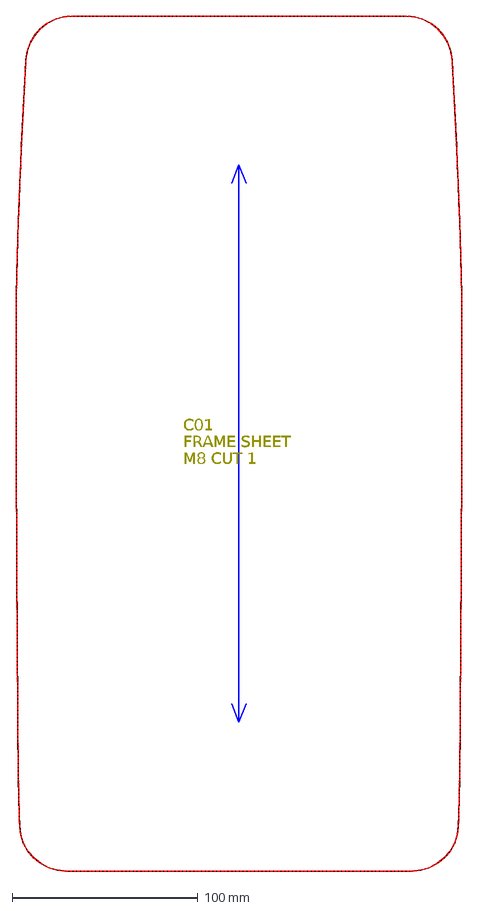
[picture p141: CAD file, 2026-11-12]
cad/out/production/dxf/pieces/BP40-A1_C01.dxf
C01
FRAME SHEET
M8 CUT 1
