wentingjie001-cmd/-/cad/out/production/dxf/pieces/BP40-A1_D05.dxf

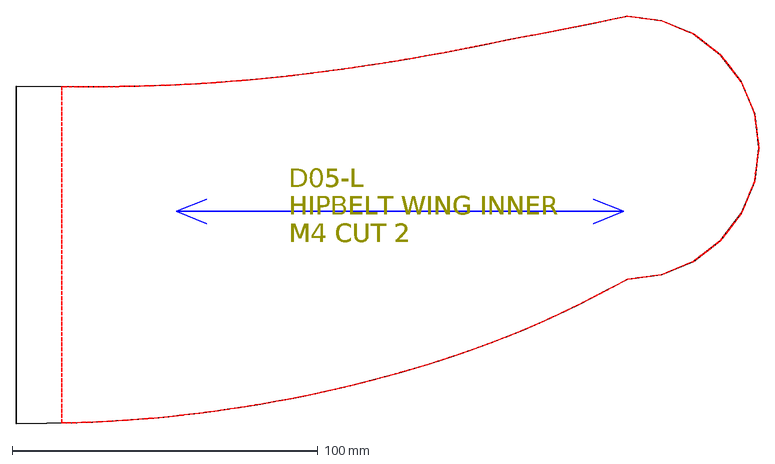
[picture p142: CAD file, 2026-11-12]
cad/out/production/dxf/pieces/BP40-A1_D05.dxf
D05-L
HIPBELT WING INNER
M4 CUT 2
