wentingjie001-cmd/-/cad/out/production/dxf/pieces/BP40-A1_C07.dxf

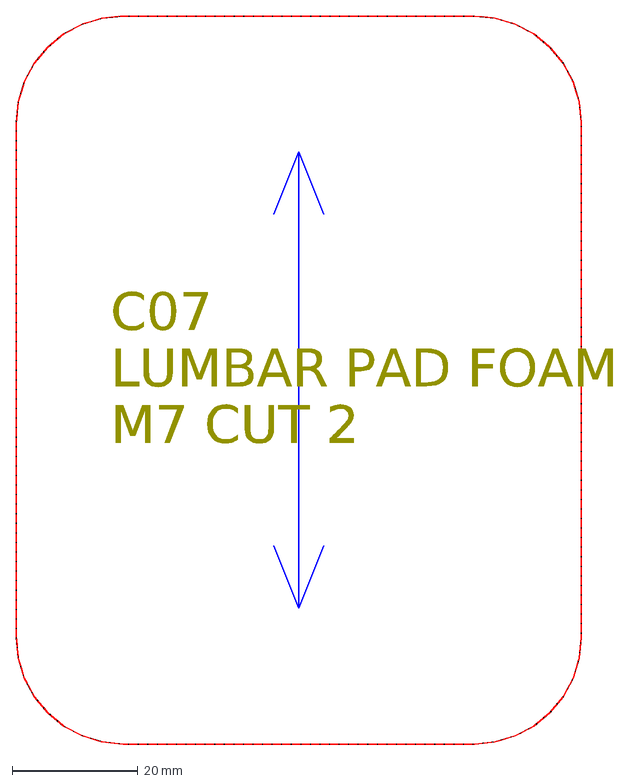
[picture p143: CAD file, 2026-11-12]
cad/out/production/dxf/pieces/BP40-A1_C07.dxf
C07
LUMBAR PAD FOAM
M7 CUT 2
