wentingjie001-cmd/-/cad/out/production/dxf/pieces/BP40-A1_C08.dxf

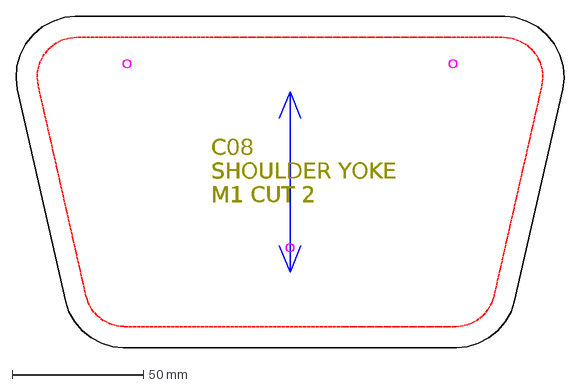
[picture p144: CAD file, 2026-11-12]
cad/out/production/dxf/pieces/BP40-A1_C08.dxf
C08
SHOULDER YOKE
M1 CUT 2
