wentingjie001-cmd/-/cad/out/production/dxf/pieces/BP40-A1_B05.dxf

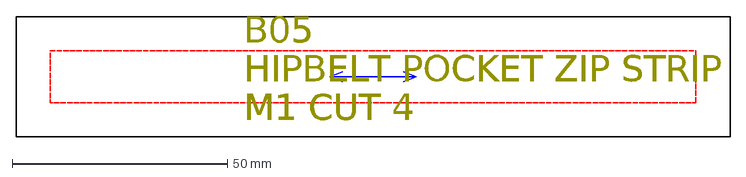
[picture p145: CAD file, 2026-11-12]
cad/out/production/dxf/pieces/BP40-A1_B05.dxf
B05
HIPBELT POCKET ZIP STRIP
M1 CUT 4
