wentingjie001-cmd/-/cad/out/production/dxf/pieces/BP40-A1_D04.dxf

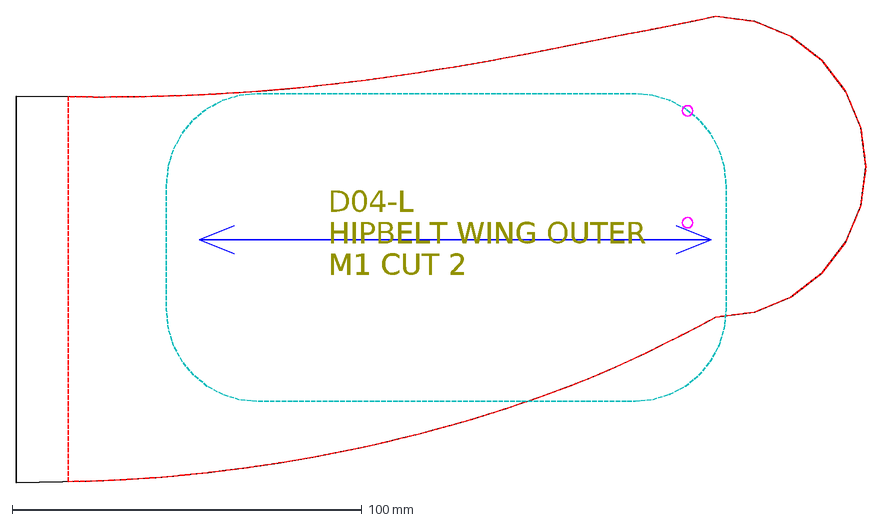
[picture p146: CAD file, 2026-11-12]
cad/out/production/dxf/pieces/BP40-A1_D04.dxf
D04-L
HIPBELT WING OUTER
M1 CUT 2
