wentingjie001-cmd/-/cad/out/production/dxf/pieces/BP40-A1_D01.dxf

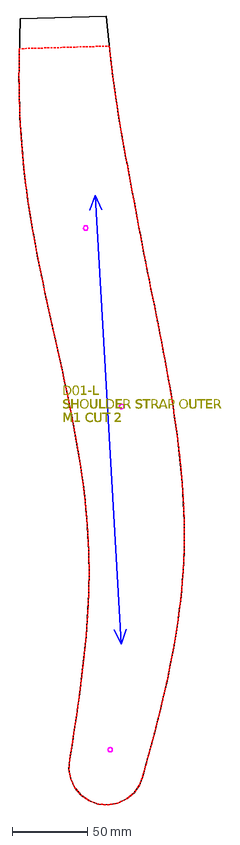
[picture p147: CAD file, 2026-11-12]
cad/out/production/dxf/pieces/BP40-A1_D01.dxf
D01-L
SHOULDER STRAP OUTER
M1 CUT 2
