wentingjie001-cmd/-/cad/out/production/dxf/pieces/BP40-A1_A02.dxf

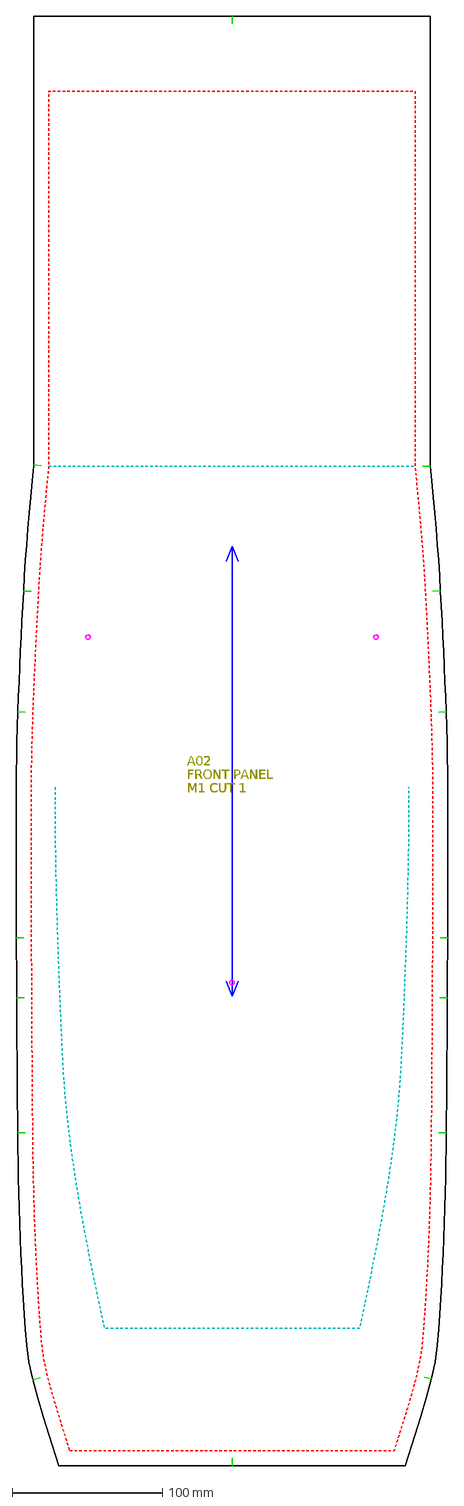
[picture p148: CAD file, 2026-11-12]
cad/out/production/dxf/pieces/BP40-A1_A02.dxf
A02
FRONT PANEL
M1 CUT 1
