wentingjie001-cmd/-/cad/out/production/dxf/pieces/BP40-A1_D08.dxf

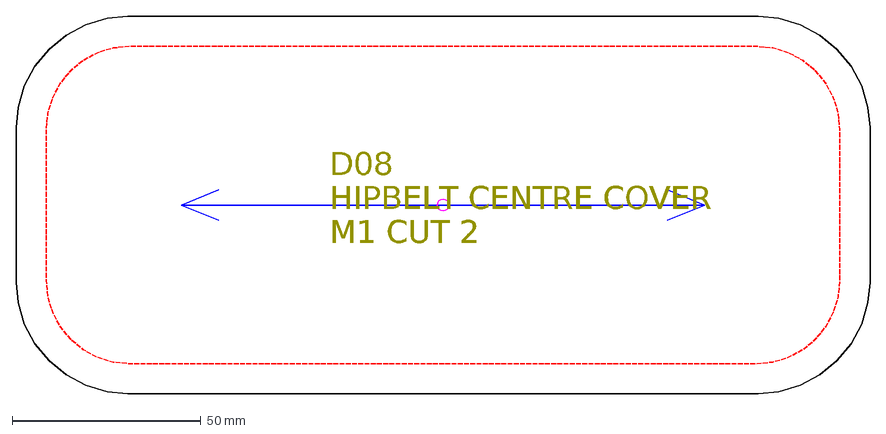
[picture p149: CAD file, 2026-11-12]
cad/out/production/dxf/pieces/BP40-A1_D08.dxf
D08
HIPBELT CENTRE COVER
M1 CUT 2
