wentingjie001-cmd/-/cad/out/production/dxf/pieces/BP40-A1_C04.dxf

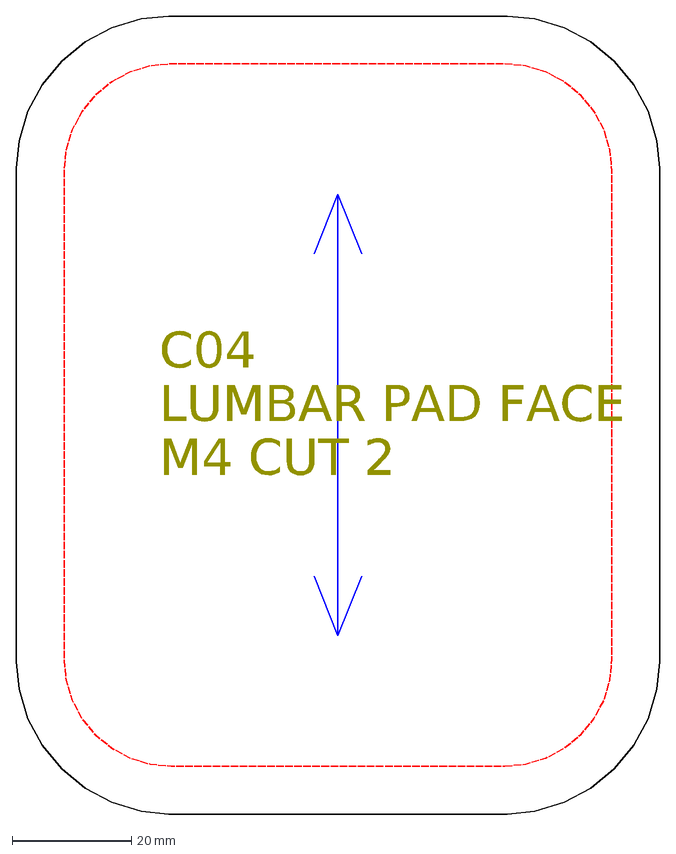
[picture p150: CAD file, 2026-11-12]
cad/out/production/dxf/pieces/BP40-A1_C04.dxf
C04
LUMBAR PAD FACE
M4 CUT 2
