wentingjie001-cmd/-/cad/out/production/dxf/pieces/BP40-A1_C05.dxf

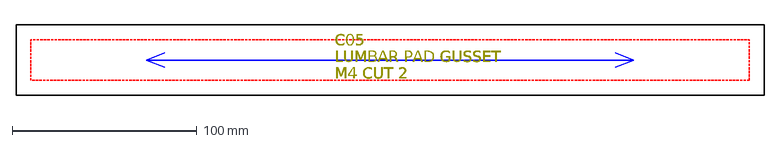
[picture p151: CAD file, 2026-11-12]
cad/out/production/dxf/pieces/BP40-A1_C05.dxf
C05
LUMBAR PAD GUSSET
M4 CUT 2
