wentingjie001-cmd/-/cad/out/production/dxf/pieces/BP40-A1_A03.dxf

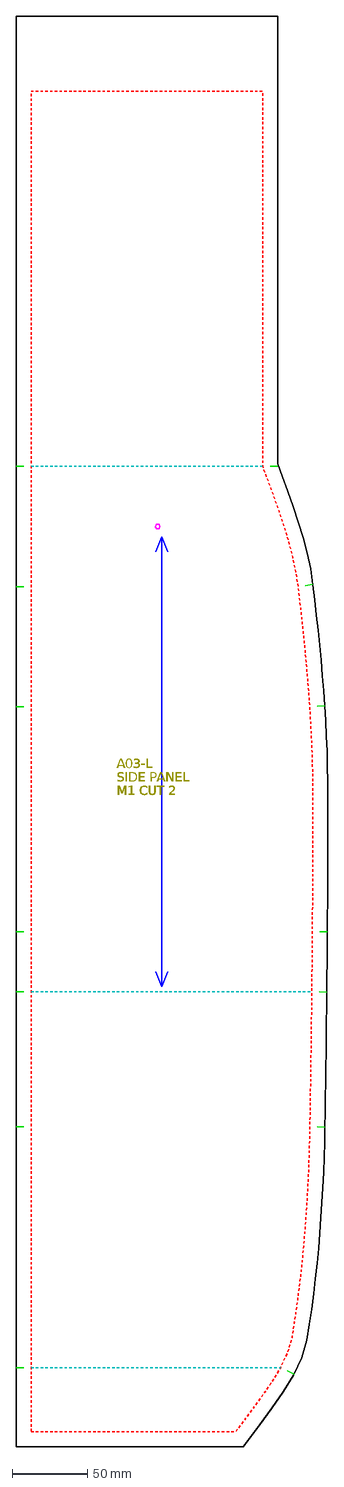
[picture p152: CAD file, 2026-11-12]
cad/out/production/dxf/pieces/BP40-A1_A03.dxf
A03-L
SIDE PANEL
M1 CUT 2
