wentingjie001-cmd/-/(list of files, cad)

Other CAD files:
cad/out/stl/pivot_plate_1to1.stl
cad/out/stl/hub_housing_1to1.stl
cad/out/stl/rollers_1to1.stl
cad/out/step/cam_lever.step
cad/out/stl/y_frame_1to1.stl
