wentingjie001-cmd/-/cad/out/production/material_usage.md

| 代号 | 材料 | 规格 | 裁片面积 (m²) | 排料用长 (mm) | 利用率 | 单包用量（卷材加 8% 损耗，板材加 25%） |
|---|---|---|---|---|---|---|
| M1 | 主面料 | 210D 高强尼龙格子布（Robic 或同级），PU 内涂，无氟防泼水 | 1.210 | 1252 | 67% | 1.35 m（幅宽 1450 mm） |
| M2 | 底料 | 420D 高强尼龙，PU 内涂 | 0.052 | 156 | 23% | 0.17 m（幅宽 1450 mm） |
| M3 | 弹力料 | 四面弹尼龙/氨纶网布，约 200 g/m² | 0.243 | 371 | 45% | 0.40 m（幅宽 1450 mm） |
| M4 | 间隔网布 | 3 mm 三明治网布（3D spacer mesh） | 0.239 | 572 | 29% | 0.62 m（幅宽 1450 mm） |
| M5 | 肩带泡棉 | EVA 8 mm，约 60 kg/m³（密度打样时确认） | 0.056 | — | — | 0.069 m²（板材） |
| M6 | 腰带泡棉 | EVA 10 mm，约 90 kg/m³（密度打样时确认） | 0.039 | — | — | 0.048 m²（板材） |
| M7 | 腰垫泡棉 | EVA 22 mm（10 + 12 贴合） | 0.020 | — | — | 0.025 m²（板材） |
| M8 | 背板 | HDPE 板 1.5 mm | 0.121 | — | — | 0.151 m²（板材） |
| M9 | 加强板 | HDPE 板 1.0 mm | 0.047 | — | — | 0.058 m²（板材） |
| M10 | 里料 | 70D 尼龙塔夫，PU 内涂 | 0.254 | 520 | 34% | 0.56 m（幅宽 1450 mm） |
| M11 | 耐磨加强料 | TPU 复合加强料 0.8 mm（Hypalon 类） | 0.024 | — | — | 0.030 m²（板材） |
