wentingjie001-cmd/-/cad/out/schematics/benchmark_aarn_back_principle.pdf

## Aarn Pace Magic 40 背负系统原理 (后视示意, 面向背板)

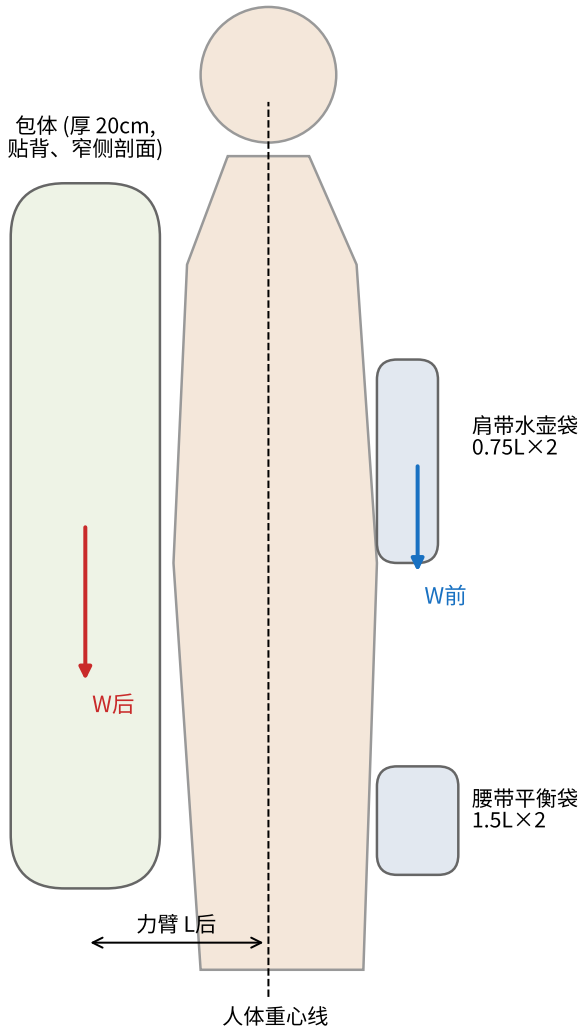
[picture p154: figure]
包体 (厚 20cm, 贴背、窄侧剖面); 肩带水壶袋 0.75L×2; 腰带平衡袋 1.5L×2; 人体重心线
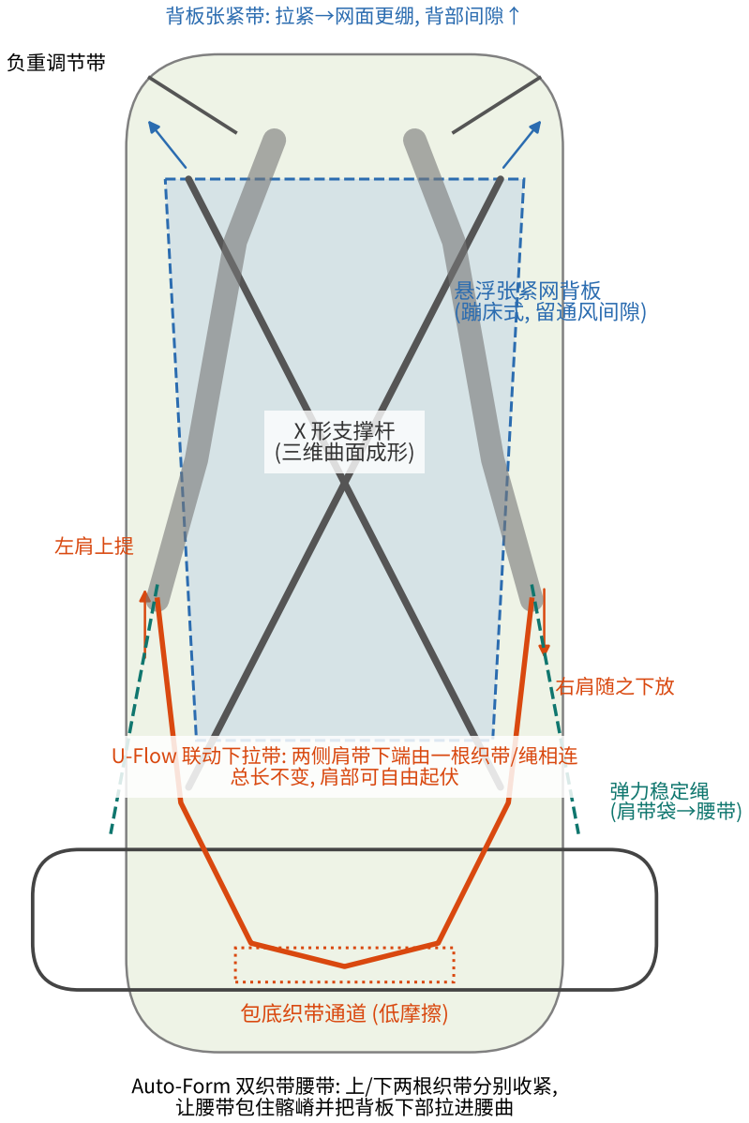
[picture p155: figure]
X 形支撑杆 (三维曲面成形); 悬浮张紧网背板 (蹦床式, 留通风间隙); 背板张紧带: 拉紧→网面更绷, 背部间隙↑; 包底织带通道 (低摩擦); 左肩上提; 右肩随之下放; U-Flow 联动下拉带: 两侧肩带下端由一根织带/绳相连 总长不变, 肩部可自由起伏; 负重调节带; 弹力稳定绳 (肩带袋→腰带); Auto-Form 双织带腰带: 上/下两根织带分别收紧, 让腰带包住髂嵴并把背板下部拉进腰曲

原理: 包体越薄越贴背 → 后部力臂 L后 越小; 前置袋提供反向力矩 W前·L前, 使 合力作用线接近人体重心线 → 减少前倾代偿、肩颈与腰背肌肉负担。 腰带承担主要载荷, 肩带只负责稳定 (可以松一点 → 肩部自由)。

## 侧视受力示意: 窄侧剖面 + 前置平衡袋
