wentingjie001-cmd/-/cad/out/benchmark_aarn_pm40/compare/aarn_vs_ours_side.png

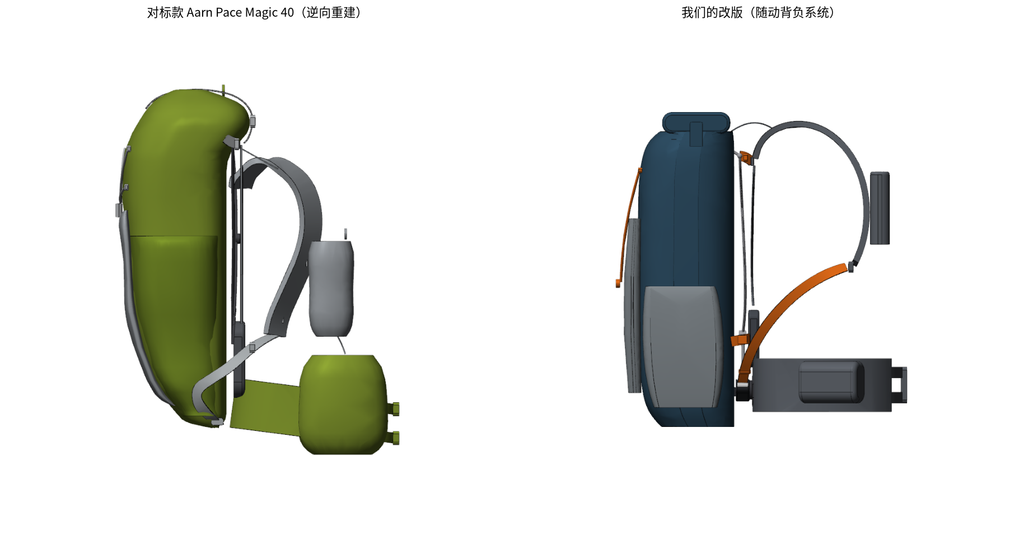
cad/out/benchmark_aarn_pm40/compare/aarn_vs_ours_side.png
