wentingjie001-cmd/-/cad/out/benchmark_aarn_pm40/detail/render/front.png

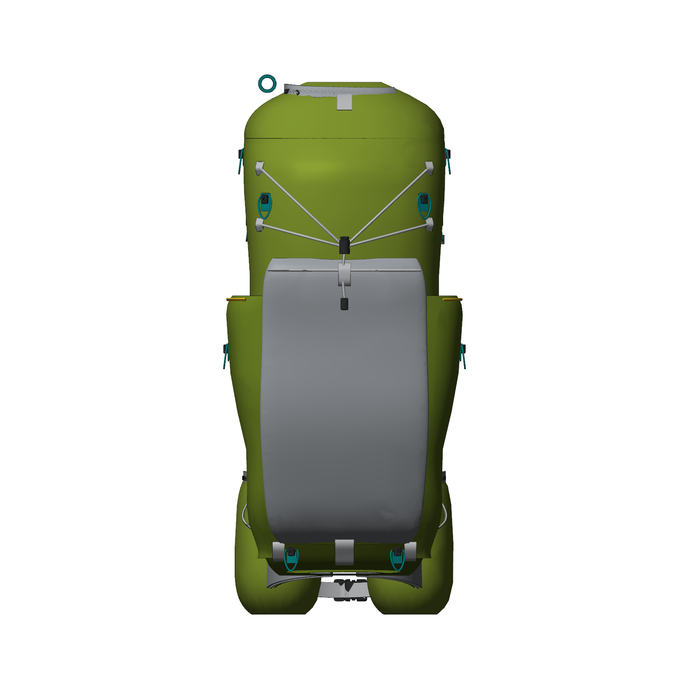
cad/out/benchmark_aarn_pm40/detail/render/front.png
