wentingjie001-cmd/-/cad/out/benchmark_aarn_pm40/detail/render/rear.png

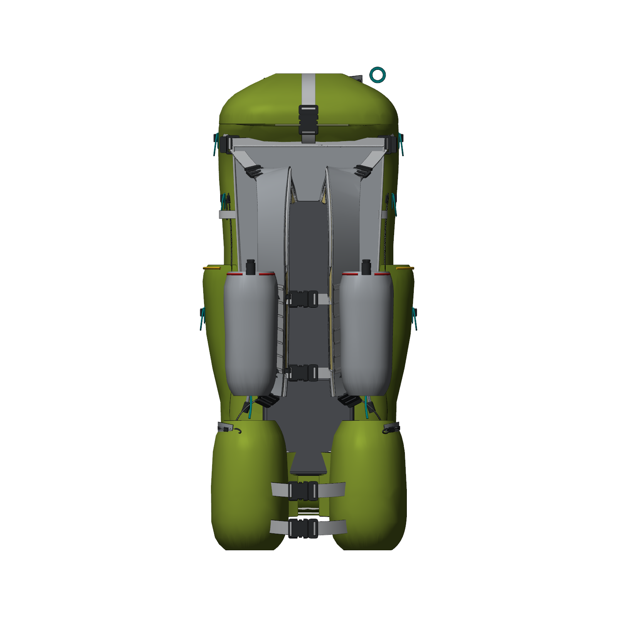
cad/out/benchmark_aarn_pm40/detail/render/rear.png
