wentingjie001-cmd/-/cad/out/benchmark_aarn_pm40/detail/section/section_x0_iso.png

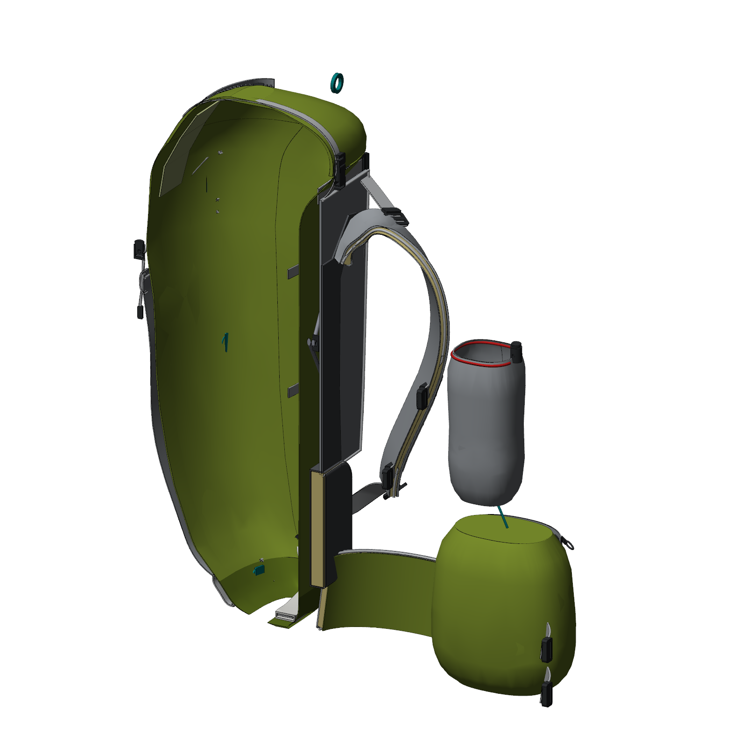
cad/out/benchmark_aarn_pm40/detail/section/section_x0_iso.png
