wentingjie001-cmd/-/cad/out/benchmark_aarn_pm40/detail/section/section_x0_side.png

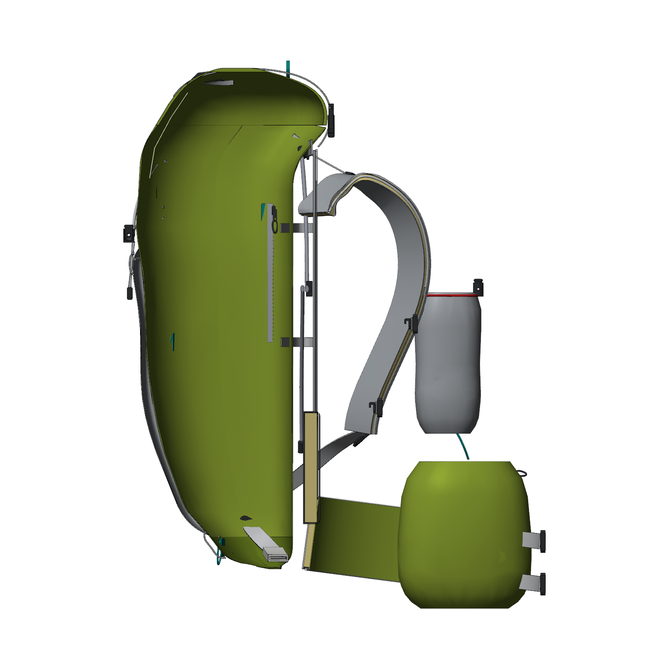
cad/out/benchmark_aarn_pm40/detail/section/section_x0_side.png
