wentingjie001-cmd/-/cad/out/benchmark_aarn_pm40/detail/section/section_x56_strap_side.png

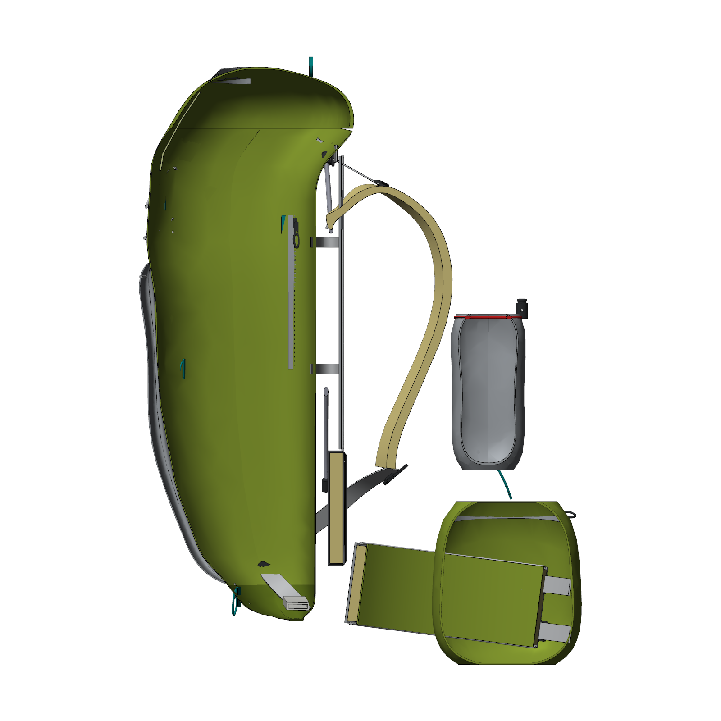
cad/out/benchmark_aarn_pm40/detail/section/section_x56_strap_side.png
