wentingjie001-cmd/-/cad/out/benchmark_aarn_pm40/detail/section/section_z125_belt_top.png

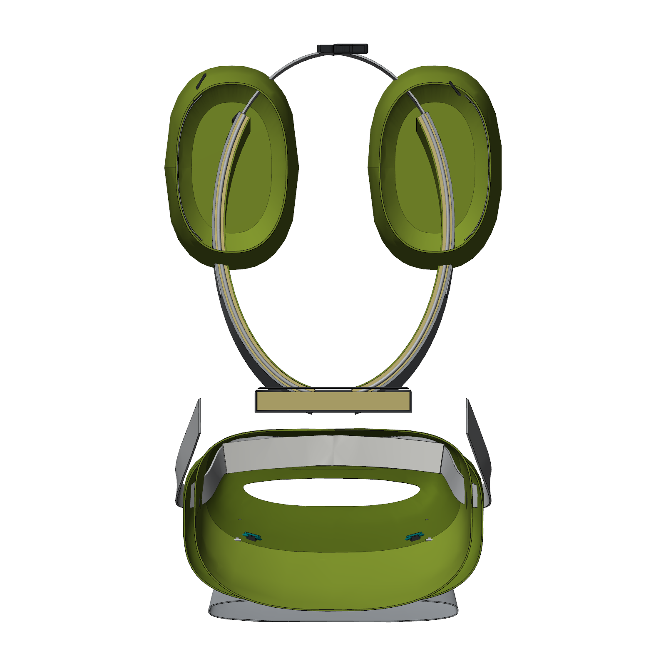
cad/out/benchmark_aarn_pm40/detail/section/section_z125_belt_top.png
