wentingjie001-cmd/-/cad/out/benchmark_aarn_pm40/views/bottom.png

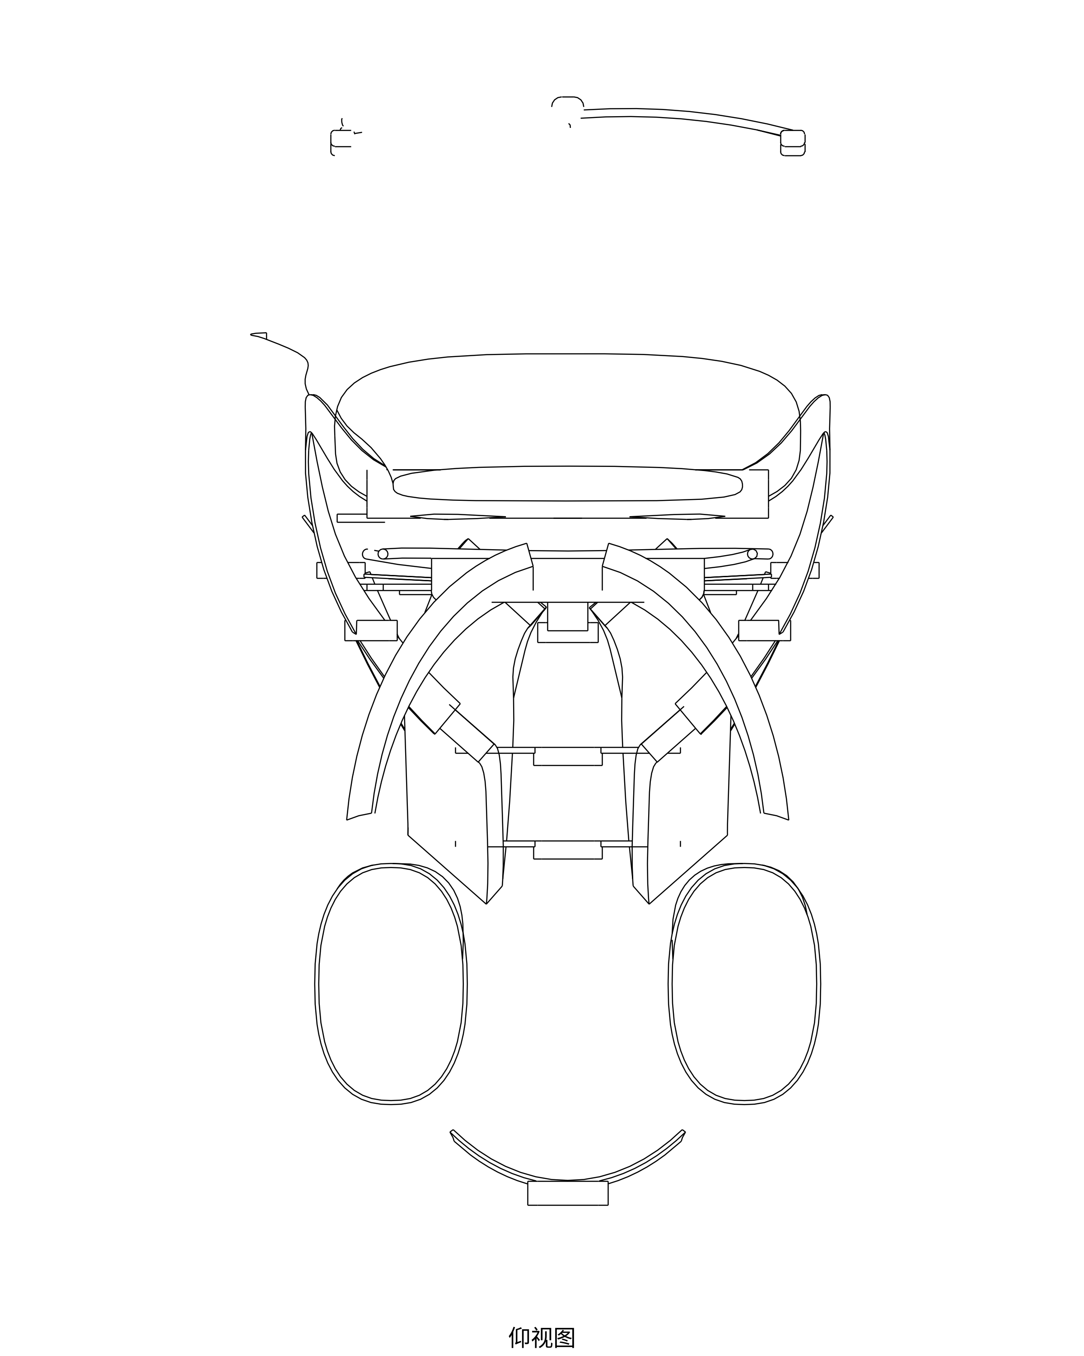
cad/out/benchmark_aarn_pm40/views/bottom.png
