wentingjie001-cmd/-/cad/out/benchmark_aarn_pm40/views/front.png

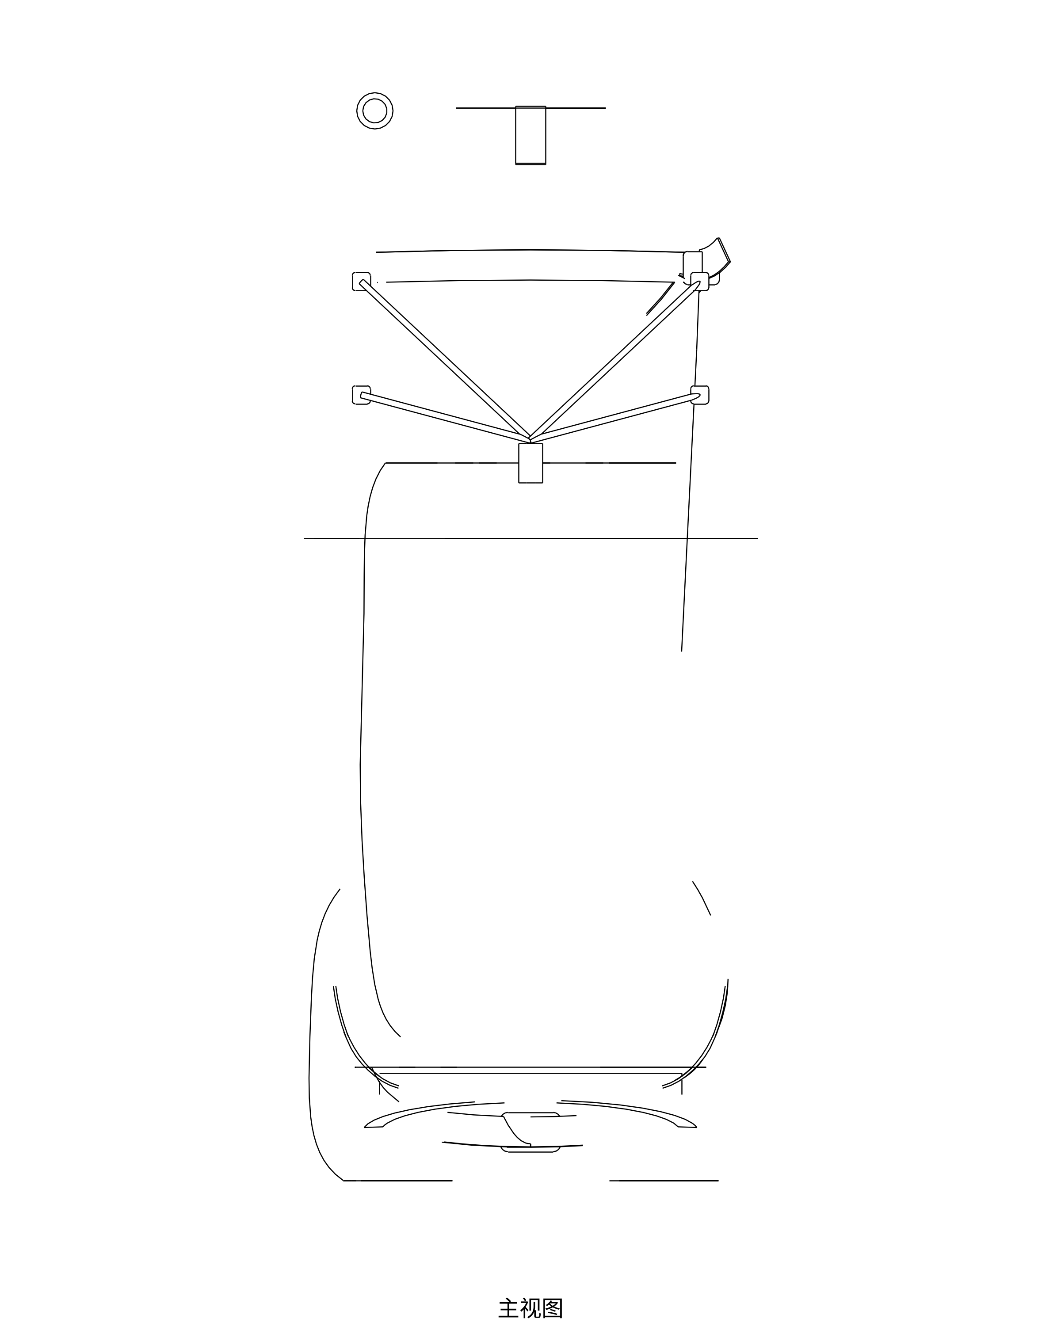
cad/out/benchmark_aarn_pm40/views/front.png
