wentingjie001-cmd/-/cad/out/benchmark_aarn_pm40/views/left.png

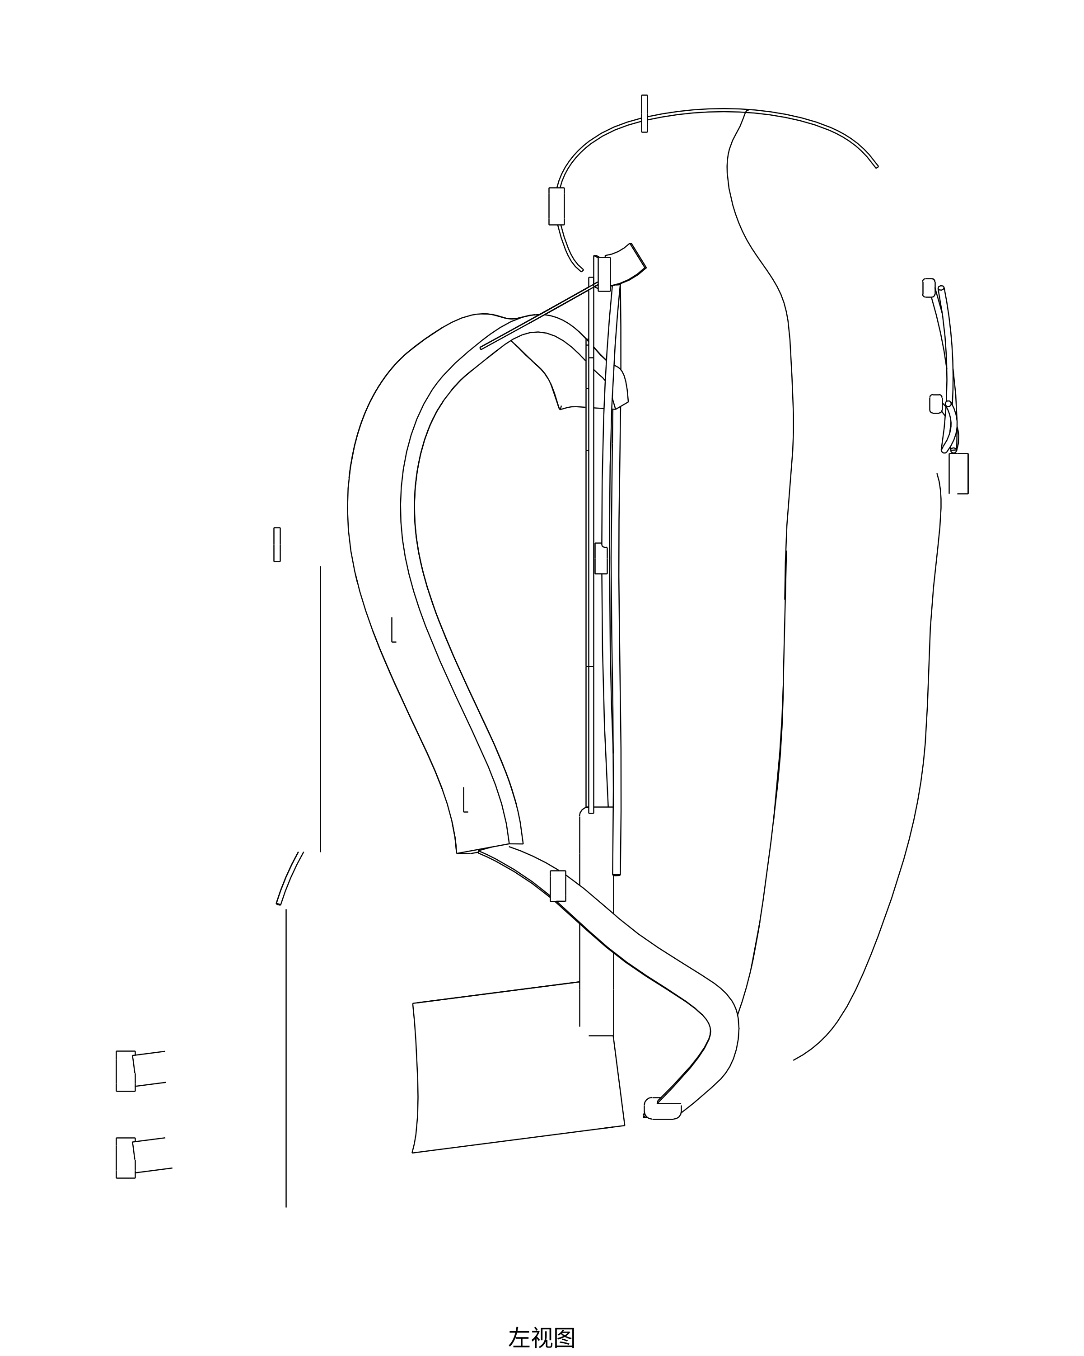
cad/out/benchmark_aarn_pm40/views/left.png
