wentingjie001-cmd/-/cad/out/benchmark_aarn_pm40/views/right.png

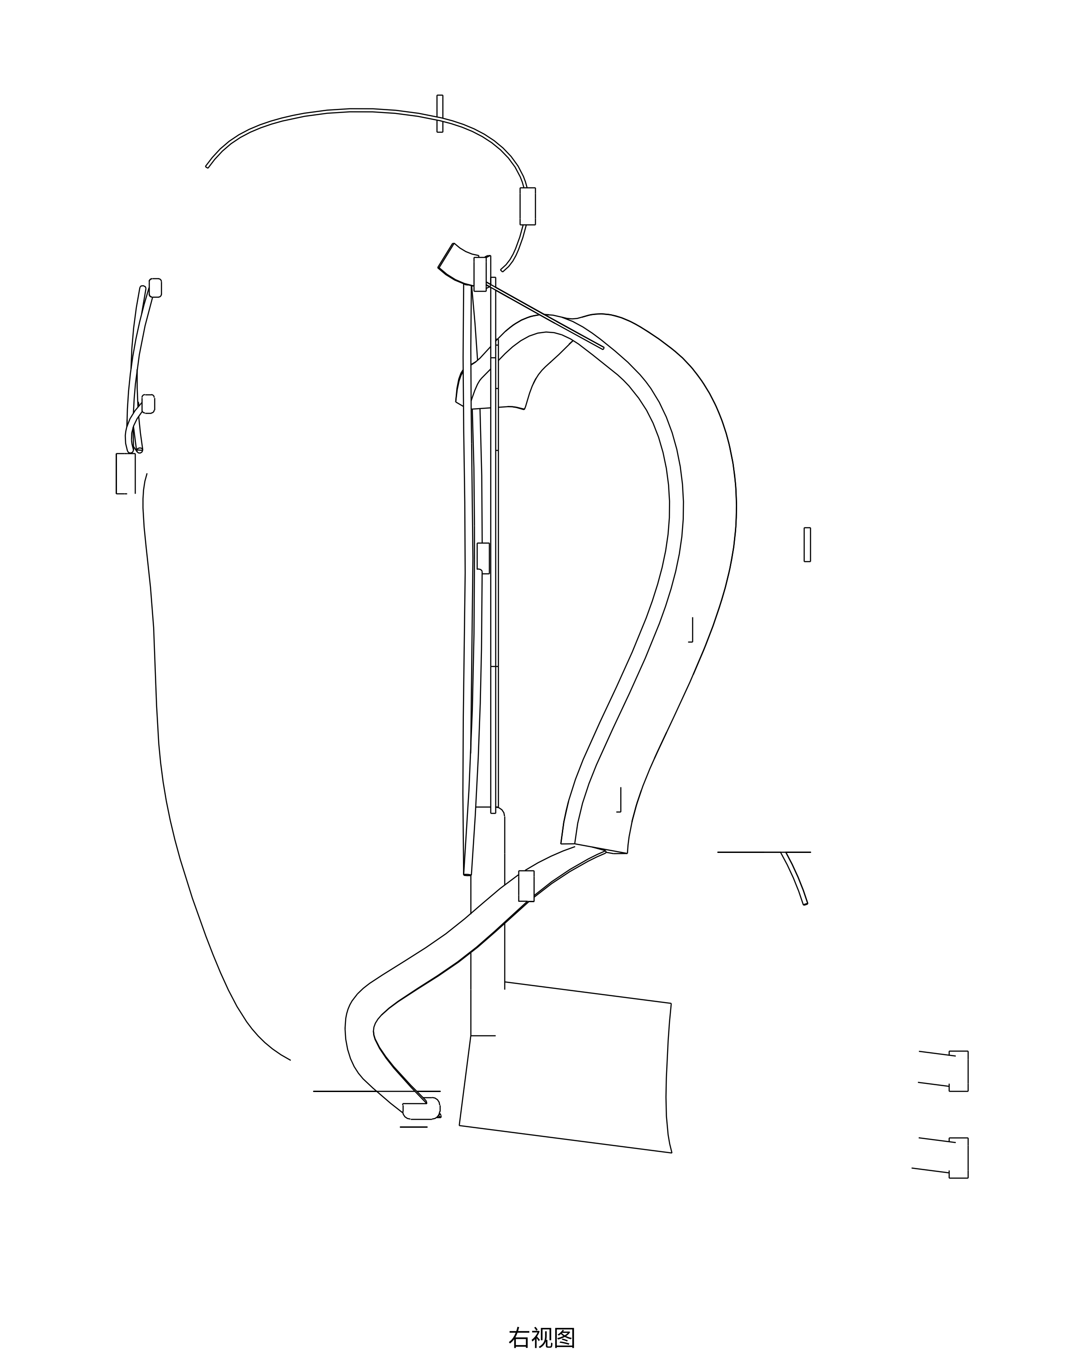
cad/out/benchmark_aarn_pm40/views/right.png
