wentingjie001-cmd/-/cad/out/benchmark_aarn_pm40/views/top.png

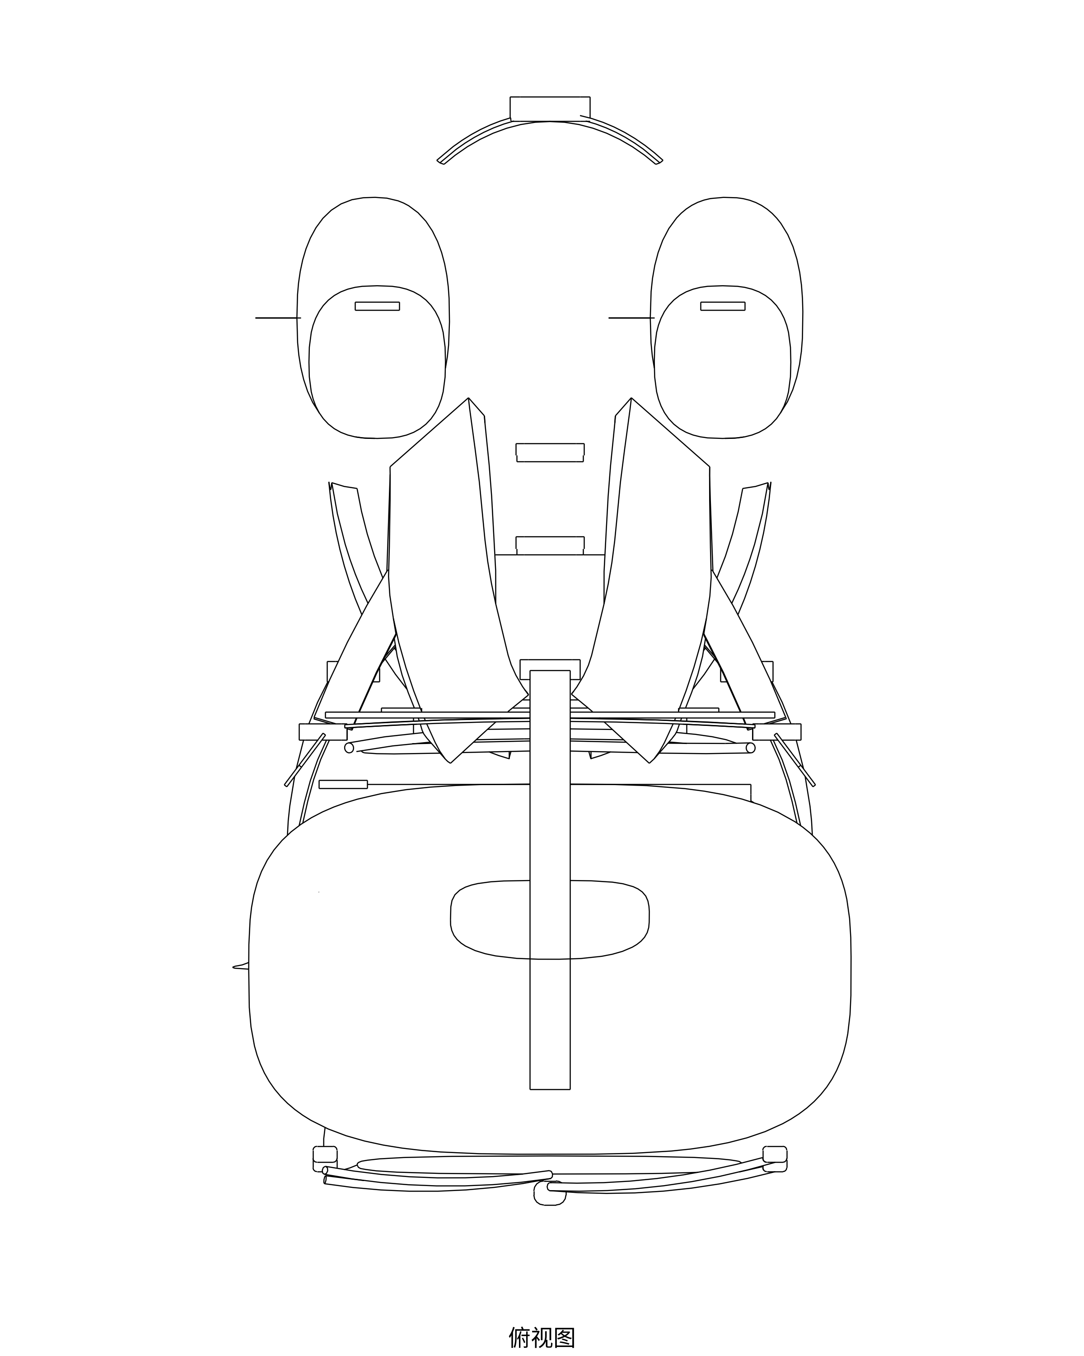
cad/out/benchmark_aarn_pm40/views/top.png
