wentingjie001-cmd/-/cad/out/schematics/fig6_linkage_principle.pdf

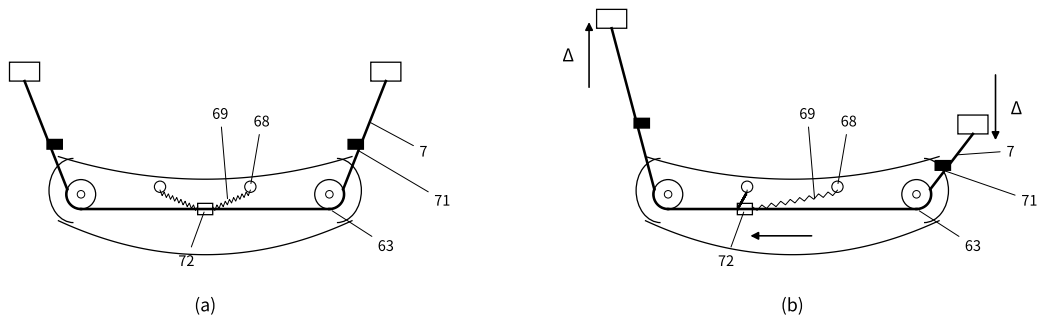
[picture p176: page 1]
