wentingjie001-cmd/-/cad/out/benchmark_aarn_pm40/views/bottom.pdf

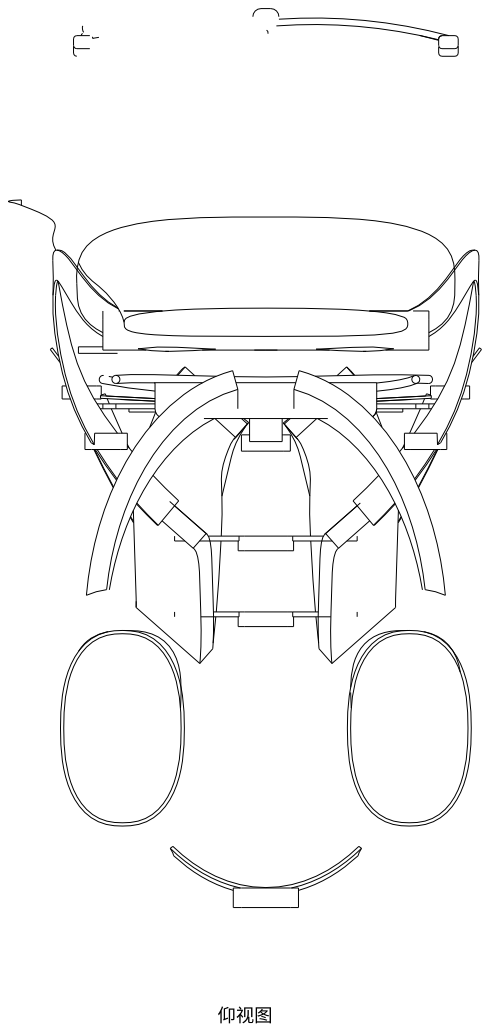
[picture p177: page 1]
仰视图
