wentingjie001-cmd/-/cad/out/benchmark_aarn_pm40/views/front.pdf

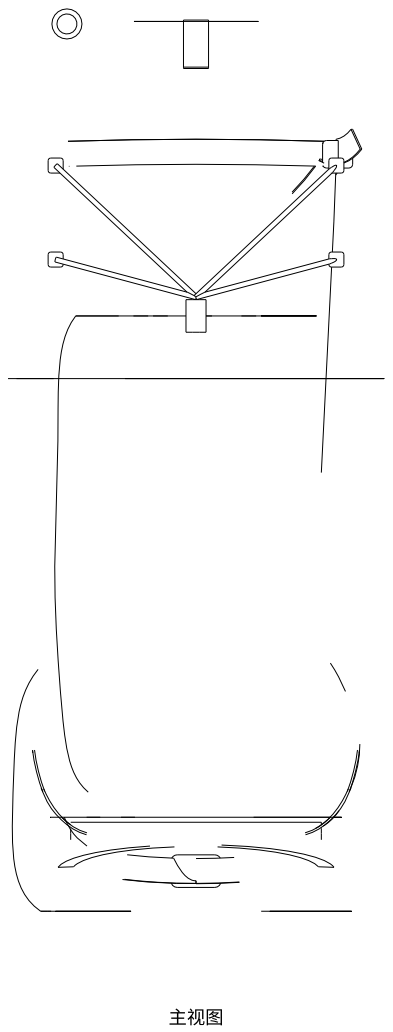
[picture p178: page 1]
主视图
