wentingjie001-cmd/-/cad/out/benchmark_aarn_pm40/views/iso_front.pdf

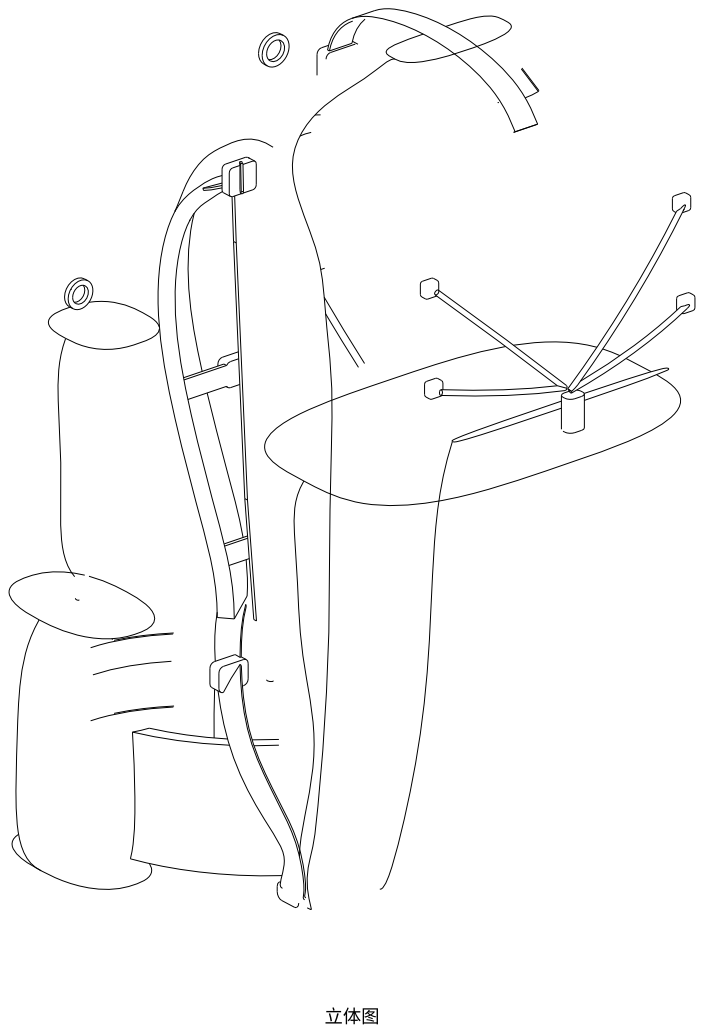
[picture p179: page 1]
立体图
