wentingjie001-cmd/-/cad/out/benchmark_aarn_pm40/views/left.pdf

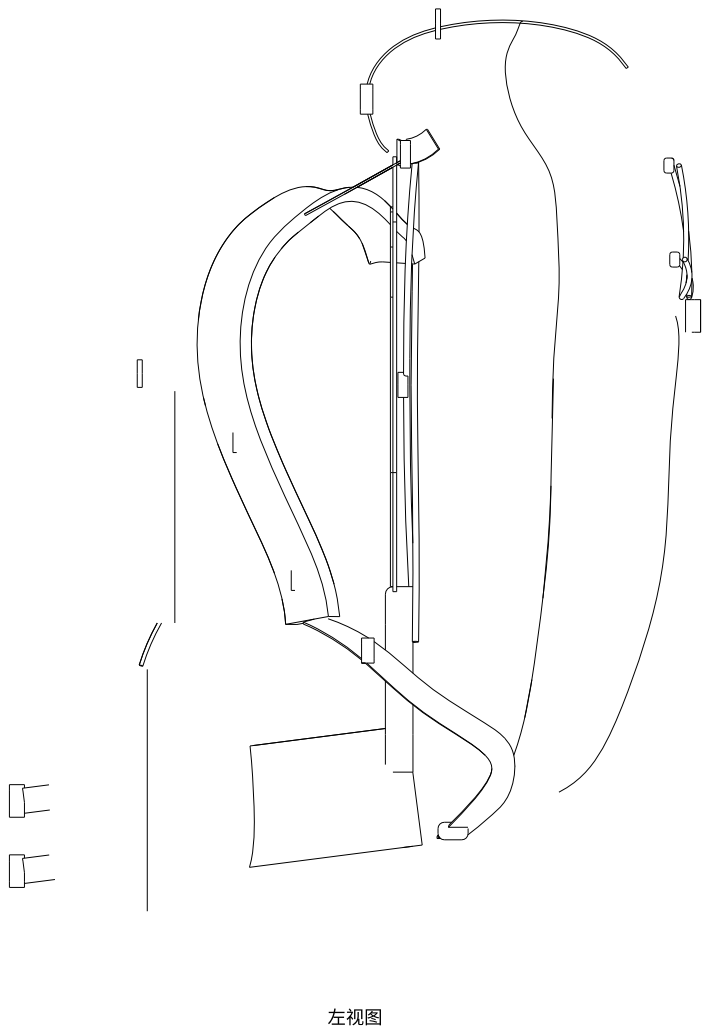
[picture p180: page 1]
左视图
