wentingjie001-cmd/-/cad/out/benchmark_aarn_pm40/views/rear.pdf

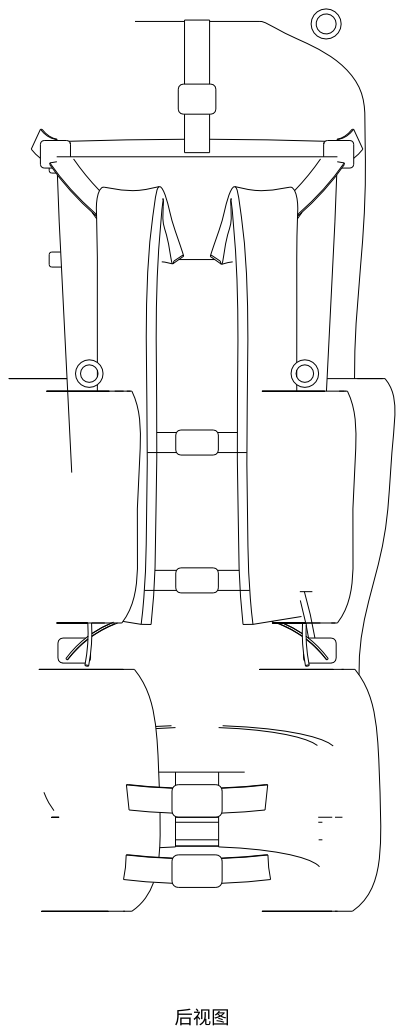
[picture p181: page 1]
后视图
