wentingjie001-cmd/-/cad/out/benchmark_aarn_pm40/views/right.pdf

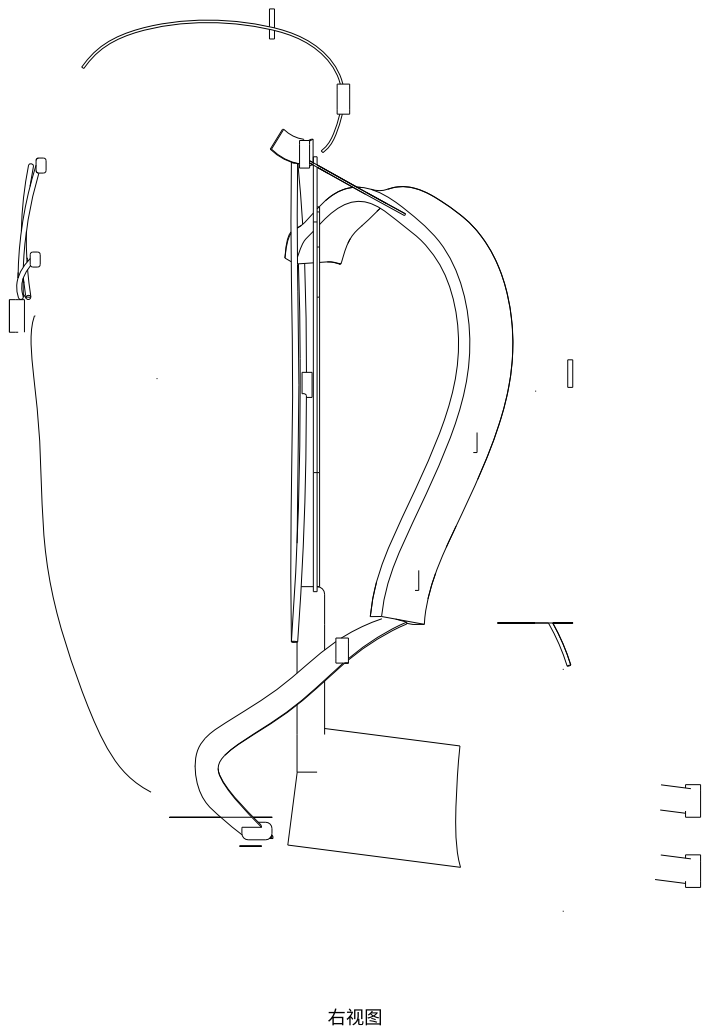
[picture p182: page 1]
右视图
