wentingjie001-cmd/-/cad/out/benchmark_aarn_pm40/views/top.pdf

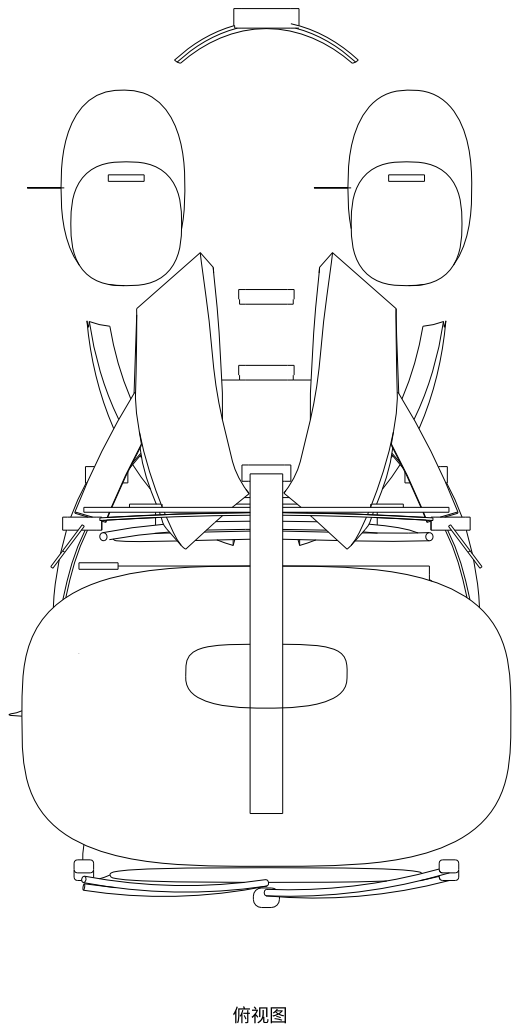
[picture p183: page 1]
俯视图
