wentingjie001-cmd/-/cad/out/design/02_backpack_partial_back_system/iso_rear.pdf

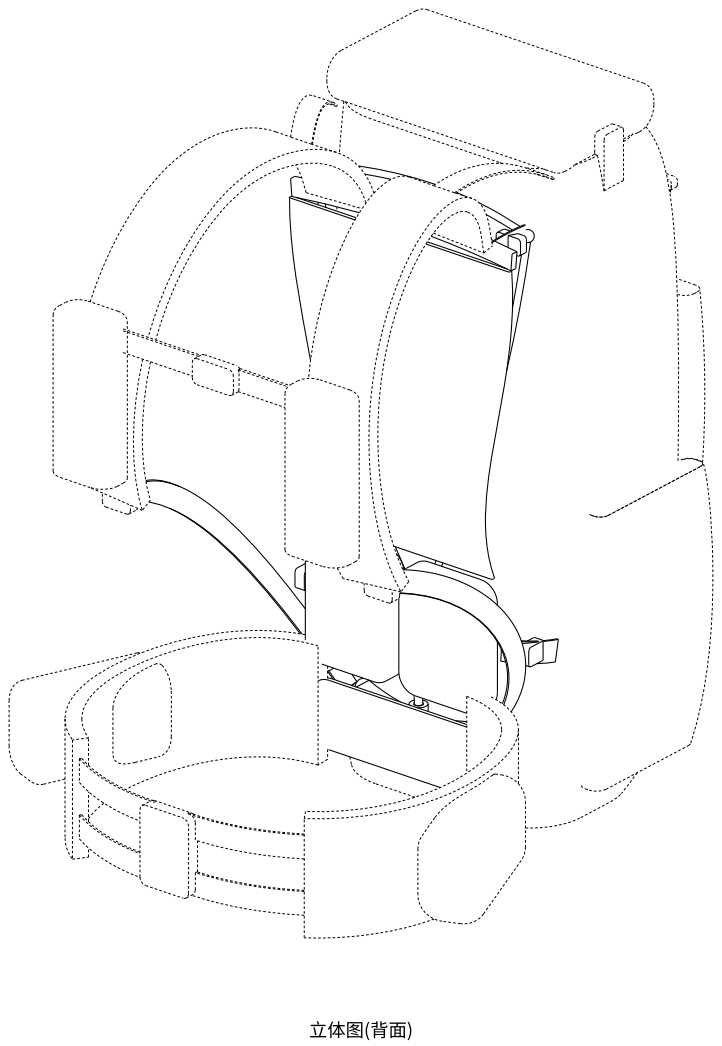
[picture p184: page 1]
立体图(背面)
