wentingjie001-cmd/-/cad/out/drawings/BP40-FRM-001_y_frame.pdf

224

# 上横梁: (±112,40,560) (±55,49,566) (0,52,568)

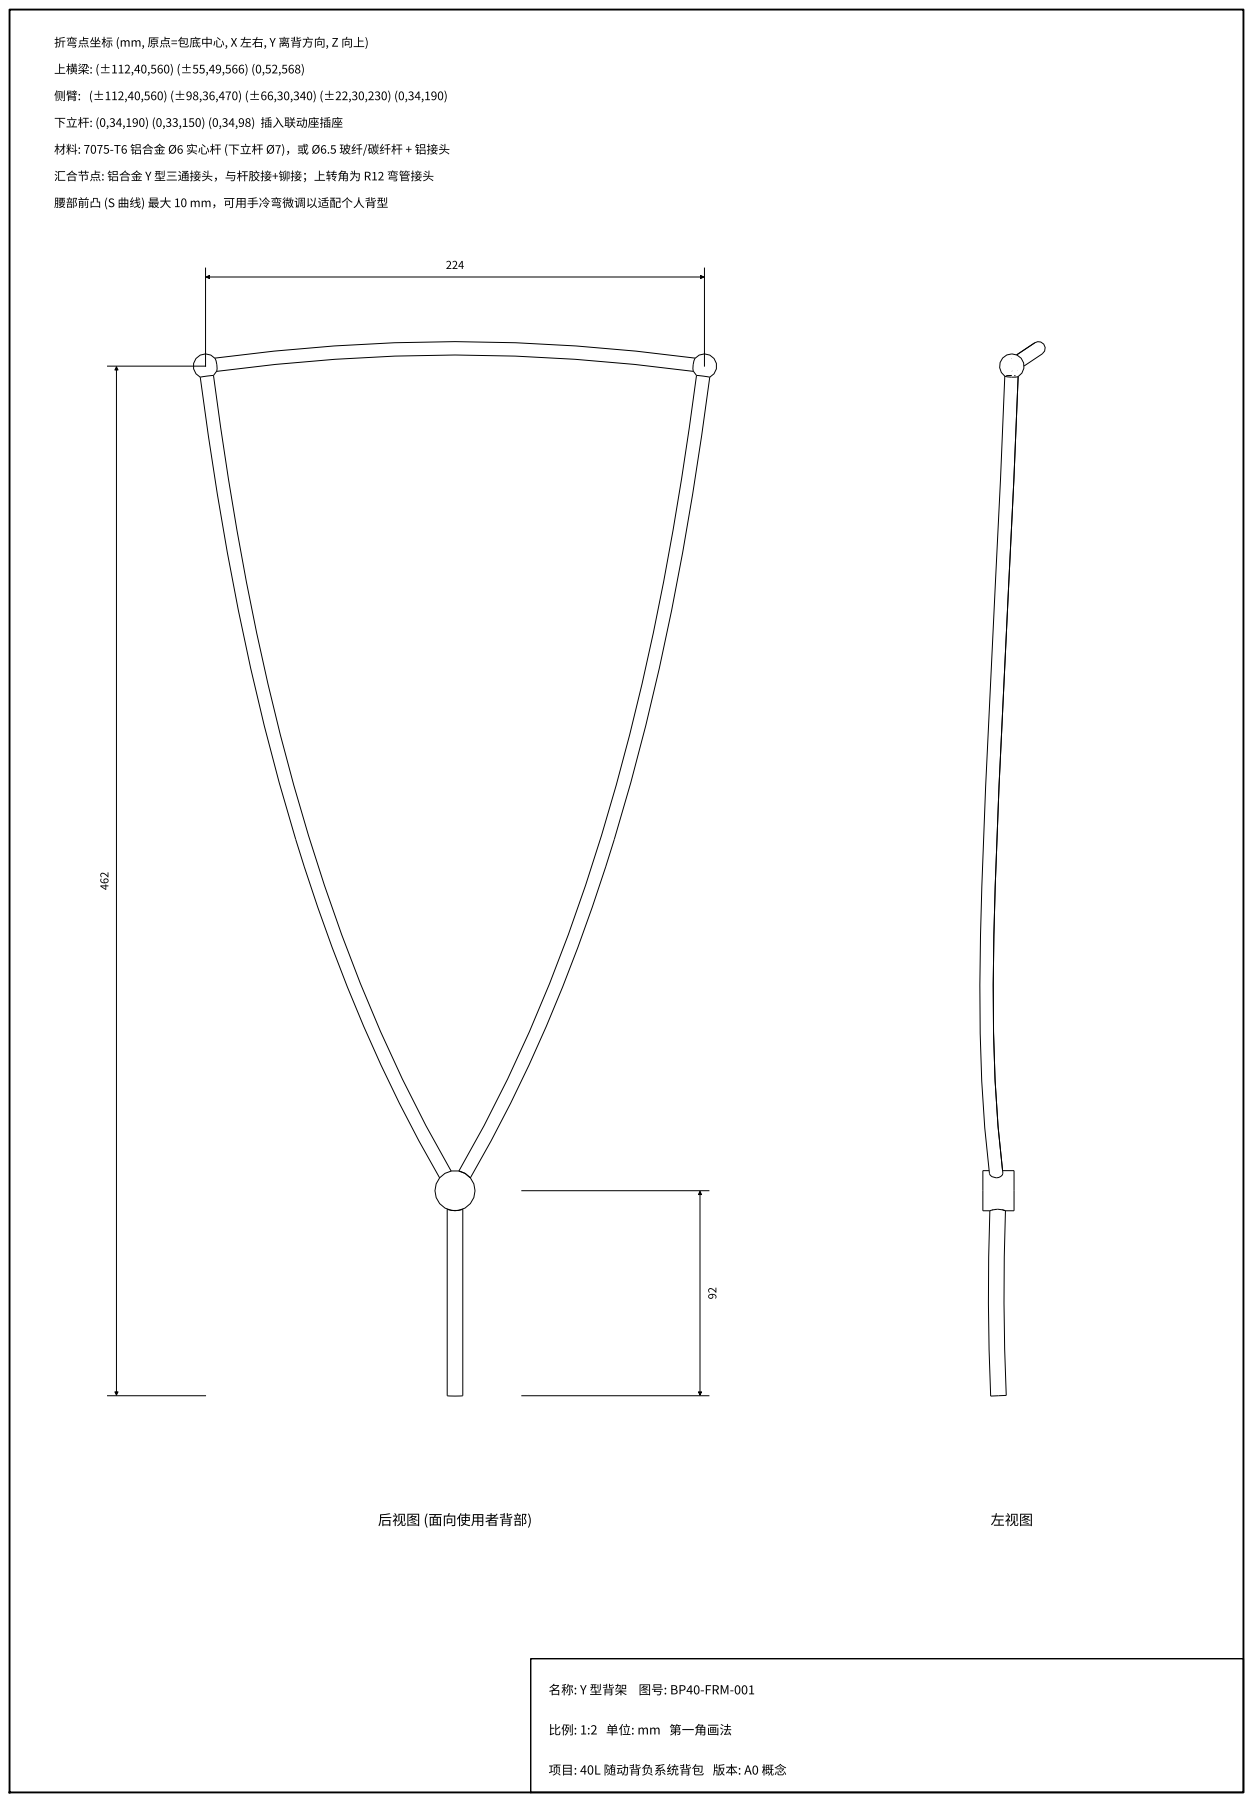
[picture p185: page 1]
后视图 (面向使用者背部); 左视图; 侧臂: (±112,40,560) (±98,36,470) (±66,30,340) (±22,30,230) (0,34,190) 下立杆: (0,34,190) (0,33,150) (0,34,98) 插入联动座插座

折弯点坐标 (mm, 原点=包底中心, X 左右, Y 离背方向, Z 向上)

材料: 7075-T6 铝合金 Ø6 实心杆 (下立杆 Ø7)，或 Ø6.5 玻纤/碳纤杆 + 铝接头

汇合节点: 铝合金 Y 型三通接头，与杆胶接+铆接；上转角为 R12 弯管接头

腰部前凸 (S 曲线) 最大 10 mm，可用手冷弯微调以适配个人背型

名称: Y 型背架 图号: BP40-FRM-001

比例: 1:2 单位: mm 第一角画法

项目: 40L 随动背负系统背包 版本: A0 概念
