wentingjie001-cmd/-/cad/out/drawings/BP40-HUB-001_linkage_hub.pdf

156

132

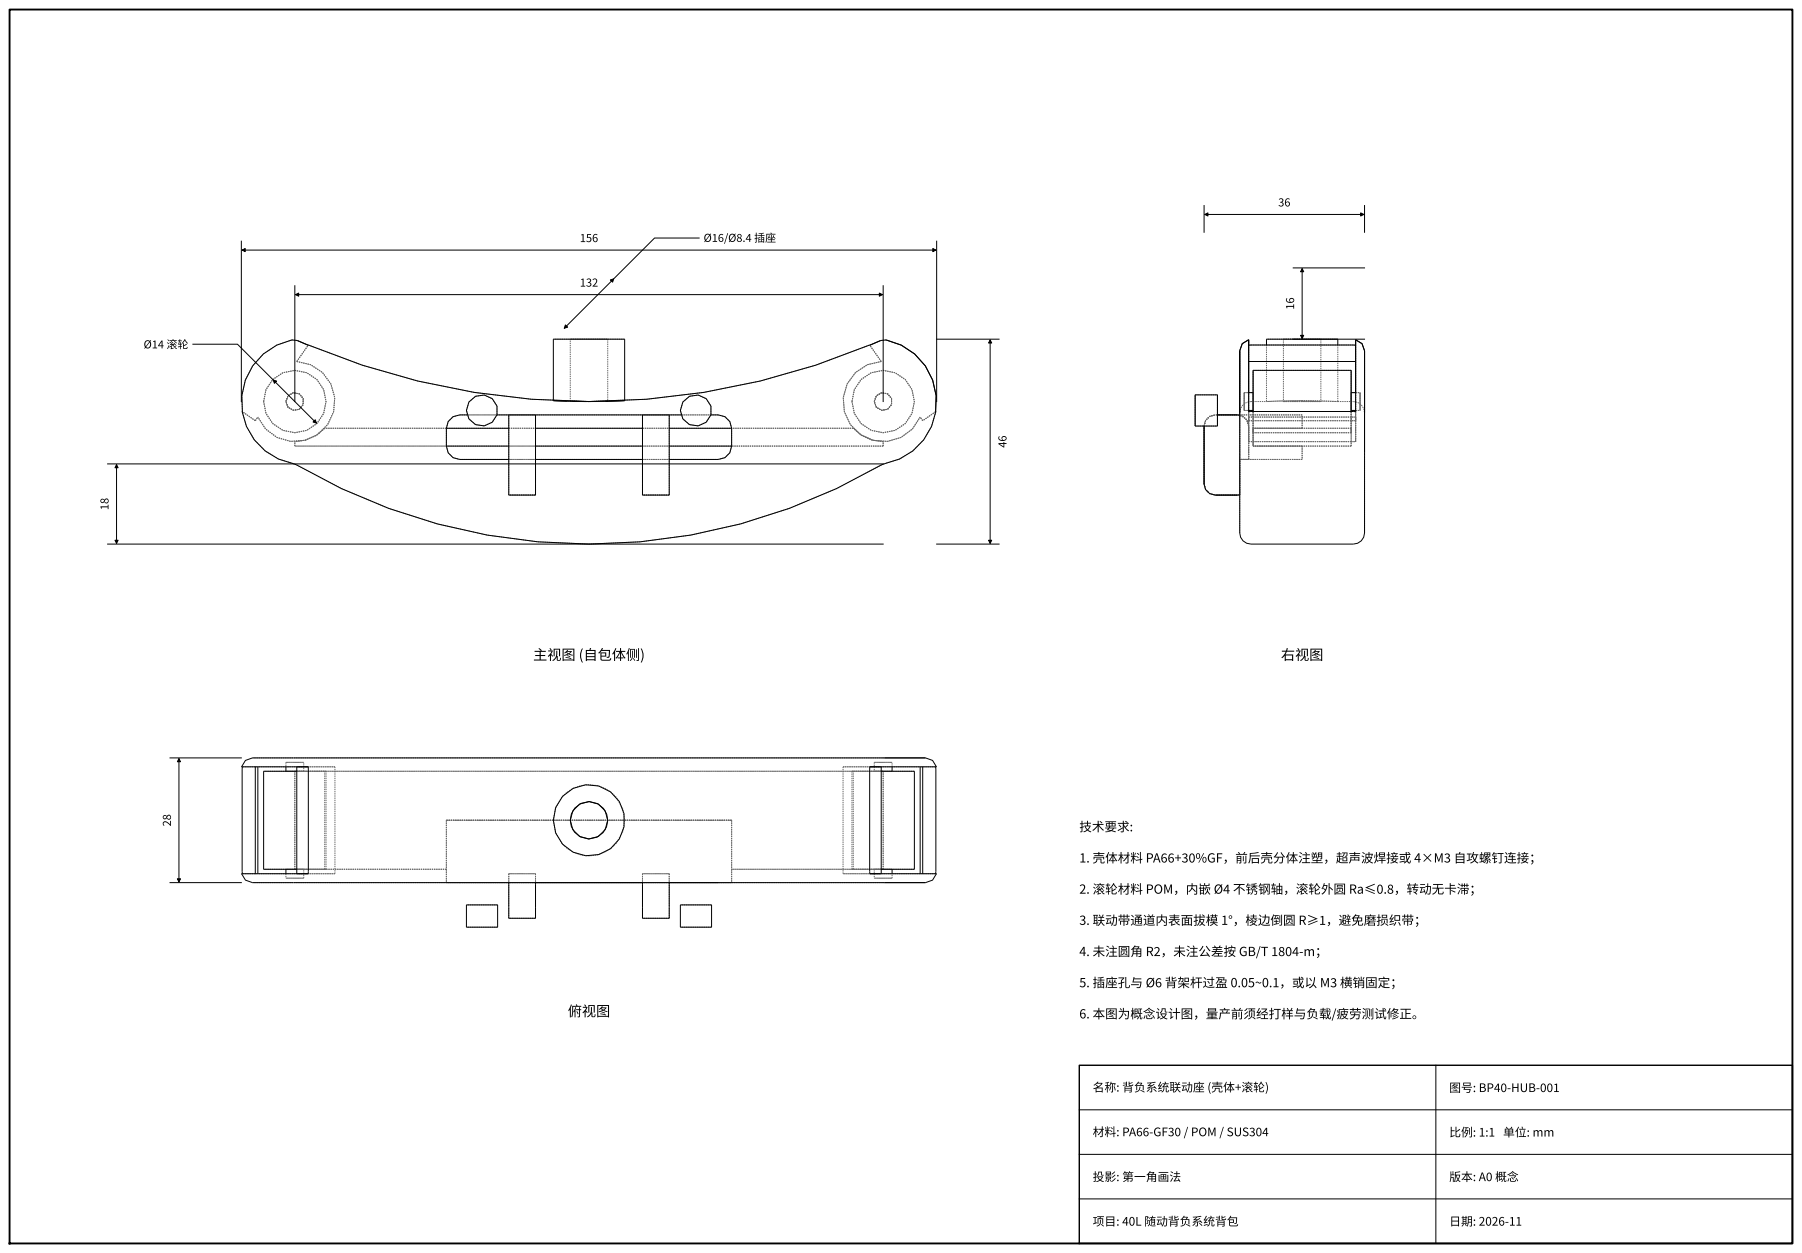
[picture p186: page 1]
主视图 (自包体侧); 俯视图; 右视图; 技术要求:; 名称: 背负系统联动座 (壳体+滚轮); 图号: BP40-HUB-001; 材料: PA66-GF30 / POM / SUS304; 投影: 第一角画法; 项目: 40L 随动背负系统背包

1. 壳体材料 PA66+30%GF，前后壳分体注塑，超声波焊接或 4×M3 自攻螺钉连接；

2. 滚轮材料 POM，内嵌 Ø4 不锈钢轴，滚轮外圆 Ra≤0.8，转动无卡滞；

3. 联动带通道内表面拔模 1°，棱边倒圆 R≥1，避免磨损织带；
4. 未注圆角 R2，未注公差按 GB/T 1804-m；

5. 插座孔与 Ø6 背架杆过盈 0.05~0.1，或以 M3 横销固定；

6. 本图为概念设计图，量产前须经打样与负载/疲劳测试修正。
