wentingjie001-cmd/-/cad/out/invention/fig1_rear_iso.pdf

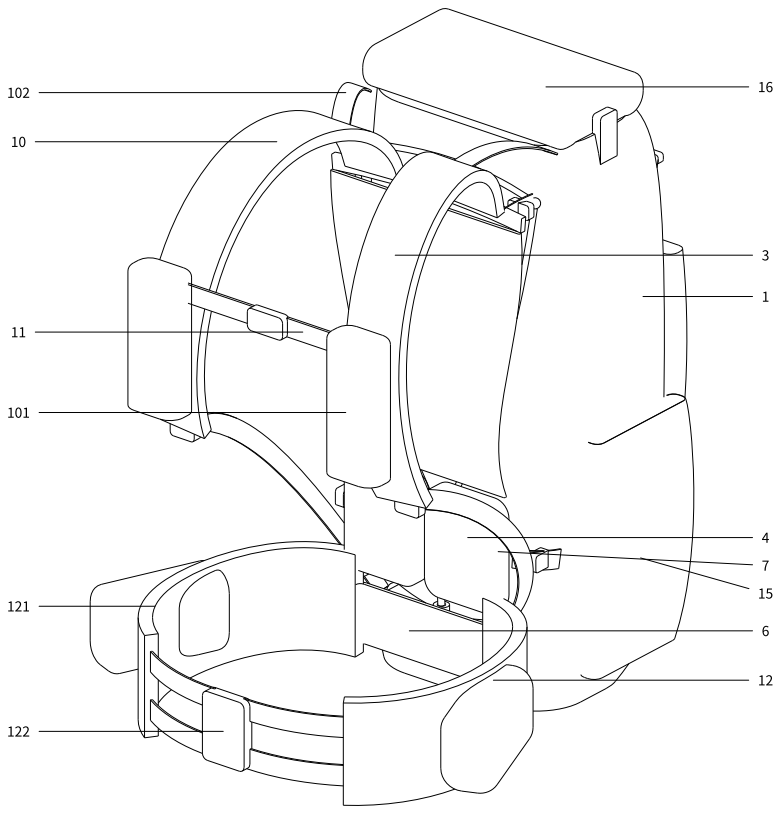
[picture p187: page 1]
