wentingjie001-cmd/-/cad/out/invention/fig2_side.pdf

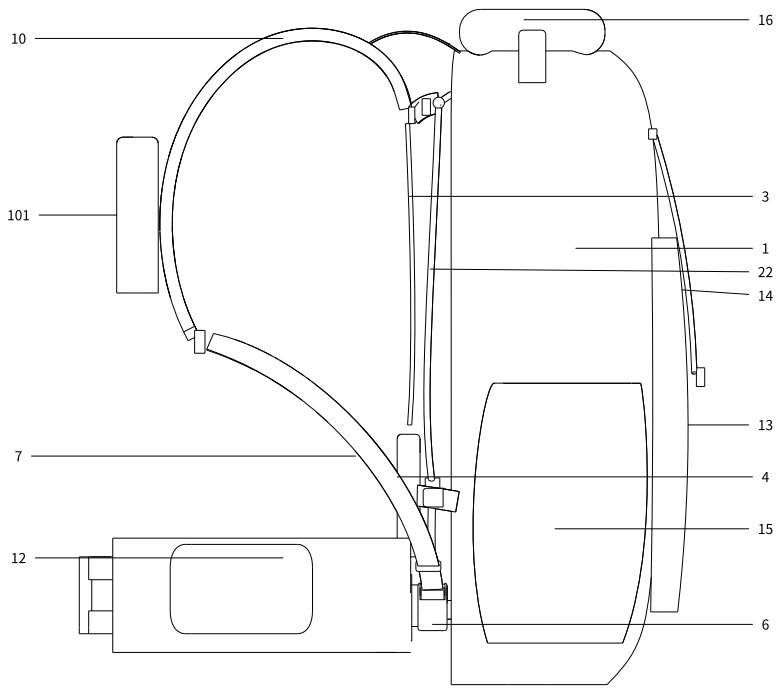
[picture p188: page 1]
