wentingjie001-cmd/-/cad/out/invention/fig3_back_system_pack_side.pdf

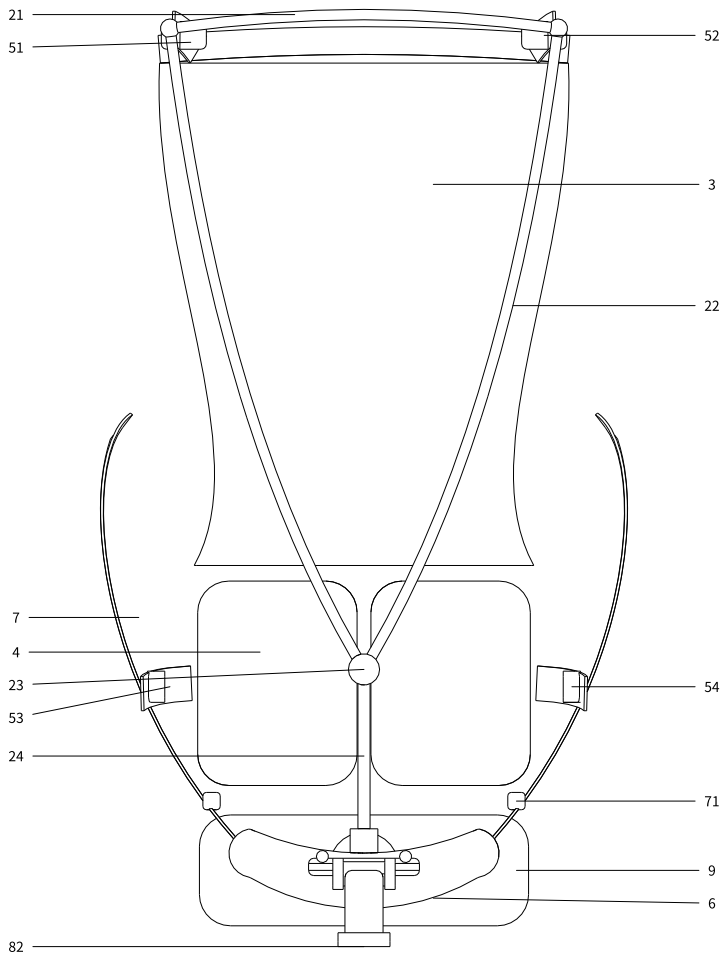
[picture p189: page 1]
