wentingjie001-cmd/-/cad/out/invention/fig4_hub_exploded.pdf

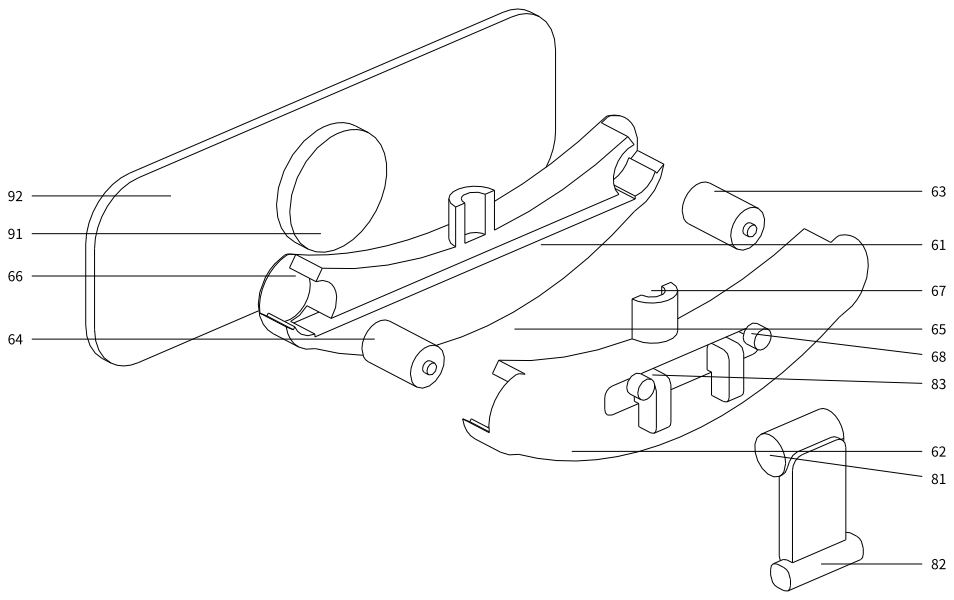
[picture p190: page 1]
