wentingjie001-cmd/-/cad/out/invention/fig5_hub_front_hidden.pdf

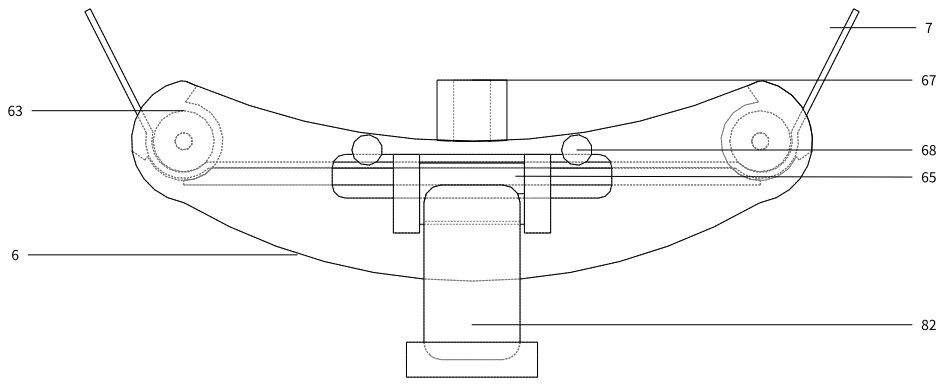
[picture p191: page 1]
