wentingjie001-cmd/-/cad/out/design/01_backpack_whole/bottom.pdf

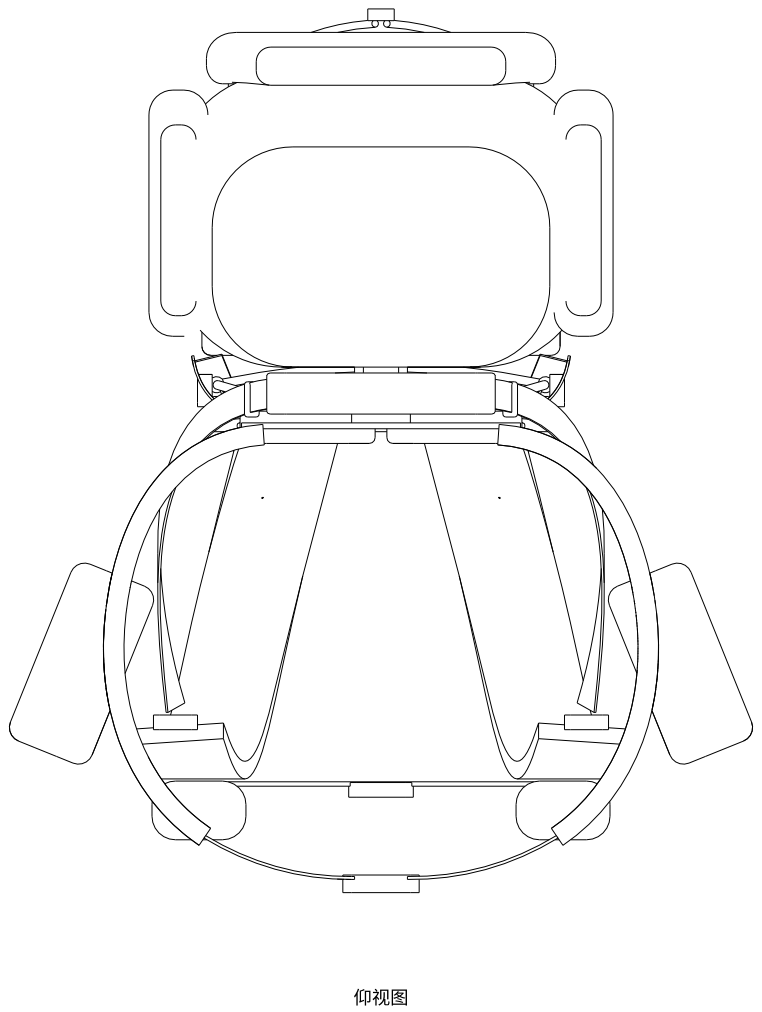
[picture p192: page 1]
仰视图
