wentingjie001-cmd/-/cad/out/design/01_backpack_whole/front.pdf

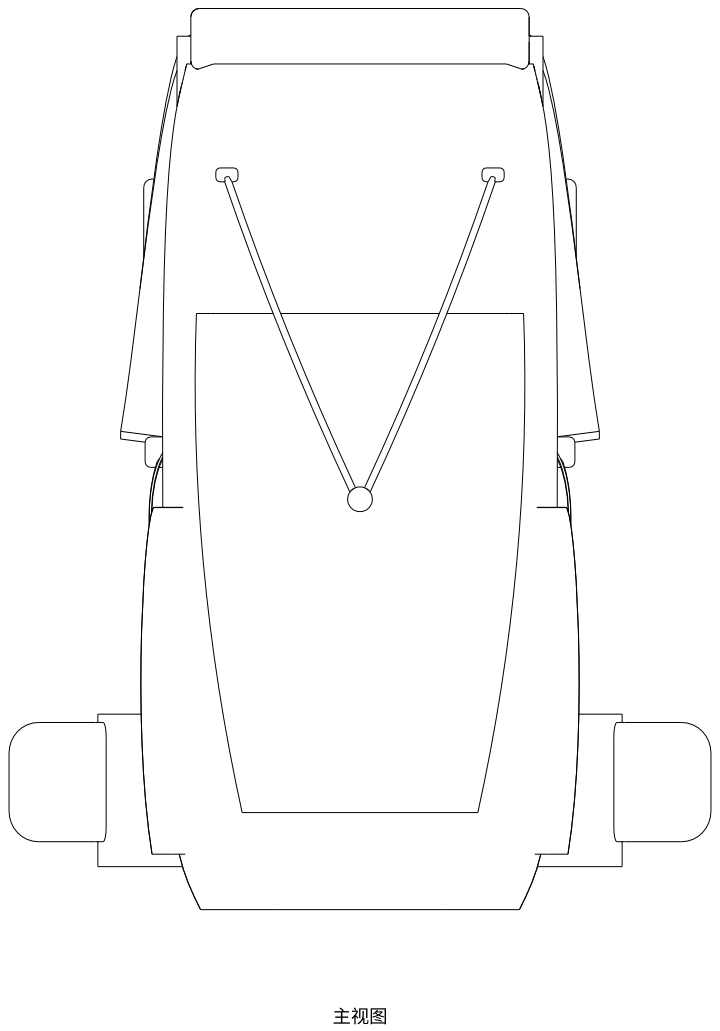
[picture p193: page 1]
主视图
