wentingjie001-cmd/-/cad/out/design/01_backpack_whole/iso_front.pdf

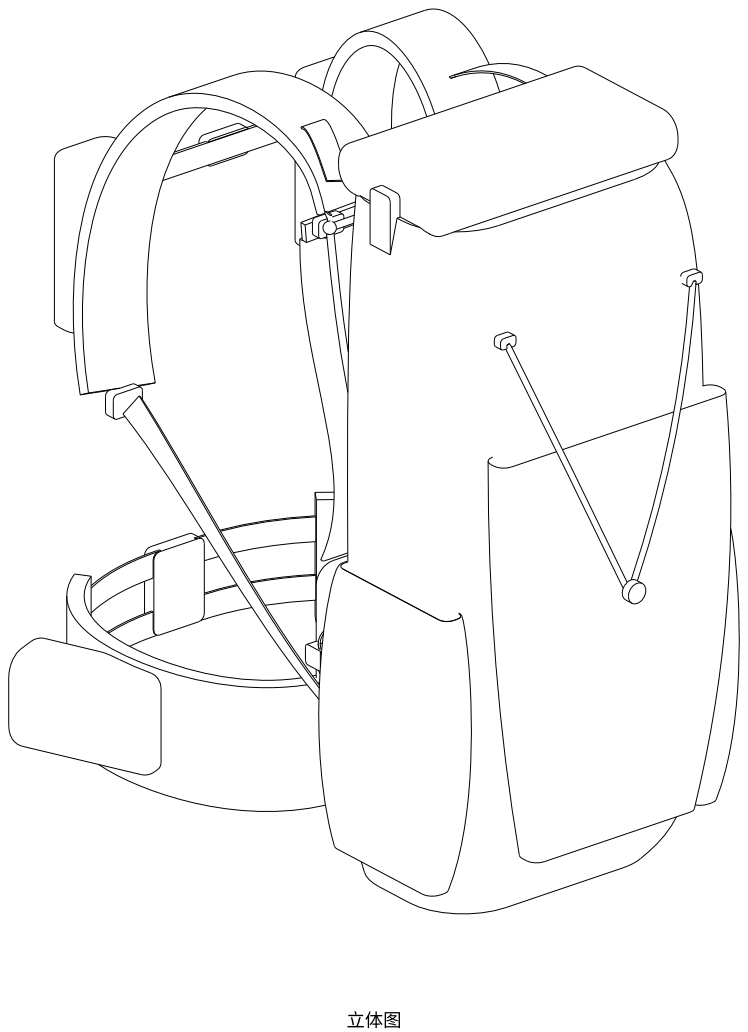
[picture p194: page 1]
立体图
