wentingjie001-cmd/-/cad/out/design/01_backpack_whole/left.pdf

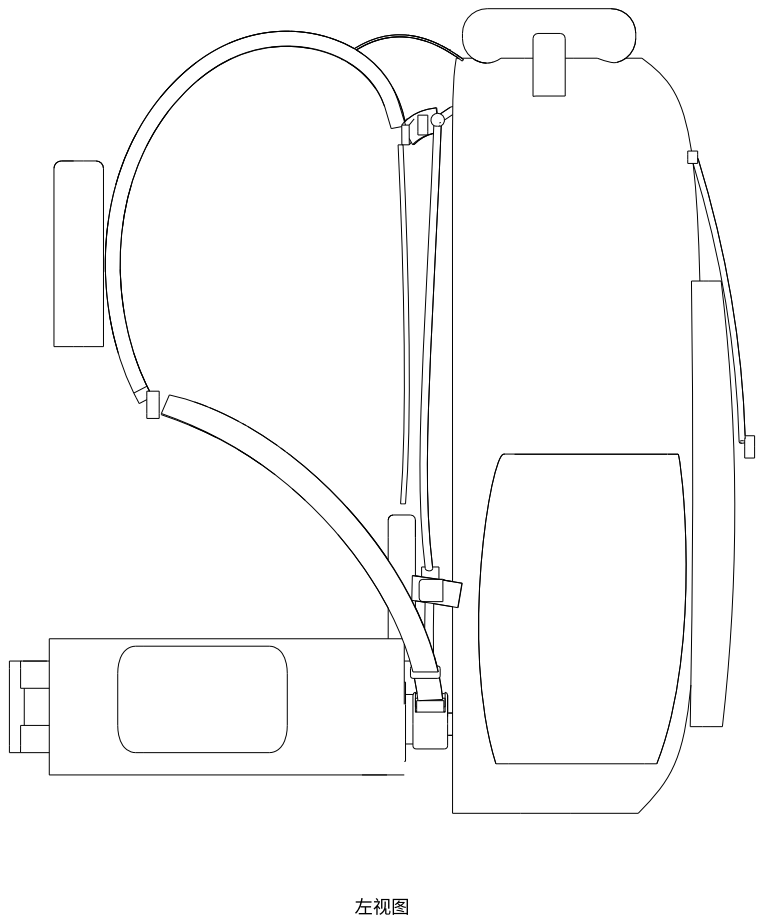
[picture p195: page 1]
左视图
