wentingjie001-cmd/-/cad/out/design/01_backpack_whole/rear.pdf

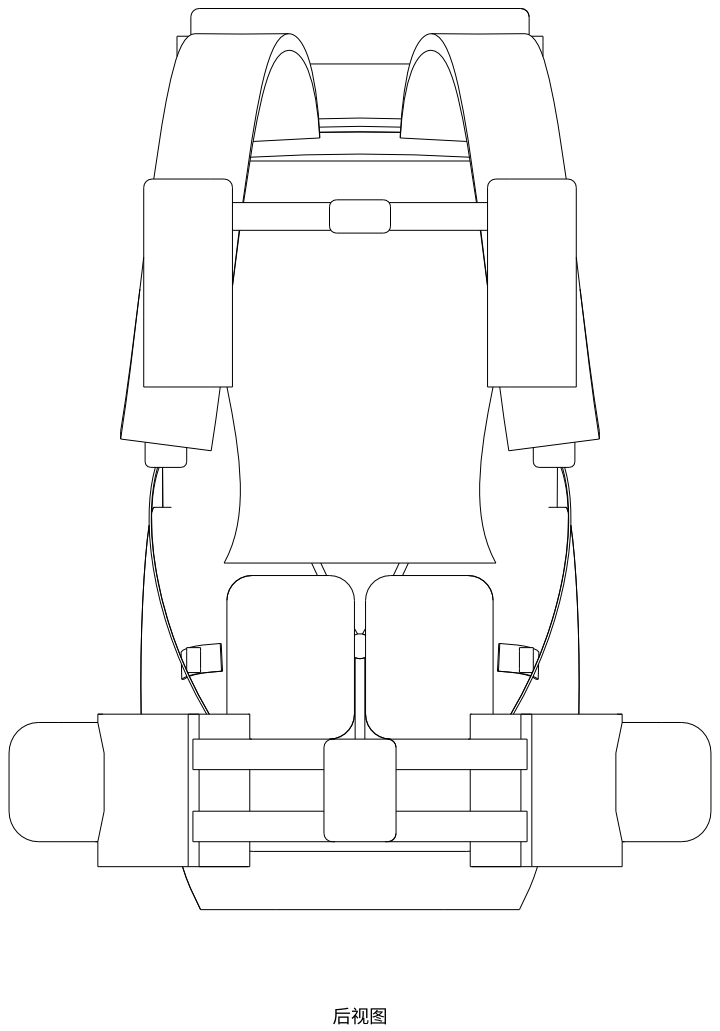
[picture p196: page 1]
后视图
