wentingjie001-cmd/-/cad/out/design/01_backpack_whole/right.pdf

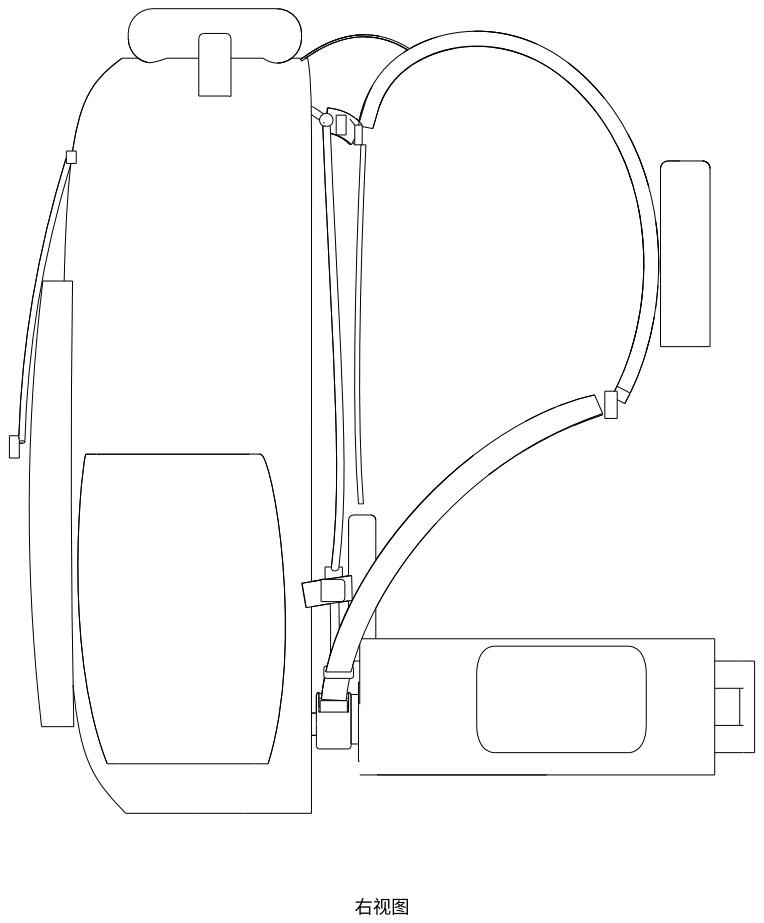
[picture p197: page 1]
右视图
