wentingjie001-cmd/-/cad/out/design/01_backpack_whole/top.pdf

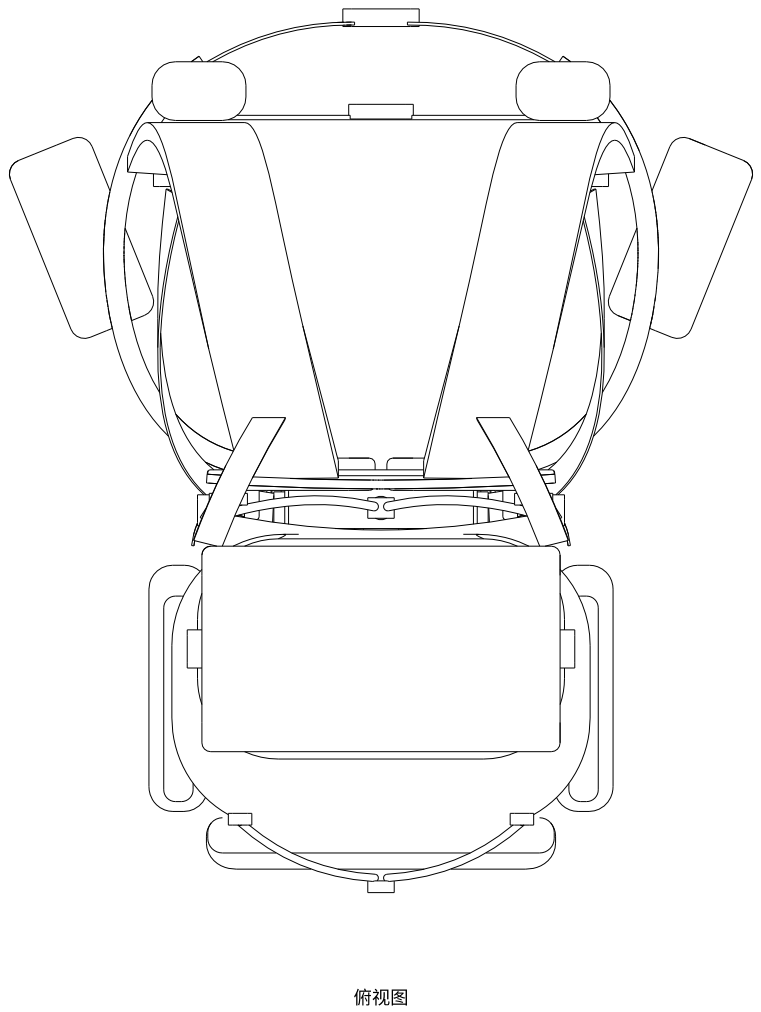
[picture p198: page 1]
俯视图
