wentingjie001-cmd/-/cad/out/design/02_backpack_partial_back_system/bottom.pdf

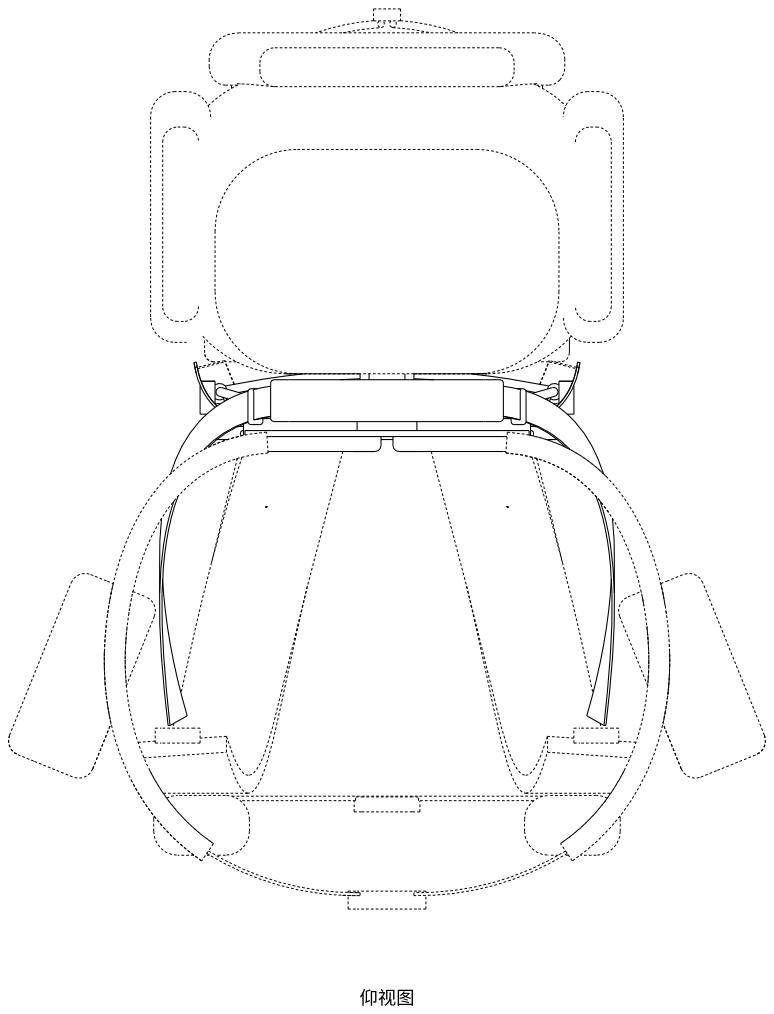
[picture p199: page 1]
仰视图
