wentingjie001-cmd/-/cad/out/design/02_backpack_partial_back_system/front.pdf

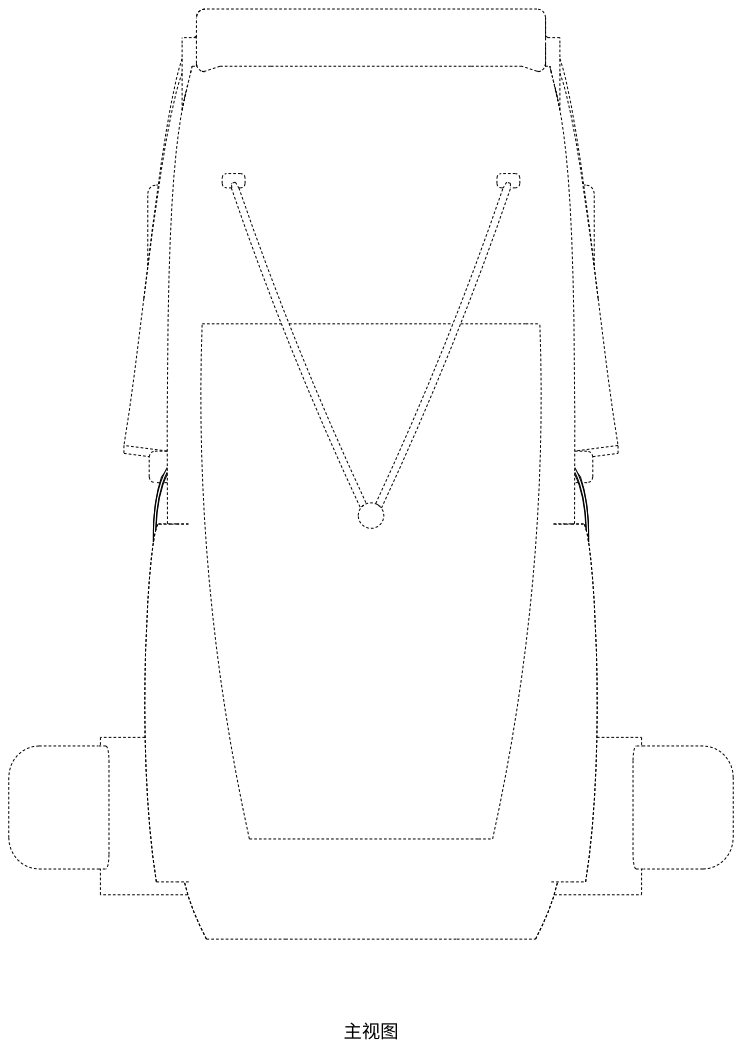
[picture p200: page 1]
主视图
