wentingjie001-cmd/-/cad/out/design/02_backpack_partial_back_system/left.pdf

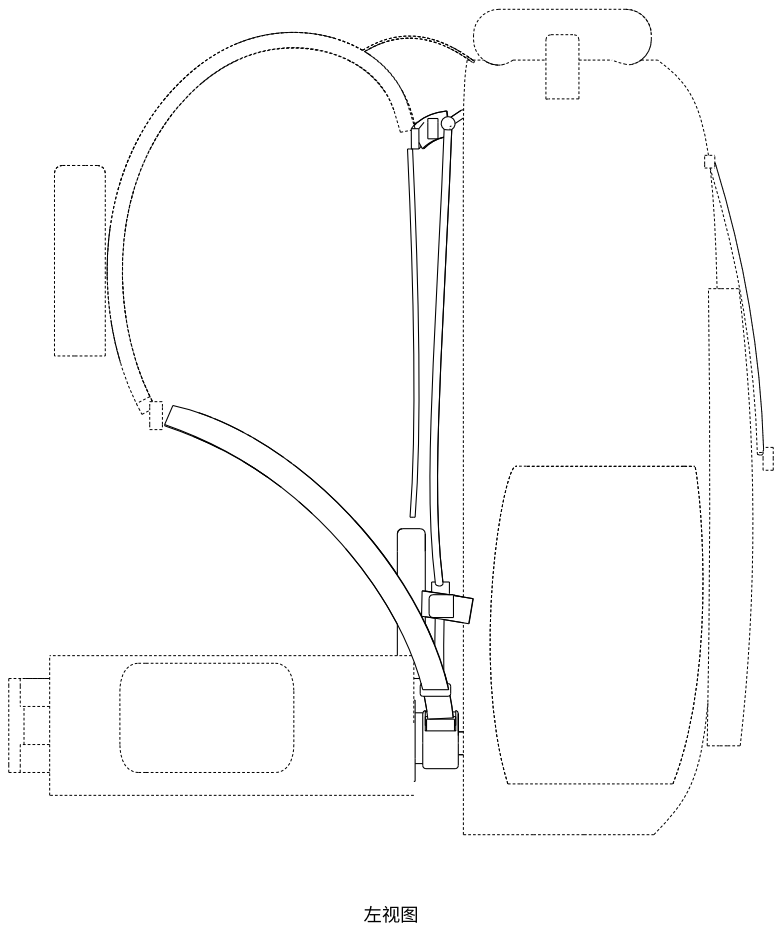
[picture p201: page 1]
左视图
