wentingjie001-cmd/-/cad/out/design/02_backpack_partial_back_system/rear.pdf

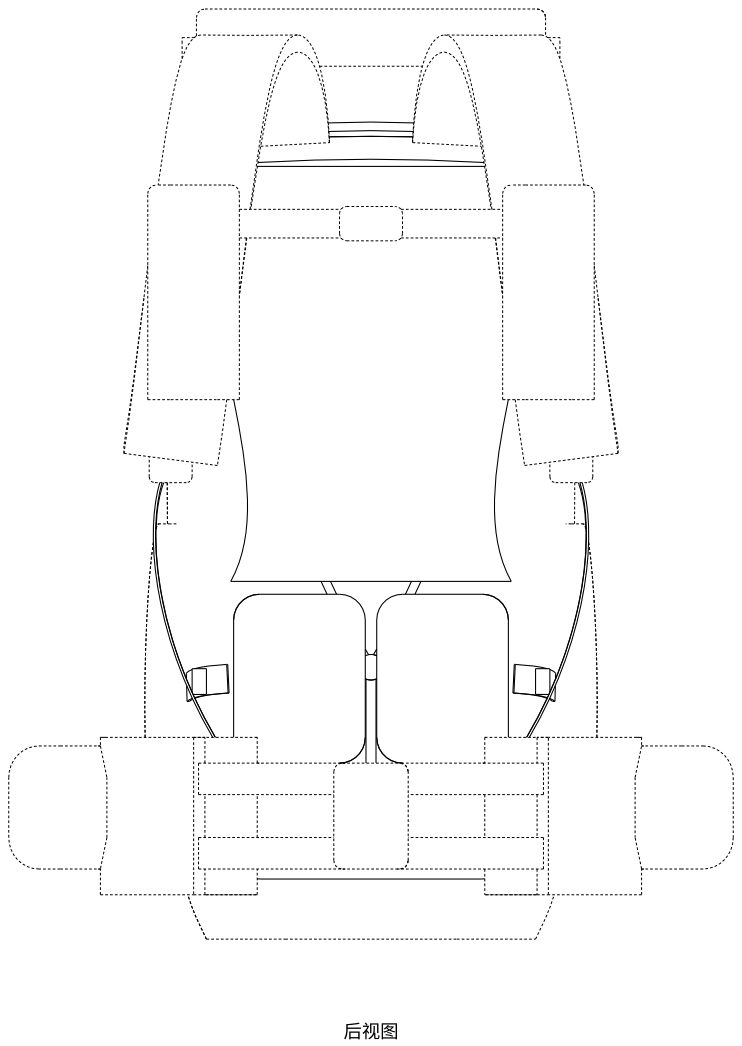
[picture p202: page 1]
后视图
