wentingjie001-cmd/-/cad/out/design/02_backpack_partial_back_system/right.pdf

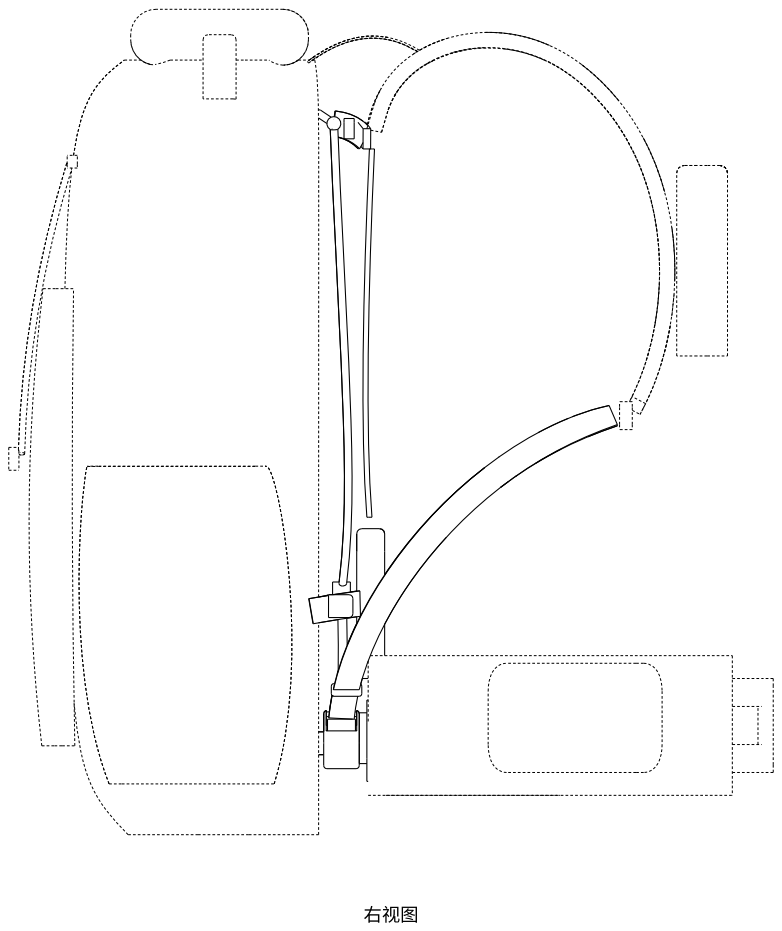
[picture p203: page 1]
右视图
