wentingjie001-cmd/-/cad/out/design/02_backpack_partial_back_system/top.pdf

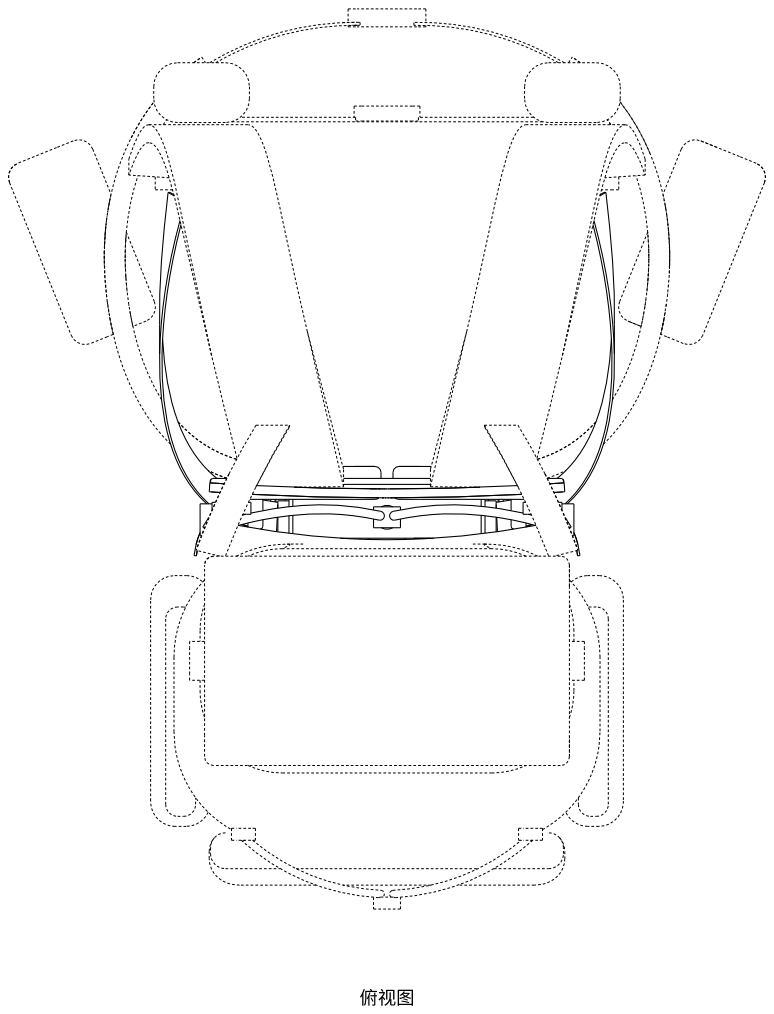
[picture p204: page 1]
俯视图
