wentingjie001-cmd/-/cad/out/design/03_linkage_hub/iso_front.pdf

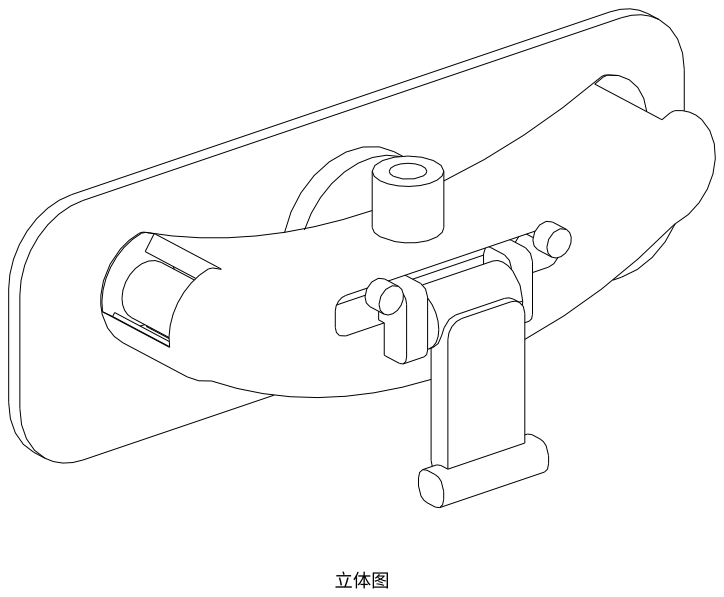
[picture p205: page 1]
立体图
