wentingjie001-cmd/-/(commit log)

2026-11-09 Add parametric CAD model and drawing scripts for linkage-harness backpack
2026-11-09 Add generated STEP/STL, renders, patent figures, design views and A3 drawings
    [BP40-HUB-001_linkage_hub.dxf, backpack_40L_assembly.step, backpack_scale_1to4.stl, cam_lever.step, cam_lever_1to1.stl, hub_front_shell_1to1.stl, hub_housing.step, hub_housing_1to1.stl]
2026-11-09 Add photo-calibrated approximate model of Aarn PM40 for benchmarking
2026-11-09 Add generated benchmark model outputs (STEP, STL, renders, views)
    [aarn_pm40_benchmark_assembly.step, aarn_pm40_scale_1to4.stl, aarn_x_stays.step]
2026-11-09 Regenerate benchmark outputs from the rebuilt model
    [aarn_pm40_benchmark_assembly.step, aarn_pm40_scale_1to4.stl, aarn_x_stays.step]
2026-11-09 Add parametric backpack hardware library (buckles, cord locks, zips, Lasso Loc)
2026-11-09 Add build script for detailed benchmark: STEP, renders, sections, exploded view, BOM
2026-11-09 Add generated outputs for detailed Aarn PM40 benchmark model
    [aarn_pm40_detail_assembly.step, aarn_pm40_hardware_in_place.step, bom_detail.csv, ladder_lock_20mm.step, side_release_buckle_20mm_female.step, side_release_buckle_20mm_male.step, sternum_slider.step]
2026-11-12 Add pattern build script: DXF, 1:1 PDF, markers, cut list and POM tables
2026-11-12 Add generated A1 production pattern package
    [BP40-A1_A01.dxf, BP40-A1_A02.dxf, BP40-A1_A03.dxf, BP40-A1_A04.dxf, BP40-A1_B01.dxf, BP40-A1_B02.dxf, BP40-A1_B03.dxf, BP40-A1_B04.dxf]
2026-11-12 Add brand suspension survey and public CAD/pattern resource report
2026-11-12 Fix pattern conflicts found in 3D assembly: hub patch height, sleeve seam, tension anchors, strap counts
    [BP40-A1_A01.dxf, BP40-A1_A02.dxf, BP40-A1_A03.dxf, BP40-A1_A04.dxf, BP40-A1_B01.dxf, BP40-A1_B02.dxf, BP40-A1_B03.dxf, BP40-A1_B04.dxf]
2026-11-12 Add A1 3D preview assembled from the pattern data
2026-11-12 Document the A1 3D preview and the fixes it led to
2026-11-12 Pose the A1 harness by strap length and export viewer model data
    The shoulder straps, linkage web, load lifters and sternum strap can now be
    rebuilt for a linkage travel and a torso-length setting while keeping the
    strap at its pattern length. build_viewer.py writes the five extreme poses
    to viewer/model.js.
2026-11-12 Add an offline interactive 3D viewer for the A1 pack
    A self-contained page (index.html, a bundled three.js app and the model
    data) that rotates, picks parts, toggles layers, explodes the assembly and
    demonstrates the linkage travel, the five torso-length rungs and the lock.
